Rustik2044/MU-RK3576J-MB/Project/refdoc/Readme.txt

Attention! 
There is an important update this time. Please read RK3576_AIOT_REF_SCH_V11_Modify_Notes_CN carefully.

注意！
本次有重要的更新：请务必详细阅读RK3576_AIOT_REF_SCH_V11_Modify_Notes_CN
