Rustik2044/MU-RK3576J-MB/Project/refdoc/03_Product Line Branch_AIoT/03_Reference Design/02_PCB_Library/RK3576_RK806S-5_Modify_Notes.txt

V11:
The PCB package of RK3576 is modified to BGA698_16R1X17R2X1R08.
The timing of the PLDO2 power supply is changed from 3 to 5.
