Rustik2044/MU-RK3576J-MB/Doc/MU-RK3576J-MB_FULL.pdf

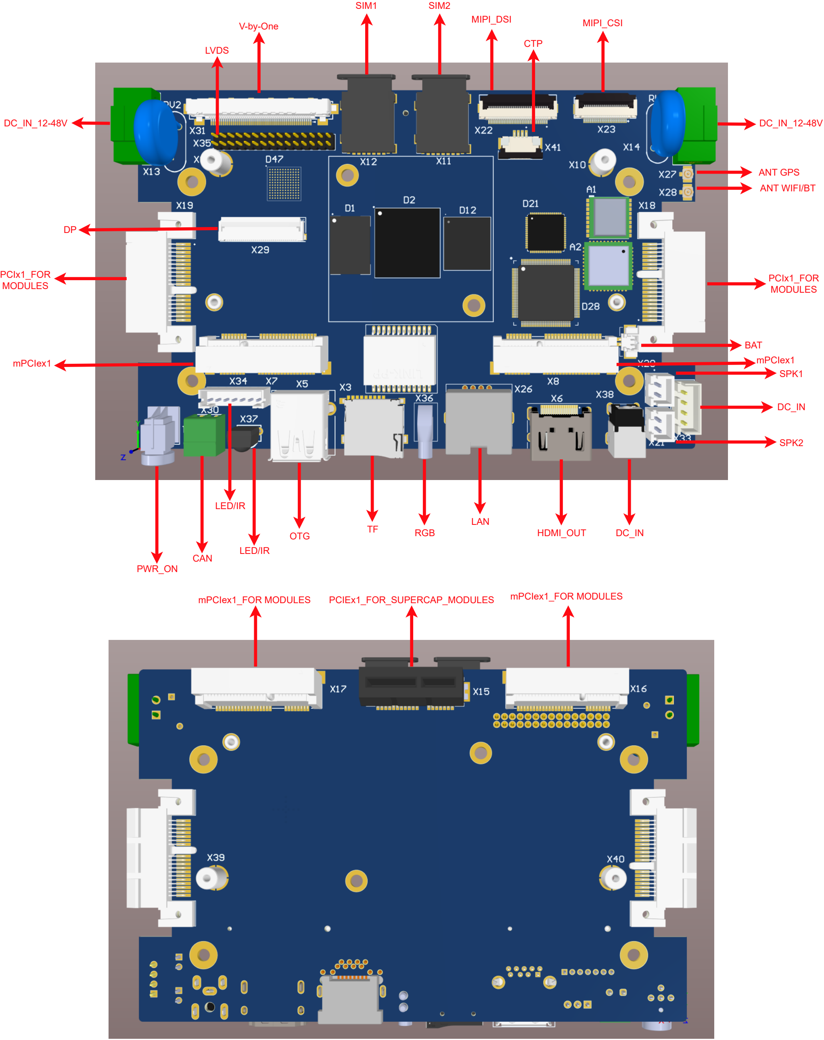
[picture p1: page 1]

V-by-One

LVDS

MIPI_DSI

CTP

ANT WIFI/BT

DC_IN

SPK2

SPK1

HDMI_OUT

LAN
TF
OTG

LED/IR

BAT

SIM1 | SIM2
MIPI_CSI

PCIx1_FOR
MODULES
RGB | DC_IN
LED/IR
CAN
PWR_ON
mPCIex1 | mPCIex1

DP

DC_IN_12-48V | DC_IN_12-48V

ANT GPS

mPCIex1_FOR MODULES | PCIEx1_FOR_SUPERCAP_MODULES | mPCIex1_FOR MODULES

PCIx1_FOR
MODULES
