Rustik2044/MU-RK3576J-MB/Doc/ТЗ на 3576J_08.docx

ТЕХНИЧЕСКОЕ ЗАДАНИЕ 23 сентября 2025

на разработку платы управления ЮРТН.758745.002

# 1. Наименование и область применения

1.1 Наименование изделия

Плата управления ЮРТН.758745.002.

1.2. Область применения

Изделие предназначено для установки в качестве управляющего контроллера для мультимедийных комплексов, применяемых в лифтовой промышленности и цифровых вывесках, в том числе на транспорте.

# 2. Основание для разработки

Основанием для разработки является необходимость создания высокопроизводительной, надежной и промышленно ориентированной системы управления мультимедийным комплексом, соответствующей современным требованиям к лифтовым индикаторам и рекламным медиапроигрывателям. Настоящее ТЗ определяет требования к разработке изделия.

# 3. Назначение разработки

Плата управления должна обеспечивать высокопроизводительное, надежное управление мультимедийным комплексом в условиях лифтового хозяйства, обеспечивая интеграцию с верхнеуровневыми системами передачи данных через промышленные сети, предусмотренные в системах лифтовой индикации.

Изделие должно обеспечивать:

- Управление мультимедийным комплексом.
- Обработку данных с дискретных входов.
- Интеграцию с верхнеуровневыми системами лифтовой индикации через промышленные сети и протоколы.

# 4. Требования к изделию

## 4.1. Требования к функциональным характеристикам

Управление мультимедийным комплексом.

Поддержка промышленных сетевых интерфейсов (CANopen, Modbus).

Поддержка сетевого интерфейса по стандарту Gigabit Ethernet (1000BASE-T).

Управление дискретными входами/выходами (минимум 4 изолированных DI, 4 изолированных DO).

Работа под управлением операционной системы ???.

## 4.2. Требования к надежности

Средняя наработка на отказ должна быть не менее 40 000 часов.

Применяемые электронные компоненты должны быть промышленного температурного диапазона.

Конструкция платы и пайка должны соответствовать требованиям надежности для промышленного оборудования.

## 4.3. Требования к условиям эксплуатации

Климатические условия эксплуатации:

- Исполнение УХЛ4 по ГОСТ 15150-69.
- Температура окружающего воздуха: от -20°С до +60°С (рабочая); от -20°С до +70°С (хранение и транспортирование).
- Относительная влажность воздуха: от 10% до 80% при температуре +25°С (без конденсации влаги).

Условия по механическим воздействиям:

- Вибрационные нагрузки: Группа исполнения L3 по ГОСТ 16962.2-90 (соответствие IEC 60068-2-6).
- Ударные нагрузки: Группа исполнения L3 по ГОСТ 16962.1-89 (соответствие IEC 60068-2-27).

Требования по электромагнитной совместимости (ЭМС):

- По помехоустойчивости: ГОСТ Р 51317.4.Х / ГОСТ Р 51318.14.Х / ГОСТ Р 51318.22 / ГОСТ Р 51318.24.
- По уровню излучаемых помех: ГОСТ Р 51317.3.2 / ГОСТ Р 51317.4.Х / ГОСТ Р 51318.11 / ГОСТ Р 51318.13 / ГОСТ Р 51318.15 / ГОСТ Р 51318.25.
- Устойчивость к электростатическим разрядам (ЭСР): Уровень 4 по ГОСТ Р 51317.4.2.

## 4.4. Требования к безопасности

Конструктивное исполнение должно соответствовать требованиям ГОСТ Р МЭК 60204-1-2007 "Безопасность машин. Электрооборудование машин и механизмов. Часть 1. Общие требования".

Применяемые разъемы и компоненты должны соответствовать требованиям электробезопасности.

## 4.5. Требования к эргономике и технической эстетике

Разъемы на плате должны быть расположены удобно для монтажа и подключения.

Шелкография на плате должна быть четкой и читаемой.

## 4.6. Требования к транспортированию и хранению

Транспортирование должно осуществляться в упаковке, обеспечивающей защиту от механических повреждений, воздействия климатических факторов (температура, влажность) и статического электричества, в соответствии с ГОСТ 23216-78

Условия хранения - температура -20°С до +70°С, влажность до 80% (без конденсации).

## 4.7. Требования к составу изделия

Изделие поставляется в виде некорпусированной печатной платы и комплекта эксплуатационной документации.

## 4.8. Требования к маркировке и упаковке

Каждое изделие должно иметь четкую, стойкую к воздействию среды маркировку, включающую:

- Обозначение изделия
- Заводской номер (серийный номер).
- Знак соответствия (при наличии).
- Знаки электробезопасности (при необходимости).
- Дату изготовления.

Упаковка должна обеспечивать защиту от механических повреждений, влаги, пыли и статического электричества при транспортировании и хранении в соответствии с ГОСТ 23216-78.

## 4.9. Требования к патентной чистоте

Изделие должно быть патентно чистым в Российской Федерации и странах предполагаемого экспорта.

# 5. Требования к аппаратной части

5.1. Требования к плате управления

Управляющий контроллер: SoC RK3576J.

Память:

- Оперативное запоминающее устройство (ОЗУ): Тип LPDDR4 SDRAM. Объем не менее 8 ГБ. Шина 64-бит.
- Постоянное запоминающее устройство для конфигурации и загрузчика: Тип eMMC. Объем не менее 32 ГБ.
- Постоянное запоминающее устройство для ОС и ПО: Тип eMMC. Объем не менее 32 ГБ.
- Слот для карт памяти microSD (для обновления/резервирования).

Интерфейсы, выведенные на внешние разъемы:

- Gigabit Ethernet (интерфейс RGMII) с POE (IEEE 802.3bt) - 1порт.
- USB Type-C версии 3.1 -1 порт.
- USB версии 3.0 -1 порт.
- USB версии 2.0 -1 порт.
- MicroSD интерфейс SDIO.
- Приёмник SIM-карты – 2 разъёма.
- HDMI интерфейс.
- Дискретные входы/выходы (DI/DO): 4 гальванически развязанных дискретных входа (DI) (номинал 24VDC, сухой контакт). 4 гальванически развязанных транзисторных выхода (DO) (номинал 24VDC, ток нагрузки до 0.05А).
- RS-485: 1 порт RS-485.
- RSL: 1 порт OTIS RSL.
- CAN: 1 порт CAN 2.0.
- Звук: Разъём для выхода стерео аудиосигнала, мощность выходного стерео аудиосигнала сигнала 2 х 3 W на нагрузке 4 Ohm при THD 1%.
- ИК – порт, продублированный разъёмом.
- Кнопка включения.

Интерфейсы, выведенные на внутренние разъемы:

- USB версии 2.0 -1 порт.
- 2 разъёма MIPI CSI.
- Последовательный интерфейс UART (TTL уровни) – 1 порт.
- Интерфейс SPI (Master) – 1 порт.
- Интерфейс I2C – 1 порт.
- Интерфейс eDP.
- 2 разъёма Mini PCIe для подключения GSM модема либо SSD.
- Разъём для подключения 4 тактовых кнопок.
- Линии общего назначения GPIO (LVCMOS3V3 уровни) - не менее 8 линий.
- Отладка: Разъем UART для доступа к микроконтроллеру.
- Питание вентилятора системы охлаждения 12 В.

Беспроводные сети:

- Wi-Fi 6 (2.4GHz+5GHz dual-band) с разъёмом U.FL.
- Bluetooth 5.0 с разъёмом U.FL.

Система электропитания:

- Входное напряжение: 24 VDC (номинал), рабочий диапазон 16 VDC - 34 VDC.
- Входное напряжение: 12 VDC (номинал), рабочий диапазон 10 VDC - 16 VDC.
- Выходной разъём POE от сетевого трансформатора.
- Слот либо разъём для подключения батарейки часов реального времени.

Дополнительно:

- Предусмотреть возможность установки ПАК ViPNet SIES Core Nano.

## 5.2. Требования к функциональным узлам платы управления

5.2.1 Требования к часам реального времени

RTC должны быть реализованы на плате управления средствами отдельной микросхемы, которая должна быть снабжена генератором и запитана от батарейного питания.

Батарея RTC должна быть съемная, и ее ресурс должен быть рассчитан для поддержания нормального хода часов без внешнего питания не менее 5 лет. Должна быть обеспечена возможность замены батареи без полной разборки платформы и демонтажа внешних модулей.

5.2.2 Требования к модулю навигации

В состав платы управления должен входить модуль навигации.

Модуль навигации должен поддерживать работу с системой ГЛОНАСС и обмениваться данными по интерфейсу UART с процессором.

Модуль навигации должен выдавать сигнал 1PPS в процессор для синхронизации часов реального времени.

5.2.3 Требования к слотам расширения mPCIe для модулей расширения

На лицевой стороне платы управления должны располагаться два слота mPCIe, обеспечивающие возможность установки модулей расширения (беспроводной связи) GSM/LTE. При применении одного модуля в слоте № 1 должна быть обеспечена возможность мультиплексирования на него SIM1 и SIM2, а при применении двух модулей SIM1 должна подключаться к слоту № 1, а SIM2 – к слоту № 2.

## 5.3. Требования к конструктивному исполнению и монтажу

Применять только промышленные разъемы серии 15EDGRC (Degson Electronics - для питания, DI/DO и промышленных интерфейсов.

От разъёма питания на печатной плате реализовать DC/DC конвертор с 24 В на 12 В с возможностью шунтирования. На выходе конвертора установить вертикальный разъём DS1069-4MVW6X (CWF-4) на 2 контакта которого вывести 12 В на оставшиеся 0(землю).

Для выходного разъёма POE применить DS1069-4MVW6X (CWF-4).

Расположить разъёмы DS1069-4MVW6X (CWF-4) с 12В и POE таким образом, чтобы между ними можно было установить плату с конвертером POE to 12V.

Технология пайки: соответствующая требованиям для промышленной электроники.

Система охлаждения: Активная (радиатор + вентилятор с напряжением питания 12В) либо пассивная (с радиатором).

Маркировка элементов: Четкая шелкография, позиционные обозначения компонентов согласно схеме.

# 6. Требования к программному обеспечению

## 6.1. Операционная система

ROS 2 Humble или Iron (LTS) как основная среда исполнения.

Цикл управления осями должен выполняться с гарантированным периодом менее 1 мс (целевое значение - 250-500 мкс).

## 6.2. Состав программного обеспечения

Драйверы программируемой логики (PL): Реализация EtherCAT Slave Controller (ESC), драйверов интерфейсов энкодеров, ЦАП/АЦП, обработки данных с датчиков в реальном времени.

Драйверы для ROS 2: Драйверы для всех интерфейсов материнской платы (EtherCAT Master - например, `soem`/`ethercat_igh`, CANopen, Modbus, аналоговых/цифровых вводов-выводов).

Подсистема управления движением: Интеграция ROS 2 с промышленными средствами управления движением (например, MoveIt 2 для планирования траекторий, фреймворки ros2_control, hardware_interface, controller_manager для управления приводами). Поддержка протоколов CiA 402 (CANopen) и CoE (EtherCAT).

Подсистема связи: Поддержка DDS (FastDDS/CycloneDDS), механизмов ROS 2 (topics, services, actions). Интеграция с промышленными протоколами (OPC UA сервер/клиент).

Системное ПО: Загрузчик U-Boot, Ядро Linux (с патчем Preempt-RT), Средства построения корневой файловой системы (Buildroot/Yocto). Система инициализации (systemd).

## 6.4. Требования к безопасности ПО

Защита от несанкционированного доступа (аутентификация по ключам SSH, межсетевой экран).

Шифрование обновлений ПО.

Применение средств SROS2 (Security Enhancements for ROS 2) при необходимости.

6.5. Механизм обновления ПО

Предусмотреть механизм безопасного обновления операционной системы, пакетов ROS 2 и конфигурации FPGA по сети Ethernet или с внешних носителей (USB/SD). Обеспечить возможность отката на предыдущую работоспособную версию.

# 7. Требования к информационному обеспечению (документации)

## 7.1. Комплект конструкторской документации (КД) на изделие

Спецификация (ГОСТ 2.106-96).

Сборочный чертеж плат (при необходимости).

Схема электрическая принципиальная (Э3, ГОСТ 2.702-2011), в форматах PDF и исходных файлах САПР, например OrCAD/Altium/KiCad.

Перечень элементов (ПЭ3, ГОСТ 2.701-2008) с указанием производителей, номенклатурных номеров, номиналов.

Спецификация разъемов и назначение контактов.

Описание и инструкция по монтажу и подключению.

Руководство по техническому обслуживанию и поиску неисправностей.

Комплект файлов для производства (Gerber, NC Drill, Pick&Place).

## 7.2. Комплект программной документации

Описание программы и программных модулей.

Руководство системного программиста (установка и настройка ОС, ROS 2, драйверов).

Руководство программиста (API для взаимодействия с платой из ROS 2).

Руководство по настройке промышленных сетей (EtherCAT, CANopen и др.).

Описание кода программируемой логики (HDL код, блок-схемы, timing constraints).

Руководство по обновлению ПО/FPGA.

Техническое описание примеров ROS 2 пакетов для базового управления.

## 7.3. Комплект эксплуатационной документации (ЭД)

Руководство по эксплуатации (РЭ, ГОСТ 2.601-2019).

Паспорт (ПС, ГОСТ 2.601-2019).

## 7.4. Отчеты по испытаниям

Протоколы испытаний цепей питания, интерфейсов, развязки, безопасности (STO).

Протоколы климатических испытаний (температура, влажность).

Протоколы испытаний на вибро- и удароустойчивость.

Протоколы испытаний на ЭМС.

Протоколы тестирования ПО (функциональности, производительности, надежности).

# 8. Технико-экономические требования

Разработка должна обеспечить достижение показателей надежности и функциональности, указанных в настоящем ТЗ.

Стоимость производства изделия должна быть оптимизирована для серийного выпуска при соблюдении всех технических требований.

Применяемые компоненты должны иметь долгосрочную доступность (Long-Term Availability - LTA) или заменяемые аналоги.

# 9. Стадии и этапы разработки

Разработка должна включать следующие стадии и этапы:

- Техническое предложение: Анализ требований, выбор элементной базы, разработка и согласование архитектуры.
- Эскизный проект: Разработка принципиальных электрических схем, тепловые расчеты, выбор корпусов и разъемов, оценка стоимости.
- Технический проект: Разводка печатных плат, разработка конструкторской документации (КД), изготовление опытных образцов (прототипов).
- Рабочая документация: Разработка базового ПО (загрузчик, ОС, драйверы, ROS 2 базис).
- Изготовление, испытание и доводка опытных образцов: Аппаратное тестирование прототипов, отладка, комплексное тестирование аппаратно-программного комплекса.
- Приемочные испытания: Климатические и ЭМС испытания опытных образцов, доработка по результатам испытаний, выпуск предсерийных образцов.
- Подготовка производства: Разработка финальной КД, ПД и ЭД. Подготовка к серийному производству.

# 10. Порядок контроля и приемки

Контроль выполнения работ на всех этапах разработки осуществляет генеральный директор или уполномоченное им лицо.

Приемка разработки осуществляется комиссией, назначаемой Заказчиком, на основании:

- Успешного прохождения всех видов испытаний (аппаратных, программных, климатических, ЭМС) по протоколам, соответствующим требованиям настоящего ТЗ.
- Соответствия разработанной конструкторской, программной и эксплуатационной документации требованиям настоящего ТЗ и стандартам, указанным в нем.
- Демонстрации работоспособности платы управления в составе мультимедийного комплекса (или на стенде с эквивалентной нагрузкой) с выполнением типовых задач через интерфейсы.
- Предоставления полного комплекта оговоренных артефактов (предсерийные образцы плат, исходные коды ПО, документация в электронном и бумажном виде).

Результаты приемки оформляются Актом приемки.

Настоящее Техническое задание является документом, определяющим основные требования к разработке. Детализация требований и возможные уточнения производятся на стадиях технического предложения и эскизного проекта.
