Rustik2044/MU-RK3576J-MB/Doc/ТЗ_Модуля_MU-RK3576J-MB.docx

УТВЕРЖДАЮ

Генеральный директор

ООО «МЮ»

_______________А.А. Ларин

«____»_______________ 20__ г.

ТЕХНИЧЕСКОЕ ЗАДАНИЕ

на разработку модуля процессорного MU-RK3576J-MB

ЮРТН.466256.002

СОГЛАСОВАНО

Директор центра исследований и разработки

ООО «МЮ»

_______________X.X. XX

«____» _______________ 20__ г.

Содержание

## Сокращения

В настоящем техническом задании применены следующие сокращения:

ЕСКД (https://docs.cntd.ru/document/1200000470) | – | единая система конструкторской документации
КД | – | конструкторские документы (документация)
КИМП | – | комплектующие изделия межотраслевого применения
ГЛОНАСС | – | глобальная навигационная спутниковая система
GPS | – | Global Positioning System (система глобального позиционирования).
LTE | – | Long-Term Evolution (стандарт беспроводной высокоскоростной передачи данных для мобильных телефонов и других терминалов, работающих с данными)
ОС | – | операционная система
ПО | – | программное обеспечение
РКД | – | рабочая конструкторская документация
ТД | – | технологическая документация
ТЗ | – | техническое задание
ЭД | – | эксплуатационная документация
ЭРИ | – | электрорадиоизделие
DDR4 | – | double-data-rate four (четвертое поколение оперативной памяти (https://ru.wikipedia.org/wiki/%D0%9E%D0%BF%D0%B5%D1%80%D0%B0%D1%82%D0%B8%D0%B2%D0%BD%D0%B0%D1%8F_%D0%BF%D0%B0%D0%BC%D1%8F%D1%82%D1%8C), отличается повышенными частотными характеристиками и пониженным напряжением питания)
DIO | – | дискретный вход/выход
MIPI-DSI | – | Mobile Industry Processor Interface Display Serial Interface (высокоскоростной интерфейс дисплея)
eMMC | – | Embedded Multimedia Memory Card (встроенная мультимедийная карта памяти)
ECC | – | Error-correcting code memory (память с коррекцией ошибок)
mPCIe | – | формат шины PCI Express для портативных устройств
OD | – | open-drain (открытый сток)
RGB | – | Red-green-blue (аддитивная цветовая модель, описывающая способ кодирования цвета для цветовоспроизведения с помощью трех цветов)
RJ-45 | – | Registered Jack 45 (разъем для Ethernet-кабелей, обеспечивающих передачу данных между компьютерами и другими устройствами в локальных сетях)
RTC | – | Real Time Clock (часы реального времени)
SD | – | Secure Digital (формат карт памяти для портативных устройств)
USB | – | Universal Serial Bus (последовательный интерфейс (https://ru.wikipedia.org/wiki/%D0%98%D0%BD%D1%82%D0%B5%D1%80%D1%84%D0%B5%D0%B9%D1%81) для подключения периферийных устройств к вычислительной технике (https://ru.wikipedia.org/wiki/%D0%AD%D0%92%D0%9C))
WDT | – | сторожевой таймер (watchdog timer) – аппаратный механизм защиты от зависания программы.

# 1 Наименование, основание, исполнитель и сроки выполнения разработки

## 1.1 Наименование: «Модуль процессорный MU-RK3576J-MB ЮРТН.466256.002»

## 1.2 Основание выполнения: приказ № ?? от XX.XX.XXXX г.

## 1.3 Организация-исполнитель: ООО «МЮ».

## 1.4 Сроки выполнения: с XX.XX.XXXX по XX.XX.XXXX г.

# 2 Цель выполнения разработки, наименование и обозначение изделия

2.1 Целью выполнения изделия является разработка конструкторской документации и изготовление макетных и опытных образцов модуля процессорного на базе восьмиядерного ARM процессора RK3576J с расширенным набором сетевых интерфейсов, включая один RS-485, восемь каналов дискретных входов/выходов и CAN в промышленном исполнении.

## 2.2 Наименования изделия: «Модуль процессорный MU-RK3576J-MB ЮРТН.466256.002».

## 2.3 Задачи выполнения

2.3.1 При разработке платформы необходимо выполнить следующие задачи:

- разработка РКД в объеме, достаточном для изготовления макетных образцов;
- изготовление макетных образцов, проведение лабораторных испытаний;
- корректировка РКД по результатам испытаний, разработка комплекта ТД и ЭД в объеме, требуемом для подачи заявки на включение в РЭП ОП по 719 ПП РФ;
- изготовление опытных образцов и проведение предварительных испытаний;
- корректировка КД и ЭД по результатам испытаний (при необходимости) и присвоение литеры О;
- разработка стендов технического контроля по отдельному частному ТЗ;
- изготовление опытной партии по комплекту КД и ЭД Литеры О и проведение приемочных испытаний с присвоением литеры О1;
- передача опытных образцов на сертификационные испытания (ТР ТС 020) и включение в РЭП ОП по 719 ПП РФ;
- участие в постановке на серийное производство.

## 2.4 Назначение и область применения изделия

2.4.1 Модуль процессорный MU-RK3576J-MB (далее – модуль) предназначен для использования в критической информационной инфраструктуре (лифтовой промышленности и т.п) в роли управляющего контроллера мультимедийным комплексом.

# 3 Технические требования к изделию

## 3.1 Состав изделия

3.1.1 В состав модуля должны входить:

- Модуль процессорный MU-RK3576J-MB ЮРТН.466256.002;
- встроенное ПО;
- комплект эксплуатационной документации;

## 3.2 Требования назначения

3.2.1 Модуль должен обеспечивать возможность:

- передачи видеосигнала через интерфейс eDP;

- обмена данными по интерфейсу USB 3.0;

- обмена данными по интерфейсу USB 2.0;

- обмена данными по интерфейсу CAN 2.0;

- обмена данными с помощью сетевого интерфейса 10/100/1000 Base-TX Ethernet (GbE);

- обмена данными с помощью модулей расширения LTE (не входящих в состав платформы);

- учета хронометрических данных при отсутствии внешнего питания с помощью часов реального времени (RTC);

- обмена данными по интерфейсу RS-485;

- ввода и регистрации дискретных сигналов;

- выдачи команд телеуправления.

3.2.2 Модуль должен обеспечивать технические характеристики, приведенные в таблице 1.

Таблица 1 – Технические характеристики модуля

Наименование параметра | Значение параметра
Процессор | RockChip RK3576J 4 х Cortex-A72 2.2 ГГц 4 х Cortex-A53 1.8 ГГц
Микроконтроллер | GD32F330CBT6
BMC (контроллер управления материнской платы) | НИИЭТ К1921ВГ015
Оперативная память | 1 ×LPDDR4 non-ECC – от 4 до 8 ГБ
Встроенный накопитель данных | eMMC Flash – от 32 до 512 ГБ
Слот для внешнего накопителя данных | Для внутренней SD-карты – от 1 до 256 ГБ
Сетевые интерфейсы | 1 × GbE 1000BASE-T PoE+ (RJ-45)
Интерфейсы USB | 1 × USB 3.0 Type-A (OTG)
| 1 × USB 2.0 Type-A (внутренний)
Видеоинтерфейс | HDMI 2.1 (4096 × 2304@60 Гц)
| MIPI-DSI 1x 4 lane или V-by-One HS (1920 × 1080@60Hz) (FFC/FPC -кастомизируемый pinout)
| MIPI-CSI 1x 4 lane
Консольный порт | USB Type-C (virtual COM), опционально GbE (SSH)
Слоты расширения | 1 × mPCIe разъем – USB 2.0, SIM1 или SIM2, PCIе x 1 (Слот 1)
| 1 × mPCIe разъем – USB 2.0, SIM2, PCIе x 1 (Слот 2)
Слоты для SIM-карт | 2
Внутренние интерфейсы | 1 × I2C, 1 × SPI, 1 × UART, 1 × USB 2.0
Модуль навигации | Приемник ГЛОНАСС напаянный на модуль
Подключение антенн | LTE, GNSS, кабельная сборка UFL-F/SMA-F) внешние антенны
Wi-Fi | 2.4G+5G
Интерфейс CAN | 1 × CAN 2.0 (FD)
Кнопка | Аппаратного сброса
RTC Питание: погрешность хода RTC в сутки (при питании часов от внутренней батареи), с, не более | Батарея 3 В CR2032 210 мА·ч ± 1
WDT | с программным управлением
Последовательные интерфейсы («поле») | 1 × RS-485 с индивидуальной гальванической изоляцией (0,6 кВ), скорость передачи данных – до 1 Мбит/с
Дискретные входы/выходы | 8 × DIO (программно-конфигурируемых с групповой гальванической изоляцией (0,6 кВ)) Выходы типа OD, Uвых. до 30 В, Iвых. до 500 мА; Входы типа «сухой контакт», Uвх. (15 – 30) В, Iвх. (5 – 10) мА
Индикация | 2 LED – RS485 (аппаратные); 8 LED – DIO (аппаратные); Status (трехцветный управляемый из ОС)
Электропитание | Тип разъемов питания: клеммный Резервирование: питание от любого из двух разъемов Напряжение питания – от плюс 10 В до плюс 48 В
| Встроенный модуль защиты от перебоев питания (Опционально) Тип: Ионисторный

## 3.3 Требования к часам реального времени

## 3.3.1 RTC должны быть реализованы на модуле средствами отдельной микросхемы, которая должна быть снабжена генератором и запитана от батарейного питания.

#### 3.3.2 Батарея RTC должна быть съемная, и ее ресурс должен быть рассчитан для поддержания нормального хода часов без внешнего питания не менее 5 лет. Должна быть обеспечена возможность замены батареи без полной разборки платформы и демонтажа внешних модулей.

## 3.4 Требования к модулю навигации

#### 3.4.1 В состав модуля должен входить модуль навигации.

#### 3.4.2 Модуль навигации должен поддерживать работу с системой ГЛОНАСС и обмениваться данными по интерфейсу UART с процессором.

#### 3.4.3 Модуль навигации должен выдавать сигнал 1PPS в процессор для синхронизации часов реального времени.

## 3.5 Требования к слотам расширения mPCIe для модулей расширения

3.5.1 На лицевой стороне модуля должны располагаться два слота mPCIe, обеспечивающие возможность установки модулей расширения (беспроводной связи) GSM/LTE. При применении одного модуля в слоте № 1 должна быть обеспечена возможность мультиплексирования на него SIM1 и SIM2, а при применении двух модулей SIM1 должна подключаться к слоту № 1, а SIM2 – к слоту № 2.

## 3.6 Требования к аппаратному обеспечению модуля управления

## 3.6.1 модуль должен содержать:

## - один гальванически изолированный канал интерфейса RS-485 со скоростью приема-передачи данных до 1 Мбит/с;

## 3.6.2 Интерфейс RS-485 должны быть гальванически изолирован от других элементов. Напряжение изоляции должно быть не менее 600 В.

## 3.6.3 Интерфейсы RS-485 должны быть организованы с использованием микросхемы (микросхем) USB-UART.

## - микроконтроллер для обмена данными с процессором и управления блоком дискретных входов/выходов.

## - один сетевой интерфейс Ethernet со скоростью приема-передачи данных до 1 Гбит/с;

## - гальванически изолированный блок дискретных входов/выходов.

## 3.6.4 К микроконтроллеру должна быть подключена одна внешняя энергонезависимая память EEPROM. Связь между микроконтроллером и EEPROM должна осуществляться по интерфейсу I2C.

## 3.7 Требования к программному обеспечению микроконтроллера

3.7.1 Программное обеспечение (ПО) должно обеспечивать запись текущей конфигурации DIO по команде от процессора, а также считывание и применение режима работы каждого DIO согласно сохраненной в памяти конфигурации при перезагрузке устройства. ПО должно позволять сохранять в памяти EEPROM значения уставок для каждого DIO.

3.7.2 Связь с процессором должна осуществляется через последовательный интерфейс I2C, с помощью которого ПО в режиме ведомого должно обеспечивать прием команд, считывание данных от DIO и синхронизацию внутренних часов микроконтроллера. Должна быть предусмотрена линия прерывания от микроконтроллера, через которую ПО сигнализирует процессору о событии превышения значения уставки.

## 3.7.3ПО должно обеспечивать хранение серийного номера и даты изготовления модуля.

## 3.8 Требования к кнопке сброса

## 3.8.1 В случае программного или аппаратного сбоя модуля, если внешний сторожевой таймер (WDT) не сработал, однократное нажатие кнопки сброса должно приводить к перезагрузке системы.

## 3.9 Требования к сторожевому таймеру

## 3.9.1 WDT должен располагаться на модуле в виде отдельной микросхемы.

## 3.9.2 WDT должен иметь возможность программного включения и отключения со стороны процессора.

## 3.9.3 В случае программного сбоя модуля WDT должен инициализировать перезагрузку системы в течение не более трех секунд.

## 3.10 Требования к индикации

## 3.10.1 Вся индикация должна располагаться на лицевой панели.

## 310.2 Модуль должен быть оснащена программно-управляемым светодиодным индикатором типа RGB.

## 3.10.3 Для отображения состояния сетевых интерфейсов светодиодные индикаторы должны быть встроены в разъемы RJ-45.

## 3.10.4 Для отображения состояния интерфейса RS-485 должны быть применены одноцветные светодиодные индикаторы, вынесенные за пределы гальванической изоляции.

## 3.10.5 Для отображения состояния DIO должны быть применены одноцветные светодиодные индикаторы, встроенные в клеммные разъемы.

## 3.11 Требования электромагнитной совместимости

    3.11.1 Модуль не должен создавать недопустимых помех и должна требовать защиты от помех со стороны радиоэлектронных средств, указанных в ТР ТС 020/2011.
    3.11.2 Модуль должен обеспечить устойчивость к разрядам статического электричества по ГОСТ 30804.4.2-2013.
    3.11.3 По помехоустойчивости: ГОСТ Р 51317.4.Х / ГОСТ Р 51318.14.Х / ГОСТ Р 51318.22 / ГОСТ Р 51318.24.
    3.11.4 По уровню излучаемых помех: ГОСТ Р 51317.3.2 / ГОСТ Р 51317.4.Х / ГОСТ Р 51318.11 / ГОСТ Р 51318.13 / ГОСТ Р 51318.15 / ГОСТ Р 51318.25.
    3.11.5 Устойчивость к электростатическим разрядам (ЭСР): Уровень 4 по ГОСТ Р 51317.4.2.

## 3.12 Требования к параметрам электропитания

## 3.12.1 Рабочий диапазон напряжений постоянного тока должен быть от плюс 10 до плюс 30 В.

## 3.12.2 Модуль должен быть обеспечена резервным клеммным входом питания.

## 3.12.3 Модуль должен быть защищен от переполюсовки входного напряжения.

## 3.12.4 Потребляемая модулем мощность должна быть не более 10 Вт без учета внешних потребителей USB.

## 3.13 Требования живучести и стойкости к внешним воздействующим факторам

    3.13.1 Модуль должен сохранять работоспособность при воздействии следующих климатических условий:
- рабочие значения температуры – от минус 20 до плюс 60 °С, при загруженности процессора не более 50 %;
- относительная влажность воздуха от 10 % до 80 % при температуре плюс 25 °С, без конденсации влаги.
- Исполнение УХЛ4 по ГОСТ 15150-69
    3.13.2 Требования к механическим воздействиям:

- Вибрационные нагрузки: Группа исполнения L3 по ГОСТ 16962.2-90 (соответствие IEC 60068-2-6).

- Ударные нагрузки: Группа исполнения L3 по ГОСТ 16962.1-89 (соответствие IEC 60068-2-27).

## 3.14 Требования надежности

    3.14.1 Срок службы модуля должен быть не менее 5 лет.

3.14.2 Среднее время наработки на отказ должно быть не менее 40000 ч.

3.14.3 Конструкция плат и пайка должны соответствовать требованиям надежности для промышленного оборудования.

3.14.4 Применяемые электронные компоненты должны быть промышленного температурного диапазона.

## 3.15 Требования к эксплуатации, хранению, удобству технического обслуживания и ремонта

## 3.15.1 Модуль в упакованном виде должна быть устойчива к хранению в течение двух лет (с момента отгрузки, включая срок транспортирования) в складских неотапливаемых помещениях при воздействии следующих климатических условий:

- предельные значения температуры – от минус 20 до плюс 70 °С;
- относительная влажность воздуха от 10 %до 80 % при температуре плюс 25 °С, без конденсации влаги.

Примечание – Для обеспечения надежной и эффективной работы модуля после хранения или транспортирования при пониженной температуре требуется предварительное выдерживание при положительной температуре до достижения значений, соответствующих условиям эксплуатации.

## 3.16 Транспортирование

## 3.16.1 Модуль должен сохранять работоспособность после транспортирования в упакованном виде автомобильным транспортом (закрытый брезентом), в закрытых железнодорожных вагонах, герметизированных кабинах самолетов и вертолетов, трюмах речного транспорта при воздействии следующих климатических условий:

- температура от минус 20 до плюс 70 °С;
- относительная влажность воздуха от 10% до 80 % при температуре плюс 25 °С.

## 3.17 Требования безопасности

## 3.17.1 Безопасность при эксплуатации модуля должна обеспечиваться ее конструкцией.

## 3.17.2 Модуль должен быть обеспечен клеммой заземления.

## 3.17.3 Величина переходного электрического сопротивления между клеммой защитного заземления и любой металлической нетоковедущей частью устройства, доступной для прикосновения, не должна превышать 0,1 Ом.

## 3.17.4 Комплектующие и материалы, используемые при изготовлении, не должны представлять опасности для жизни, здоровья людей и окружающей среды, как в процессе эксплуатации, так и после окончания срока эксплуатации.

## 3.17.5 Требования к пожаробезопасности не предъявляются.

## 3.17.6 Конструктивное исполнение должно соответствовать требованиям ГОСТ Р МЭК 60204-1-2007 "Безопасность машин. Электрооборудование машин и механизмов. Часть 1. Общие требования".

## 3.17.7 Применяемые разъемы и компоненты должны соответствовать требованиям электробезопасности.

## 3.17 Требования технологичности

## 3.18.1 Требования по технологичности в соответствии с ГОСТ 14.201-83.

## 3.18 Конструктивные требования

    3.19.1 Охлаждение – пассивное (кондуктивное, без вентилятора).

3.19.2 Габаритные размеры модуля (Ш × Г × В) должны быть не более
(?? × ?? × ??) мм.

# 4 Требования к видам обеспечения

## 4.1 Требования к метрологическому обеспечению

## 4.1.1 Модуль не является средством измерения, точность проверяется расчетом и подтверждается внутренними лабораторными испытаниями

## 4.1.2 Все средства измерения должны быть поверены или калиброваны, испытательное оборудование аттестовано в установленном порядке.

## 4.1.3 Методики измерений должны обеспечивать точность и достоверность результатов измерений (испытаний).

## 4.1.4 В методиках измерений используются методики прямых измерений. Все методики измерений, не являющиеся методиками прямых измерений, а также референтные методики измерений должны быть аттестованы.

## 4.2 Требования к программному обеспечению

    4.2.1 Встроенное ПО должно состоять из загрузчика ОС (Uboot, UEFI by Uboot), обеспечивающего возможность последующей установки операционных систем Debian, BaseAlt, Astra Linux, а также встроенное ПО микроконтроллера блока дискретного ввода/вывода.
    4.2.2 Допускается снижение частоты процессора в соответствии с указанными диапазонами температуры ядер процессора:

- до плюс 85 °С, частота 2,0 ГГц;

- от плюс 85 до плюс 90 °С, частота 1,4 ГГц;

- от плюс 90 до плюс 95 °С, частота 0,8 ГГц;

- от плюс 95 до плюс 100 °С, частота 0,4 ГГц.

4.2.3 ROS 2 Humble или Iron (LTS) как основная среда исполнения.

Цикл управления осями должен выполняться с гарантированным периодом менее 1 мс (целевое значение - 250-500 мкс).

## 4.3 Состав программного обеспечения

4.3.1 Драйверы программируемой логики (PL): Реализация EtherCAT Slave Controller (ESC), драйверов интерфейсов энкодеров, ЦАП/АЦП, обработки данных с датчиков в реальном времени.

4.3.2 Драйверы для ROS 2: Драйверы для всех интерфейсов модуля (EtherCAT Master - например, `soem`/`ethercat_igh`, CANopen, Modbus, аналоговых/цифровых вводов-выводов).

4.3.3 Подсистема управления движением: Интеграция ROS 2 с промышленными средствами управления движением (например, MoveIt 2 для планирования траекторий, фреймворки ros2_control, hardware_interface, controller_manager для управления приводами). Поддержка протоколов CiA 402 (CANopen) и CoE (EtherCAT).

4.3.4 Подсистема связи: Поддержка DDS (FastDDS/CycloneDDS), механизмов ROS 2 (topics, services, actions). Интеграция с промышленными протоколами (OPC UA сервер/клиент).

4.3.5 Системное ПО: Загрузчик U-Boot, Ядро Linux (с патчем Preempt-RT), Средства построения корневой файловой системы (Buildroot/Yocto). Система инициализации (systemd).

## 4.4 Требования к безопасности ПО

4.4.1 Защита от несанкционированного доступа (аутентификация по ключам SSH, межсетевой экран).

4.4.2 Шифрование обновлений ПО.

4.4.3 Применение средств SROS2 (Security Enhancements for ROS 2) при необходимости.

## 4.5 Механизм обновления ПО

    4.5.1 Предусмотреть механизм безопасного обновления операционной системы, пакетов ROS 2 и конфигурации FPGA по сети Ethernet или с внешних носителей (USB/SD). Обеспечить возможность отката на предыдущую работоспособную версию.

# 5 Требования к сырью, материалам и КИМП

## 5.1 Покупные ЭРИ и материалы, применяемые при изготовлении платформы, должны соответствовать требованиям стандартов и пройти входной контроль ОТК.

# 6 Требования к консервации, упаковке и маркировке

## 5.2 Требования к консервации

## 6.1.1 Изделие консервации не подлежит.

## 5.3 Требования к упаковке

    5.3.1 Упаковка модуля должна обеспечивать сохранность оборудования при транспортировке всеми видами транспорта и предохранять от внешних воздействующих факторов при их транспортировании и хранении. Упаковка должна соответствовать требованиям ГОСТ 23216-78.

## 5.4 Требования к маркировке

## 6.3.1 Модуль должен иметь маркировку согласно требованиям ГОСТ 26828-86.

6.3.2 Маркировка должна быть устойчивой в течение срока службы и хранения платформы, механически прочной, не должна стираться, осыпаться, расплавляться и выцветать.

6.3.3 Маркировка упаковки должна содержать наименование и (или) товарный знак организации-изготовителя, наименование и обозначение платформы.

    6.3.4 Маркировка на упаковке должна соответствовать ГОСТ 14192-96.

6.3.5 Каждое изделие должно иметь четкую, стойкую к воздействию среды маркировку, включающую:

- Обозначение изделия;

- Заводской номер (серийный номер);

- Знак соответствия (при наличии);

- Знаки электробезопасности (при необходимости);

- Дату изготовления.

# 7 Требования к документации

## 7.1 Конструкторская, эксплуатационная, программная и технологическая документация, разрабатываемая на платформу, должна соответствовать стандартам системы ЕСКД, ЕСПД, ЕСТД.

## 7.2 Комплект программной документации должен включать в себя:

## - Описание программы и программных модулей;

## - Руководство системного программиста (установка и настройка ОС, ROS 2, драйверов);

## - Руководство программиста (API для взаимодействия с платой из ROS 2);

## - Руководство по настройке промышленных сетей (EtherCAT, CANopen и др.);

## - Описание кода программируемой логики (HDL код, блок-схемы, timing constraints);

## - Руководство по обновлению ПО/FPGA;

## - Техническое описание примеров ROS 2 пакетов для базового управления.

## 7.3 Отчеты по испытаниям:

## - Протоколы испытаний цепей питания, интерфейсов, развязки, безопасности (STO);

## - Протоколы климатических испытаний (температура, влажность);

## - Протоколы испытаний на вибро- и удароустойчивость;

## - Протоколы испытаний на ЭМС;

## - Протоколы тестирования ПО (функциональности, производительности, надежности).

# 8 Технико-экономические требования

## 8.1 Разработка должна обеспечить достижение показателей надежности и функциональности, указанных в настоящем ТЗ.

8.2 Стоимость производства изделия должна быть оптимизирована для серийного выпуска при соблюдении всех технических требований.

8.3 Применяемые компоненты должны иметь долгосрочную доступность (Long-Term Availability - LTA) или заменяемые аналоги.

# 9 Этапы выполнения изделия

## 9.1 Этап 1:

## Техническое предложение:

## - Анализ требований;

## - выбор элементной базы;

## - разработка и согласование архитектуры.

## 9.2 Этап 2:

## разработка РКД в объеме, необходимом для изготовления макетных образцов;

## изготовление макетных образцов и проведение лабораторных испытаний.

## 9.3 Этап 3:

## корректировка РКД и разработка ЭД, ТД;

## - изготовление опытных образцов;

## проведение предварительных испытаний,

## корректировка КД и ЭД по результатам испытаний (при необходимости) с присвоением литеры О.

## 9.4 Этап 4:

- разработка стендов технического контроля по отдельному частному ТЗ;
- изготовление опытной партии по комплекту КД и ЭД Литеры О;

## проведение приемочных испытаний с присвоением литеры О1.

## 9.5 Этап 5:

## сертификационные испытания;

## постановка на серийное производство продукции.

# 10 Порядок выполнения и приемки этапов разработки

## 10.1 Требования настоящего ТЗ могут изменяться (дополняться).

## 10.2 Контроль выполнения работ на всех этапах разработки осуществляет Заказчик или уполномоченное им лицо.

## 10.3 Этапы принимаются комиссией, назначенной руководителем организацией-изготовителем на основании:

## - Успешного прохождения всех видов испытаний (аппаратных, программных, климатических, ЭМС) по протоколам, соответствующим требованиям настоящего ТЗ;

## - Соответствия разработанной конструкторской, программной и эксплуатационной документации требованиям настоящего ТЗ и стандартам, указанным в нем;

## - Демонстрации работоспособности платы управления в составе мультимедийного комплекса (или на стенде с эквивалентной нагрузкой) с выполнением типовых задач через интерфейсы;

- Предоставления полного комплекта оговоренных артефактов (предсерийные образцы плат, исходные коды ПО, документация в электронном и бумажном виде).

10.4 Результаты приемки оформляются Актом приемки.

## 10.5 Настоящее Техническое задание является документом, определяющим основные требования к разработке. Детализация требований и возможные уточнения производятся на стадиях технического предложения и эскизного проекта.

Руководитель конструкторского отдела

_______________ X.X. XXX

Ответственный разработчик

_______________X.X. XXX

Руководитель отдела разработки программного обеспечения

_____________ X.X. XXX
