Rustik2044/MU-RK3576J-MB/For_production_MU-3576-MB/MU-RK3576J-MB_FULL/BOM_MU-RK3576J-MB_FULL.xlsx

Designator | Part Number | Quantity | NameFromManufacturer | Manufacturer
A1 | TAU1113 | 1 | TAU1113 | Allystar
A2 | 8223A-SR | 1 | 8223A-SR | FN-LINK
BQ1 | TC32S4-24.000-0618NQDTN | 1 | TC32S4-24.000-0618NQDTN | HCI
BQ4 | TAXM12M4RDBCCT2T | 1 | TAXM12M4RDBCCT2T | TAE
BQ5 | X322516MLB4SI | 1 | X322516MLB4SI | YXC
BQ6 | NX2012SA-32.768K-STD-MUB-1 | 1 | NX2012SA-32.768K-STD-MUB-1 | NDK
BQ7 | TAXM25M4RDBCCT2T | 1 | TAXM25M4RDBCCT2T | Yajingxin
BQ8 | X32258MOB4SI | 1 | X32258MOB4SI | YXC Crystal Oscillators
BQ9 | 3225-24-18-10-10/4B | 1 | 3225-24-18-10-10/4B | Liming
C1, C2, C4, C16, C18, C19, C20, C21, C22, C25, C26, C27, C28, C29, C35, C36, C37, C38, C39, C40, C41, C42, C43, C45, C54, C113, C123, C124, C125, C132, C136, C137, C141, C144, C148, C149, C153, C154, C155, C158, C260, C261, C262, C263, C264, C318, C320, C322, C323, C405, C410, C543, C545, C546, C547, C548, C550, C553, C555, C556, C557, C558, C559, C564, C567, C568, C569, C578, C579, C586 | 0201-X5R-6.3V-0.1uF±10% | 70 | CC0201KRX5R5BB104 | Yageo
C3, C6, C7, C9, C10, C13, C17, C205, C206, C284, C285, C286, C287, C289, C290, C291, C293, C294, C295 | 1206-X5R-50V-010uF±10% | 19 | CC1206KKX5R9BB106 | Yageo
C5, C14, C15, C33, C34, C46, C47, C49, C50, C51, C52, C55, C59, C65, C72, C82, C83, C89, C99, C100, C104, C117, C121, C127, C128, C129, C133, C134, C138, C139, C142, C145, C146, C150, C151, C254, C255, C256, C257, C258, C259, C324, C325, C326, C327, C336, C338, C400, C401, C402, C403, C404, C406, C407, C411, C542, C544, C549, C551, C552, C554, C563, C566, C570, C580, C641 | 0201-X5R-6.3V-1uF±20% | 66 | GRM033R60J105MEA2D | Murata Electronics
C8, C428, C429, C430, C431, C432, C433, C434, C438 | 0402-X7R-16V-0.1uF±10% | 9 | CC0402JRX7R7BB104 | Yageo
C11, C12, C30, C31, C48, C130, C131, C135, C140, C143, C147, C225, C228, C230, C269, C271, C329, C339, C447 | 0402-X5R-6.3V-10uF±20% | 19 | CC0402MRX5R5BB106 | Yageo
C23, C159, C160, C168, C175, C183, C191, C201, C211, C363, C364, C365, C367, C375, C393, C478, C482, C484, C488, C490, C494, C496, C500, C504, C506, C509, C514, C516, C518, C520 | 0402-X5R-50V-0.1uF±10% | 30 | CC0402KRX5R9BB104 | Yageo
C24, C32, C308, C309, C310, C311, C312, C313, C314, C315, C319, C321, C527, C528, C529, C530, C531, C532, C533, C534, C573, C574 | 0201-X5R-25V-0.1uF±10% | 22 | CC0201KRX5R8BB104 | Yageo
C57, C58, C62, C63, C66, C67, C68, C71, C76, C77, C79, C80, C81, C88, C92, C93, C96, C97, C102, C106, C107, C108, C109, C112, C114, C115, C116, C119, C120, C161, C162, C163, C170, C185, C186, C233, C417, C419, C424, C425, C426, C427 | 0603-X5R-10V-22uF±20% | 42 | CL10A226MQ8NRNE, GRM188R61A226ME15D | Samsung Electro-Mechanics, Murata
C60, C61, C69, C73, C74, C84, C85, C86, C90, C95, C224 | 0402-X5R-10V-2.2uF±10% | 11 | CC0402KRX5R6BB225 | Yageo
C70, C87, C101, C111, C477, C480, C481, C483, C486, C487, C489, C492, C493, C495, C498, C499, C501, C502, C503, C505, C508, C511, C512, C513, C515, C517, C519 | 0603-X5R-10V-10uF±10% | 27 | CC0603KRX5R6BB106 | Yageo
C78, C94 | 0402-NP0-50V-100pF±1% | 2 | CC0402FRNPO9BN101 | Yageo
C103, C316, C317, C328, C337 | 0201-X5R-6.3V-4.7uF±20% | 5 | GRM035R60J475ME15D | Murata Electronics
C122 | 0201-C0G-25V-1nF±5% | 1 | GRM0335C1E102JA01D | muRata
C164, C165, C166, C167, C171, C172, C173, C174, C187, C188, C189, C207, C208, C210 | 0805-X7R-50V-2.2uF±10% | 14 | CC0805KKX7R9BB225 | Yageo
C169, C176, C192, C212 | 0402-NP0-50V-220pF±5% | 4 | CC0402JRNPO9BN221 | Yageo
C177, C178, C197, C213 | 0402-X7R-50V-0.022uF±10% | 4 | GRM155R71H223KA12D | Murata Electronics
C179, C181, C198, C214 | 0402-X7R-50V-4700pF±10% | 4 | CC0402KRX7R9BB472 | Yageo
C180, C182, C199, C215 | 0402-NP0-50V-22pF ±10% | 4 | CL05C220JB51PNC | Samsung
C184, C196, C200, C202, C232, C234, C235, C240, C413, C415, C418, C435, C439, C522, C523, C525, C582, C583, C584, C585, C593 | 0402-X5R-10V-0.1uF±10% | 21 | CC0402KRX5R6BB104 | Yageo
C195, C521 | 0402-X5R-10V-10uF±20 | 2 | CL05A106MP5NUNC | Samsung
C216, C217, C218, C219, C221, C222, C226, C227, C229, C267, C268, C270, C278, C280, C330, C331, C332, C333, C334, C335, C340, C341, C342, C343, C344, C345, C442, C444, C446, C448, C450, C451, C452, C453, C454, C535, C540, C541, C560, C561, C562, C581, C589, C638 | 0402-X7R-50V-0.1uF±10% | 44 | CC0402KRX7R9BB104 | Yageo
C220, C223, C443, C449 | 0402-X5R-6.3V-4.7uF±20% | 4 | CC0402MRX5R5BB475 | Yageo
C231, C383, C445 | 0402-X5R-10V-1uF±10% | 3 | CL05A105KP5NNNC | Samsung
C236, C252, C282, C283, C416, C459, C467, C468, C475, C476 | 1812-C0G-2kV-1nF±10% | 10 | 1812B102K202NT | FH
C237, C238, C420, C421 | 0402-NP0-50V-10pF±5% | 4 | CC0402JRNPO9BN100 | Yageo
C239 | 0603-X5R-50V-1uF±10% | 1 | CC0603KRX5R9BB105 | Yageo
C241, C412, C414, C524, C526 | 0402-X5R-10V-10uF±20% | 5 | GRM155R61A106ME44 | Murata Electronics
C242, C243, C244, C245, C246, C247, C248, C249 | 0201-X5R-10V-220nF±10% | 8 | CC0201KRX5R6BB224 | Yageo
C250, C251, C253 | 0402-X5R-50V-1uF±10% | 3 | CC0402KRX5R9BB105 | Yageo
C265, C266, C575, C576, C577 | 0201-C0G-25V-1000pF±10% | 5 | CC0201KRX7R9BB102 | Yageo
C272, C273, C274, C275, C276, C277, C279, C281 | 0402-NP0-50V-33pF±5% | 8 | CC0402FRNPO9BN330 | Yageo
C288, C292 | 1206-X7R-100V-1uF±10% | 2 | TCC1206X7R105K101HT | CCTC
C296, C297 | 1210-X7R-250V-0.1uF±10% | 2 | CC1210KKX7RYBB104 | Yageo
C348, C349 | 0402-X7R-50V-1000pF±5% | 2 | CC0402JRX7R9BB102 | Yageo
C350, C353, C381, C382, C386, C387 | 0402-X5R-16V-2.2uF±10% | 6 | CC0402KRX5R7BB225 | Yageo
C361, C362, C366 | 0603-X5R-10V-10uF±20% | 3 | CL10A106MP8NNNC | Samsung Electro-Mechanics
C370, C379, C389, C399 | 0603-X7R-25V-0.68uF±10% | 4 | CC0603KRX7R8BB684 | Yageo
C371, C372, C373, C377, C378, C390, C391, C395, C397, C398 | 0603-NP0-50V-330pF±5% | 10 | CC0603JRNPO9BN331 | Yageo
C374, C392 | 0402-X7R-50V-0.01uF±10% | 2 | CC0402KRX7R9BB103 | Yageo
C380, C384, C385, C388 | 0603-X5R-50V-0.22uF±10% | 4 | CL10A224KB8NNNC | Samsung
C396 | 0402-NP0-50V-047pF±5% | 1 | CC0402JRNPO9BN470 | Yageo
C422, C423, C440, C441, C537, C538, C571, C572 | 0402-NP0-50V-12pF±5% | 8 | GRM1555C1H120JA01D | Murata Electronics
C436, C437 | 0402-X7R-6.3V-1uF±10% | 2 | CC0402KRX7R5BB105 | Yageo
C455, C591 | 0603-X7R-50V-0.1uF±10% | 2 | CC0603KRX7R9BB104 | Yageo
C456, C458 | 1206-NP0-630V-1000pF±5% | 2 | AC1206JKNPOZBN102 | Yageo
C457, C463 | 1206-X7R-100V-0.1uF±10% | 2 | C1206C104K1RAC7800 | KEMET
C460, C469 | 1206-X7R-2K-4700pF±10% | 2 | 1206B472K202NT | FH
C461, C462, C592 | 1206-X7R-2K-1000pF±10% | 3 | CC1206KKX7RDBB102 | Yageo
C464, C465, C466 | 1210-X7S-100V-10uF±10% | 3 | CL32Y106KCVZNWE | Samsung Electro-Mechanics
C470 | 0805-X7R-100V-470pF±10% | 1 | CC0805JRNPO0BN471 | Yageo
C471, C472, C473, C474 | 0603-X7R-50V-0.01uF±10% | 4 | CC0603KRX7R9BB103 | Yageo
C479, C485, C491, C497, C510 | 0402-NP0-50V-100pF±5% | 5 | CC0402JRNPO9BN101 | Yageo
C507, C587 | 0402-NP0-50V-1000pF±5% | 2 | CC0402JRNPO9BN102 | Yageo
C536, C539, C588 | 0805-X5R-25V-10uF±10% | 3 | CL21A106KAYNNNE | Samsung
C590 | 0805-X5R-35V-10uF±10% | 1 | C2012X5R1V106K085AC | TDK Corporation
D1 | RS1G32LO4D2BDS-46IT | 1 | RS1G32LO4D2BDS-46IT | Rayson
D2 | RK3576J | 1 | RK3576J | Rockship
D3 | RK806S-5 | 1 | RK806S-5 | Rockchip
D4, D5, D7, D11 | SCT2651DRBR | 4 | SCT2651DRBR | SCT
D6 | TPS3851G33SDRBR | 1 | TPS3851G33SDRBR | Texas Instruments
D9 | 1XZA032768AD19 | 1 | 1XZA032768AD19 | KDS
D10 | BM8563ESA | 1 | BM8563ESA | GATEMODE
D12 | SC-MHF064GMLES-821-N0 | 1 | SC-MHF064GMLES-821-N0 | Samsung
D13 | W25Q256JVEIQ | 1 | W25Q256JVEIQ | Winbond
D14 | ZD24C08A-STGMT | 1 | ZD24C08A-STGMT | Zetta
D15, D17 | SY6280AAC | 2 | SY6280AAC | Silergy Corp
D16 | CH334R | 1 | CH334R | WCH
D18 | RS2299XTQC16 | 1 | RS2299XTQC16 | RUNIC Tech
D19, D20 | LM5050MKX-1/NOPB | 2 | LM5050MKX-1/NOPB | TI
D21 | ASM1184e | 1 | ASM1184e | ASMedia
D23 | PCM5122 | 1 | PCM5122 | Texas Instruments
D25 | TPA3130D2 | 1 | TPA3130D2 | Texas Instruments
D26 | CH340E | 1 | CH340E | WCH
D27 | LD1117-ADJ | 1 | LD1117-ADJ | UMW
D28 | К1921ВГ015 | 1 | К1921ВГ015 | НИИЭТ
D29, D31 | PI3A27518ZDEX | 2 | PI3A27518ZDEX | Diodes Incorporated
D30 | RT9013-33GB | 1 | RT9013-33GB | Richtek
D32 | RTL8211FI-CG | 1 | RTL8211FI-CG | Realtek Semicon
D33 | LP72431ANL | 1 | LP72431ANL | LINK-PP
D34 | PM8805TR | 1 | PM8805TR | ST
D35, D36, D37, D38, D40 | TMI3112H | 5 | TMI3112H | TMI
D39, D41 | SGM2590D | 2 | SGM2590D | SGM
D42 | PI3USB102EZLEX | 1 | PI3USB102EZLEX | Diodes
D43 | UM3204H | 1 | UM3204H | Union
D44 | MCP2515-I/ST | 1 | MCP2515-I/ST | MICROCHIP
D45 | SN65HVD235DR | 1 | SN65HVD235DR | TI
D46 | TS3DV642A0RUAR | 1 | TS3DV642A0RUAR | TI
D47 | RK628F | 1 | RK628F | Rockchip
HL10 | XL-B3528RGBC-BM | 1 | XL-B3528RGBC-BM | XINGLIGHT
L1, L3, L5, L7, L10 | 0806-5A-0.47uH±20% | 5 | WIP201610P-R47ML | INPAQ
L2, L4, L6, L8, L9 | 0806-4.4A-0.24uH±20% | 5 | FPA201612D-R24MT0 | cjiang
L11, L12, L13, L14 | MWSA0603S-6R8MT | 4 | MWSA0603S-6R8MT | Sunlord
L15, L16 | PCAQ7060MW-301 | 2 | PCAQ7060MW-301 | PROD Tech
L17 | 0805-3A-120R-100MHz | 1 | BLM21PG121SH1D | Murata Electronics
L18, L19, L20, L21 | MWSA0605S-100MT | 4 | MWSA0605S-100MT | Sunlord
L24 | 0806-2.1A-15uH±20% | 1 | DFE201612E-2R2M=P2 | Murata Electronics
L25, L33, L34 | CBW100505U121T | 3 | CBW100505U121T | Murata Electronics
L26, L27 | 0805-3A-220R-100MHz | 2 | MPZ2012S221AT000 | TDK
L28, L29, L30, L31, L32 | MWSA0402S-1R0MT | 5 | MWSA0402S-1R0MT | Sunlord
L35 | 0402-150mA-82nH±5% | 1 | LQG15HN82NJ02D | Murata Electronics
R1, R3 | 0402-0.0625W-240R-100ppm±1% | 2 | RC0402FR-07240RL | Yageo
R2, R63, R65, R67, R71, R74, R80, R84, R87, R93, R96, R98, R102, R132, R139, R140, R167, R177, R178, R179, R180, R182, R184, R193, R194, R208, R211, R212, R228, R264, R282, R370, R371, R386, R388, R395, R399, R400, R409, R412, R414, R415, R418, R420, R421, R426, R427, R428, R429, R430, R438, R439, R440, R442, R444, R454, R477, R478 | 0402-0.0625W-10K-100ppm±1% | 58 | RC0402FR-0710KL | Yageo
R4, R6, R9, R21, R29, R30, R52, R131, R133, R134, R198, R202, R204, R206, R214, R220, R238, R240, R243, R244, R259, R266, R284, R346, R348, R396, R397, R407, R416, R451, R456, R457, R488, R493, R494, R495, R498, R499, R502 | 0402-0.0625W-0R-100ppm±1% | 39 | RC0402FR-070RL | Yageo
R7, R8 | 0201-0.05W-240R-100ppm-5% | 2 | RC0201FR-07240RL | Yageo
R11, R15, R18, R23, R24, R25 | 0201-0.05W-100R-200ppm-5% | 6 | RC0201JR-07100RL | Yageo
R12, R373 | 0402-0.0625W-49.9K-100ppm±1% | 2 | RC0402FR-0749K9L | Yageo
R13, R16, R19, R92, R163, R164, R165, R166, R203, R205, R213, R217, R222, R225, R229, R268, R269, R270, R271, R353, R354, R359, R360, R364, R385, R404 | 0402-0.0625W-100K-100ppm±1% | 26 | RC0402FR-07100KL | Yageo
R14 | 0402-0.0625W-22K-100ppm±1% | 1 | RC0402FR-0722KL | Yageo
R17, R362 | 0402-0.0625W-120K-100ppm±1% | 2 | RC0402FR-07120KL | Yageo
R20 | 0201-0.05W-100K-5% | 1 | RC0201FR-07100KL | Yageo
R22 | 0201-0.05W-200K-100ppm-1% | 1 | RC0201FR-07200KL | Yageo
R26 | 0201-0.05W-10K-100ppm-1% | 1 | RC0201FR-0710KL | Yageo
R27, R73, R75, R76, R77, R78, R79, R135, R136, R137, R138, R141, R142, R260, R261, R262, R263, R294, R297, R300, R302, R303, R304, R309, R310, R311, R314, R315, R316, R431, R432, R433, R434, R435, R436, R437, R459, R460, R504, R505, R506, R507, R508, R509 | 0402-0.0625W-22R-100ppm±1% | 44 | RC0402FR-0722RL | Yageo
R28, R253, R285, R510 | 0402-0.0625W-1M-100ppm±1% | 4 | RC0402FR-071ML | Yageo
R33, R195, R196, R227 | 0402-0.0625W-4.7K-100ppm±5% | 4 | RC0402JR-074K7L | Yageo
R34, R47 | 0402-0.0625W-52.3K-100ppm±1% | 2 | RC0402FR-0752K3L | Yageo
R35 | 0402-0.0625W-31.6K-100ppm±1% | 1 | RC0402FR-0731K6L | Yageo
R36, R37, R48, R59 | 0402-0.0625W-10.2K-100ppm±5% | 4 | RC0402FR-0710K2L | Yageo
R39, R41, R50, R61 | 0402-0.0625W-200K-100ppm±5% | 4 | RC0402JR-07200KL | Yageo
R40, R42, R51, R62, R94, R149, R150, R155, R156, R157, R158, R245, R381, R403 | 0402-0.0625W-20K-100ppm±1% | 14 | RC0402FR-0720KL | Yageo
R43, R44, R53, R121, R125, R247, R248, R249, R250, R252, R254, R255, R256, R257, R258, R281, R326, R327, R329, R366 | 0402-0.0625W-10K-100ppm±5% | 20 | RC0402JR-0710KL | Yageo
R55, R56, R81, R82, R108, R109, R124, R126, R129, R130, R151, R152, R189, R191, R287, R489, R490 | 0402-0.0625W-2.2K-100ppm±5% | 17 | RC0402JR-072K2L | Yageo
R58 | 0402-0.0625W-143K-100ppm±1% | 1 | RC0402FR-07143KL | Yageo
R64 | 0603-0.1W-0R-200ppm±1% | 1 | RC0603FR-070RL | Yageo
R66, R106, R122, R123, R417, R422, R480, R500, R501 | 0402-0.0625W-22R-100ppm±5% | 9 | RC0402JR-0722RL | Yageo
R68, R69, R83, R101, R251, R479, R481, R665, R666, R667 | 0402-0.0625W-1K-100ppm±5% | 10 | RC0402JR-071KL | Yageo
R70, R104, R323, R324, R325 | 0402-0.0625W-47K-100ppm±1% | 5 | RC0402FR-0747KL | Yageo
R85, R86, R423, R484, R485, R491 | 0402-0.0625W-0R-100ppm±5% | 6 | RC0402JR-070RL | Yageo
R89, R90, R445, R446, R448, R449, R450, R452, R453, R455, R462, R463, R464, R465, R466, R467, R468, R469 | 0402-0.0625W-2.2R-100ppm±1% | 18 | RC0402FR-072R2L, AC0402FR-072R2L | Yageo
R91, R103 | 0402-0.0625W-6.04K-100ppm±1% | 2 | RC0402FR-076K04L | Yageo
R95, R105, R112, R143, R144, R350, R492 | 1206-0.25W-1M-100ppm±1% | 7 | RC1206FR-071ML | Yageo
R97, R99, R272 | 0402-0.0625W-2K-100ppm±1% | 3 | RC0402FR-072KL | Yageo
R100 | 0402-0.0625W-27K-100ppm±1% | 1 | RC0402FR-0727KL | Yageo
R110, R111 | 0402-0.0625W-5.1K-100ppm±1% | 2 | RC0402FR-075K1L | Yageo
R113, R290, R367, R410, R662 | 0402-0.0625W-100R-100ppm±1% | 5 | RC0402FR-07100RL | Yageo
R114 | 0402-0.0625W-165R-100ppm±1% | 1 | AC0402FR-07165RL | Yageo
R115, R116, R119 | 0201-0.05W-0R-100ppm-5% | 3 | RC0201JR-070RL | Yageo
R117, R174, R175 | 0402-0.0625W-8.2K-100ppm±1% | 3 | RC0402FR-078K2L | Yageo
R118 | 0201-0.05W-10K-200ppm-1% | 1 | RC0201FR-0710KL | Yageo
R120, R153, R154, R351, R355, R356, R358, R361 | 0402-0.0625W-100K-100ppm±5% | 8 | RC0402JR-07100KL | Yageo
R145, R146, R472 | 2010-0.75W-0R-200ppm±5% | 3 | RC2010JK-070RL | Yageo
R147, R148 | 0805-0.125W-100R-100ppm±1% | 2 | RC0805FR-07100RL | Yageo
R159, R160, R161, R162, R234, R246, R365, R384, R486, R487, R503 | 0402-0.0625W-2.2K-100ppm±1% | 11 | RC0402FR-072K2L | Yageo
R168, R169 | 0402-0.0625W-200R-100ppm±1% | 2 | CRCW0402200RFKED | Vishay Intertechnology Inc.
R190, R192 | 0402-0.0625W-12.1K-100ppm±1% | 2 | RC0402FR-0712K1L | Yageo
R197, R199, R218, R237 | 0402-0.0625W-1K-100ppm±1% | 4 | RC0402FR-071KL | Yageo
R200, R201 | 0402-0.0625W-1.02K-100ppm±1% | 2 | RC0402FR-071K02L | Yageo
R207, R209, R210, R236, R273, R274, R275, R276, R277, R278, R279, R280 | 0402-0.0625W-13K-100ppm±1% | 12 | RC0402FR-0713KL | Yageo
R215, R219, R224, R230 | 0603-0.1W-3.3R-200ppm±1% | 4 | RC0603FR-073R3L | Yageo
R216, R221, R226, R231 | 0603-0.1W-22R-100ppm±5% | 4 | RC0603JR-0722RL | Yageo
R223 | 0402-0.0625W-5.6K-100ppm±1% | 1 | RC0402FR-075K6L | Yageo
R267 | 0402-0.0625W-270R-100ppm±1% | 1 | 0402WGF2700TCE | UNI-ROYAL
R289 | 0402-0.0625W-2.49K-100ppm±1% | 1 | RC0402FR-072K49L | Yageo
R291 | 0402-0.0625W-120R-100ppm±1% | 1 | RC0402FR-07120RL | Yageo
R292, R296, R298, R301, R305, R307, R313, R317, R320, R321 | 0402-0.0625W-4.7K-100ppm±1% | 10 | RC0402FR-074K7L | Yageo
R293 | 0805-0.125W-0R-250ppm±5% | 1 | RC0805JR-070RL | Yageo
R322, R328, R330, R333, R337, R338, R339, R340 | 0603-0.1W-75R-100ppm±1% | 8 | RC0603FR-0775RL | Yageo
R331 | 1206-0.25W-10K-100ppm±5% | 1 | RC1206JR-1310KL | Yageo
R332, R335 | 1206-0.25W-0R-200ppm±5% | 2 | RC1206JR-070RL | Yageo
R334 | 0603-0.1W-26.1K-100ppm±1% | 1 | NRC06F2612TRF | NIC Components Corp.
R336 | 2010-0.75W-91R-200ppm±5% | 1 | CL2010JN91RB | CHANGLONG
R341 | 1206-0.25W-3M-100ppm±1% | 1 | NQ06W4F3004T5E | UNI-ROYAL
R342 | 0805-0.125W-51.1R-100ppm±1% | 1 | RT0805BRD0751R1L | YAGEO
R343 | 0805-0.125W-36.5R-100ppm±1% | 1 | 0805W8F365JT5E | UNI-ROYAL
R345, R347 | 0402-0.0625W-510R-100ppm±5% | 2 | RC0402JR-07510RL | Yageo
R352 | 0402-0.0625W-150K-100ppm±1% | 1 | RC0402FR-07150KL | Yageo
R357 | 0402-0.0625W-249K-100ppm±1% | 1 | RC0402FR-07249KL | Yageo
R363 | 0402-0.0625W-470K-100ppm±1% | 1 | RC0402FR-07470KL | Yageo
R368 | 0402-0.0625W-43K-100ppm±1% | 1 | RC0402FR-0743KL | Yageo
R369 | 0603-0.1W-0R-100ppm±5% | 1 | RC0603JR-070RL | Yageo
R372 | 0603-0.1W-3.32K-100ppm±1% | 1 | CR-03FL7---3K3 | Viking Tech Corp.(VIKING)
R389, R390, R391, R392, R394 | 0402-0.0625W-30K-100ppm±1% | 5 | RC0402FR-0730K1L | Yageo
R398 | 0402-0.0625W-15K-100ppm±1% | 1 | CR-02FL6---15K | Viking Tech Corp.(VIKING)
R408 | 0402-0.0625W-9.1K-100ppm±1% | 1 | RC0402FR-079K1L | Yageo
R411 | 0402-0.0625W-330R-100ppm±1% | 1 | AC0402FR-07330RL | Yageo
R413 | 0402-0.0625W-1.13K-100ppm±1% | 1 | RC0402FR-071K13L | Yageo
R419 | 0402-0.0625W-6.8K-100ppm±1% | 1 | RC0402FR-076K8L | Yageo
R424 | 1206-0.25W-120R-100ppm±1% | 1 | RC1206FR-07120RL | Yageo
R425 | 0402-0.0625W-120R-200ppm±5% | 1 | RC0402JR-07120RL | Yageo
R458 | 0402-0.0625W-12K-100ppm±5% | 1 | WR04X123JTL | Walsin Technology Corporation
R461, R470 | 0402-0.0625W-1.62K-100ppm±1% | 2 | RC0402FR-071K62L | Yageo
R471 | 0402-0.0625W-4.02K-100ppm±1% | 1 | RC0402FR-074K02L | Yageo
R663, R664 | 0402-0.0625W-10R-200ppm±1% | 2 | RC0402FR-0710RL | Yageo
RV1, RV2 | B72214S0600K101 | 2 | B72214S0600K101 | Epcos
S1 | SW-LEDX4-7-2_54 | 1 | SW-LEDX4-7-2_54 | FVWIN Electronics
S2 | L-KLS7-TS5401-1.35-250-T | 1 | L-KLS7-TS5401-1.35-250-T | KLS Electronic
S3 | SKRKAEE020 | 1 | SKRKAEE020 | ALPSALPINE
V86, VT84, VT85 | BSS138 | 3 | BSS138 | Yangjie
VD1 | ESD73111CZ-2/TR | 1 | ESD73111CZ-2/TR | WILLSEMI
VD2, VD22 | B5819WS | 2 | B5819WS | [NoParam], MDD
VD3, VD4, VD5, VD6, VD10, VD33, VD34, VD35, VD40, VD41, VD49 | SS56B | 11 | SS56B | Yangjie (YJ)
VD7, VD8, VD9, VD42, VD43, VD53 | B5819W | 6 | B5819W | MDD
VD11, VD12, VD13, VD14, VD15, VD16, VD17, VD25, VD26, VD27, VD28, VD29, VD30, VD52 | ESD5451N | 14 | ESD5451N | Tech Public Co.
VD18, VD19, VD20, VD21 | ESD5311N | 4 | ESD5311N | UMW
VD23, VD24 | ESD5344D | 2 | ESD5344D | KUU
VD31, VD32 | PESD5V0L4UG | 2 | PESD5V0L4UG | Tech Public Co.
VD36, VD37 | BAS40-7-F | 2 | BAS40-7-F | Diodes Incorporated
VD38, VD39 | SS16T3G | 2 | SS16T3G | ON Semiconductor
VD44 | TL431AIDBZR | 1 | TL431AIDBZR | TI
VD45 | TL432AIDBZR | 1 | TL432AIDBZR | TI
VD46, VD48 | SMAJ58CA | 2 | SMAJ58CA | Littelfuse
VD47, VD51 | SMAJ58A | 2 | SMAJ58A | Littelfuse
VD50 | BAV70W | 1 | LBAV70WT1G | LRC
VT1, VT2, VT3, VT8, VT10, VT11, VT16, VT17, VT22, VT23, VT24, VT25, VT26, VT32 | MMBT3904 | 14 | MMBT3904 | Diotec Semiconductor
VT4, VT5, VT6, VT28, VT29, VT33 | 2SK3018 | 6 | 2SK3018 | KUU, [NoParam]
VT7, VT14, VT31 | WM02P41M | 3 | WM02P41M | Wayon
VT9, VT12, VT13 | AON7262E | 3 | AON7262E | Alpha & Omega
VT15, VT18, VT19, VT20, VT21 | AP50P20Q | 5 | AP50P20Q | ALLPOWER
VT27, VT30 | WNM2016 | 2 | WNM2016 | KUU Semiconductor
X1 | A1251-SMT-02A | 1 | A1251-SMT-02A | MOLEX
X2, X4, X32 | PLS-2 | 3 | PLS-2 | NXU, [NoParam]
X3 | L-KLS1-TF-003 | 1 | L-KLS1-TF-003 | KLS
X5 | HC-USB3.0-L168-WP | 1 | HC-USB3.0-L168-WP | Hong Cheng
X6 | DS1114-BN0 | 1 | DS1114-BN0 | CONNFLY
X7, X8, X16, X17 | AAA-PCI-047-K01 | 4 | AAA-PCI-047-K01 | LOTES
X9, X10, X39, X40 | SMTSO2066MTJ | 4 | SMTSO2066MTJ | Sinhoo
X11, X12 | mup-c7808-01 | 2 | mup-c7808-01 | MUP
X13, X14 | 15EDGRM-3.81-02P | 2 | 15EDGRM-3.81-02P | DEGSON
X15 | 3113-110T | 1 | 3113-110T | UMAX
X18, X19 | X1613WS-36-9TV01 | 2 | X1613WS-36-9TV01 | XKB Connection
X20, X21 | B2B-XH-A(LF)(SN) | 2 | B2B-XH-A(LF)(SN) | JST
X22, X23, X43 | FPC-05F-22PH20 | 3 | FPC-05F-22PH20 | XUNPU
X24 | B2B-PH-K-S | 1 | B2B-PH-K-S | JST Sales America Inc.
X26 | LPJE4714BGNL | 1 | LPJE4714BGNL | LINK-PP
X27, X28 | U.FL-R-SMT-1[80] | 2 | U.FL-R-SMT-1[80] | TE Connectivity
X29 | XF2M30151A | 1 | XF2M30151A | Omron
X30 | 15EDGRC-3.5-02P-14-00AH | 1 | 15EDGRC-3.5-02P-14-00AH | Degson
X31 | ALC03-S51FIA-00 | 1 | ALC03-S51FIA-00 | JUSHUO
X33 | DS1069-4MVW6X | 1 | DS1069-4MVW6X | CONNFLY
X34 | B7B-PH-K-S(LF)(SN) | 1 | B7B-PH-K-S(LF)(SN) | JST
X35 | PH2.0-01-15PZS | 1 | PH2.0-01-15PZS | XUNPU
X36 | LEM-195 | 1 | LEM-195 | Kang Yang
X37 | IRM-3638T | 1 | IRM-3638T | EVERLIGHT
X38 | DC-036A-2.5A-2.5 | 1 | DC-036A-2.5A-2.5 | XKB Connection
X41 | USB3.1 TYPE-C 24PF-003 | 1 | USB3.1 TYPE-C 24PF-003 | RUICHI
