Rustik2044/MU-RK3576J-MB/Project/refdoc/05_Product Line Branch_Tablet_仅供参考！/03_Reference Design/RK_TABLET_DEMO1_RK3576_LP4XD200P132SD6_V12_20240530叠构文件.xls

Sheet: 1.6通孔
6层通孔 |  |  |  |  | Impedance | 40 ohm | 45ohm | 50 ohm | 55 ohm | 80 ohm | 85 ohm | 90 ohm | 100 ohm
Layer | Mother Board | Typical layer thickness (mil) | Dielectric Constant | DF | Reference Layer
 | Solder Mask | 1.10
L1 | 1/3oz+plating | 1.20 |  |  | L1->L2 | 6.5 | 5.4 | 4.5 | 3.5 | 5->3.8 | 4.6->4.2 | 4.2->4.6 | 3.5->5.3
 | Prepreg (1080 ) | 2.70 | 4.00 | 0.019 | L1->L3 |  |  | 12.5
L2 | copper | 1.20
 | Core | 3.00 | 4.2 | 0.015
L3 | copper | 1.20 |  |  | L3->L2/L4 | 5.7 | 4.6 | 3.6 |  | 4.4->5.6 | 3.9->6.1 | 3.5->6.5 | 3.0->9.0
 | Prepreg (1080 ) | 2.70 | 4.00 | 0.019
 | Prepreg (7628) | 8.00 | 4.00 | 0.019
L4 | copper | 1.20
 | Core | 3.00 | 4.2 | 0.015
L5 | copper | 1.20
 | Prepreg (1080 ) | 2.70 | 4.00 | 0.019
L6 | 1/3oz+plating | 1.20 |  |  | L6->L5 | 6.5 | 5.4 | 4.5 | 3.5 | 5->3.8 | 4.6->4.2 | 4.2->4.6 | 3.5->5.3
 | Solder Mask | 1.10
 |  | 31.50
 |  | 0.80

Sheet: 阻抗计算
单端L1 /L6 40 Ohm | 单端L1 /L6 45 Ohm | 单端L1 /L6 50 Ohm | L1 /L6 80 Ohm | L1 /L6 85 Ohm | L1 /L6 90 Ohm | L1 /L6 100 Ohm
单端L3 40 Ohm | 单端L3 45 Ohm | 单端L3 50 Ohm | L4 80 Ohm | L4 85 Ohm | L4 90 Ohm | 单端L4 100 Ohm
 |  | 参考第三层

Sheet: Sheet1
85hm | L4
