Rustik2044/MU-RK3576J-MB/For_production_MU-3576-MB/Impedance_profile_MU-RK3576J-MB.xlsx

Impedances
# | Target impedance (Ω) | Type | Trace layer | Calculated impedance (Ω) | Trace width (mm) | Gap (mm) | Reference layers | Stack
1 | 50 | Single | Layer 8_HI | 49.1999 | 0.09 |  | Layer 7_GND | Layer 9_GND
2 | 50 | Single | Layer 3_HI | 49.1999 | 0.09 |  | Layer 2_GND | Layer 4_PWR
3 | 50 | Single | GTL_TOP_Hi | 53.0322 | 0.11 |  | Layer 2_GND | Board Layer Stack
4 | 50 | Single | Layer 6_HI | 49.5327 | 0.09 |  | Layer 5_PWR | Layer 7_GND
5 | 50 | Single | GBL_BOTTOM_Hi | 53.0323 | 0.11 |  | Layer 9_GND | Board Layer Stack
6 | 85 | Diff pair | Layer 6_HI | 84.5705 | 0.087 | 0.1 | Layer 5_PWR | Layer 7_GND
7 | 85 | Diff pair | Layer 8_HI | 84.9904 | 0.087 | 0.1 | Layer 7_GND | Layer 9_GND
8 | 85 | Diff pair | Layer 3_HI | 84.9904 | 0.087 | 0.1 | Layer 2_GND | Layer 4_PWR
9 | 85 | Diff pair | GBL_BOTTOM_Hi | 85.6312 | 0.13 | 0.12 | Layer 9_GND | Board Layer Stack
10 | 85 | Diff pair | GTL_TOP_Hi | 85.6312 | 0.13 | 0.12 | Layer 2_GND | Board Layer Stack
11 | 90 | Diff pair | Layer 6_HI | 89.6694 | 0.088 | 0.14 | Layer 5_PWR | Layer 7_GND
12 | 90 | Diff pair | Layer 8_HI | 90.9457 | 0.088 | 0.15 | Layer 7_GND | Layer 9_GND
13 | 90 | Diff pair | Layer 3_HI | 90.9457 | 0.088 | 0.15 | Layer 2_GND | Layer 4_PWR
14 | 90 | Diff pair | GBL_BOTTOM_Hi | 91.0179 | 0.12 | 0.14 | Layer 9_GND | Board Layer Stack
15 | 90 | Diff pair | GTL_TOP_Hi | 91.0179 | 0.12 | 0.14 | Layer 2_GND | Board Layer Stack
16 | 100 | Diff pair | Layer 6_HI | 90.9163 | 0.085 | 0.14 | Layer 5_PWR | Layer 7_GND
17 | 100 | Diff pair | Layer 8_HI | 91.2508 | 0.085 | 0.14 | Layer 7_GND | Layer 9_GND
18 | 100 | Diff pair | Layer 3_HI | 91.2508 | 0.085 | 0.14 | Layer 2_GND | Layer 4_PWR
19 | 100 | Diff pair | GBL_BOTTOM_Hi | 101.8862 | 0.095 | 0.15 | Layer 9_GND | Board Layer Stack
20 | 100 | Diff pair | GTL_TOP_Hi | 101.8862 | 0.095 | 0.15 | Layer 2_GND | Board Layer Stack
