Rustik2044/MU-RK3576J-MB/Терминал_ВКС_просчет/Спецификация MU-3XHDMI-1XRS232-3XUSB-M.xlsx

Designator | Part Number | Quantity | NameFromManufacturer | Manufacturer
D1 | SCT2651DRBR | 1 | SCT2651DRBR | SCT
D2 | LT6911 | 2 | LT6911 | LONTIUM SEMICONDUCTOR
D3 | CH344Q | 1 | CH344Q | WCH
D4 | ASM1042A | 1 | ASM1042A | ASMEDIA | или вот этот VIA Labs - VL805 (предпочтительней)
X5 | HC-USB3.0-L168-WP | 2 | HC-USB3.0-L168-WP | Hong Cheng
X6 | DS1114-BN0 | 3 | DS1114-BN0 | CONNFLY
X22, X23, X43 | FPC-05F-22PH20 | 3 | FPC-05F-22PH20 | XUNPU
Плата 4-x слойная;18мкм; FR4-TG-150; контроль импеданса; маска зеленая с двух сторон;толщина 1 мм; размер платы: 140mm x 90mm; без лакировки
