Rustik2044/MU-RK3576J-MB/Project/refdoc/02_DDR Template/RK3576_TEMPLATE_LP4XD200P132SD6_24X34_2133MHz_V11/H1R0/RK3576_TEMPLATE_LP4XD200P132SD6_24X34_2133MHz_H1R0_V11_20240529YWQ阻抗叠层.xls

6层通孔（假八层）1.6+/-0.16mm |  |  |  |  | Impedance | 40 ohm | 45ohm | 50 ohm | 55 ohm | 80 ohm | 85 ohm | 90 ohm | 100 ohm
Layer | Mother Board | Typical layer thickness (mil) | Dielectric Constant | DF | Reference Layer
 | Solder Mask | 1.10
L1 | 1/3oz+plating | 1.20 |  |  | L1->L2 | 6.5 | 5.4 | 4.5 | 3.5 | 5->3.8 | 4.6->4.2 | 4.2->4.6 | 3.5->5.3
 | Prepreg (1080 ) | 2.70 | 4.00 | 0.019 | L1->L3
L2 | copper | 1.20
 | Core | 3.00 | 4.2 | 0.015
L3 | copper | 1.20 |  |  | L3->L2/L4 | 5.7 | 4.45 | 3.5 |  | 4.4->5.6 | 3.9->6.1 | 3.5->6.5 | 3.0->9.0
 | Prepreg (2116 ) | 4.00 | 4.00 | 0.019
 | Core | 10.00 | 4.2 | 0.015
 | Prepreg (2116 ) | 4.00 | 4.00 | 0.019
L4 | copper | 1.20 |  |  | L4->L5/L3 | 5.7 | 4.45 | 3.5 |  | 4.4->5.6 | 3.9->6.1 | 3.5->6.5 | 3.0->9.0
 | Core | 3.00 | 4.2 | 0.015
L5 | copper | 1.20
 | Prepreg (1080 ) | 2.70 | 4.00 | 0.019
L6 | 1/3oz+plating | 1.20 |  |  | L6->L5 | 6.5 | 5.4 | 4.5 | 3.5 | 5->3.8 | 4.6->4.2 | 4.2->4.6 | 3.5->5.3
 | Solder Mask | 1.10
 |  | 38.80
