Rustik2044/MU-RK3576J-MB/Project/refdoc/02_DDR Template/RK3576_Template_LP5D315P132SD8_25x36_2400MHz_V11/H1R0/RK3576_Template_LP5D315P132SD8_25x36_2400MHz_H1R0_V11_20240530YWQ阻抗叠层.xlsx

Sheet: 1.0通孔
8层通孔1.6+/-0.16mm |  |  |  |  | Impedance Reference Layer |  | 40 ohm | 45 ohm | 50 ohm | 55 ohm | 80 ohm | 85 ohm | 90 ohm | 95 ohm | 100 ohm
Layer | Mother Board | Typical layer thickness (mil) | Dielectric Constant | DF |  |  | width | width | width | width | width/space | width/space | width/space | width/space | width/space
 | Solder Mask | 1.10 |  |  | Layer | Reference Layer
L1 | 1/3oz+plating | 1.20 |  |  | L1 | L2 | 6.5 | 5.4 | 4.5 | 3.5 | 5/3.8 | 4.6/4.2 | 4.2/4.6 | 3.85/4.95 | 3.5/5.3
 |  |  |  |  | L1 | L3 |  |  | 22.5
 | Prepreg(1080 ) | 2.70 | 4.00 | 0.019
L2 | copper | 1.20
 | Core | 7.10 | 4.2 | 0.015
L3 | copper | 1.20 |  |  | L3 | L2/L4 | 5.5 | 4.35 | 3.5 |  | 4.7/5.3 | 4.15/5.85 | 3.7/6.3 | 3.5/8
 | Prepreg (1080 ) | 3.30 | 4.00 | 0.019
L4 | copper | 1.20
 | Core | 3.00 | 4.2 | 0.015
L5 | copper | 1.20
 | Prepreg (1080 ) | 3.30 | 4.00 | 0.019
L6 | copper | 1.20 |  |  | L6 | L5/L7 | 5.5 | 4.35 | 3.5 |  | 4.7/5.3 | 4.15/5.85 | 3.7/6.3 | 3.5/8
 | Core | 7.10 | 4.2 | 0.015
L7 | copper | 1.20
 | Prepreg(1080 ) | 2.70 | 4.00 | 0.019
L8 | 1/3oz+plating | 1.20 |  |  | L8 | L7 | 6.5 | 5.4 | 4.5 | 3.5 | 5/3.8 | 4.6/4.2 | 4.2/4.6 | 3.85/4.95 | 3.5/5.3
 | Solder Mask | 1.10
 |  | 41.00 |  |  | Note: The unit of line width and line spacing is mil，Line space refers to the air gap.
 |  | 1.04

Sheet: 阻抗计算
单端L1 /L8 40 Ohm | 单端L1 /L8 45 Ohm | 单端L1 /L8 50 Ohm | L1 /L8 80 Ohm | L1 /L8 85 Ohm | L1 /L8 90 Ohm | L1 /L8 100 Ohm
单端L3/L6 40 Ohm | 单端L3/L6 45 Ohm | 单端L3/L6 50 Ohm | L3/L6 80 Ohm | L3/L6 85 Ohm | L3/L6 90 Ohm | L3/L6 100 Ohm
 |  | 参考第三层
