Rustik2044/MU-RK3576J-MB/Project/BomTemplate.xlsx

 | Название модуля: | Field=ProjectGOSTName |  | Организация: | Field=ProjectGOSTOrganization
 | Номер модуля: | Field=ProjectGOSTNumber |  | Номер платы: | Field=ProjectGOSTPCBNumber
 | Версия платы: | Field=ProjectRevisionCode |  | Дата: | Field=CurrentDate
 | Название исполнения: | Field=VariantName |  | Автор: | Field=Author
Column=Line # | Column=NameFromManufacturer | Column=Manufacturer | Column=Analog | Column=Description | Column=Designator | Column=Quantity
