Rustik2044/MU-RK3576J-MB/Модули расширения/PCB.step

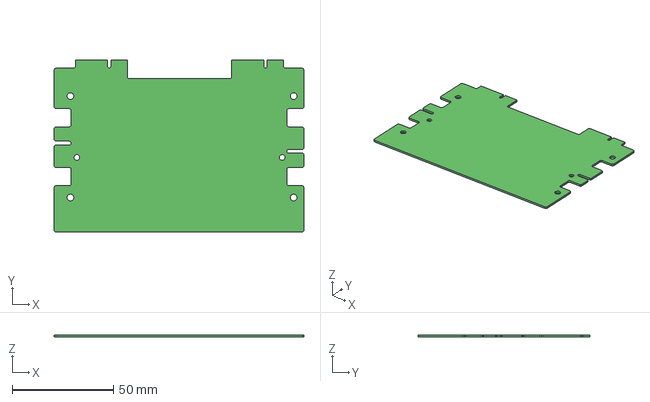
[picture p2: CAD file, 2026-04-18]
Модули расширения/PCB.step
123.2 x 84.8 x 1.09 mm
