Rustik2044/MU-RK3576J-MB/Project/refdoc/RK3576_Reference_Schematics_Selection_Guide_V11_20240530.xlsx

RK3576 Reference SCH Select Instruction
REFERENCE SCH NAME | RK3576_AIOT_REF_SCH_V11_20240530.DSN | RK_TABLET_DEMO1_RK3576_LP4XD200P132SD6_V12_20230530.DSN | RK_EVB1_RK3576_LP4XD200P132SD6_V12_20240529.DSN
NOTE | RK3576 AIoT reference schematic, updated in time, compatible with low standby power consumption design. (RK3576 AIoT的总参考图，会及时更新，有考虑待机功耗设计) | With a battery solution, for reference only, will not be updated. (仅供参考，不会更新，带电池方案) | For reference only, will not be updated. (仅供参考，不会更新)
PCB NAME | NO reference PCB | RK_TABLET_DEMO1_RK3576_LP4XD200P132SD6_V12_20230530YWQ.brd | RK_EVB1_RK3576_LP4XD200P132SD6_V11_20240415YWQ.brd
PCB LAYERS |  | 6层 | 6层
POWER SOLUTIOIN | Single PMIC, RK806S-5+Discrete power supply | Single PMIC, RK806S-5+Discrete power supply | Single PMIC, RK806S-5+Discrete power supply
DDR | LPDDR4/LPDDR4X/LPDDR5 | LPDDR4/LPDDR4X | LPDDR4/LPDDR4X
FLASH | EMMC or UFS or SPI FLASH | UFS or EMMC FLASH | UFS or EMMC or SPI FLASH
TF CARD | 1 x Micro SD Card3.0 | 1 x Micro SD Card3.0 | 1 x Micro SD Card3.0
TYPEC INTERFACE | 1 x USB TYPEC with DP Alt Mode | 1 x USB TYPEC with DP Alt Mode | 1 x USB TYPEC with DP Alt Mode
USB INTERFACE | 1 x USB3.2 Gen1x1 HOST(USB2.0 from HUB) | 1 x USB2.0 HOST1 | 1 x USB3.2 Gen1x1 HOST1
 | 3 x USB2.0 HOST(USB2.0 HUB)
SATA30 | N/A | N/A | N/A
VIDEO OUT INTERFACE | 1 x LCM MIPI DSI TX (4Lane) | 1 x LCM MIPI DSI TX (4Lane) | 1 x LCM MIPI DSI TX (4Lane)
 | 1 x HDMI2.1 TX (Up to 4Kx2K@120Hz) | 1 x DP (From USB TYPEC) | 1 x HDMI2.1 TX (Up to 4Kx2K@120Hz)
 | 1 x DP (From USB TYPEC) |  | 1 x DP (From USB TYPEC)
VIDEO IN INTERFACE | 3 x CAM MIPI CSI RX (4Lane) | 1 x CAM MIPI DCPHY CSI RX (2Lanes) | 1 x CAM MIPI DCPHY CSI RX (4Lanes Need Ext Board)
 |  | 1 x CAM MIPI DPHY CSI RX (4Lanes) | 2 x CAM MIPI DPHY CSI RX (4Lanes Need Ext Board)
WIFI＋BT | 1 x a/b/g/n/ac/ax 2T2R SDIO WIFI6 + UART/PCM BT | 1 x a/b/g/n/ac/ax 2T2R PCIe WIFI6 + UART/PCM BT | 1 x a/b/g/n/ac/ax 2T2R PCIe WIFI6 + UART/PCM BT
RGMII | 2 x 10/100/1000M Ethernet | N/A | 2 x 10/100/1000M Ethernet
PCIE INTERFACE | 1 x PCIe Slot_36P (RC) | N/A | 1 x PCIe Slot_64P (Option with USB3.2 Gen1x1 HOST1)
AUDIO | 1 x CODEC，Support 1xHeadphone+2XSPK+1xAnalog MIC | 1 x CODEC，Support 1xHeadphone+2XSPK+1xAnalog MIC | 1 x CODEC，Support 1xHeadphone+2XSPK+1xAnalog MIC
 | 1 x SPDIF TX + 1 x SPDIF RX | 1 x MIC Connector | N/A
SENSOR | Gyroscope+G-sensor | Gyroscope+G-sensor | Gyroscope+G-sensor
OTHER INTERFACE | 1 x IR Receiver | N/A | 1 x IR Receiver + 1 x CAN(Option)
 | 1 x UART DEBUG | N/A | 1 x Debug UART to USB connector and 1 x JTAG Connector
SUITABLE FOR USE (适用产品方向) | Suitable for AIoT solution related application scenarios. (适用于AIoT方案相关应用场景产品) | Suitable for tablet-related application scenarios. (适用于平板相关应用场景产品) | N/A
Attention! | 1.EVB1 is provided solely as an auxiliary design reference, and EVB1 will not be updated. It is not recommended to directly use EVB1 for schematic and PCB reference design. 2.For products with battery, please refer to the RK3576 tablet Demo diagram. The Demo diagram will not be updated, and it is not recommended to directly use the Demo diagram for schematic and PCB reference design. 3.It is recommended to use the overall reference diagram "RK3576_AIOT_REF_SCH" for schematic design, and PCB design can refer to various DDR templates. 4.Do not use the schematic from the DDR Template as a reference for design (Note: In the schematic of the RK3576 DDR Template, the part numbers of various components in the DDR area are the same as those in the reference diagram for the (AIOT) product).
(注意事项!) | 1.EVB1仅做为辅助设计参考，EVB1不会更新，不建议直接使用EVB1进行原理图、PCB来参考设计。 2.带电池类的产品，请参考RK3576 tablet Demo图，Demo图不会更新，不建议直接使用Demo图进行原理图、PCB来参考设计。 3.图纸设计建义采用总参考图 “RK3576_AIOT_REF_SCH”，PCB设计可参考各种DDR模板。 4.不要以 DDR Template的原理图来参考展开设计（注：RK3576 DDR Template的原理图里，DDR区域的部分线路里各个器件的位号与（AIOT）产品的参考图是一样的）。
