Rustik2044/MU-RK3576J-MB/Project/refdoc/01_Common Document/RK3576_Power_Consumption_Test_Report_V1.0_20240520_EN.xlsx

Sheet: Cover
RK3576
Power Consumption Test Report
Revision: V1.0
Date: 2024/05/20
Status: Official Release
Rockchip Confidential

Sheet: Statement
保密提示： 本文档及其附件可能含有机密信息，来自瑞芯微电子股份有限公司，仅发送给指定接收者。若非该特定接收人，请勿复制、 使用或披露本文档的任何内容。若误收本文档，请从系统中永久性删除本文档，并以回复邮件或其他方式即刻告知发件人。瑞芯微电子股份有限公司拥有本文档信息的著作权及解释权，禁止任何未经授权许可的侵权行为。 IMPORTANT NOTICE: This document is from Rockchip Electronics Co., Ltd. .The contents of this document and any attachments may contain information that is privileged, confidential and/or exempt from disclosure under applicable law and relevant NDA. If you are not the intended recipient, you are hereby notified that any disclosure, copying, distribution, or use of the information is STRICTLY PROHIBITED. Please immediately contact the sender as soon as possible and destroy the material in its entirety in any format. Thank you.

Sheet: Revision History
Revision History
Revision Record
Revision | Description | Editor | Release Date
V0.1 | Draft | Wesley.Huang | 2024-03-19
V1.0 | (1) Update the power consumption data of Core Module; Extreme Current of VDD_LOG_S0 change to 2A; (2) Update the power consumption data of the tablet; (3) Add power consumption data for the NVR scenario; | Wesley.Huang | 2024-05-20

Sheet: RK3576 Tablet-AN
The Android Tablet scene power consumption of RK3576 |  | Mainboard： | RK3576_RK806S-5_TABLET |  | There is a reference for power comsumption data of OVERRALL based on various application scenes of the RK3576 tablet prototype. Reminder:The following is the test data on the RK3576 tablet prototype, which is for design reference only and does not represent the final capability of the chip. Due to a strong relationship between power comsumption and the actual application scenarios of the product, if you have a request for in-depth optimization, you can further discuss with RK technical support team.
 |  | Environment： | There is OVERRALL without back cover, heat sink, at 25℃ room temperature.
 |  | Configuration： | 8GB LPDDR4X+64GB EMMC
Scenes | Test Conditions |  | The power comsumption of OVERRALL (mW) | SOC Junction Temperature （℃） | VCC_BAT (without screen) |  | VDD_LOGIC_S0 |  | VDD_CPU_BIG_S0 |  | VDD_CPU_LIT_S0 |  | VDD_GPU_S0 |  | VDD_NPU_S0 |  | VDDQ_DDR_S0 |  | VDD_DDR_S0 |  | VDD2_DDR_S3 |  | VCC_3V3_S3 |  | VCC_1V8_S3 |  | VDDA_0V75_S0 |  | VCCA_1V8_S0 |  | VDDA_0V85_S0 |  | VDD_0V75_S3 |  | VDDA_DDR_PLL_S0 |  | VCCA_3V3_S0 |  | WIFI_VBAT
 |  |  |  |  | Voltage (V) | Average current (mA) | Voltage (V) | Average current (mA) | Voltage (V) | Average current (mA) | Voltage (V) | Average current (mA) | Voltage (V) | Average current (mA) | Voltage (V) | Average current (mA) | Voltage (V) | Average current (mA) | Voltage (V) | Average current (mA) | Voltage (V) | Average current (mA) | Voltage (V) | Average current (mA) | Voltage (V) | Average current (mA) | Voltage (V) | Average current (mA) | Voltage (V) | Average current (mA) | Voltage (V) | Average current (mA) | Voltage (V) | Average current (mA) | Voltage (V) | Average current (mA) | Voltage (V) | Average current (mA) | Voltage (V) | Average current (mA)
1 | Static Desktop |  | 372.37 | 36.00 | 3.887 | 95.8 | 0.725 | 89 | 0.7 | 15.1 | 0.697 | 18.4 | 0 | 0 | 0.725 | 1 | 0.609 | 9.3 | 0.721 | 52.6 | 1.093 | 23.3 | 3.293 | 1.3 | 1.801 | 6.4 | 0.743 | 28.8 | 1.798 | 26.6 | 0.843 | 4.9 | 0.745 | 2.8 | 0.846 | 2.3 | 3.309 | 0.2 | 3.294 | 0.3
2 | 1080P Video |  | 807.91 | 38.00 | 3.873 | 208.6 | 0.726 | 100.7 | 0.701 | 39.3 | 0.699 | 47.9 | 0 | 0 | 0.725 | 1.1 | 0.608 | 31.4 | 0.723 | 118.1 | 1.092 | 61 | 3.293 | 1.4 | 1.801 | 15.9 | 0.743 | 29.1 | 1.798 | 26.7 | 0.843 | 5 | 0.745 | 2.8 | 0.846 | 2.4 | 3.309 | 1.8 | 3.294 | 0.3
3 | 4K Video |  | 1089.65 | 41.00 | 3.864 | 282 | 0.75 | 160.1 | 0.7 | 34.8 | 0.698 | 49 | 0 | 0 | 0.725 | 1.3 | 0.608 | 47.7 | 0.725 | 314.9 | 1.092 | 83.2 | 3.293 | 1.4 | 1.801 | 17.4 | 0.743 | 28.5 | 1.798 | 28.5 | 0.843 | 5 | 0.745 | 2.9 | 0.846 | 3.9 | 3.309 | 1.8 | 3.294 | 0.3
4 | Wow Fish 3 |  | 1076.40 | 42.00 | 3.865 | 278.5 | 0.726 | 106.4 | 0.702 | 69 | 0.699 | 80.3 | 0.701 | 141.2 | 0.725 | 1.3 | 0.608 | 38.4 | 0.723 | 145 | 1.092 | 74.1 | 3.293 | 9.5 | 1.8 | 17.7 | 0.743 | 29 | 1.798 | 26.9 | 0.843 | 5.2 | 0.745 | 2.9 | 0.846 | 2.4 | 3.309 | 1.8 | 3.293 | 0.3
5 | Standby |  | 217.51 | 34.00 | 3.891 | 55.9 | 0.725 | 48.2 | 0.702 | 19.3 | 0.699 | 18.7 | 0 | 0 | 0.725 | 0.9 | 0.609 | 2 | 0.721 | 30.2 | 1.093 | 4.9 | 3.293 | 1.2 | 1.801 | 4.4 | 0.746 | 6.9 | 1.798 | 19.3 | 0.843 | 4.9 | 0.745 | 2.8 | 0.846 | 2.3 | 3.309 | 0.2 | 3.294 | 0.3
6 | Deep Standby |  | 15.21 | 25.00 | 3.899 | 3.9 | 0 | 0 | 0 | 0 | 0 | 0 | 0 | 0 | 0 | 0 | 0 | 0 | 0 | 0 | 1.094 | 3.2 | 3.298 | 0.3 | 1.802 | 3.2 | 0 | 0 | 0 | 0 | 0 | 0 | 0.746 | 0.3 | 0 | 0 | 0 | 0 | 3.298 | 0.3

Sheet: RK3576 NVR-Linux
The power comsumption of NVR－ordinary temperature
Environment: 55℃ incubator temperature,SOC Junction Temperature 87℃ Heat Dissipation: With heatsink, the heatsink dimensions are 38mm*38mm*15mm. Test Method: Record the power comsumption when EVB worked steadily and run for 15 mins. Operating Scenes: Dual Screen Display: 4K@30fps + 1080p@60fps 64-channel H264 D1 Decoding 16-channel NN Hard disk write: 320Mbits/s Both sets of Ethernet are operating with iperf3 NOTE: The following is the test data on the internal R&D board, which is for design reference only and does not represent the final capability of the chip. Due to a strong relationship between power comsumption and the actual application scenarios of the product, if you have a request for in-depth optimization, you can further discuss with technical support team. Some power supplies in the test data are not easy to be split due to combined power supply with peripherals, so only for estimates.
Power Level
1 | 2 | 3 | 4 | 5 | 6 | Voltage（V） | Avg current(mA) | Avg power consumption(mW) | Estimated avg power consumption of SOC(mW) | Max current(mA) | Max power consumption(mW) | Estimated max power consumption of SOC(mW) | 备注
 | VCC5V0_SYS_S3 |  |  |  |  | 5.003V | 1568.20mA | 7845.705mW | N/A | 2081.80mA | 10415.245mW
 |  | VDD_CPU_BIG_S0 |  |  |  | 0.900V | 1053.30mA | 947.970mW | 947.970mW | 2263.90mA | 2037.510mW | 2037.510mW
 |  | VDD_NPU_S0 |  |  |  | 0.772V | 969.30mA | 748.300mW | 748.300mW | 1981.50mA | 1529.718mW | 1529.718mW
 |  | VDD_CPU_LIT_S0 |  |  |  | 0.855V | 460.70mA | 393.898mW | 393.898mW | 906.70mA | 775.229mW | 775.229mW
 |  | VCC_3V3_S3 |  |  |  | 3.299V | 504.50mA | 1664.345mW | 166.435mW | 547.10mA | 1804.883mW | 180.488mW | Estimate by 10%
 |  | VDD_GPU_S0 |  |  |  | 0.854V | 490.90mA | 419.229mW | 419.229mW | 1826.70mA | 1560.002mW | 1560.002mW
 |  | VDDQ_DDR_S0 |  |  |  | 0.609V | 178.80mA | 108.889mW | 54.445mW | 217.10mA | 132.214mW | 66.107mW | Estimate by 50%
 |  | VDD_LOGIC_S0 |  |  |  | 0.758V | 557.50mA | 422.585mW | 422.585mW | 750.80mA | 569.106mW | 569.106mW
 |  | VCC_1V8_S3 |  |  |  | 1.796V | 67.70mA | 121.589mW | 60.795mW | 147.80mA | 265.449mW | 132.724mW | Estimate by 50%
 |  | VDD2_DDR_S3 |  |  |  | 1.095V | 405.00mA | 443.475mW | N/A | 472.90mA | 517.825mW | N/A | Only for LPDDR4x device
 |  | VDD_DDR_S0 |  |  |  | 0.815V | 876.50mA | 714.347mW | 714.347mW | 914.90mA | 745.643mW | 745.643mW
 |  | VCCA_3V3_S0 |  |  |  |  |  | 0.000mW | N/A |  | 0.000mW | N/A
 |  | VCCIO_SD_S0 |  |  |  |  |  | 0.000mW | N/A |  | 0.000mW | N/A
 |  | VCCA1V8_PLDO6_S3 |  |  |  |  |  | 0.000mW | N/A |  | 0.000mW | N/A
 |  | VCC_2V0_PLDO_S3
 |  |  | VCCA_1V8_S0 |  |  | 1.794V | 105.10mA | 188.549mW | 188.549mW | 112.30mA | 201.466mW | 201.466mW
 |  |  | VCCA1V8_PLDO2_S0 |  |  |  |  | 0.000mW | N/A |  | 0.000mW | 0.000mW
 |  |  | VDDA_1V2_S0 |  |  | 1.205V | 0.10mA | 0.121mW | 0.121mW | 0.50mA | 0.603mW | 0.603mW
 |  | VCC_1V1_NLDO_S3
 |  |  | VDD_0V75_S3 |  |  | 0.752V | 4.60mA | 3.459mW | 3.459mW | 4.90mA | 3.685mW | 3.685mW
 |  |  | VDDA_DDR_PLL_S0 |  |  | 0.852V | 7.60mA | 6.475mW | 6.475mW | 7.90mA | 6.731mW | 6.731mW
 |  |  | VDDA_0V75_HDMI_S0 |  |  | 0.840V | 60.90mA | 51.156mW | 51.156mW | 63.30mA | 53.172mW | 53.172mW
 |  |  | VDDA_0V85_S0 |  |  | 0.855V | 68.10mA | 58.225mW | 58.225mW | 76.50mA | 65.407mW | 65.407mW
 |  |  | VDDA_0V75_S0 |  |  | 0.755V | 25.40mA | 19.177mW | 19.177mW | 27.60mA | 20.838mW | 20.838mW
 |  |  |  |  |  |  |  | Average power consumption of SOC | 4255.166mW |  | Maximum power consumption of SOC | 7948.430mW

Sheet: Core-module & extreme current
RK3576 core module power consumption reference at different frequencies
RK3576 CPU_BIG |  |  |  |  |  | RK3576 GPU
Temperature: 20℃ Hardware configuration: RK3576_EVB1_LP4X_V10, 1080P-MIPI screen, 4G DDR memory, 256G EMMC Software configuration: Run: stressapptest -M 128 -s 10000 -W |  |  |  |  |  | 环Temperature: 28℃ Hardware configuration: RK3576_EVB1_LP4X_V10, 1080P-MIPI screen, 4G DDR memory, 256G EMMC Software configuration: Run RK internal GPU high-load tool：gl_retrace
Frequency （MHz） | DDR Frequency（Mhz） | VDD_CPU_BIG_S0 |  |  |  | Frequency （MHz） | DDR Frequency（Mhz） | VDD_GPU_S0
 |  | Avg voltage （mV) | Avg current (mA) |  |  |  |  | Avg voltage （mV) | Avg current (mA)
816 | 2112 | 0.675 | 570.30 |  |  | 600 | 2112 | 0.683 | 748.10
1800 | 2112 | 0.777 | 1268.20 |  |  | 800 | 2112 | 0.76 | 1001.40
2304 | 2112 | 0.929 | 1776.20 |  |  | 950 | 2112 | 0.838 | 1246.30
RK3576 CPU_LIT |  |  |  |  |  | RK3576 NPU
Temperature: 20℃ Hardware configuration: RK3576_EVB1_LP4X_V10, 1080P-MIPI screen, 4G DDR memory, 256G EMMC Software configuration: Run: stressapptest -M 128 -s 10000 -W |  |  |  |  |  | Temperature: 24℃ Hardware configuration: RK3576_EVB1_LP4X_V10, 1080P-MIPI screen, 4G DDR memory, 256G EMMC Software configuration: Run RK internal NPU high-load tool: rknn_stress_test cfg/vgg16_max_pool_fp16.cfg 10000 2
Frequency （MHz） | DDR Frequency（Mhz） | CPU_LIT_S0 |  |  |  | Frequency （MHz） | DDR Frequency （Mhz） | NPU frame rate | VDD_NPU_S0
 |  | Avg voltage （mV) | Avg current (mA) |  |  |  |  |  | Avg voltage （mV) | Avg current (mA)
816 | 2112 | 0.67 | 364.30 |  |  | 600 | 2112 | 14.6/14.5 | 0.679 | 1002.10
1800 | 2112 | 0.785 | 711.90 |  |  | 800 | 2112 | 19/18.6 | 0.731 | 1404.40
2208 | 2112 | 0.899 | 917.60 |  |  | 1000 | 2112 | 21.7/21.3 | 0.821 | 1818.50
The Extreme Current of RK3576 Core Module Reference
Environment: 25℃ Heat Dissipation:Bare board without heat sink Test Method:Record the power comsumption when EVB worked steadily and run for 15 mins. Operating Scenes:The test result of extreme current of different modules are based on rescpective extreme scenarios.The following is just for reference. Reminder:The following is the test data on the internal R&D board, which is for reference only and does not represent the actual capability of the chip. Due to a strong relationship between power comsumption and the actual application scenarios of the product, if you have a request for in-depth optimization, you can further discuss with technical support team.
The Extreme Current of Core Module | Power Network | Voltage (V) | Peak Current （A） | Peak Power (W) | NOTE
 | VDD_CPU_BIG_S0 | 0.950 | 4.00 | 3.80 | Frequency 2300MHz
 | VDD_CPU_LIT_S0 | 0.900 | 2.00 | 1.80 | Frequency 2200MHz
 | VDD_LOG_S0 | 0.750 | 2.00 | 1.50
 | VDD_GPU_S0 | 0.850 | 3.00 | 2.55 | Frequency 950MHz
 | VDD_NPU_S0 | 0.800 | 4.00 | 3.20 | Frequency 1000MHz
 | VDD_DDR_S0 | 0.850 | 2.00 | 1.70 | Frequency 2133MHz

Sheet: Chip thermal characteristics
Heat Dissipation Design Suggestions
1. RK3576 is FCCSP698L 16.1*17.2 package.
2. The heat dissipation design is generally considered based on the average power consumption, and does not consider the peak power in a very short time (ms level)
3. The thermal design power (TPD) of the RK3576 chip limitation is considered as 10W (special scenes need to be constructed, without considering the bandwidth conflicts during actual calls).It is recommended that if the structural space and cost are appropriate, sufficient heat dissipation design can be carried out in 10W TPD.
4. For limited products, heat dissipation design can be considered according to the actual application environment and scenarios. For example, NVR products with back-end AI processing are considered as >=6W, and ordinary tablets are considered as >=4W. The specific situation depends on the customer's choice.
5. The standard SDK software has a thermal management strategy. When the temperature is too high, the frequency and voltage will be reduced to ensure that the junction temperature of the chip does not exceed the tolerance limit. So if the heat dissipation is too poor, it will affect the product performance.
