Rustik2044/MU-RK3576J-MB/Project/refdoc/03_Product Line Branch_AIoT/03_Reference Design/01_RK3576_AIoT_REF_SCH/RK3576_AIOT_REF_SCH_V11_20240530.pdf

# Main Functions Introduction

# REF Schematic for RK3576

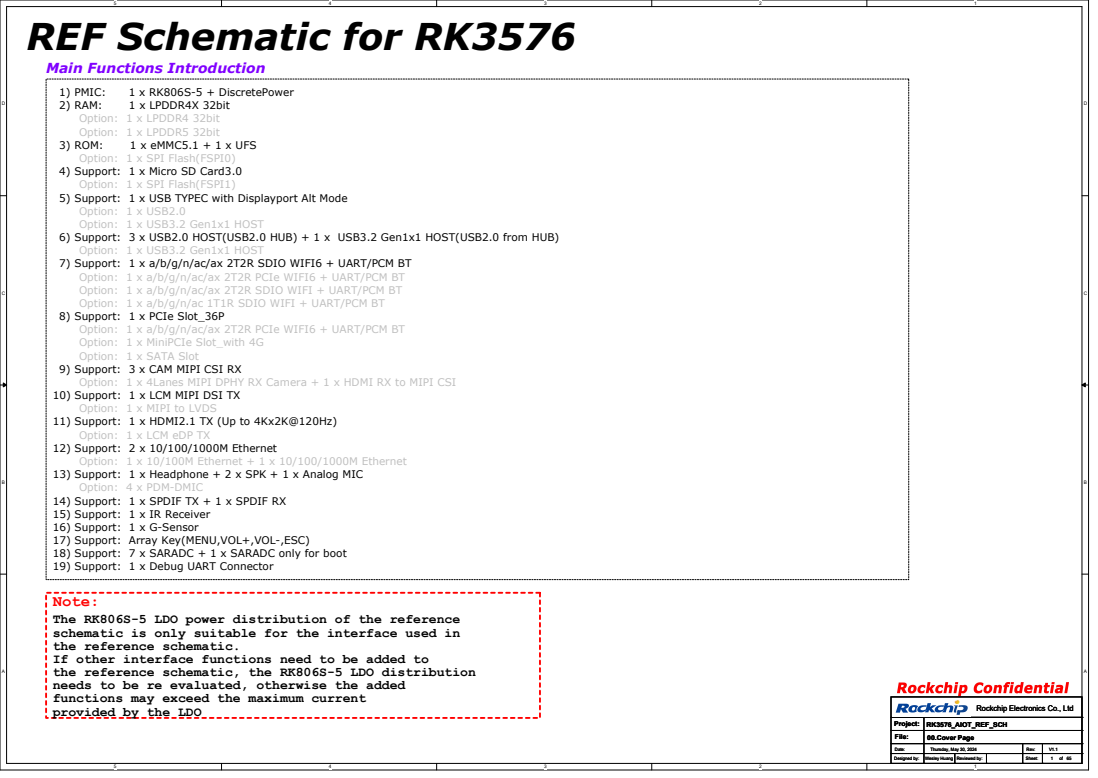
[picture p3: page 1]
2) RAM:; 1 x LPDDR4X 32bit; 1) PMIC:; 1 x RK806S-5 + DiscretePower; 3) ROM:; 1 x eMMC5.1 + 1 x UFS; Project:; File: Date:; Rockchip Electronics Co., Ltd Designed by:; Rev: Reviewed by:; Sheet:; of Thursday, May 30, 2024; 00.Cover Page; RK3576_AIOT_REF_SCH Wesley Huang; 65 V1.1 Project:

Option: 1 x LPDDR4 32bit
Option: 1 x LPDDR5 32bit
Option: 1 x SPI Flash(FSPI0)
4) Support: 1 x Micro SD Card3.0
Option: 1 x SPI Flash(FSPI1)
5) Support: 1 x USB TYPEC with Displayport Alt Mode
Option: 1 x USB2.0
Option: 1 x USB3.2 Gen1x1 HOST
6) Support: 3 x USB2.0 HOST(USB2.0 HUB) + 1 x USB3.2 Gen1x1 HOST(USB2.0 from HUB)
7) Support: 1 x a/b/g/n/ac/ax 2T2R SDIO WIFI6 + UART/PCM BT
Option: 1 x a/b/g/n/ac/ax 2T2R PCIe WIFI6 + UART/PCM BT
Option: 1 x a/b/g/n/ac/ax 2T2R SDIO WIFI + UART/PCM BT
Option: 1 x a/b/g/n/ac 1T1R SDIO WIFI + UART/PCM BT
8) Support: 1 x PCIe Slot_36P
Option: 1 x MiniPCIe Slot_with 4G
Option: 1 x SATA Slot
9) Support: 3 x CAM MIPI CSI RX
Option: 1 x 4Lanes MIPI DPHY RX Camera + 1 x HDMI RX to MIPI CSI
10) Support: 1 x LCM MIPI DSI TX
Option: 1 x MIPI to LVDS
11) Support: 1 x HDMI2.1 TX (Up to 4Kx2K@120Hz)
Option: 1 x LCM eDP TX
12) Support: 2 x 10/100/1000M Ethernet
Option: 1 x 10/100M Ethernet + 1 x 10/100/1000M Ethernet
13) Support: 1 x Headphone + 2 x SPK + 1 x Analog MIC
Option: 4 x PDM-DMIC
14) Support: 1 x SPDIF TX + 1 x SPDIF RX
15) Support: 1 x IR Receiver
16) Support: 1 x G-Sensor
17) Support: Array Key(MENU,VOL+,VOL-,ESC)
18) Support: 7 x SARADC + 1 x SARADC only for boot
19) Support: 1 x Debug UART Connector
Note:
The RK806S-5 LDO power distribution of the reference
schematic is only suitable for the interface used in
the reference schematic.
If other interface functions need to be added to
the reference schematic, the RK806S-5 LDO distribution
needs to be re evaluated, otherwise the added
functions may exceed the maximum current
provided by the LDO

# Table of Content

# Description

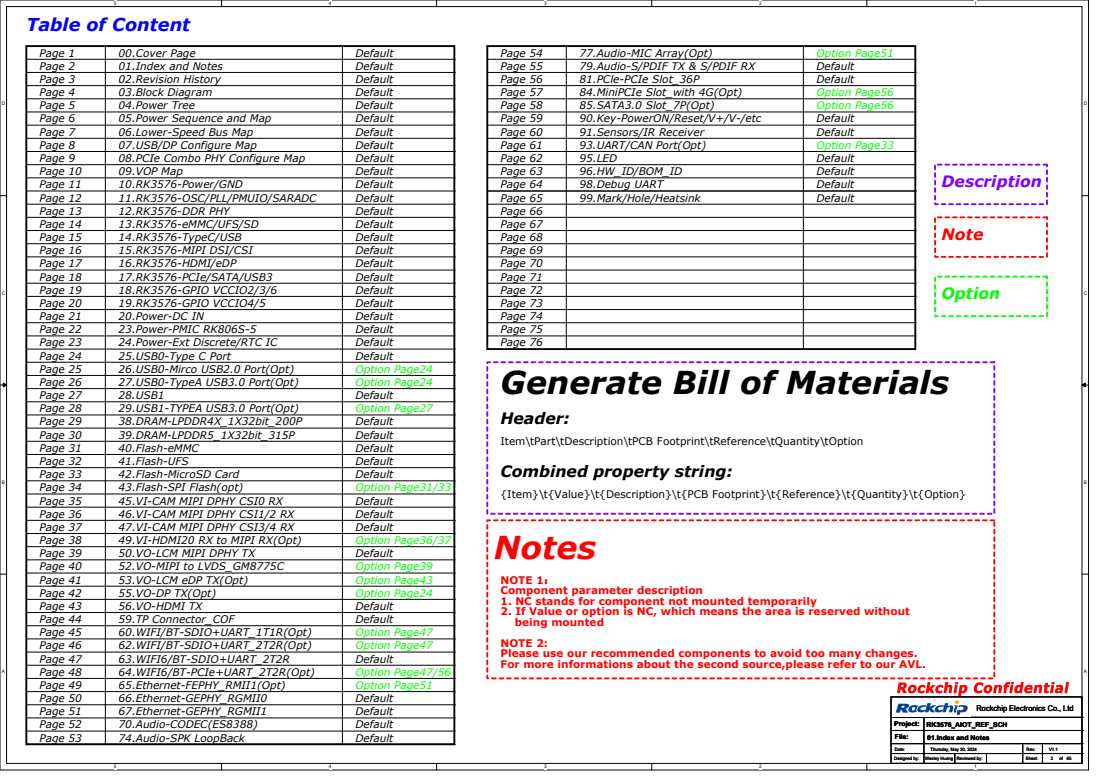
[picture p4: page 2]
Header:; Note; Option; Page 69; Page 3; Default; Option Page24; Page 36; 07.USB/DP Configure Map; Option Page33; Page 2; Page 1; 00.Cover Page; Page 54; 56.VO-HDMI TX; 01.Index and Notes; Page 55; Page 4; 02.Revision History; Page 56; 03.Block Diagram; Page 57; Page 5; 04.Power Tree; Page 58; Page 6; 05.Power Sequence and Map; Page 59; Page 7; 06.Lower-Speed Bus Map; Page 60; Page 8; Page 61; Page 9; Page 62; Page 10; Page 63; Page 11; Page 64; Page 12; Page 65; Page 13; Page 66; Page 14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

81.PCle-PCIe Slot_36P
84.MiniPCIe Slot_with 4G(Opt)
85.SATA3.0 Slot_7P(Opt)
90.Key-PowerON/Reset/V+/V-/etc
91.Sensors/IR Receiver
93.UART/CAN Port(Opt)
95.LED
96.HW_ID/BOM_ID
98.Debug UART
99.Mark/Hole/Heatsink

08.PCIe Combo PHY Configure Map
09.VOP Map
10.RK3576-Power/GND
11.RK3576-OSC/PLL/PMUIO/SARADC
12.RK3576-DDR PHY
13.RK3576-eMMC/UFS/SD
14.RK3576-TypeC/USB
15.RK3576-MIPI DSI/CSI
16.RK3576-HDMI/eDP
17.RK3576-PCIe/SATA/USB3
18.RK3576-GPIO VCCIO2/3/6
19.RK3576-GPIO VCCIO4/5
20.Power-DC IN
23.Power-PMIC RK806S-5
24.Power-Ext Discrete/RTC IC
25.USB0-Type C Port
26.USB0-Mirco USB2.0 Port(Opt)
27.USB0-TypeA USB3.0 Port(Opt)

Generate Bill of Materials

Item\tPart\tDescription\tPCB Footprint\tReference\tQuantity\tOption
Combined property string:
Notes

43.Flash-SPI Flash(opt)
46.VI-CAM MIPI DPHY CSI1/2 RX
47.VI-CAM MIPI DPHY CSI3/4 RX
49.VI-HDMI20 RX to MIPI RX(Opt)

{Item}\t{Value}\t{Description}\t{PCB Footprint}\t{Reference}\t{Quantity}\t{Option}

55.VO-DP TX(Opt)
63.WIFI6/BT-SDIO+UART_2T2R
64.WIFI6/BT-PCIe+UART_2T2R(Opt)
65.Ethernet-FEPHY_RMII1(Opt)
66.Ethernet-GEPHY_RGMII0
67.Ethernet-GEPHY_RGMII1
70.Audio-CODEC(ES8388)
74.Audio-SPK LoopBack

NOTE 1：
Component parameter description
1. NC stands for component not mounted temporarily
2. If Value or option is NC, which means the area is reserved without
being mounted
NOTE 2:
Please use our recommended components to avoid too many changes.
For more informations about the second source,please refer to our AVL.

# Revision History

Version | Date | By | Change Dsecription | Approved

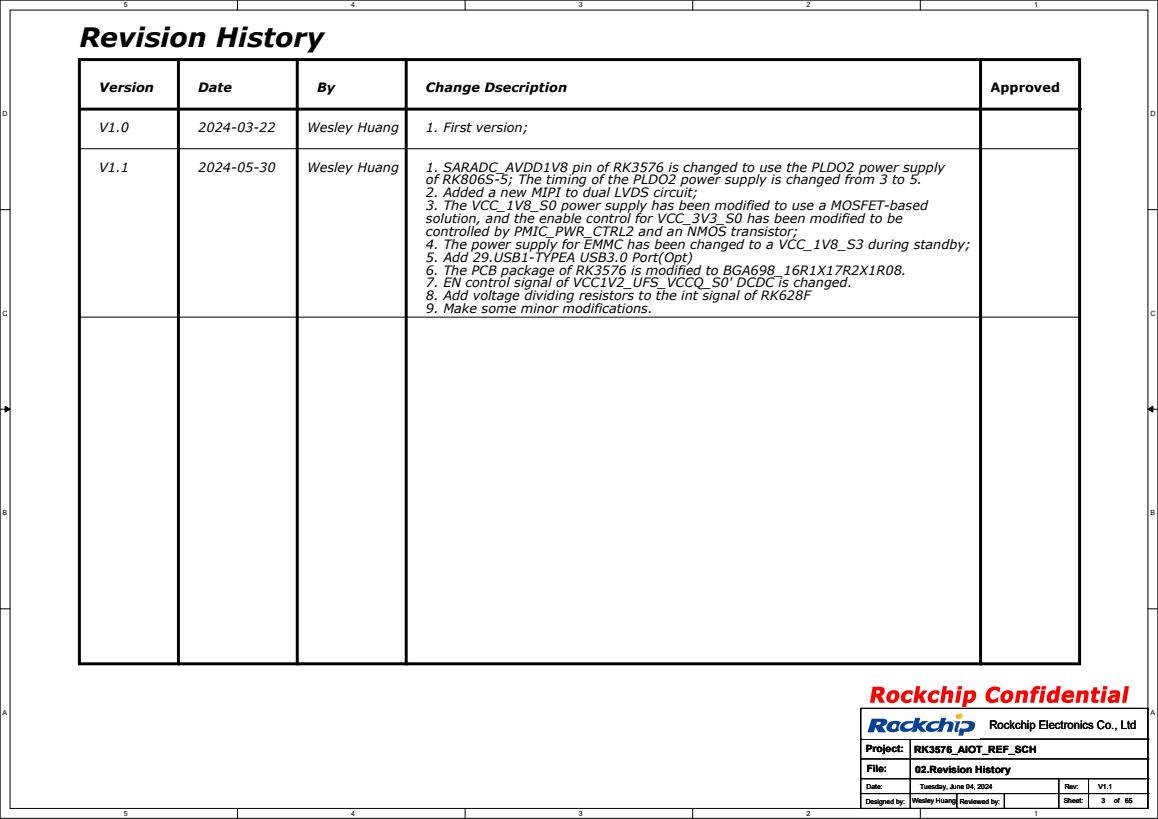
[picture p5: page 3]
Wesley Huang; 1. First version;; 1. SARADC_AVDD1V8 pin of RK3576 is changed to use the PLDO2 power supply; Project:; File: Date:; Rockchip Electronics Co., Ltd; Designed by:; Rev: Reviewed by:; Sheet:; of Tuesday, June 04, 2024; 02.Revision History; RK3576_AIOT_REF_SCH; 65 V1.1 Project:

of RK806S-5; The timing of the PLDO2 power supply is changed from 3 to 5.
2. Added a new MIPI to dual LVDS circuit;
3. The VCC_1V8_S0 power supply has been modified to use a MOSFET-based
solution, and the enable control for VCC_3V3_S0 has been modified to be
controlled by PMIC_PWR_CTRL2 and an NMOS transistor;
4. The power supply for EMMC has been changed to a VCC_1V8_S3 during standby;
5. Add 29.USB1-TYPEA USB3.0 Port(Opt)
6. The PCB package of RK3576 is modified to BGA698_16R1X17R2X1R08.
7. EN control signal of VCC1V2_UFS_VCCQ_S0' DCDC is changed.
8. Add voltage dividing resistors to the int signal of RK628F
9. Make some minor modifications.

RK3576

# HDMI2.1 TX

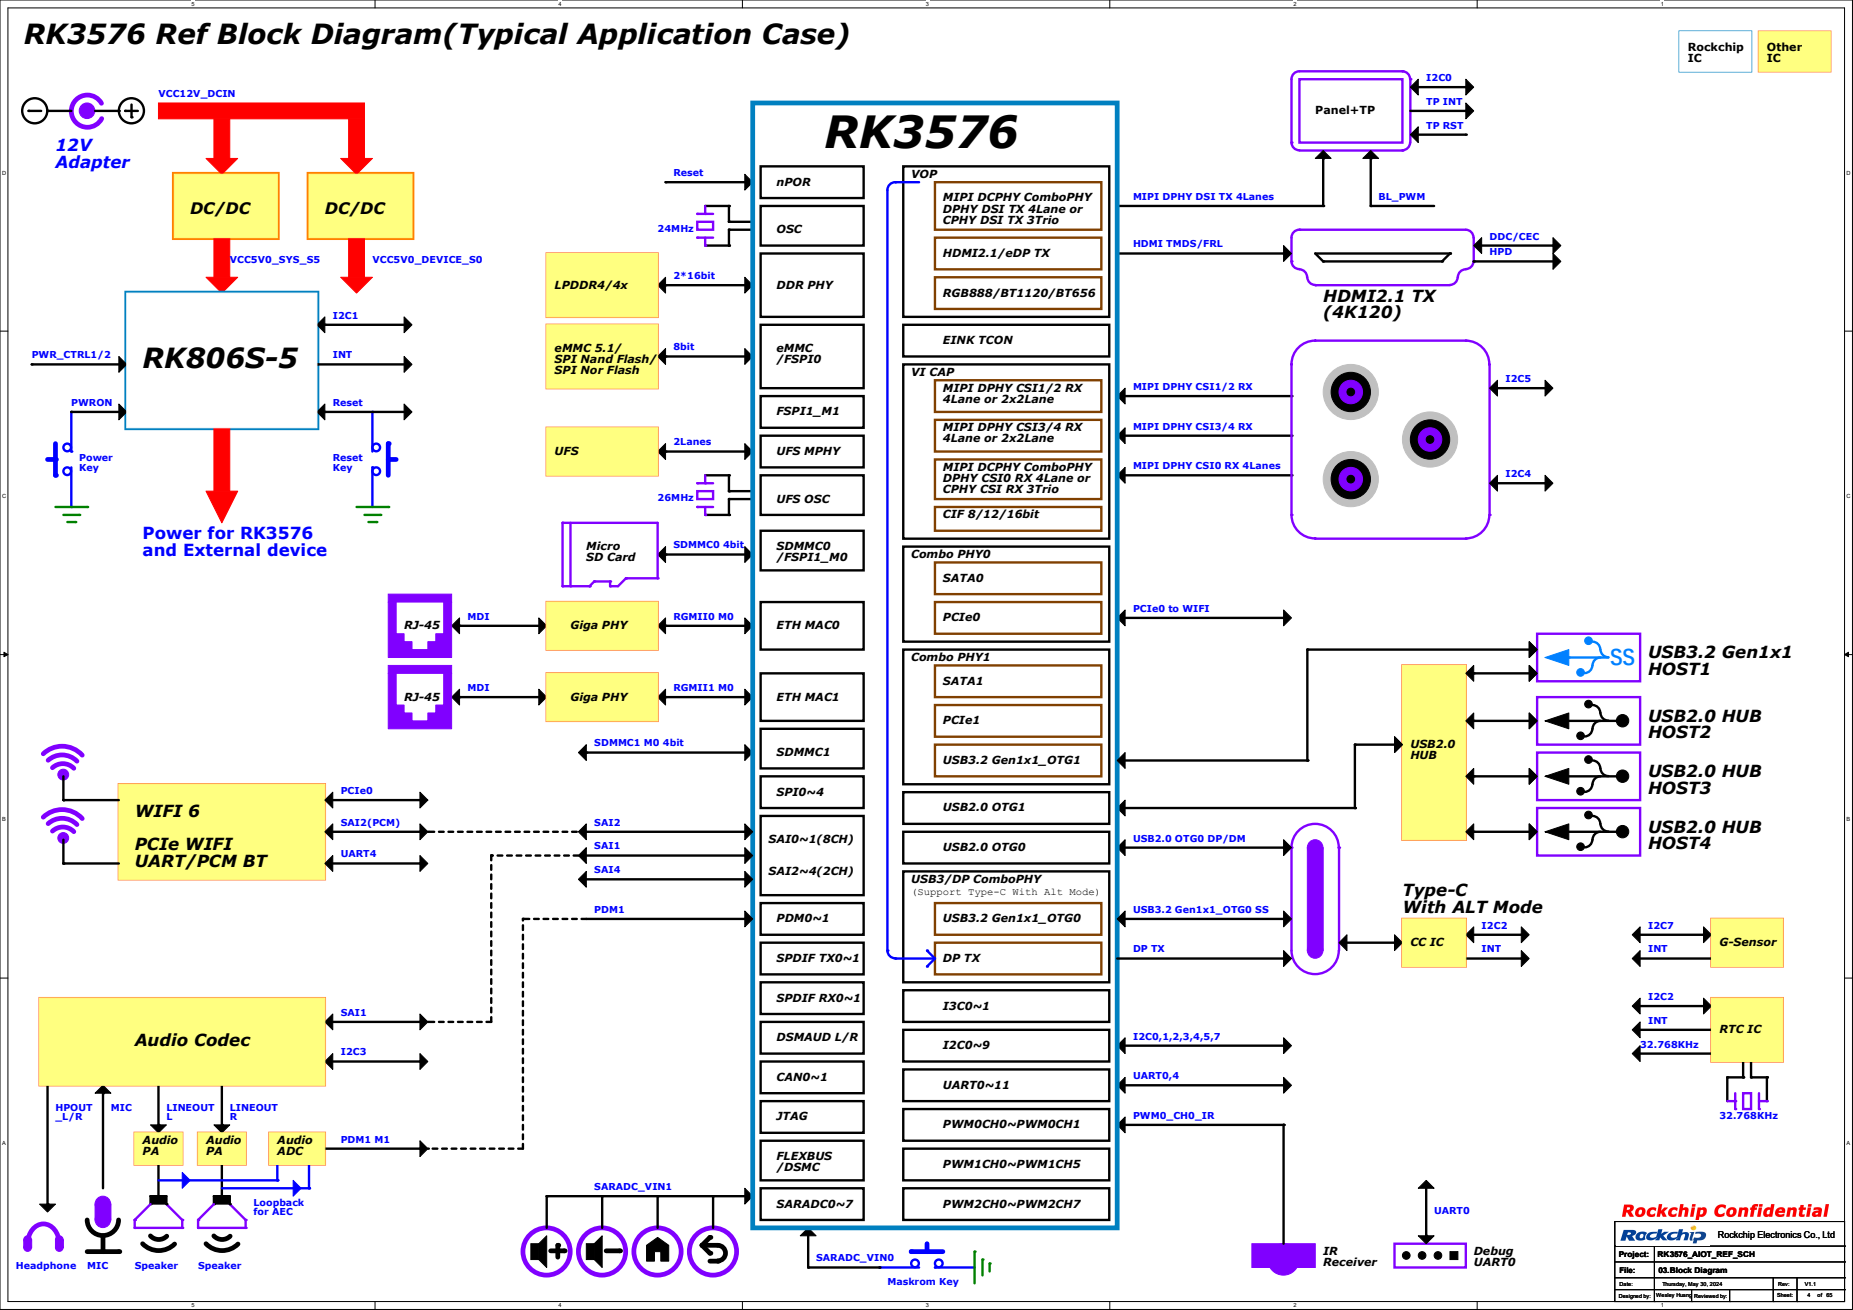
[picture p6: page 4]
nPOR; 24MHz; OSC; LPDDR4/4x; DDR PHY; eMMC /FSPI0; FSPI1_M1; UFS; UFS MPHY; 26MHz; UFS OSC; SDMMC0 /FSPI1_M0; Micro SD Card; 2*16bit; 8bit; 2Lanes; SDMMC0 4bit; ETH MAC0; RGMII0 M0; ETH MAC1; Giga PHY; MDI; RGMII1 M0; SPI0~4; SAI0~1(8CH); SAI2~4(2CH); PDM0~1; SPDIF TX0~1; SPDIF RX0~1; CAN0~1; UART0~11; JTAG; DSMAUD L/R; SARADC0~7; FLEXBUS /DSMC; PWM0CH0~PWM0CH1; PWM1CH0~PWM1CH5; PWM2CH0~PWM2CH7; PCIe0; USB3.2 Gen1x1_OTG1; USB2.0 OTG0; SATA1; USB3/DP ComboPHY; CIF 8/12/16bit; Combo PHY0; PCIe1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

RK3576 Ref Block Diagram(Typical Application Case)

VOP
MIPI DCPHY ComboPHY
DPHY DSI TX 4Lane or
CPHY DSI TX 3Trio

MIPI DPHY DSI TX 4Lanes

HDMI TMDS/FRL

eMMC 5.1/
SPI Nand Flash/
SPI Nor Flash

VI CAP
MIPI DPHY CSI1/2 RX
4Lane or 2x2Lane

MIPI DPHY CSI3/4 RX

DPHY CSI0 RX 4Lane or
CPHY CSI RX 3Trio

MIPI DPHY CSI0 RX 4Lanes

Power for RK3576
and External device

WIFI 6
PCIe WIFI
UART/PCM BT

Type-C
With ALT Mode

# Default Power Tree

3000mA

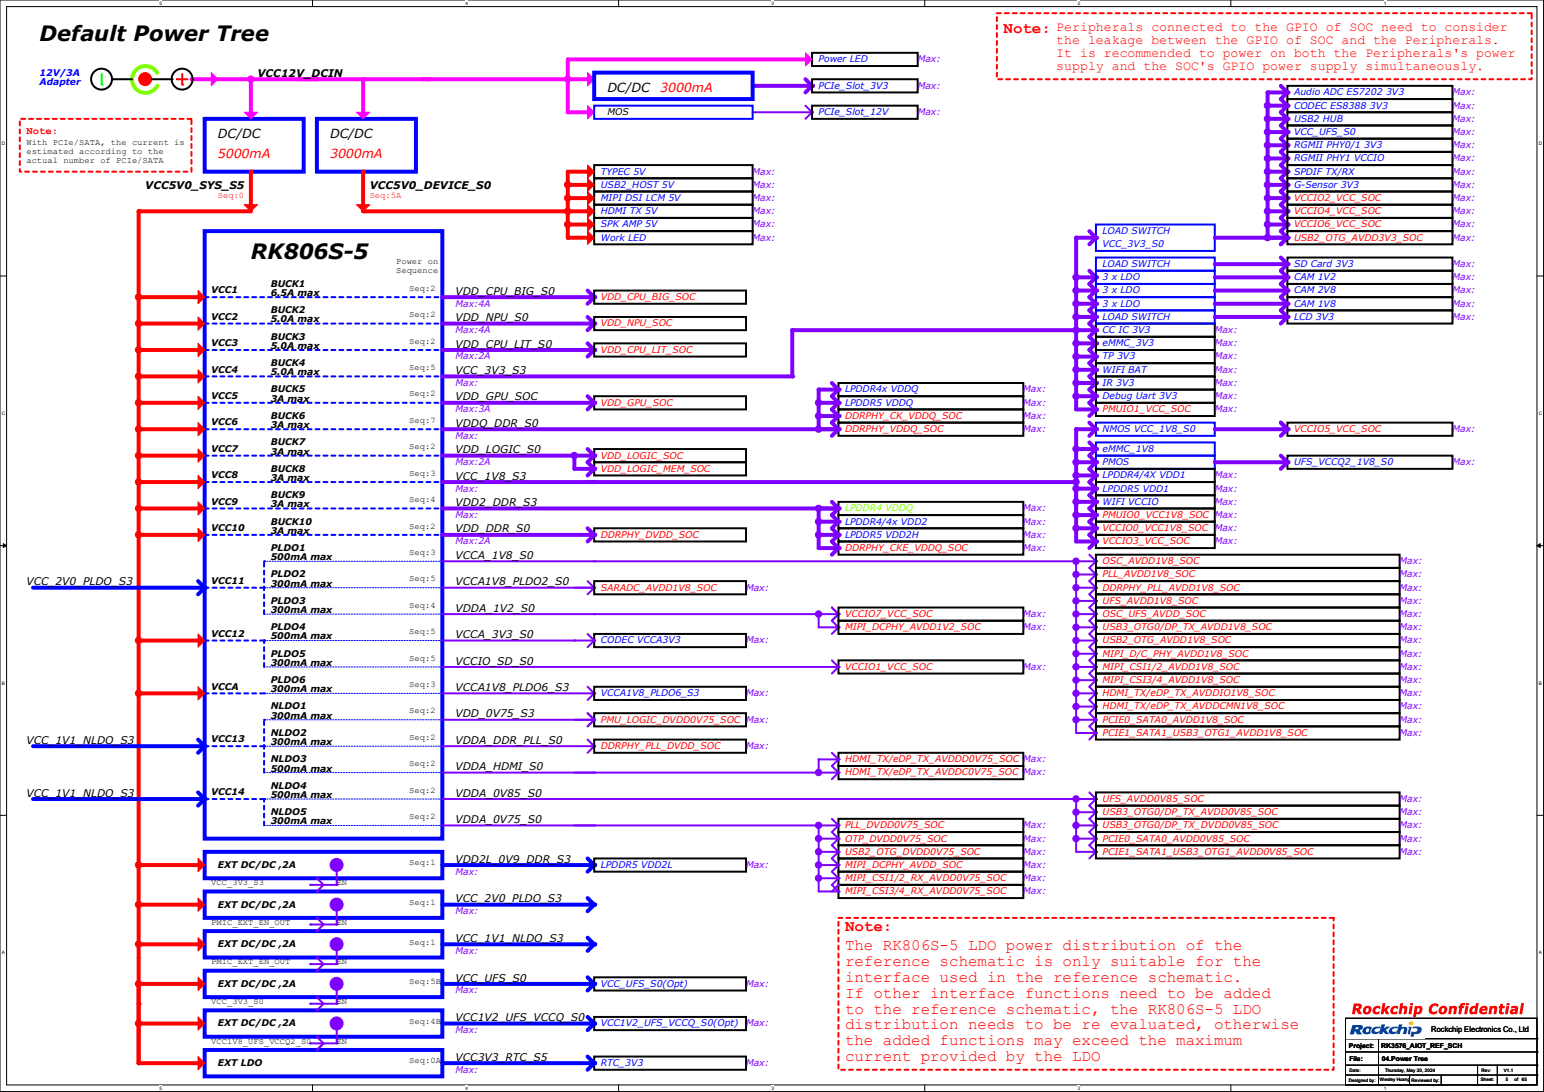
[picture p7: page 5]
12V/3A Adapter; VCC12V_DCIN; Seq:5A; VCC5V0_DEVICE_S0; MOS; PCIe_Slot_12V; actual number of PCIe/SATA; VCC5V0_SYS_S5; Power on; Sequence; Seq:2; Seq:5; VCC1; BUCK3 5.0A max; BUCK4 5.0A max; BUCK1 6.5A max; VCC2; BUCK2; 5.0A max; VCC3; VCC4; Seq:7; VCC5; BUCK7 3A max; BUCK8 3A max; BUCK5 3A max; VCC6; BUCK6; 3A max; VCC7; VCC8; Seq:4 BUCK9 VCC9; Seq:2 BUCK10 VCC10; Seq:3; Seq:4; PLDO1 500mA max; VCC11; PLDO2; 300mA max; PLDO3; VCC12; PLDO4; 500mA max; PLDO5 300mA max; VCCA; Seq:3 PLDO6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

Note: Peripherals connected to the GPIO of SOC need to consider

the leakage between the GPIO of SOC and the Peripherals.
It is recommended to power on both the Peripherals's power
supply and the SOC's GPIO power supply simultaneously.

Note: With PCIe/SATA, the current is

DC/DC Seq:0

estimated according to the

TYPEC 5V
USB2_HOST 5V
MIPI DSI LCM 5V
HDMI TX 5V
SPK AMP 5V
Work LED

PLL_DVDD0V75_SOC
OTP_DVDD0V75_SOC
USB2_OTG_DVDD0V75_SOC
MIPI_DCPHY_AVDD_SOC
MIPI_CSI1/2_RX_AVDD0V75_SOC
MIPI_CSI3/4_RX_AVDD0V75_SOC
Note:
The RK806S-5 LDO power distribution of the
reference schematic is only suitable for the
interface used in the reference schematic.
If other interface functions need to be added
to the reference schematic, the RK806S-5 LDO
distribution needs to be re evaluated, otherwise
the added functions may exceed the maximum
current provided by the LDO

| Power description
Power Supply | PMIC Channel | Supply Limit | Power Name | Time Slot | Default Voltage | Default ON/OFF | Work Voltage | Peak Current | Sleep Current

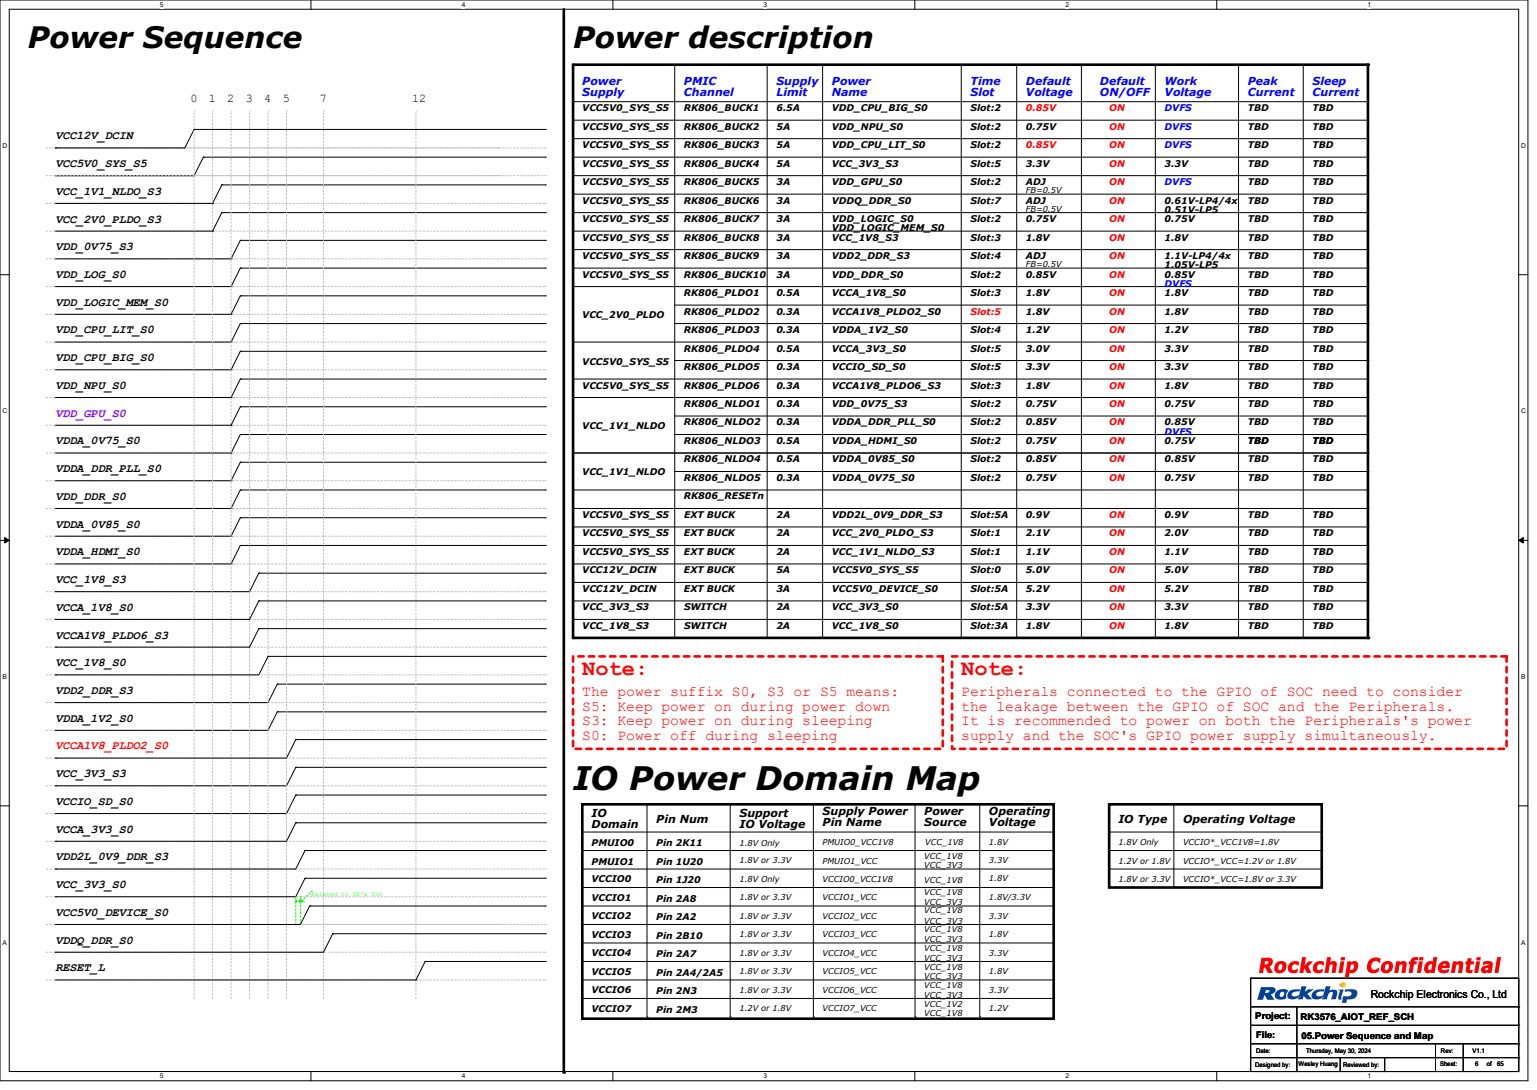
[picture p8: page 6]
DVFS; Slot:2; RK806_BUCK3; TBD; VCC5V0_SYS_S5; RK806_NLDO1; Supply Power Pin Num; Pin Name; PMUIO0; Operating Voltage; Power Source; Support IO Voltage; Pin 2K11; PMUIO1; VCCIO0; VCCIO2; VCCIO3; VCCIO4; VCCIO5; VCCIO6; 1.8V Only; VDD_0V75_S3; VCC_3V3_S3; VCCIO_SD_S0; VDD_CPU_BIG_S0; VCC12V_DCIN; Power Sequence; VCC_1V1_NLDO_S3; VCC_2V0_PLDO_S3; VDD_LOG_S0; VDDA_DDR_PLL_S0; VDDA_HDMI_S0; VDDA_0V75_S0; VDDA_0V85_S0; VDD_DDR_S0; VCC_1V8_S3; VDD2_DDR_S3; VDDA_1V2_S0; VDD_CPU_LIT_S0; VDD_NPU_S0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

VCC5V0_SYS_S5 | RK806_BUCK1 | 6.5A | VDD_CPU_BIG_S0 | Slot:2 | 0.85V | ON | DVFS | TBD | TBD
VCC5V0_SYS_S5 | RK806_BUCK2 | 5A | VDD_NPU_S0 | Slot:2 | 0.75V | ON | DVFS | TBD | TBD

VCC5V0_SYS_S5 | RK806_BUCK4 | 5A | VCC_3V3_S3 | Slot:5 | 3.3V | ON | 3.3V | | TBD
VCC5V0_SYS_S5 | RK806_BUCK5 | 3A | VDD_GPU_S0 | Slot:2 | ADJ FB=0.5V | ON | DVFS | | TBD
VCC5V0_SYS_S5 | RK806_BUCK6 | 3A | VDDQ_DDR_S0 | Slot:7 | ADJ FB=0.5V | ON | 0.61V-LP4/4x 0.51V-LP5 | | TBD
VCC5V0_SYS_S5 | RK806_BUCK7 | 3A | VDD_LOGIC_S0 VDD_LOGIC_MEM_S0 | Slot:2 | 0.75V | ON | 0.75V | TBD | TBD
VCC5V0_SYS_S5 | RK806_BUCK8 | 3A | VCC_1V8_S3 | Slot:3 | 1.8V | ON | 1.8V | TBD | TBD
VCC5V0_SYS_S5 | RK806_BUCK9 | 3A | VDD2_DDR_S3 | Slot:4 | ADJ FB=0.5V | ON | 1.1V-LP4/4x 1.05V-LP5 | | TBD
VCC5V0_SYS_S5 | RK806_BUCK10 | 3A | VDD_DDR_S0 | Slot:2 | 0.85V | ON | 0.85V DVFS | TBD | TBD
VCC_2V0_PLDO | RK806_PLDO1 | 0.5A | VCCA_1V8_S0 | Slot:3 | 1.8V | ON | 1.8V | TBD | TBD

RK806_PLDO2 | 0.3A | VCCA1V8_PLDO2_S0 | Slot:5 | 1.8V | ON | 1.8V | | TBD
RK806_PLDO3 | 0.3A | VDDA_1V2_S0 | Slot:4 | 1.2V | ON | 1.2V | TBD | TBD

VCC5V0_SYS_S5 | RK806_PLDO4 | 0.5A | VCCA_3V3_S0 | Slot:5 | 3.0V | ON | 3.3V | | TBD

RK806_PLDO5 | 0.3A | VCCIO_SD_S0 | Slot:5 | 3.3V | ON | 3.3V | TBD | TBD

VCC5V0_SYS_S5 | RK806_PLDO6 | 0.3A | VCCA1V8_PLDO6_S3 | Slot:3 | 1.8V | ON | 1.8V | TBD | TBD

RK806_NLDO2 | 0.3A | VDDA_DDR_PLL_S0 | Slot:2 | 0.85V | | 0.85V ON DVFS | TBD | TBD
RK806_NLDO3 | 0.5A | | Slot:2 | 0.75V VDDA_HDMI_S0 | | 0.75V | TBD | TBD TBD ON

VCC_1V1_NLDO | RK806_NLDO4 | 0.5A | VDDA_0V85_S0 | Slot:2 | 0.85V | ON | 0.85V | TBD | TBD

RK806_NLDO5 | 0.3A | VDDA_0V75_S0 | Slot:2 | 0.75V | ON | 0.75V | TBD | TBD
RK806_RESETn

VCC5V0_SYS_S5 | EXT BUCK | 2A | | Slot:5A | 0.9V VDD2L_0V9_DDR_S3 | ON | 0.9V | TBD | TBD
VCC5V0_SYS_S5 | EXT BUCK | 2A | VCC_2V0_PLDO_S3 | Slot:1 | 2.1V | ON | 2.0V | TBD | TBD
VCC5V0_SYS_S5 | EXT BUCK | 2A | VCC_1V1_NLDO_S3 | | 1.1V | ON | 1.1V Slot:1 | TBD | TBD
VCC12V_DCIN | EXT BUCK | 5A | VCC5V0_SYS_S5 | Slot:0 | 5.0V | ON | 5.0V | TBD | TBD
VCC12V_DCIN | EXT BUCK | 3A | VCC5V0_DEVICE_S0 | Slot:5A | 5.2V | ON | 5.2V | TBD | TBD
VCC_3V3_S3 | SWITCH | 2A | VCC_3V3_S0 | Slot:5A | 3.3V | | 3.3V | TBD | TBD ON
VCC_1V8_S3 | SWITCH | 2A | VCC_1V8_S0 | Slot:3A | 1.8V | | 1.8V | TBD | TBD ON

Note:
The power suffix S0, S3 or S5 means:
S5: Keep power on during power down
S3: Keep power on during sleeping
S0: Power off during sleeping
IO Power Domain Map

Peripherals connected to the GPIO of SOC need to consider
the leakage between the GPIO of SOC and the Peripherals.
It is recommended to power on both the Peripherals's power
supply and the SOC's GPIO power supply simultaneously.

Related to SW's Ton

05.Power Sequence and Map

# I2C MAP

RK3576

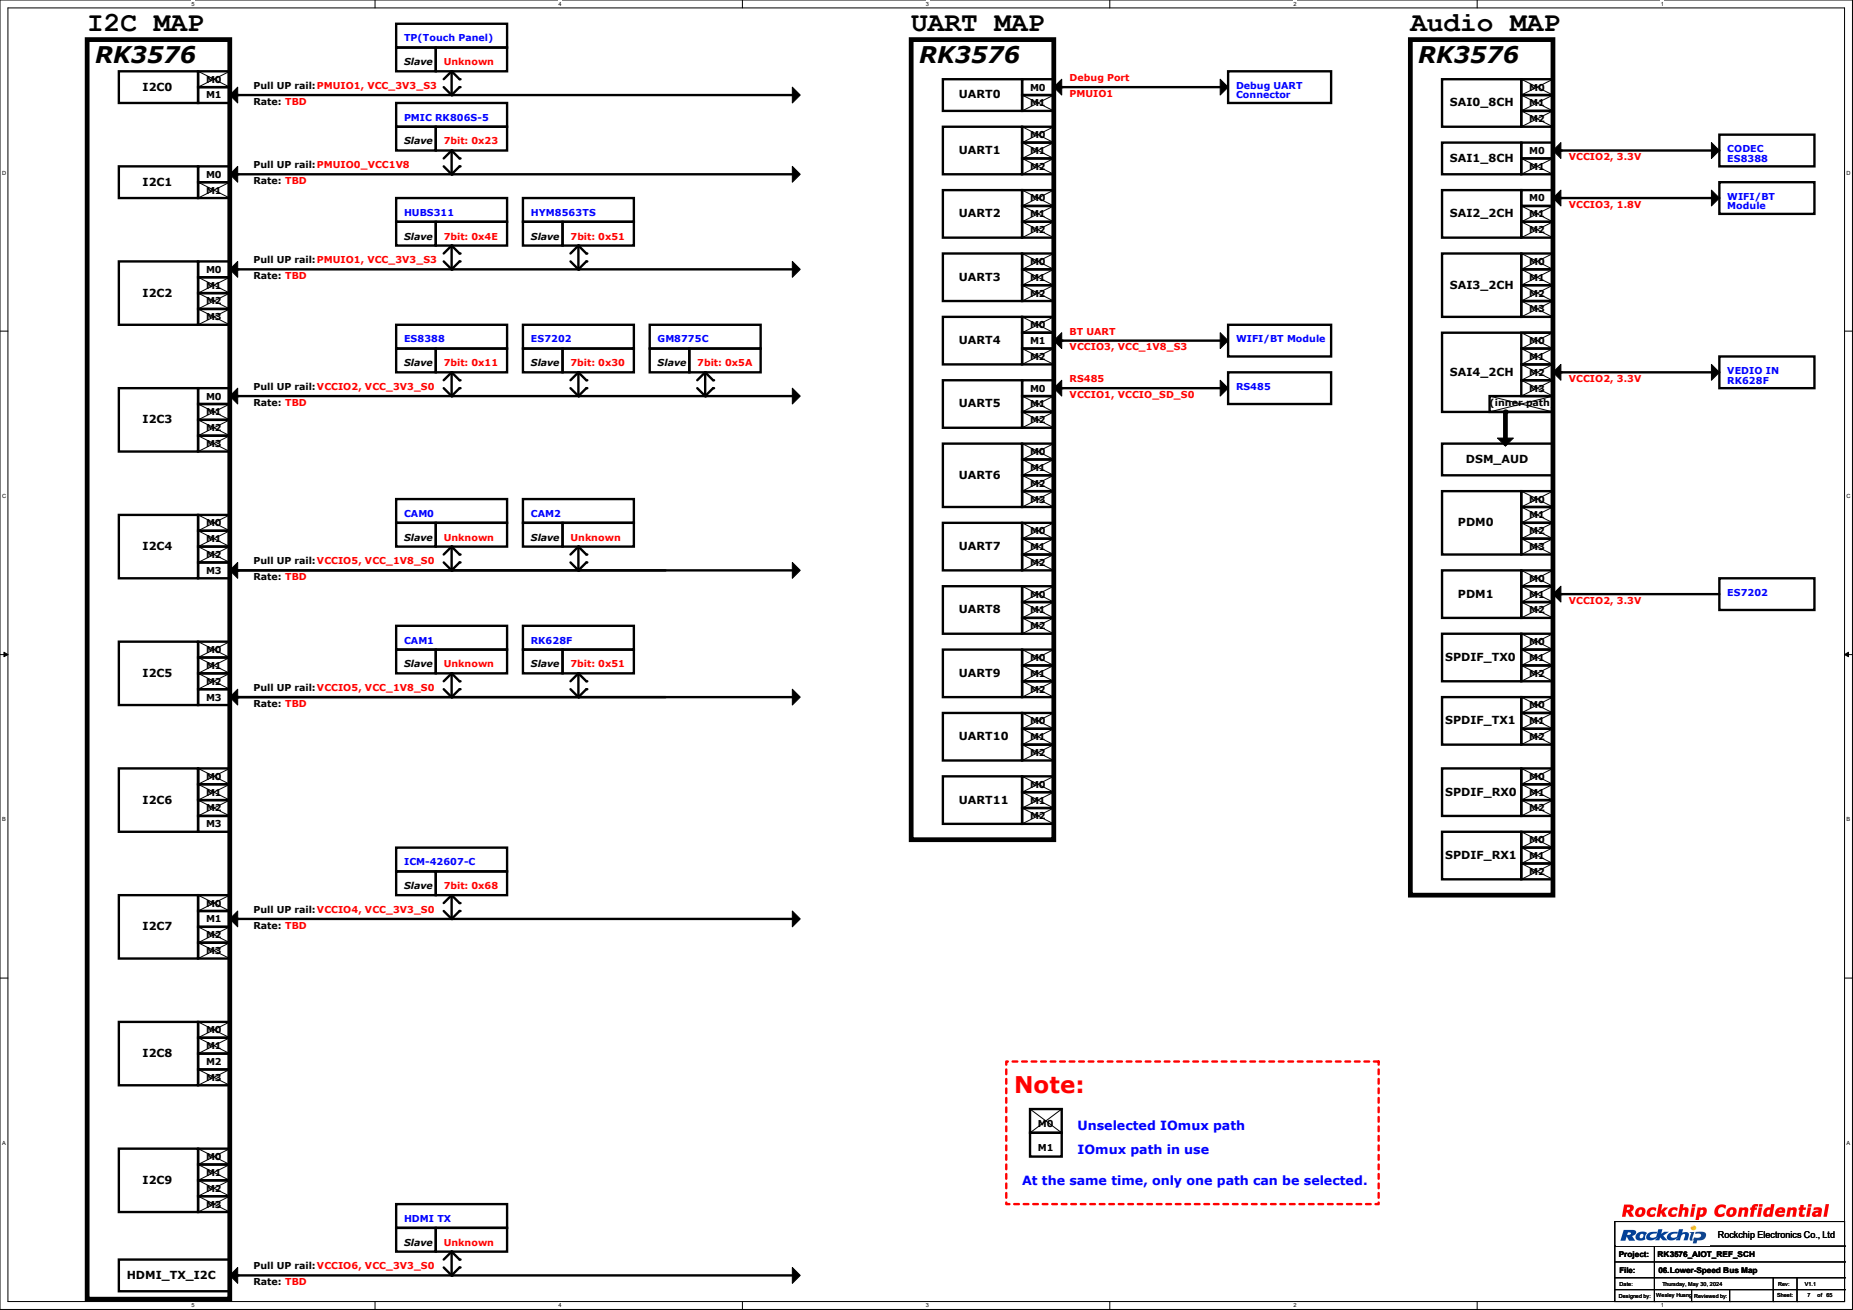
[picture p9: page 7]
Note:; Unselected IOmux path; Slave; Rate:; VCCIO2, VCC_3V3_S0; 7bit: 0x11; 7bit: 0x4E; 7bit: 0x51; HUBS311; HYM8563TS; Slave 7bit: 0x23; PMIC RK806S-5; TBD; Slave 7bit: 0x30; Slave Unknown; CAM0; VCCIO5, VCC_1V8_S0; PMUIO1, VCC_3V3_S3; Unknown; ICM-42607-C; CAM1; 7bit: 0x68; UART MAP RK3576; HDMI TX; HDMI_TX_I2C; UART6; UART0; UART1; UART2; UART3; UART4; UART5; UART7; UART8; UART9; UART10; UART11; PMUIO1; Debug UART Connector; VCCIO1, VCCIO_SD_S0; Debug Port; VCCIO3, VCC_1V8_S3; BT UART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

TP(Touch Panel)

Pull UP rail:
Rate:

Pull UP rail:PMUIO0_VCC1V8

Pull UP rail:PMUIO1, VCC_3V3_S3
TBD

Pull UP rail:VCCIO5, VCC_1V8_S0

Pull UP rail:VCCIO4, VCC_3V3_S0
Rate: TBD

IOmux path in use

At the same time, only one path can be selected.

Pull UP rail:VCCIO6, VCC_3V3_S0

# PCIe1 Controller

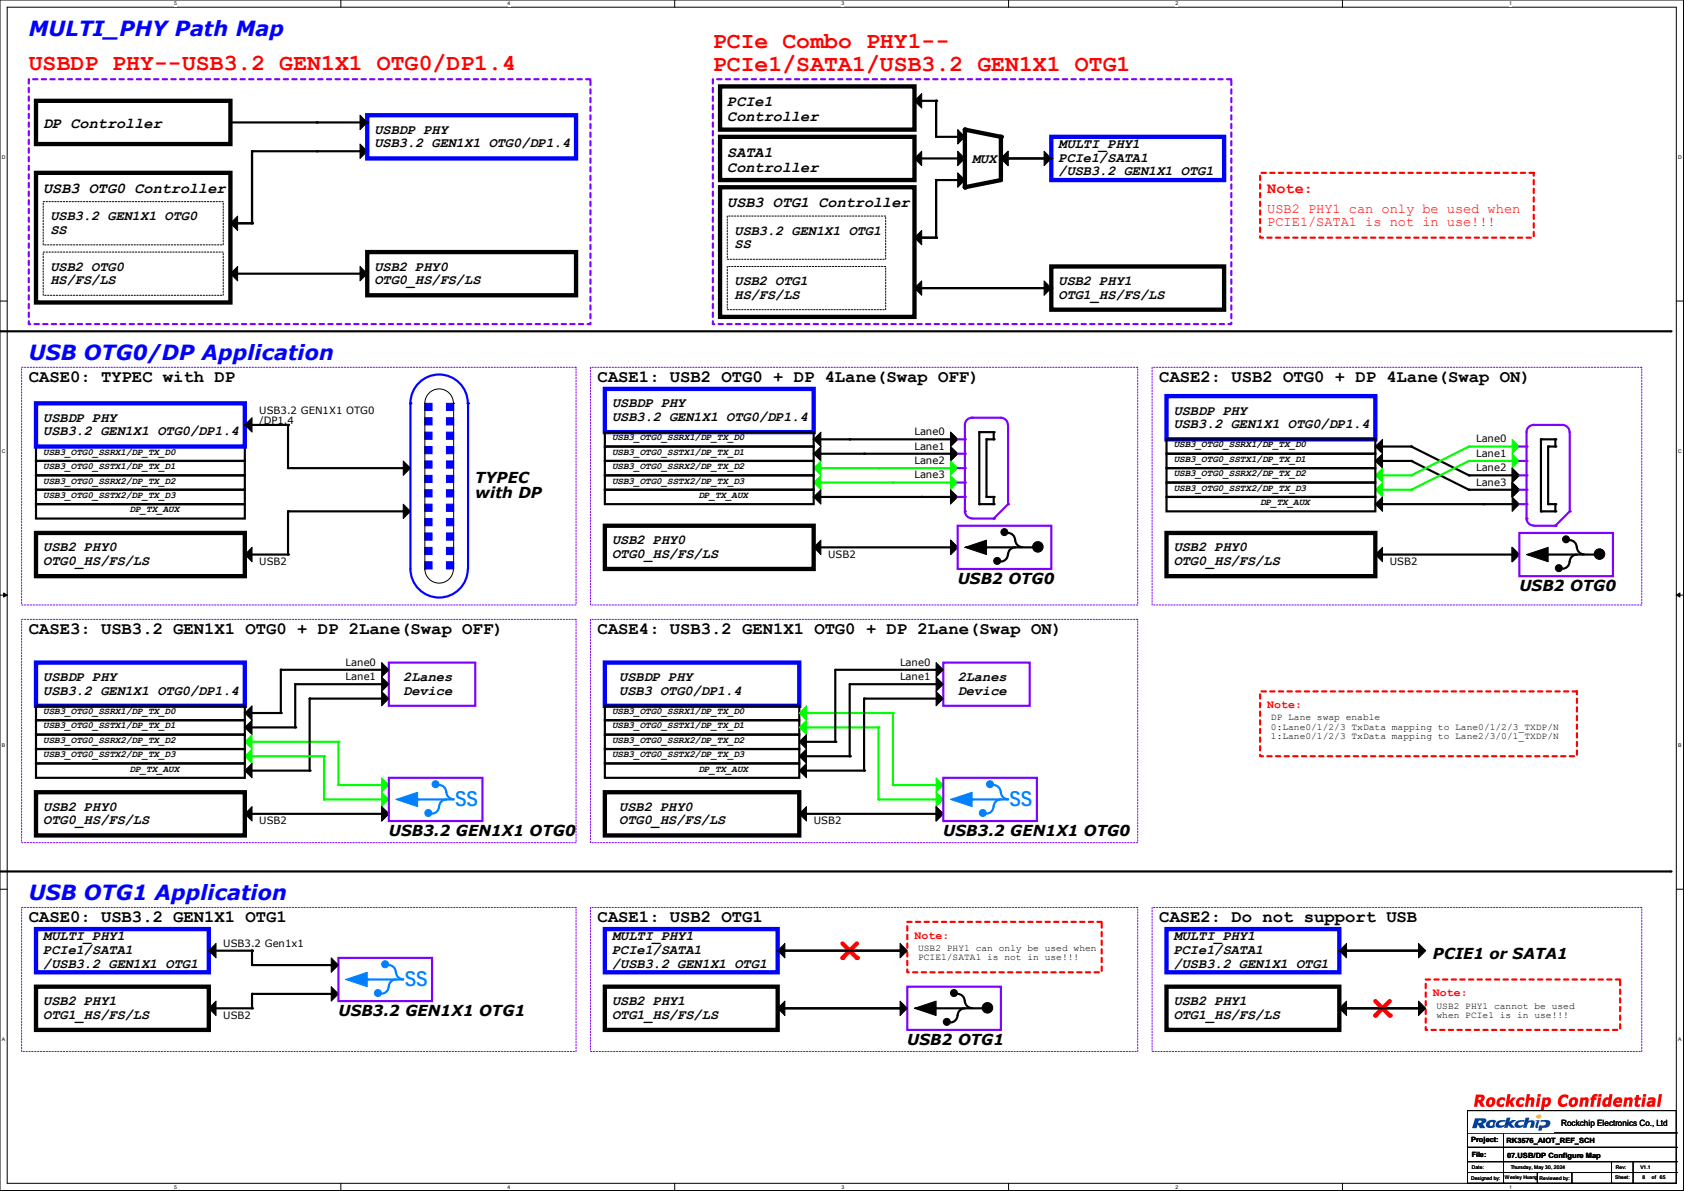
[picture p10: page 8]
USB3.2 Gen1x1; USB2 PHY1; OTG1_HS/FS/LS; USB2; USB3.2 GEN1X1 OTG1; MULTI_PHY1 PCIe1/SATA1 /USB3.2 GEN1X1 OTG1; CASE0: USB3.2 GEN1X1 OTG1; SATA1 Controller; PCIe Combo PHY1-- PCIe1/SATA1/USB3.2 GEN1X1 OTG1; USB2 PHY1 OTG1_HS/FS/LS; USB3.2 GEN1X1 OTG1 SS; USB2 PHY0 OTG0_HS/FS/LS; USB3.2 GEN1X1 OTG0 SS; USBDP PHY--USB3.2 GEN1X1 OTG0/DP1.4; USB2 OTG0 USB2 OTG0; Lane1; USB3_OTG0_SSTX1/DP_TX_D1; USB3_OTG0_SSTX2/DP_TX_D3; Lane3; DP_TX_AUX; Lane2; TYPEC with DP; USB3_OTG0_SSRX2/DP_TX_D2; 2Lanes Device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

Note:
USB2 PHY1 can only be used when
PCIE1/SATA1 is not in use!!!

USB2 OTG0

USB2 OTG1

USB OTG0/DP Application
CASE0: TYPEC with DP

CASE1: USB2 OTG0 + DP 4Lane(Swap OFF)

CASE2: USB2 OTG0 + DP 4Lane(Swap ON)

CASE3: USB3.2 GEN1X1 OTG0 + DP 2Lane(Swap OFF)

CASE4: USB3.2 GEN1X1 OTG0 + DP 2Lane(Swap ON)

Note: DP Lane swap enable

0:Lane0/1/2/3 TxData mapping to Lane0/1/2/3_TXDP/N
1:Lane0/1/2/3 TxData mapping to Lane2/3/0/1_TXDP/N

Note: USB2 PHY1 can only be used when

Note: USB2 PHY1 cannot be used

when PCIe1 is in use!!!

# 100MHz

# CASE1: SATA

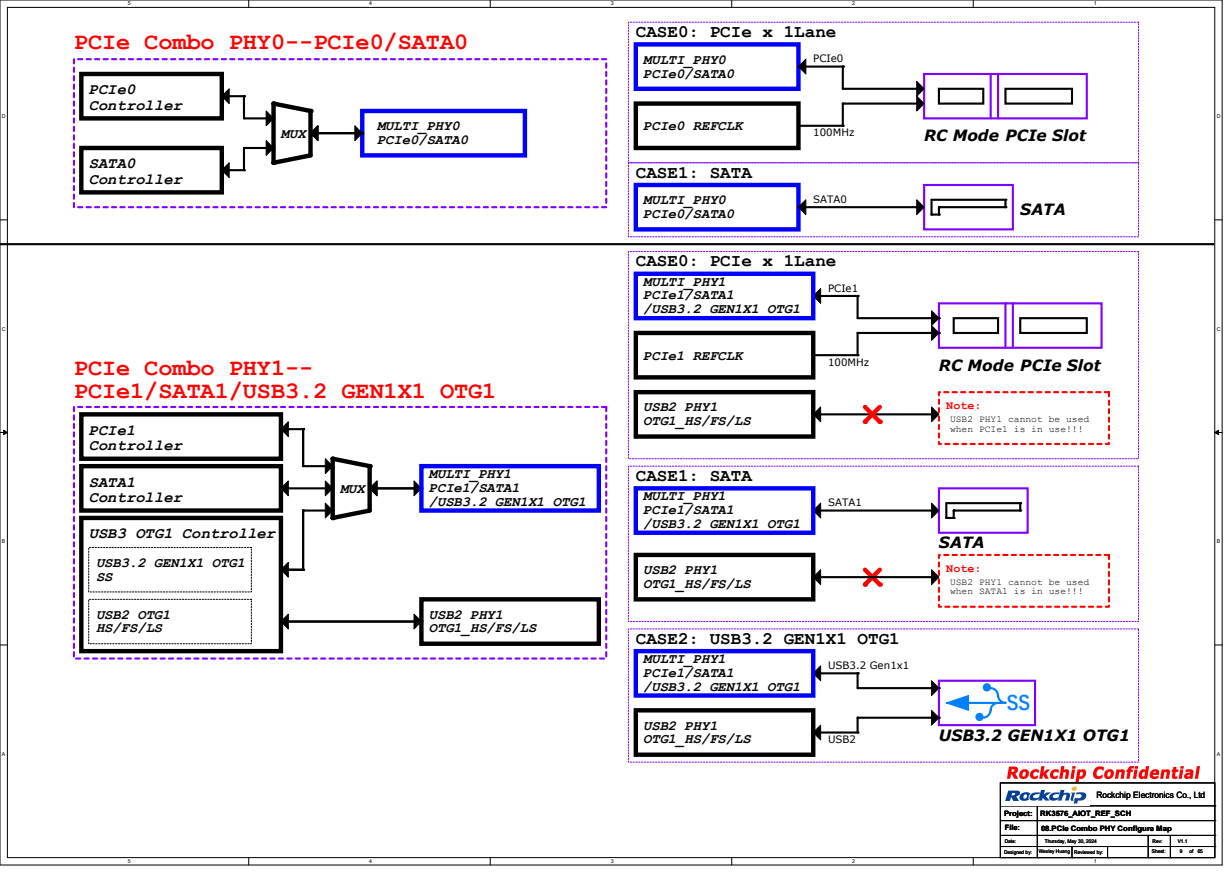
[picture p11: page 9]
PCIe1; PCIe1 REFCLK; CASE0: PCIe x 1Lane; PCIe Slot; USB2 PHY1 OTG1_HS/FS/LS; 100MHz; RC Mode; USB3.2 Gen1x1; USB2 PHY1; OTG1_HS/FS/LS; USB2; SATA; SATA1; USB3.2 GEN1X1 OTG1; CASE2: USB3.2 GEN1X1 OTG1; CASE1: SATA; PCIe0 REFCLK; MULTI_PHY0 PCIe0/SATA0; PCIe0; SATA0; PCIe Combo PHY0--PCIe0/SATA0; SATA0 Controller; PCIe0 Controller; MULTI_PHY1 PCIe1/SATA1 /USB3.2 GEN1X1 OTG1; PCIe Combo PHY1-- PCIe1/SATA1/USB3.2 GEN1X1 OTG1; USB3 OTG1 Controller; SATA1 Controller; USB3.2 GEN1X1 OTG1 SS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

RC Mode PCIe Slot MULTI_PHY0
PCIe0/SATA0

Note: USB2 PHY1 cannot be used

when PCIe1 is in use!!!

Note:
USB2 PHY1 cannot be used
when SATA1 is in use!!!

USB2 OTG1

08.PCIe Combo PHY Configure Map

# VO MAP

# PORT0

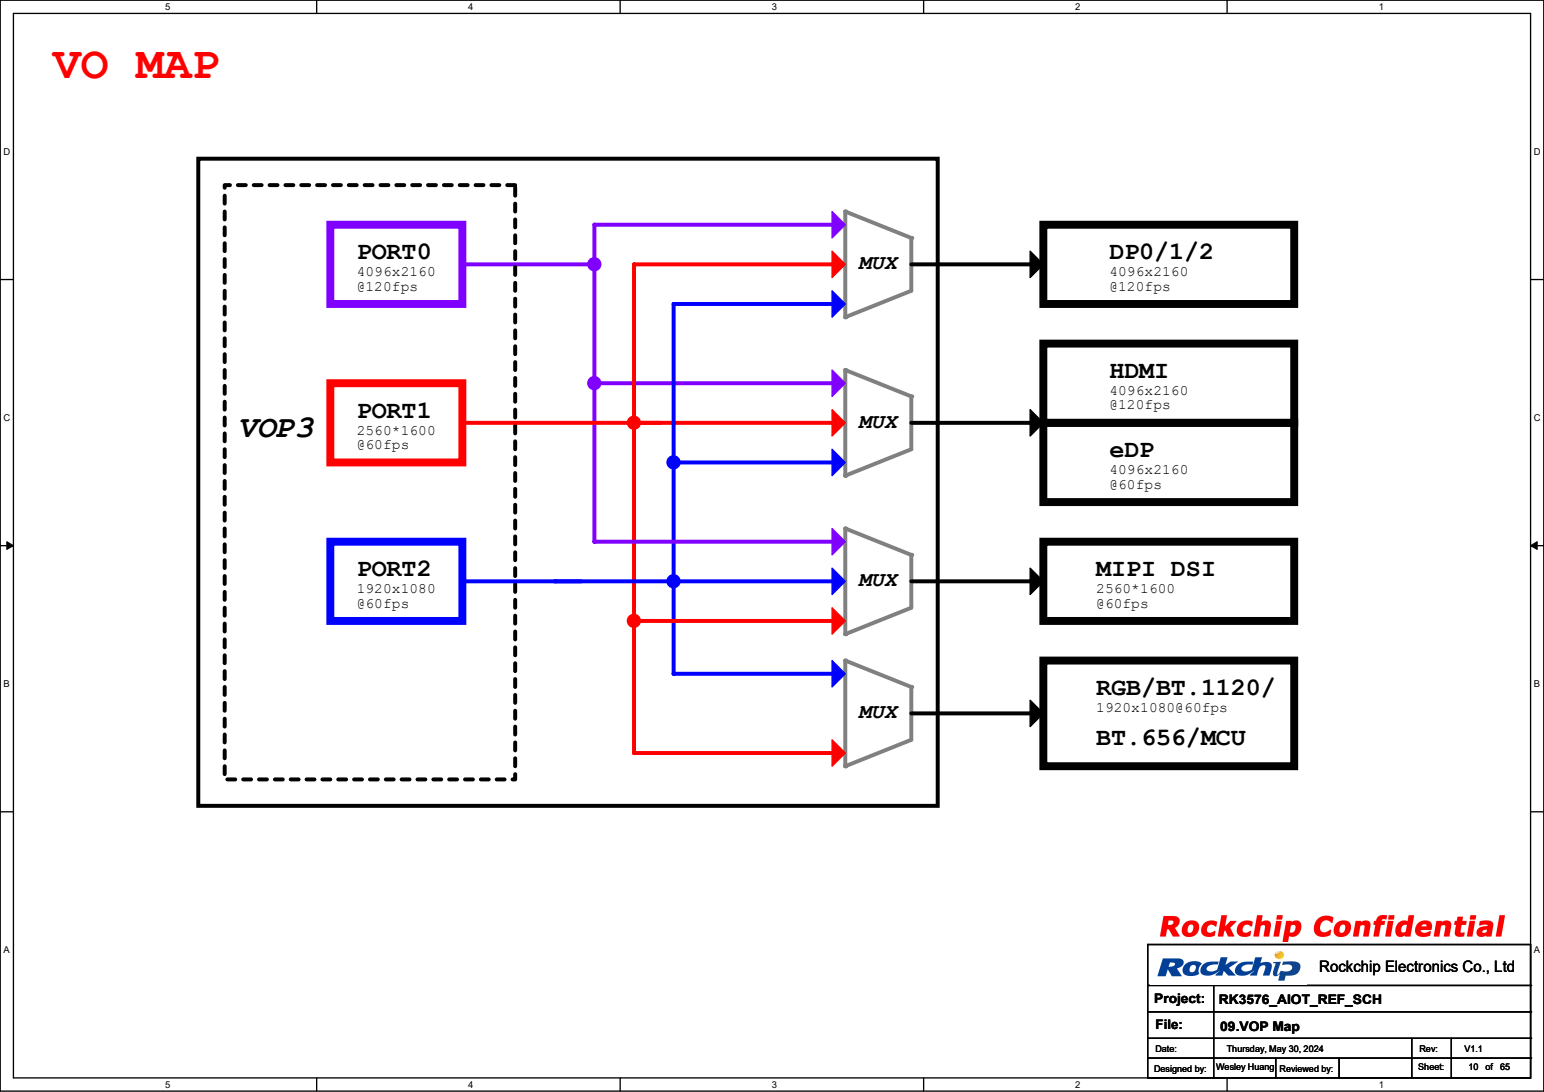
[picture p12: page 10]
2560*1600 @60fps; MIPI DSI; RGB/BT.1120/; BT.656/MCU; HDMI; eDP; 4096x2160 @120fps; 4096x2160 @60fps; VOP3; PORT2; PORT1; MUX; @120fps; 1920x1080 @60fps; 1920x1080@60fps; Project:; File: Date:; Rockchip Electronics Co., Ltd; Designed by:; Rev: Reviewed by:; Sheet:; of Thursday, May 30, 2024; 09.VOP Map; RK3576_AIOT_REF_SCH; Wesley Huang; 65 V1.1 Project:

RK3576_S (Power) | RK3576_T/U/V (GND)

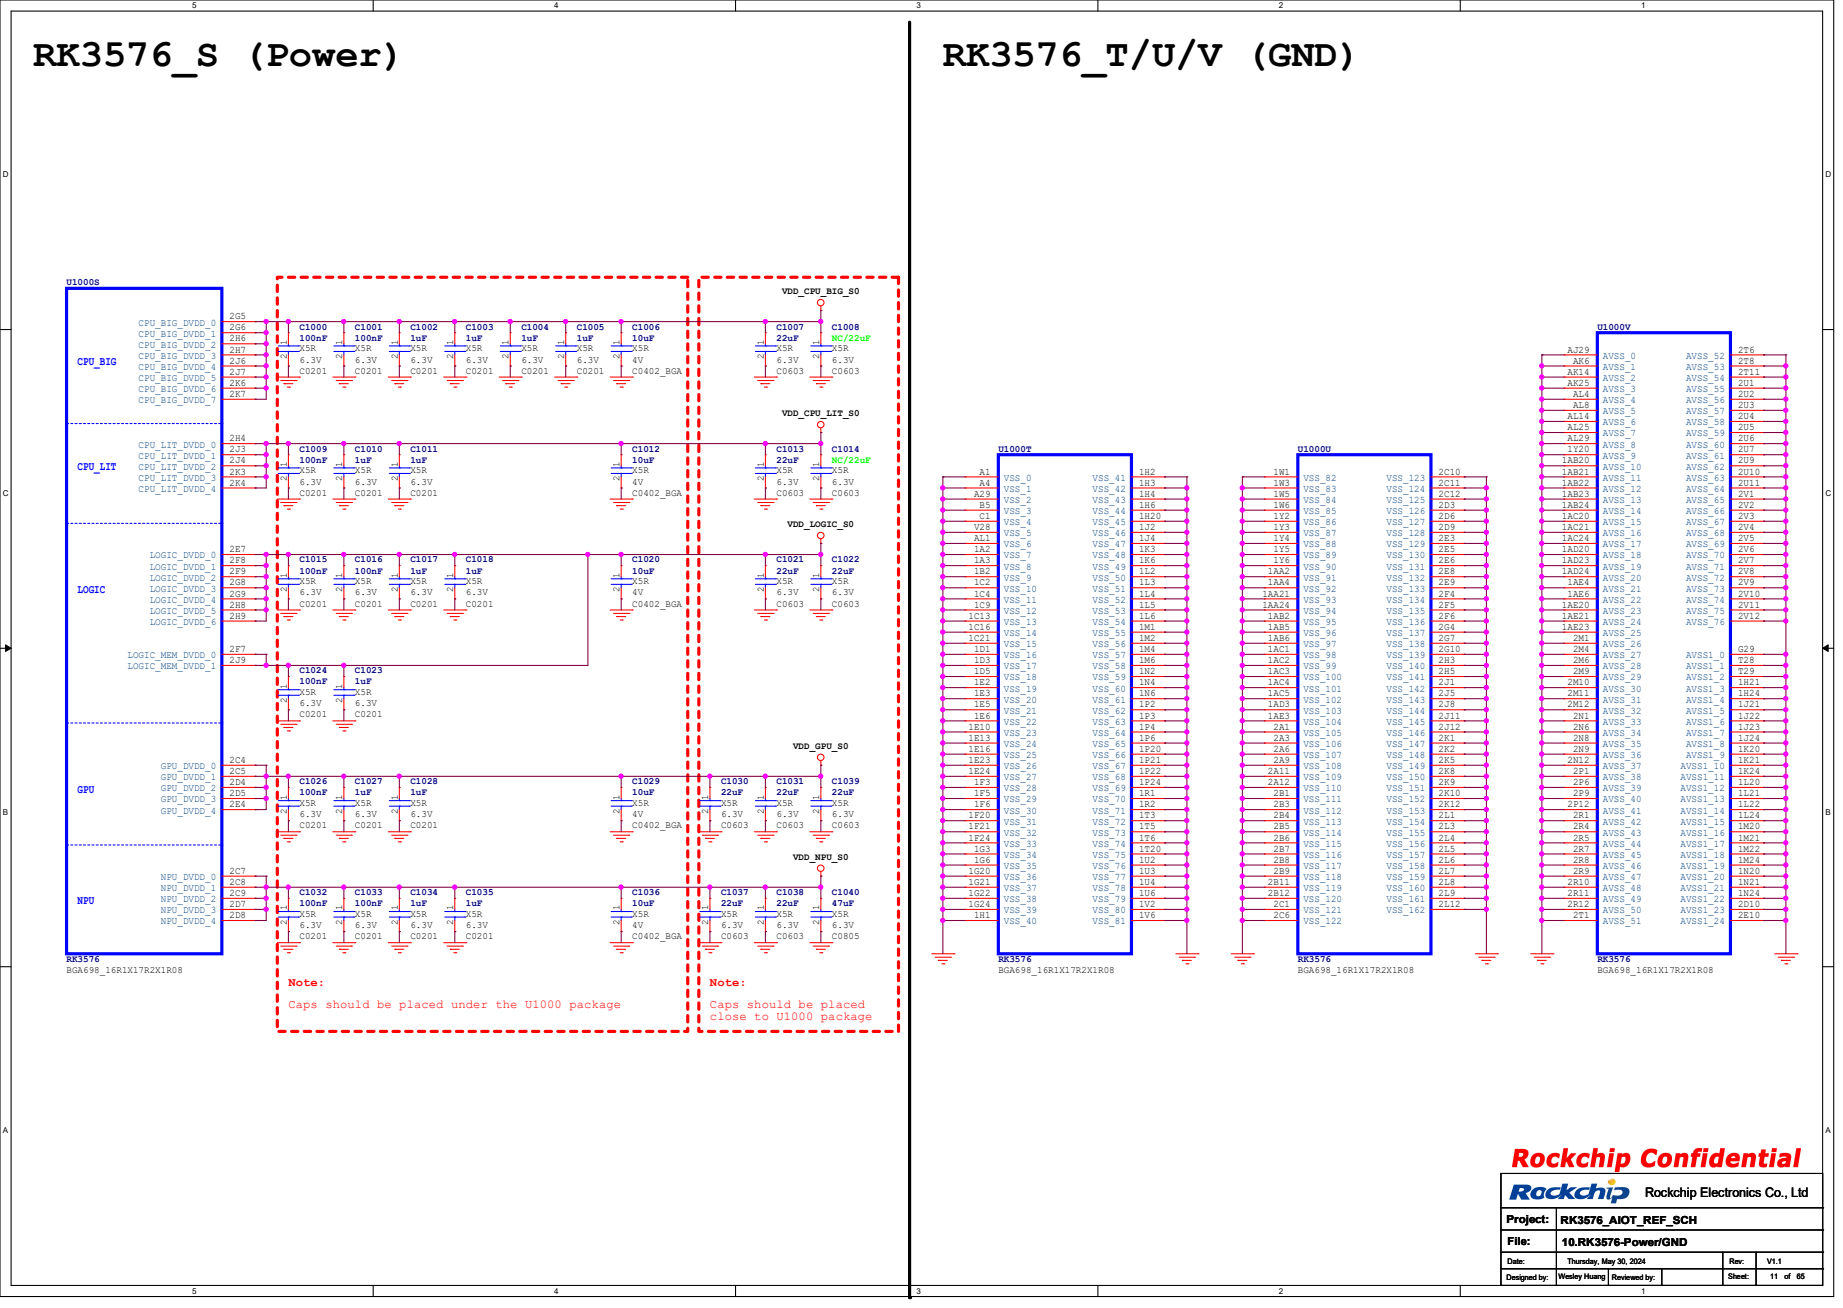
[picture p13: page 11]

Caps should be placed under the U1000 package

Caps should be placed
close to U1000 package

# RK3576_E (PMUIO0/1)

# Note:

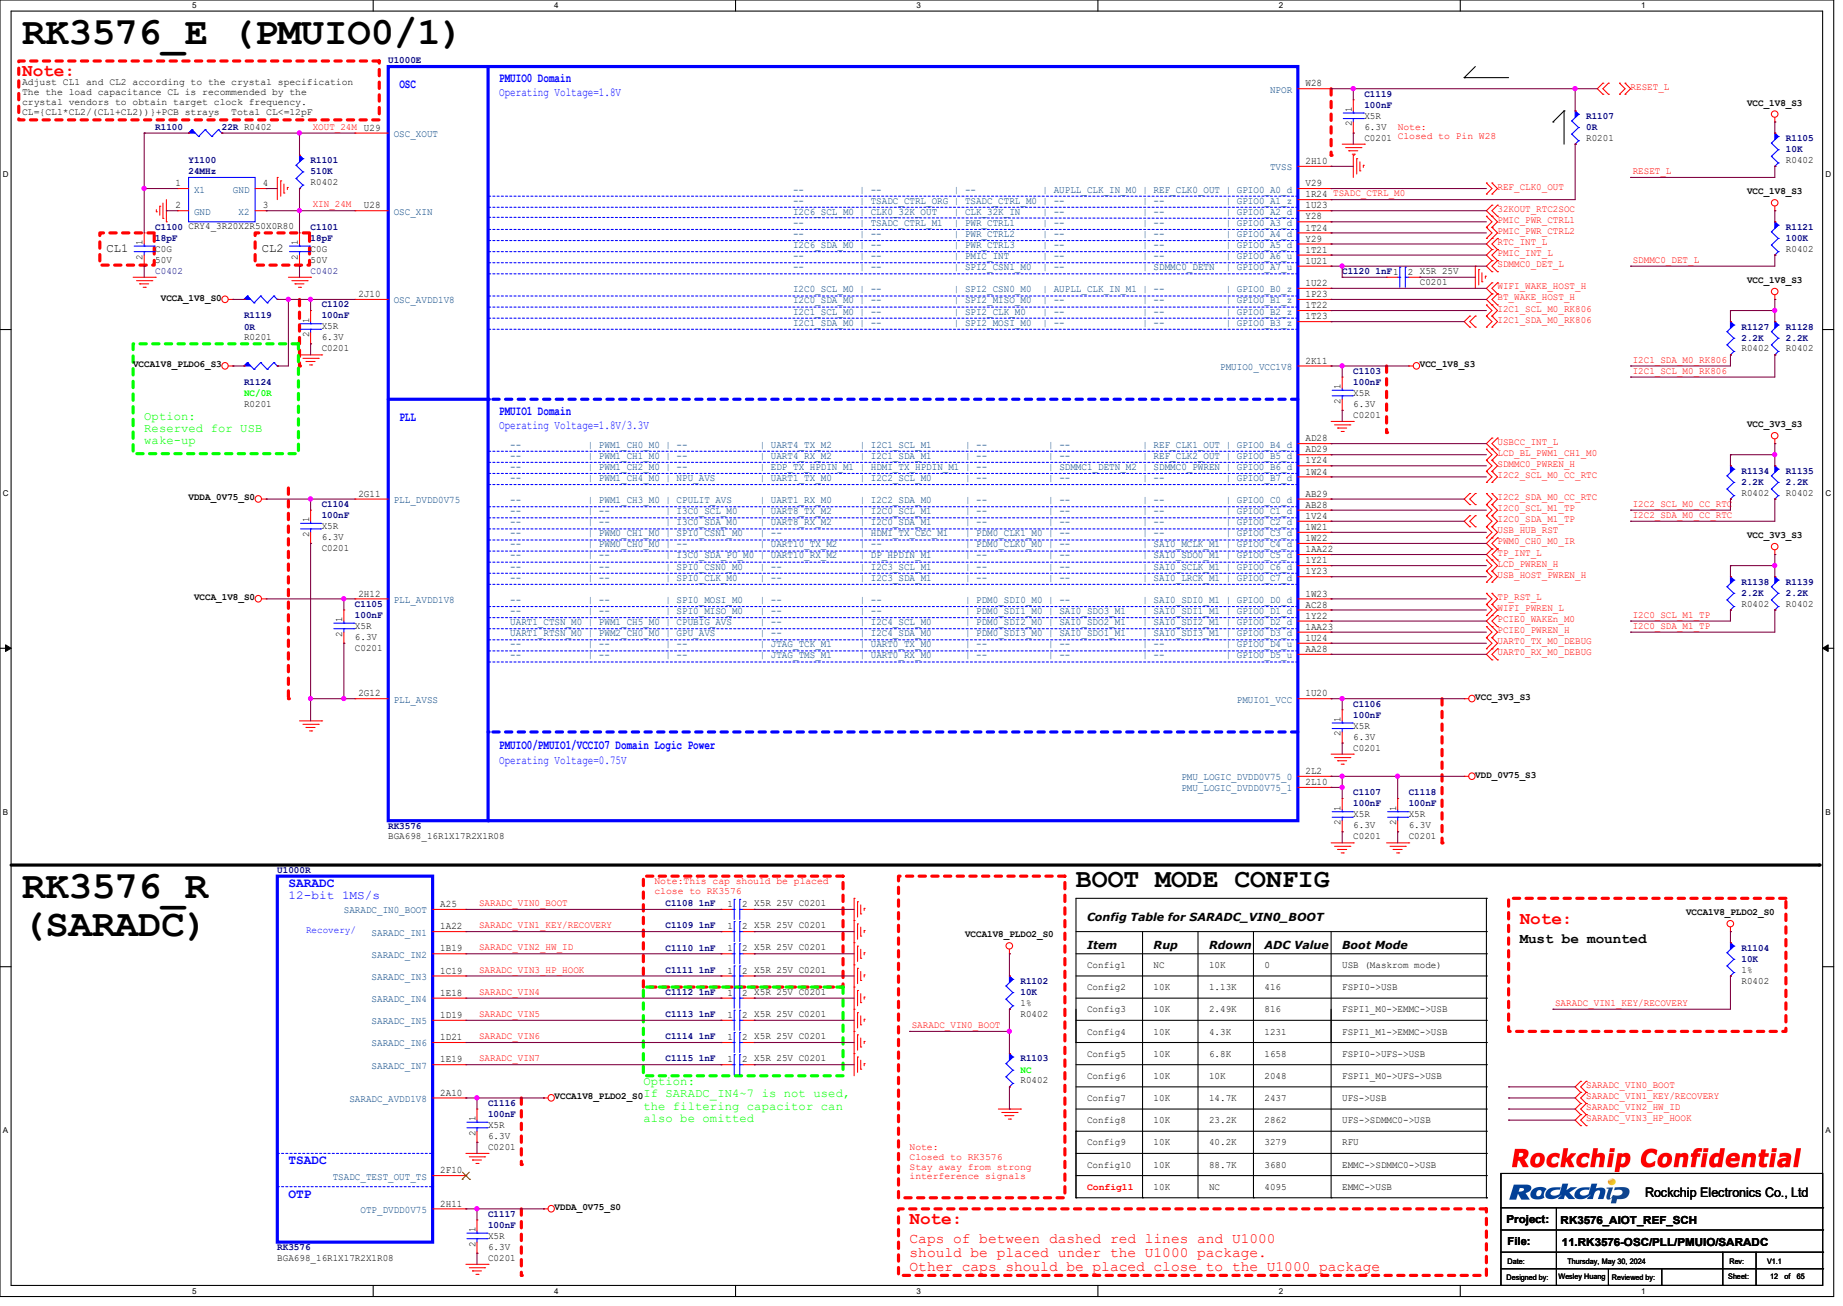
[picture p14: page 12]

Adjust CL1 and CL2 according to the crystal specification
The the load capacitance CL is recommended by the
crystal vendors to obtain target clock frequency.
CL={CL1*CL2/(CL1+CL2))}+PCB strays Total CL<=12pF

BOOT MODE CONFIG | Rup | Rdown | ADC Value | UFS->USB USB (Maskrom mode)

Note:This cap should be placed

Item Config1 | NC | 10K | 0 | FSPI1_M0->EMMC->USB

Config2 | 10K | 1.13K | 416 | Boot Mode FSPI1_M0->UFS->USB FSPI0->USB

Config3 | 10K | 2.49K | 816

Config4 | 10K | 4.3K | 1231 | FSPI1_M1->EMMC->USB

Option:
If SARADC_IN4~7 is not used,
the filtering capacitor can
also be omitted

Config5 | 10K | 6.8K | 1658 | FSPI0->UFS->USB

Config6 | 10K | 10K | 2048

Config7 | 10K | 14.7K | 2437

Config8 | 10K | 23.2K | 2862 | UFS->SDMMC0->USB

Closed to RK3576
Stay away from strong
interference signals

Config9 | 10K | 40.2K | 3279

Config11 Config10 | 10K | 88.7K | 3680 | EMMC->SDMMC0->USB

10K | NC | 4095 | EMMC->USB

Note:
Caps of between dashed red lines and U1000
should be placed under the U1000 package.
Other caps should be placed close to the U1000 package

11.RK3576-OSC/PLL/PMUIO/SARADC

RK3576_A(DDRPHY) | LPDDR4/4X
DDR_DQ0_A LPDDR4_DQ0_A DDR_DQ1_A LPDDR4_DQ1_A DDR_DQ2_A LPDDR4_DQ2_A DDR_DQ3_A LPDDR4_DQ3_A DDR_DQ4_A LPDDR4_DQ4_A DDR_DQ5_A LPDDR4_DQ5_A DDR_DQ6_A LPDDR4_DQ6_A DDR_DQ7_A LPDDR4_DQ7_A DDR_DQS0P_A LPDDR4_DQS0P_A DDR_DQS0N_A LPDDR4_DQS0N_A DDR_DM0_A LPDDR4_DMI0_A | LPDDR5 DDR_DQ0_A LPDDR5_DQ0_A DDR_DQ1_A LPDDR5_DQ1_A DDR_DQ2_A LPDDR5_DQ2_A DDR_DQ3_A LPDDR5_DQ3_A DDR_DQ4_A LPDDR5_DQ4_A DDR_DQ5_A LPDDR5_DQ5_A DDR_DQ6_A LPDDR5_DQ6_A DDR_DQ7_A LPDDR5_DQ7_A DDR_DQS0P_A LPDDR5_RDQS0P_A DDR_DQS0N_A LPDDR5_RDQS0N_A DDR_DM0_A LPDDR5_DMI0_A LPDDR5_WCK0P_A LPDDR5_WCK0P_A LPDDR5_WCK0N_A LPDDR5_WCK0N_A

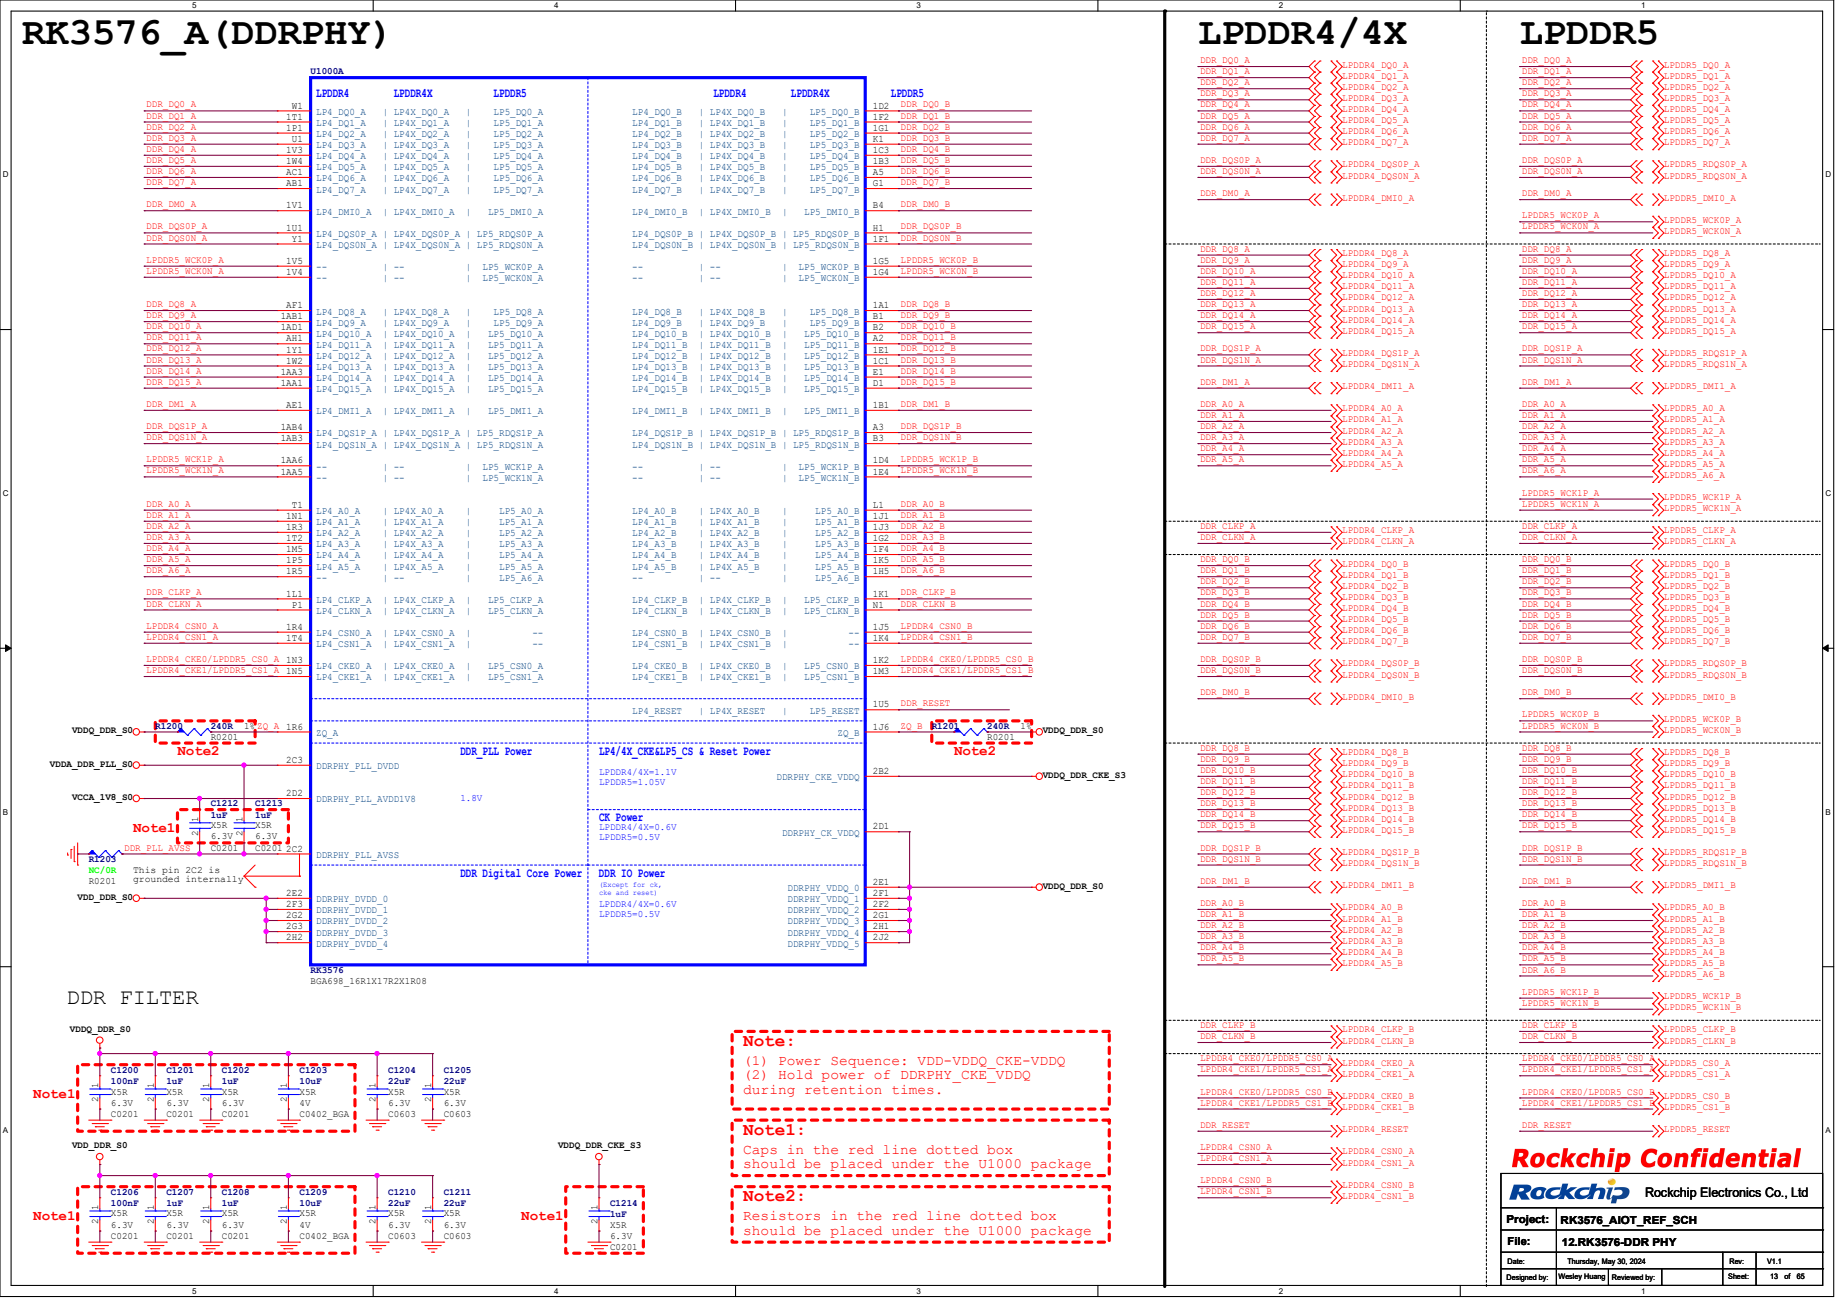
[picture p15: page 13]

DDR_DQ8_A LPDDR4_DQ8_A DDR_DQ9_A LPDDR4_DQ9_A DDR_DQ10_A LPDDR4_DQ10_A DDR_DQ11_A LPDDR4_DQ11_A DDR_DQ12_A LPDDR4_DQ12_A DDR_DQ13_A LPDDR4_DQ13_A DDR_DQ14_A LPDDR4_DQ14_A DDR_DQ15_A LPDDR4_DQ15_A DDR_DQS1P_A LPDDR4_DQS1P_A DDR_DQS1N_A LPDDR4_DQS1N_A DDR_DM1_A LPDDR4_DMI1_A DDR_A0_A LPDDR4_A0_A DDR_A1_A LPDDR4_A1_A DDR_A2_A LPDDR4_A2_A DDR_A3_A LPDDR4_A3_A DDR_A4_A LPDDR4_A4_A DDR_A5_A LPDDR4_A5_A | DDR_DQ8_A LPDDR5_DQ8_A DDR_DQ9_A LPDDR5_DQ9_A DDR_DQ10_A LPDDR5_DQ10_A DDR_DQ11_A LPDDR5_DQ11_A DDR_DQ12_A LPDDR5_DQ12_A DDR_DQ13_A LPDDR5_DQ13_A DDR_DQ14_A LPDDR5_DQ14_A DDR_DQ15_A LPDDR5_DQ15_A DDR_DQS1P_A LPDDR5_RDQS1P_A DDR_DQS1N_A LPDDR5_RDQS1N_A DDR_DM1_A LPDDR5_DMI1_A DDR_A0_A LPDDR5_A0_A DDR_A1_A LPDDR5_A1_A DDR_A2_A LPDDR5_A2_A DDR_A3_A LPDDR5_A3_A DDR_A4_A LPDDR5_A4_A DDR_A5_A LPDDR5_A5_A DDR_A6_A LPDDR5_A6_A LPDDR5_WCK1P_A LPDDR5_WCK1P_A LPDDR5_WCK1N_A LPDDR5_WCK1N_A

DDR_CLKP_A LPDDR4_CLKP_A DDR_CLKN_A LPDDR4_CLKN_A | DDR_CLKP_A LPDDR5_CLKP_A DDR_CLKN_A LPDDR5_CLKN_A

DDR_DQ0_B LPDDR4_DQ0_B DDR_DQ1_B LPDDR4_DQ1_B DDR_DQ2_B LPDDR4_DQ2_B DDR_DQ3_B LPDDR4_DQ3_B DDR_DQ4_B LPDDR4_DQ4_B DDR_DQ5_B LPDDR4_DQ5_B DDR_DQ6_B LPDDR4_DQ6_B DDR_DQ7_B LPDDR4_DQ7_B DDR_DQS0P_B LPDDR4_DQS0P_B DDR_DQS0N_B LPDDR4_DQS0N_B DDR_DM0_B LPDDR4_DMI0_B | DDR_DQ0_B LPDDR5_DQ0_B DDR_DQ1_B LPDDR5_DQ1_B DDR_DQ2_B LPDDR5_DQ2_B DDR_DQ3_B LPDDR5_DQ3_B DDR_DQ4_B LPDDR5_DQ4_B DDR_DQ5_B LPDDR5_DQ5_B DDR_DQ6_B LPDDR5_DQ6_B DDR_DQ7_B LPDDR5_DQ7_B DDR_DQS0P_B LPDDR5_RDQS0P_B DDR_DQS0N_B LPDDR5_RDQS0N_B DDR_DM0_B LPDDR5_DMI0_B LPDDR5_WCK0P_B LPDDR5_WCK0P_B LPDDR5_WCK0N_B LPDDR5_WCK0N_B

DDR_DQ8_B LPDDR4_DQ8_B DDR_DQ9_B LPDDR4_DQ9_B DDR_DQ10_B LPDDR4_DQ10_B DDR_DQ11_B LPDDR4_DQ11_B DDR_DQ12_B LPDDR4_DQ12_B DDR_DQ13_B LPDDR4_DQ13_B DDR_DQ14_B LPDDR4_DQ14_B DDR_DQ15_B LPDDR4_DQ15_B DDR_DQS1P_B LPDDR4_DQS1P_B DDR_DQS1N_B LPDDR4_DQS1N_B DDR_DM1_B LPDDR4_DMI1_B DDR_A0_B LPDDR4_A0_B DDR_A1_B LPDDR4_A1_B DDR_A2_B LPDDR4_A2_B DDR_A3_B LPDDR4_A3_B DDR_A4_B LPDDR4_A4_B DDR_A5_B LPDDR4_A5_B | DDR_DQ8_B LPDDR5_DQ8_B DDR_DQ9_B LPDDR5_DQ9_B DDR_DQ10_B LPDDR5_DQ10_B DDR_DQ11_B LPDDR5_DQ11_B DDR_DQ12_B LPDDR5_DQ12_B DDR_DQ13_B LPDDR5_DQ13_B DDR_DQ14_B LPDDR5_DQ14_B DDR_DQ15_B LPDDR5_DQ15_B DDR_DQS1P_B LPDDR5_RDQS1P_B DDR_DQS1N_B LPDDR5_RDQS1N_B DDR_DM1_B LPDDR5_DMI1_B DDR_A0_B LPDDR5_A0_B DDR_A1_B LPDDR5_A1_B DDR_A2_B LPDDR5_A2_B DDR_A3_B LPDDR5_A3_B DDR_A4_B LPDDR5_A4_B DDR_A5_B LPDDR5_A5_B DDR_A6_B LPDDR5_A6_B LPDDR5_WCK1P_B LPDDR5_WCK1P_B LPDDR5_WCK1N_B LPDDR5_WCK1N_B

DDR_CLKP_B LPDDR4_CLKP_B DDR_CLKN_B LPDDR4_CLKN_B | DDR_CLKP_B LPDDR5_CLKP_B DDR_CLKN_B LPDDR5_CLKN_B

Note:
(1) Power Sequence: VDD-VDDQ_CKE-VDDQ
(2) Hold power of DDRPHY_CKE_VDDQ
during retention times.

Note1:
Caps in the red line dotted box
should be placed under the U1000 package
Note2: Resistors in the red line dotted box

# RK3576_B (UFS2.0)

## Option:

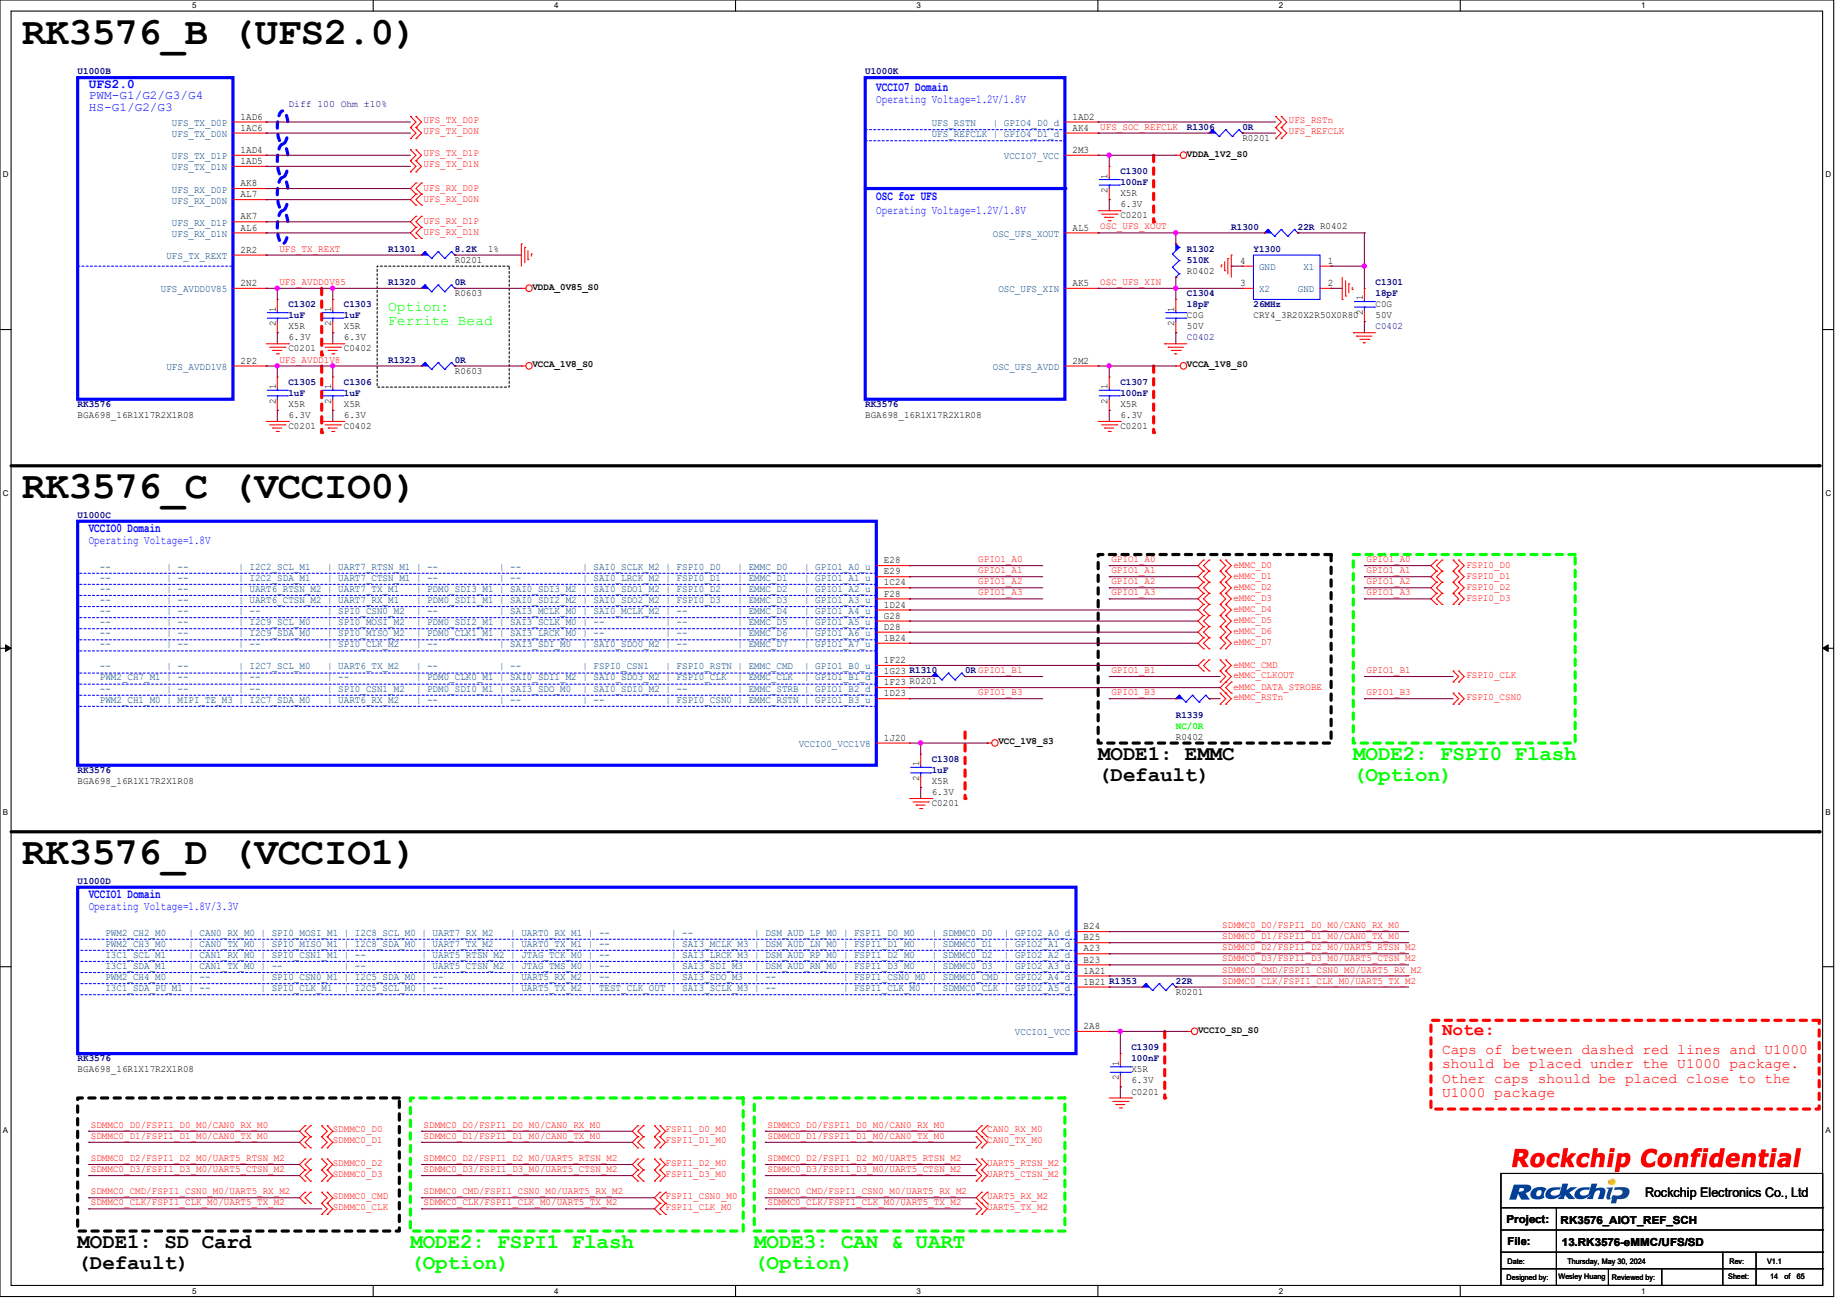
[picture p16: page 14]
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

# RK3576_L (USB3/DP)

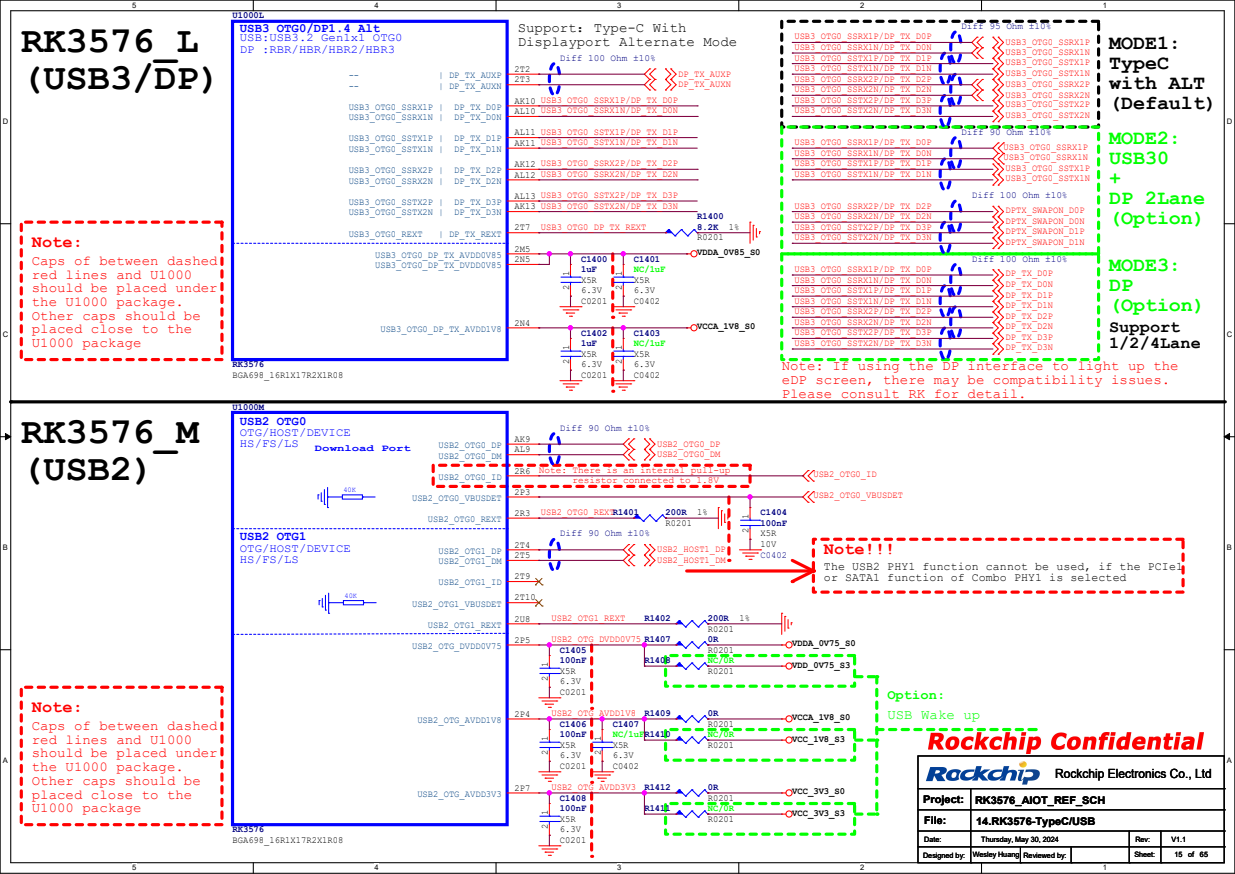
[picture p17: page 15]

Note:
Caps of between dashed
red lines and U1000
should be placed under
the U1000 package.
Other caps should be
placed close to the
U1000 package
(USB2)

USB3_OTG0_SSRX1P/DP_TX_D0P
USB3_OTG0_SSRX1N/DP_TX_D0N
USB3_OTG0_SSTX1P/DP_TX_D1P
USB3_OTG0_SSTX1N/DP_TX_D1N
USB3_OTG0_SSRX2P/DP_TX_D2P
USB3_OTG0_SSRX2N/DP_TX_D2N
USB3_OTG0_SSTX2P/DP_TX_D3P
USB3_OTG0_SSTX2N/DP_TX_D3N
Note: If using the DP interface to light up the
eDP screen, there may be compatibility issues.
Please consult RK for detail.

Note!!!
The USB2 PHY1 function cannot be used, if the PCIe1
or SATA1 function of Combo PHY1 is selected

RK3576_O(MIPI DCPHY) | RK3576_P(MIPI DPHY CSI RX)

# Support MIPI DPHY CSI1: 1/2/4Lane

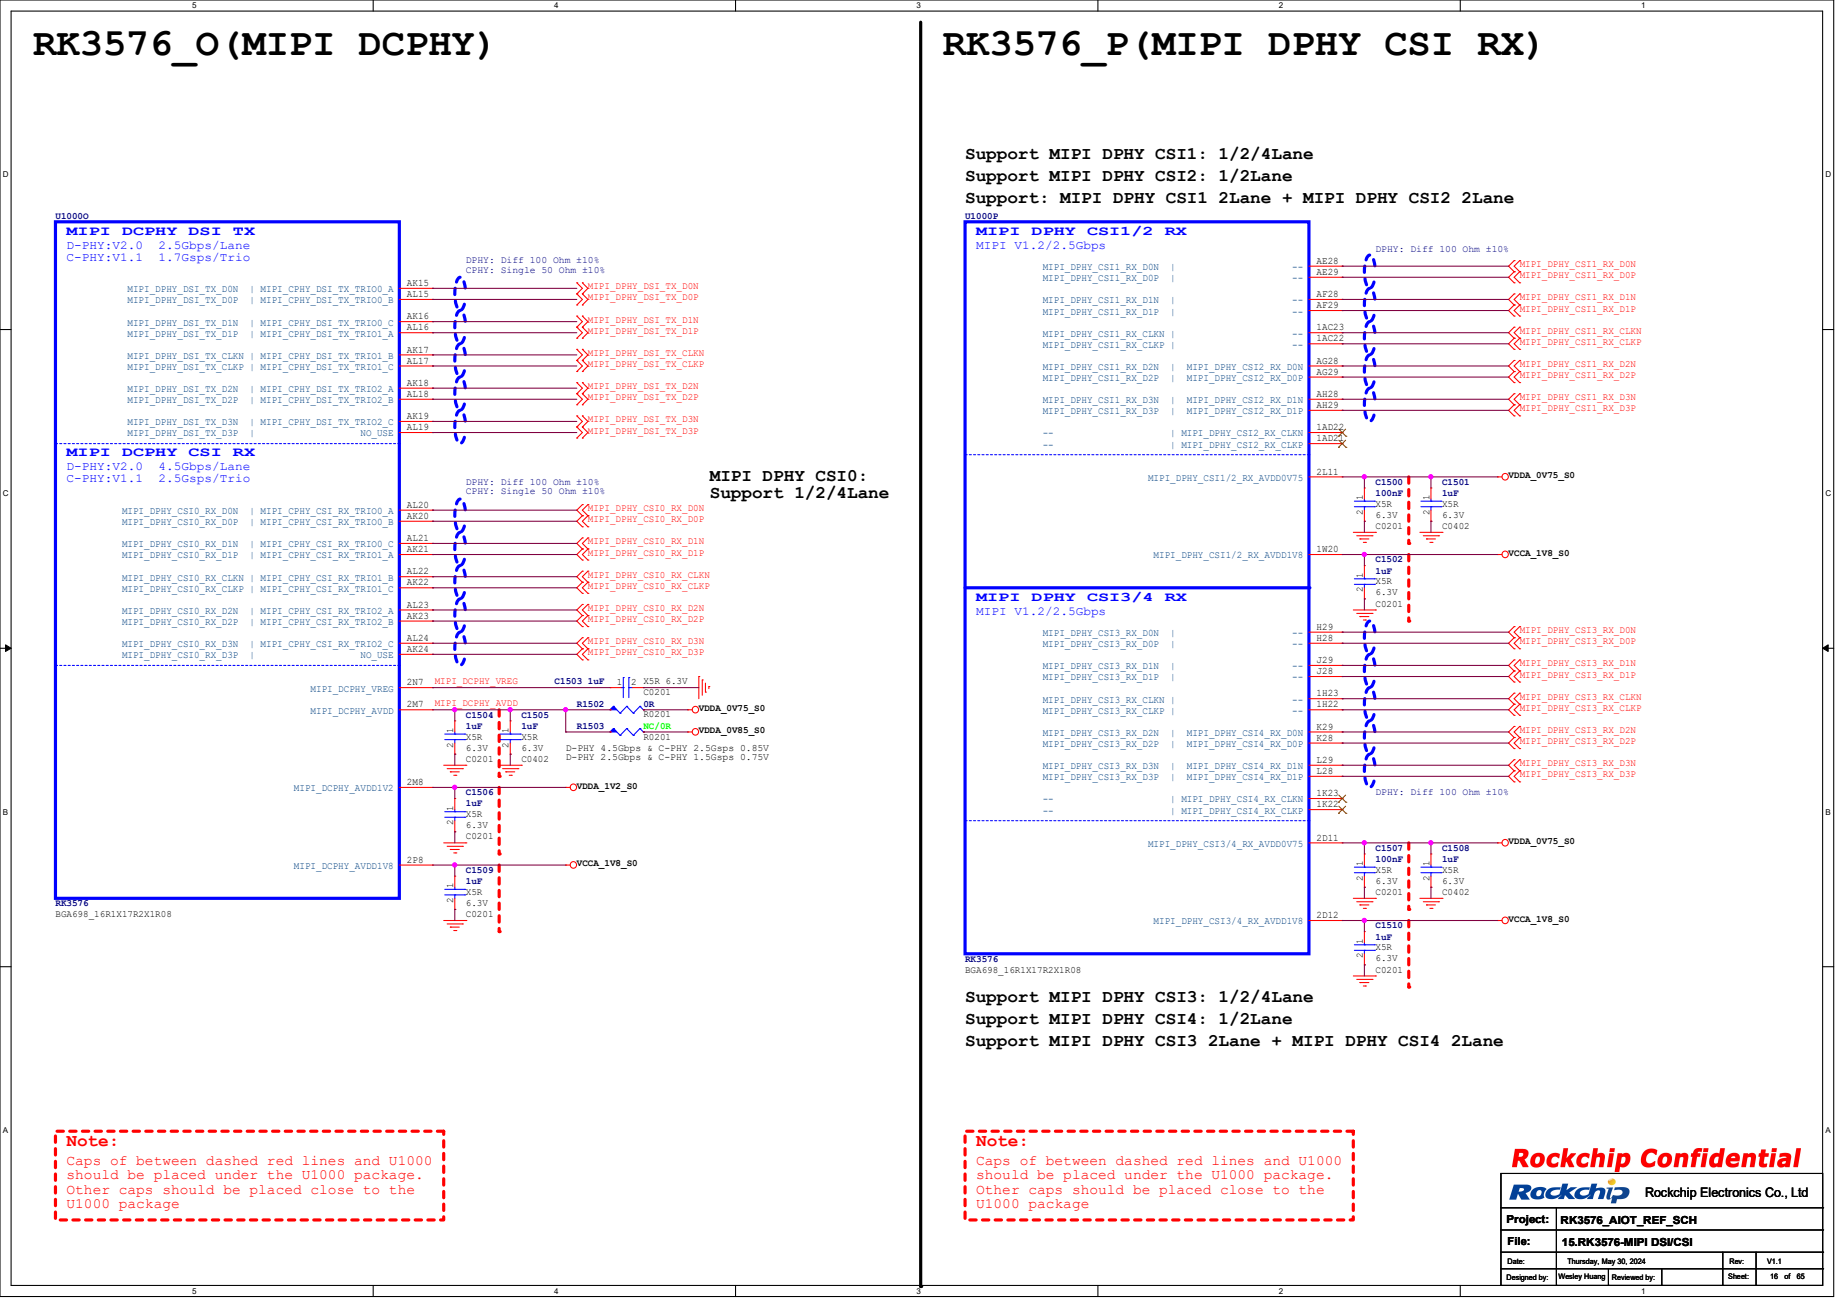
[picture p18: page 16]

Support MIPI DPHY CSI2: 1/2Lane
Support: MIPI DPHY CSI1 2Lane + MIPI DPHY CSI2 2Lane

MIPI DCPHY DSI TX
D-PHY:V2.0 2.5Gbps/Lane
C-PHY:V1.1 1.7Gsps/Trio

MIPI DCPHY CSI RX
D-PHY:V2.0 4.5Gbps/Lane
C-PHY:V1.1 2.5Gsps/Trio

BGA698_16R1X17R2X1R08
Support MIPI DPHY CSI3: 1/2/4Lane
Support MIPI DPHY CSI4: 1/2Lane
Support MIPI DPHY CSI3 2Lane + MIPI DPHY CSI4 2Lane

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

# RK3576_Q(HDMI/eDP)

# Note:

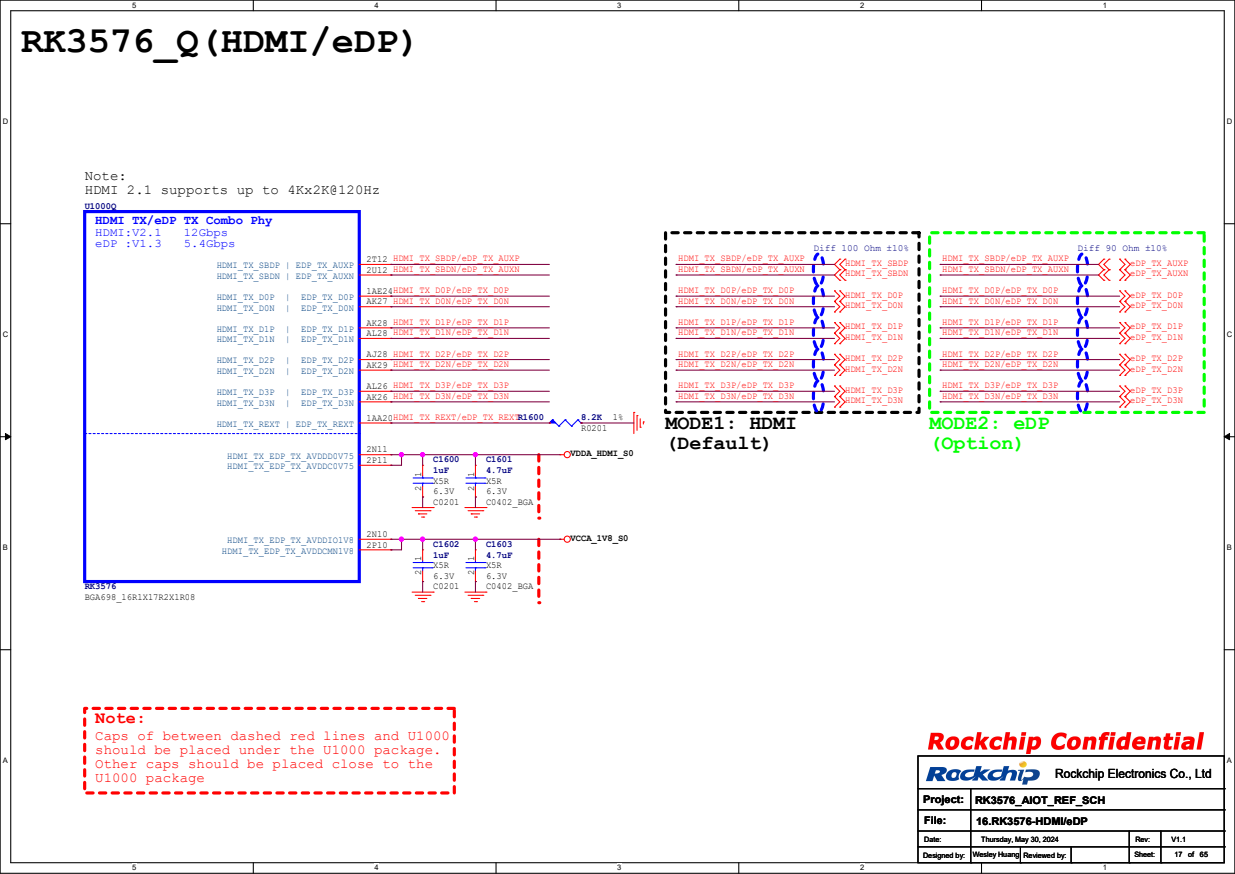
[picture p19: page 17]

HDMI 2.1 supports up to 4Kx2K@120Hz
HDMI TX/eDP TX Combo Phy

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

# RK3576_N(PCIe/SATA/USB3)

## Diff 100 Ohm ±10%

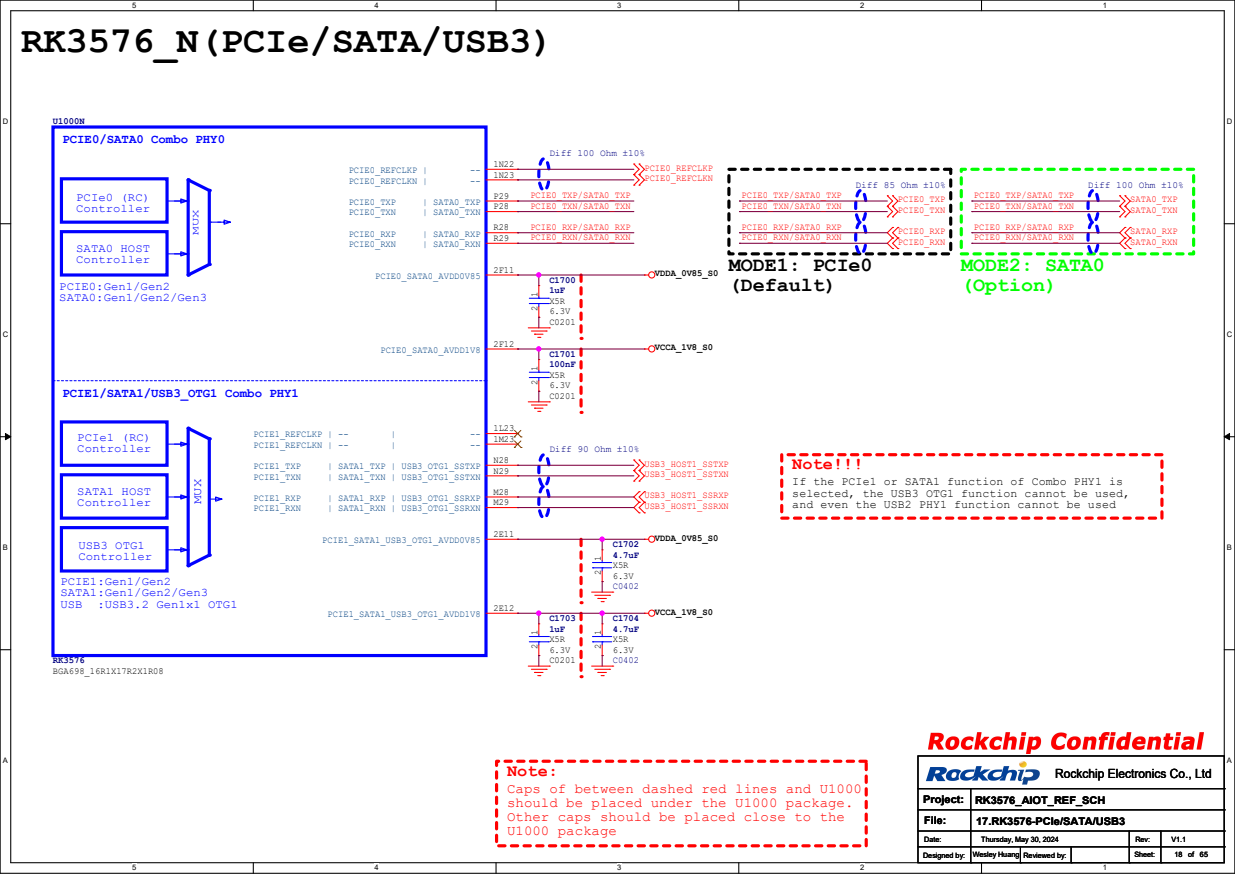
[picture p20: page 18]

Note!!!
If the PCIe1 or SATA1 function of Combo PHY1 is
selected, the USB3 OTG1 function cannot be used,
and even the USB2 PHY1 function cannot be used

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

# RK3576_F(VCCIO2)

## MODE1: HDMI RX Audio

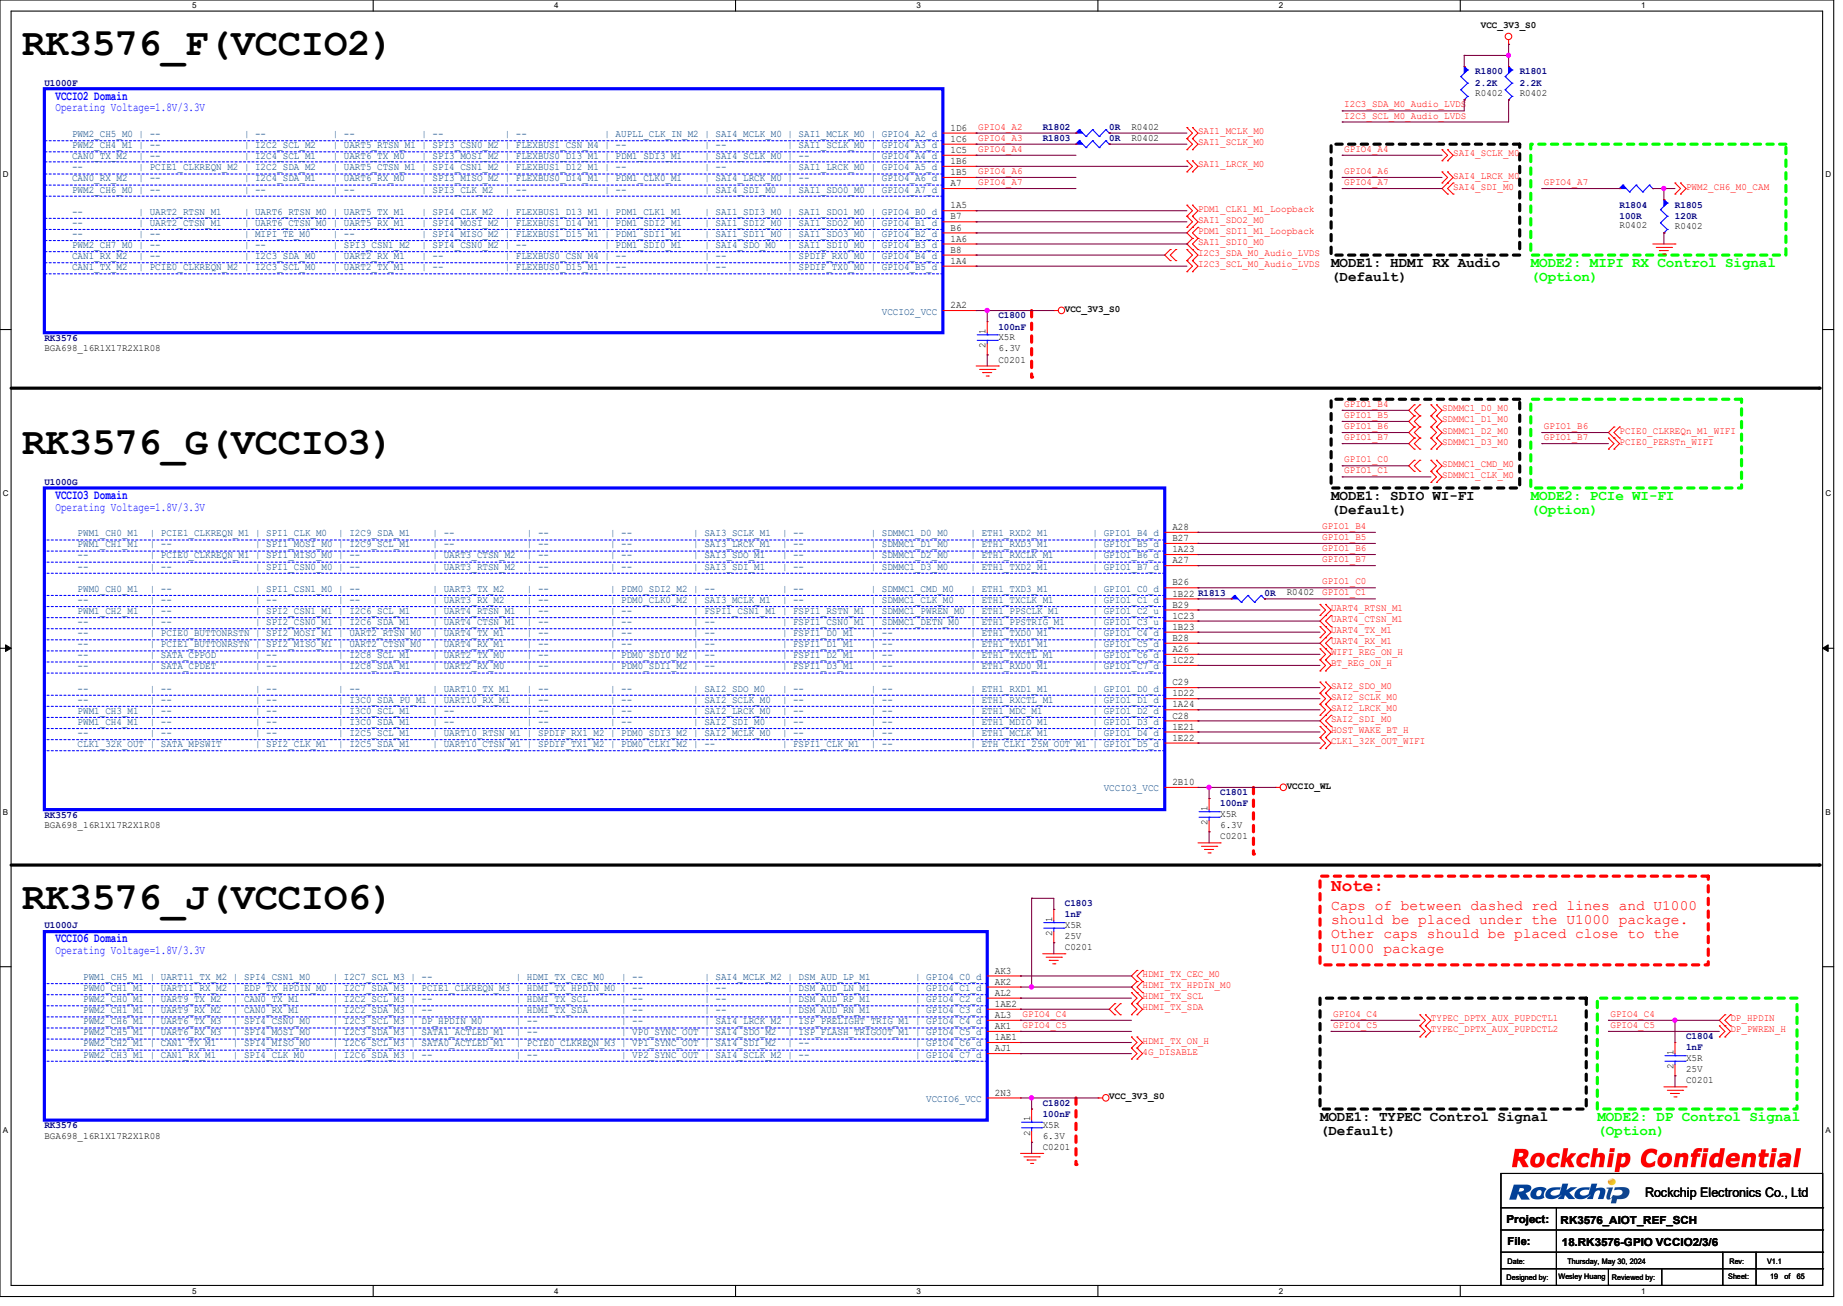
[picture p21: page 19]

MODE2: MIPI RX Control Signal
(Option)

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

# RK3576_H(VCCIO4)

## MODE1: CAM RX Signal(Default)

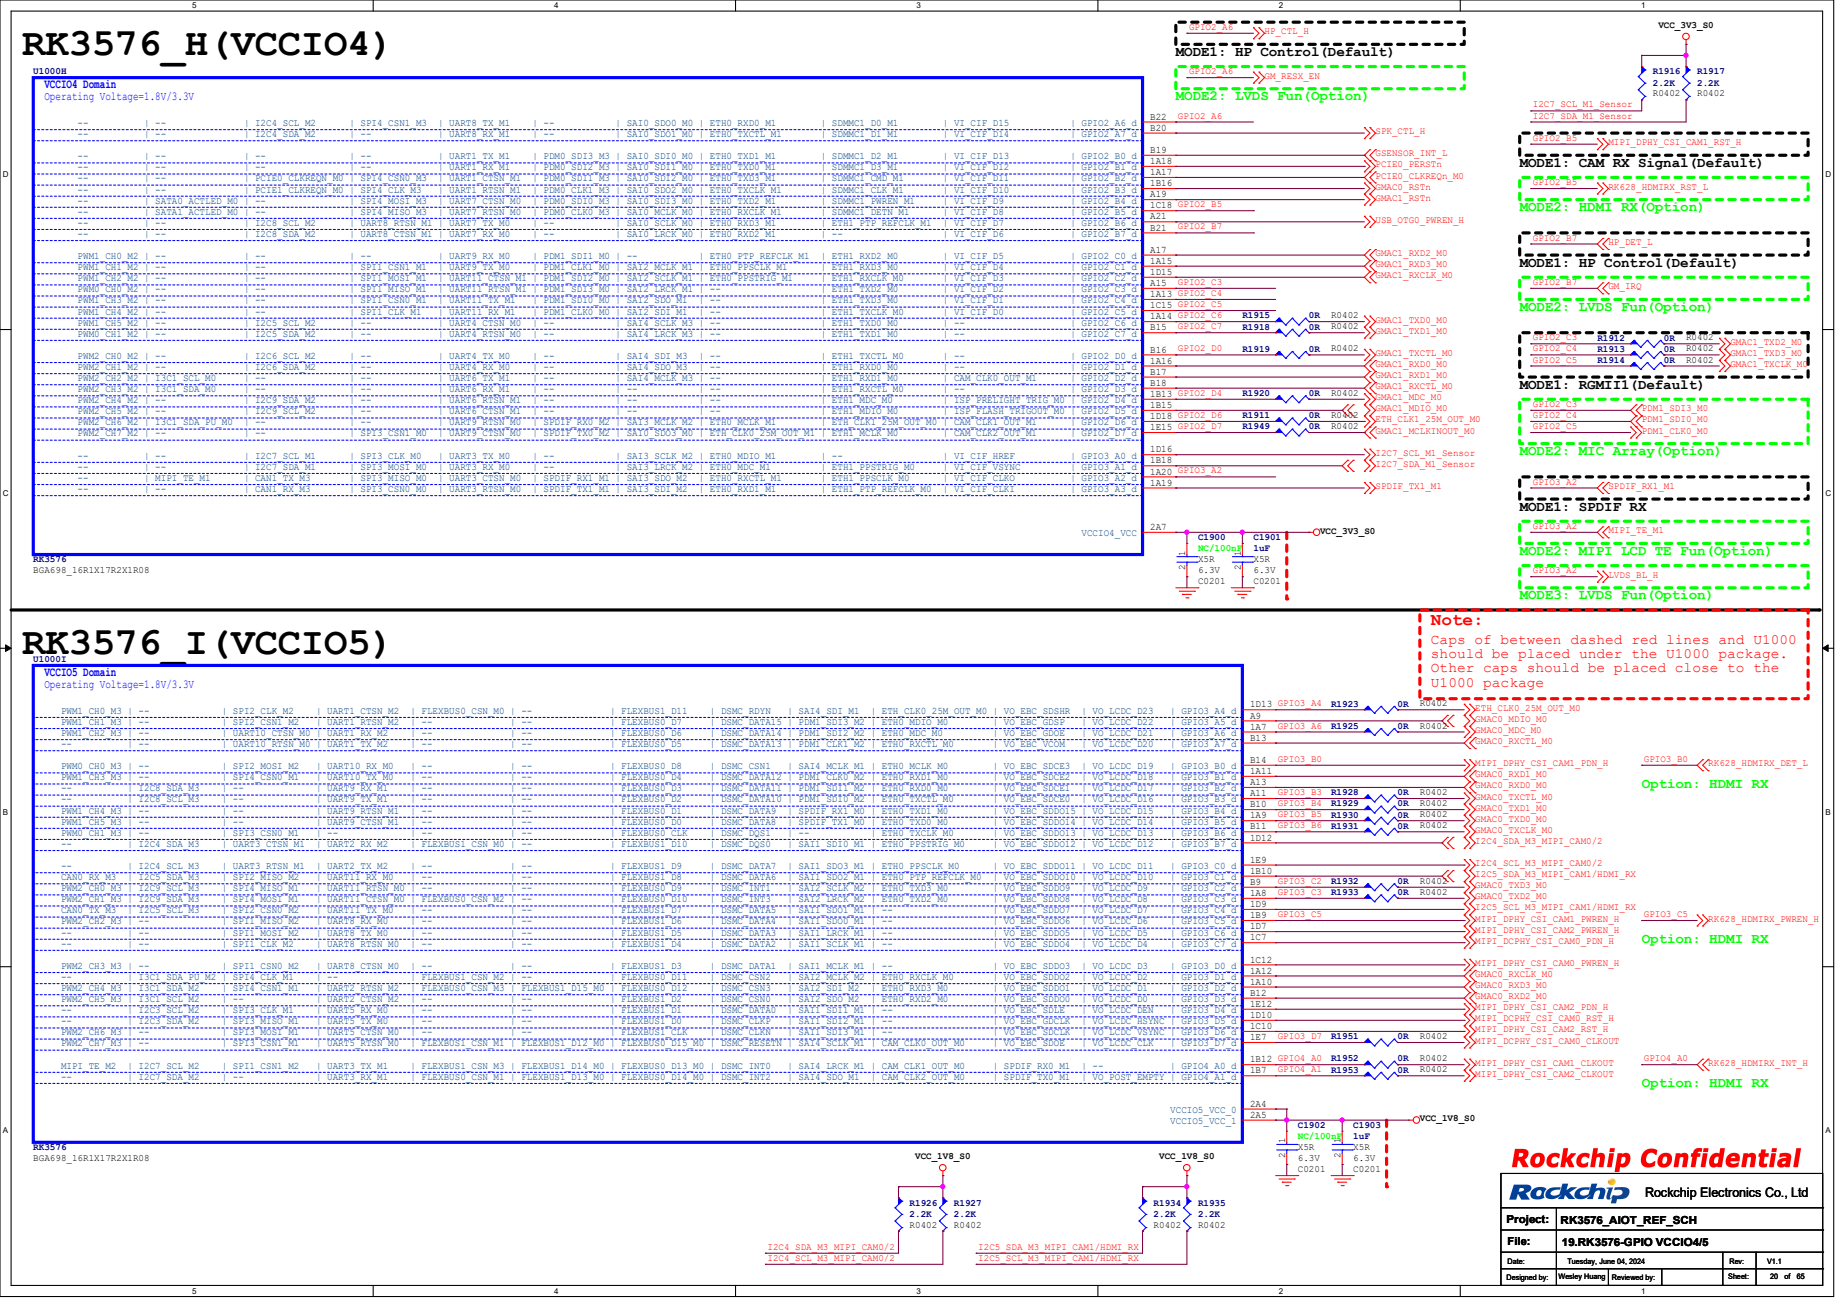
[picture p22: page 20]

GPIO3_A2
MODE2: MIPI LCD TE Fun(Option)

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

# 12V/3A DCIN

# When supporting multiple SATA or PCIe devices, the current must be designed

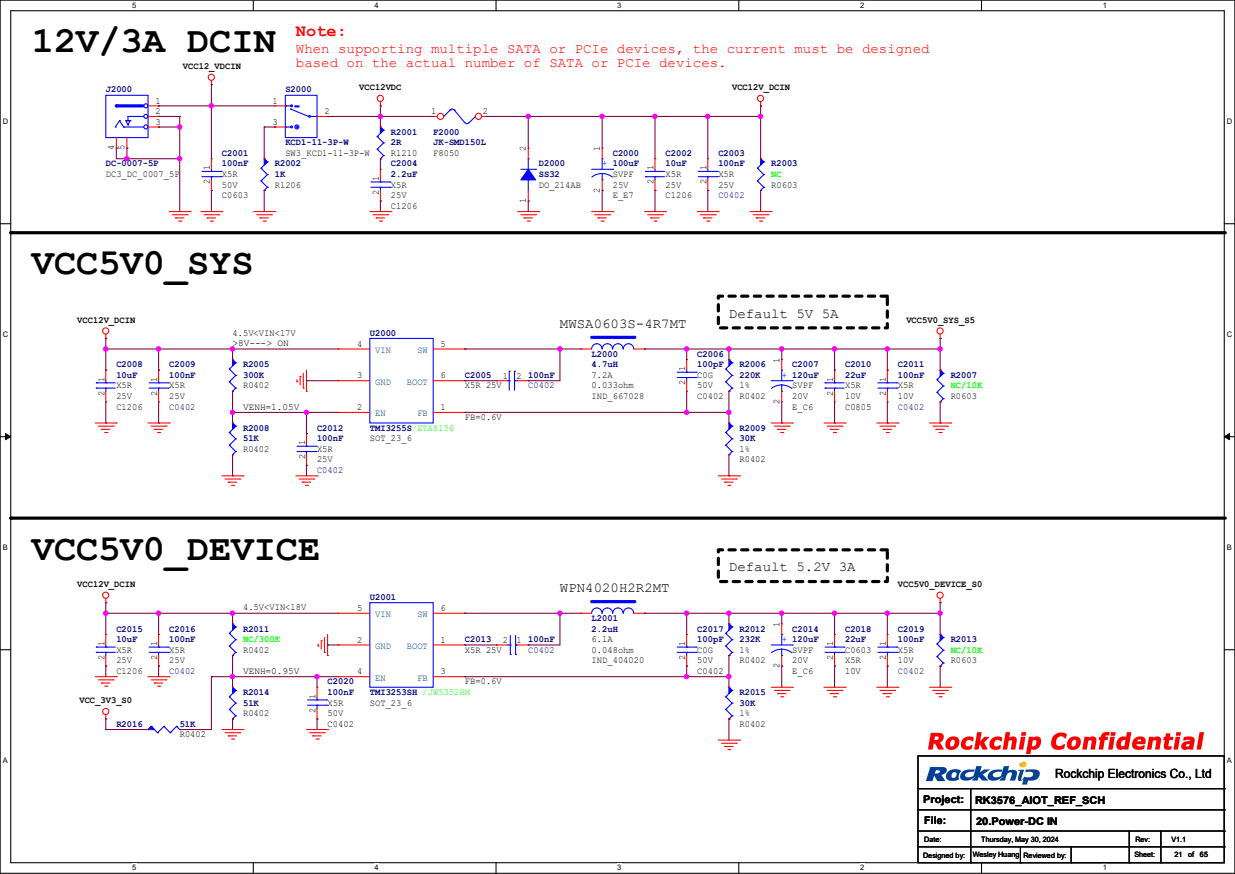
[picture p23: page 21]

based on the actual number of SATA or PCIe devices.

IF TVS UNMOUNTED,

# PMIC RK806S-5 BUCK

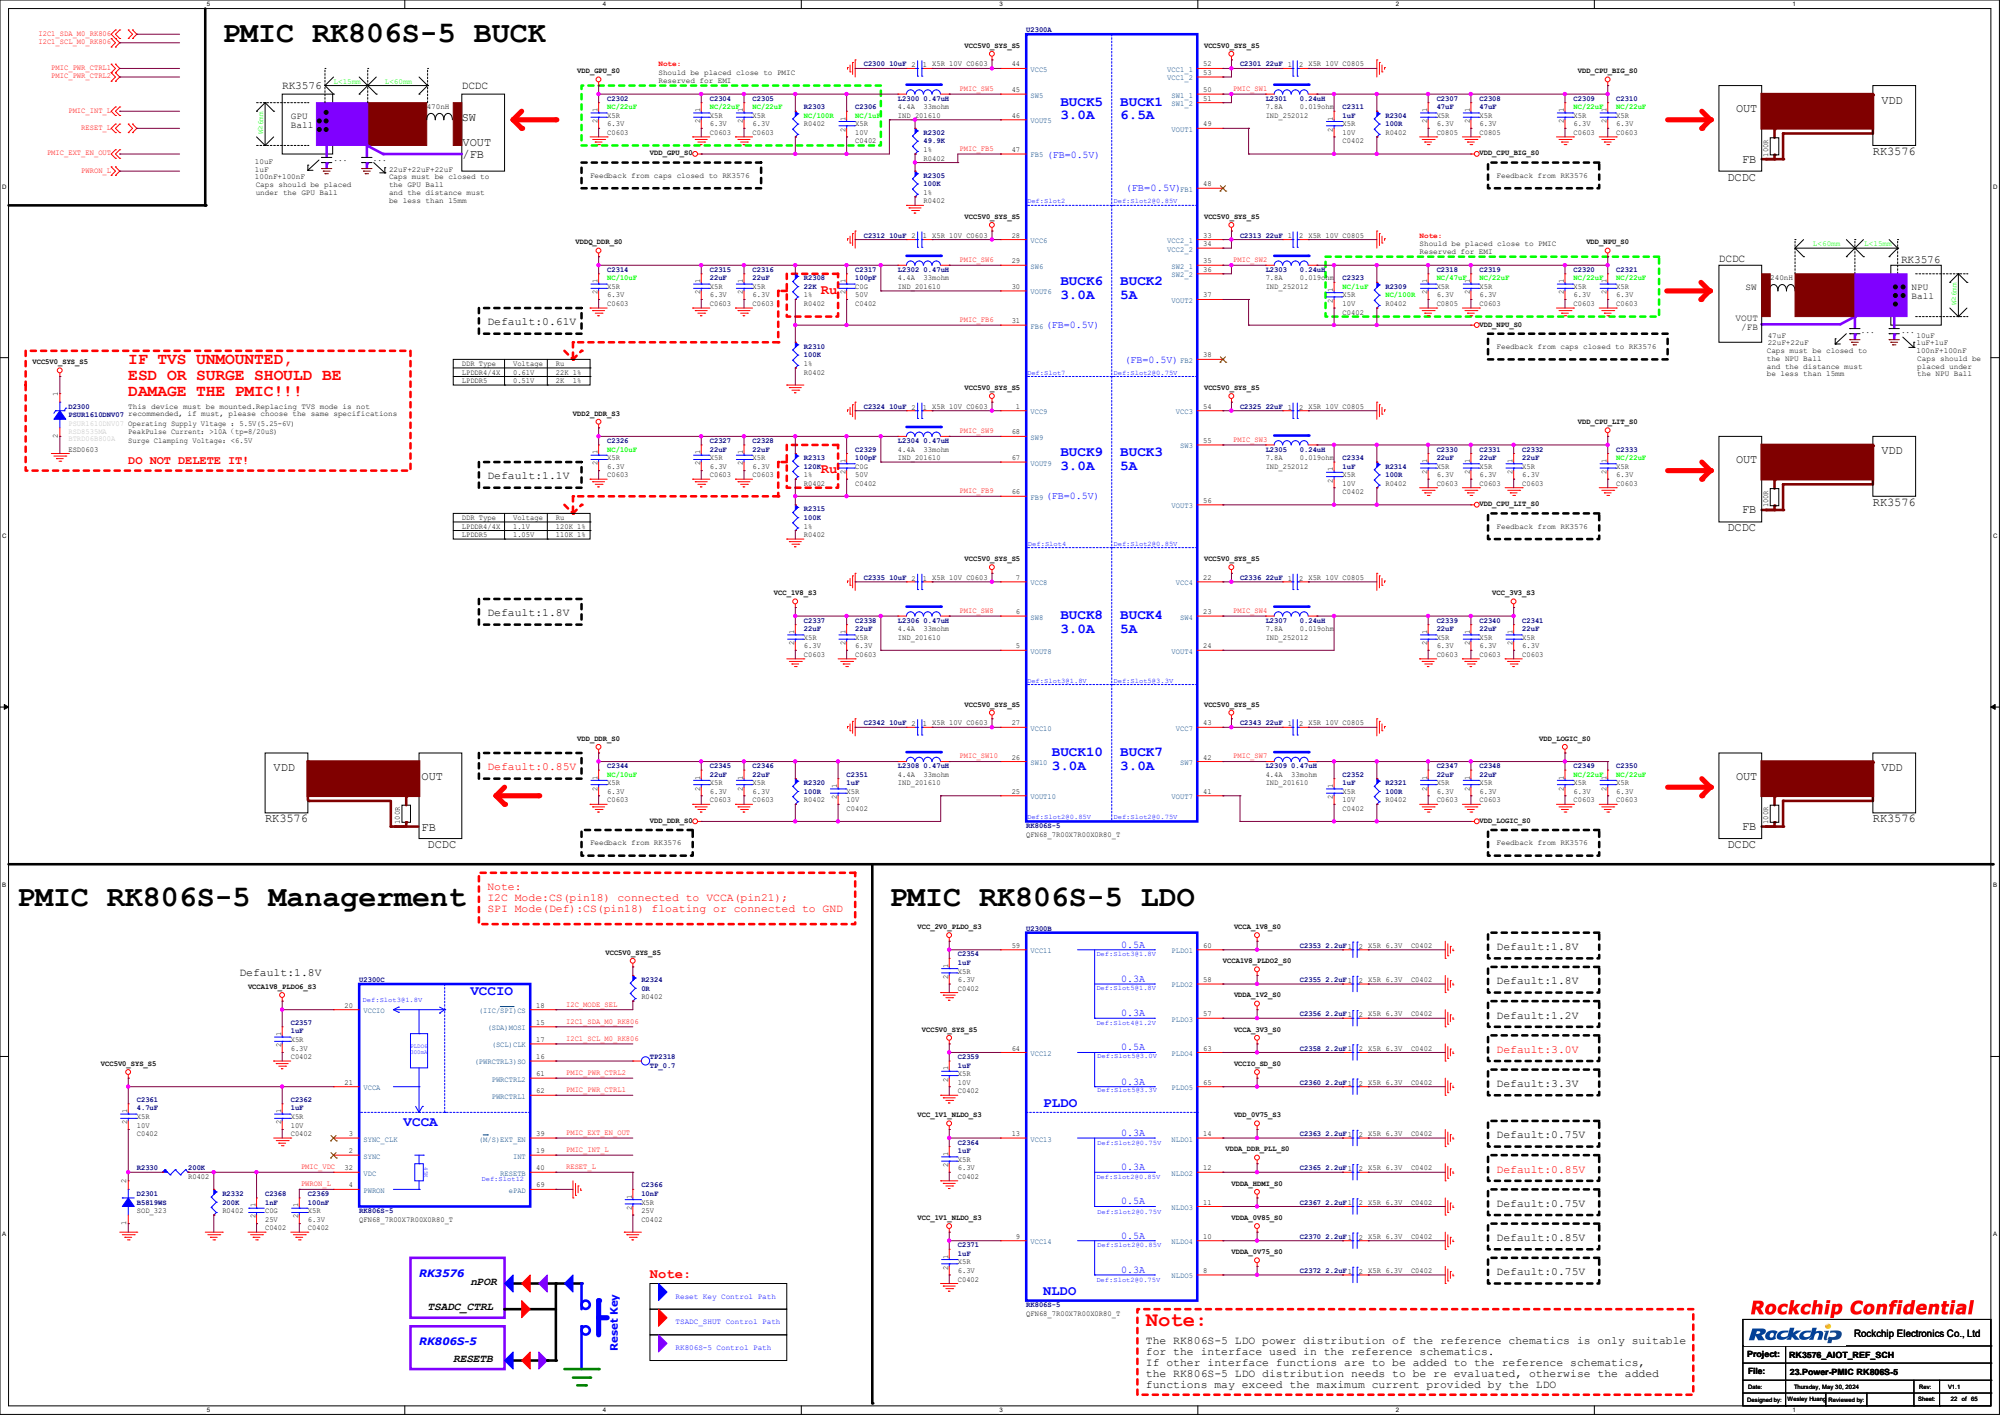
[picture p24: page 22]

Note:
Should be placed close to PMIC
Reserved for EMI

VDD Operating Supply Vltage ：5.5V(5.25-6V)

Caps must be closed to
the GPU Ball
and the distance must

Feedback from caps closed to RK3576

the NPU Ball
be less than 15mm

ESD OR SURGE SHOULD BE
DAMAGE THE PMIC!!!

This device must be mounted.Replacing TVS mode is not
recommended, if must, please choose the same specifications

PeakPulse Current：>10A（tp=8/20uS)
Surge Clamping Voltage：<6.5V
DO NOT DELETE IT!

I2C Mode:CS(pin18) connected to VCCA(pin21);
SPI Mode(Def):CS(pin18) floating or connected to GND

Reset Key Control Path

for the interface used in the reference schematics.
If other interface functions are to be added to the reference schematics,
the RK806S-5 LDO distribution needs to be re evaluated, otherwise the added
functions may exceed the maximum current provided by the LDO

## FB=0.6V 2.094V

## FB=0.6V

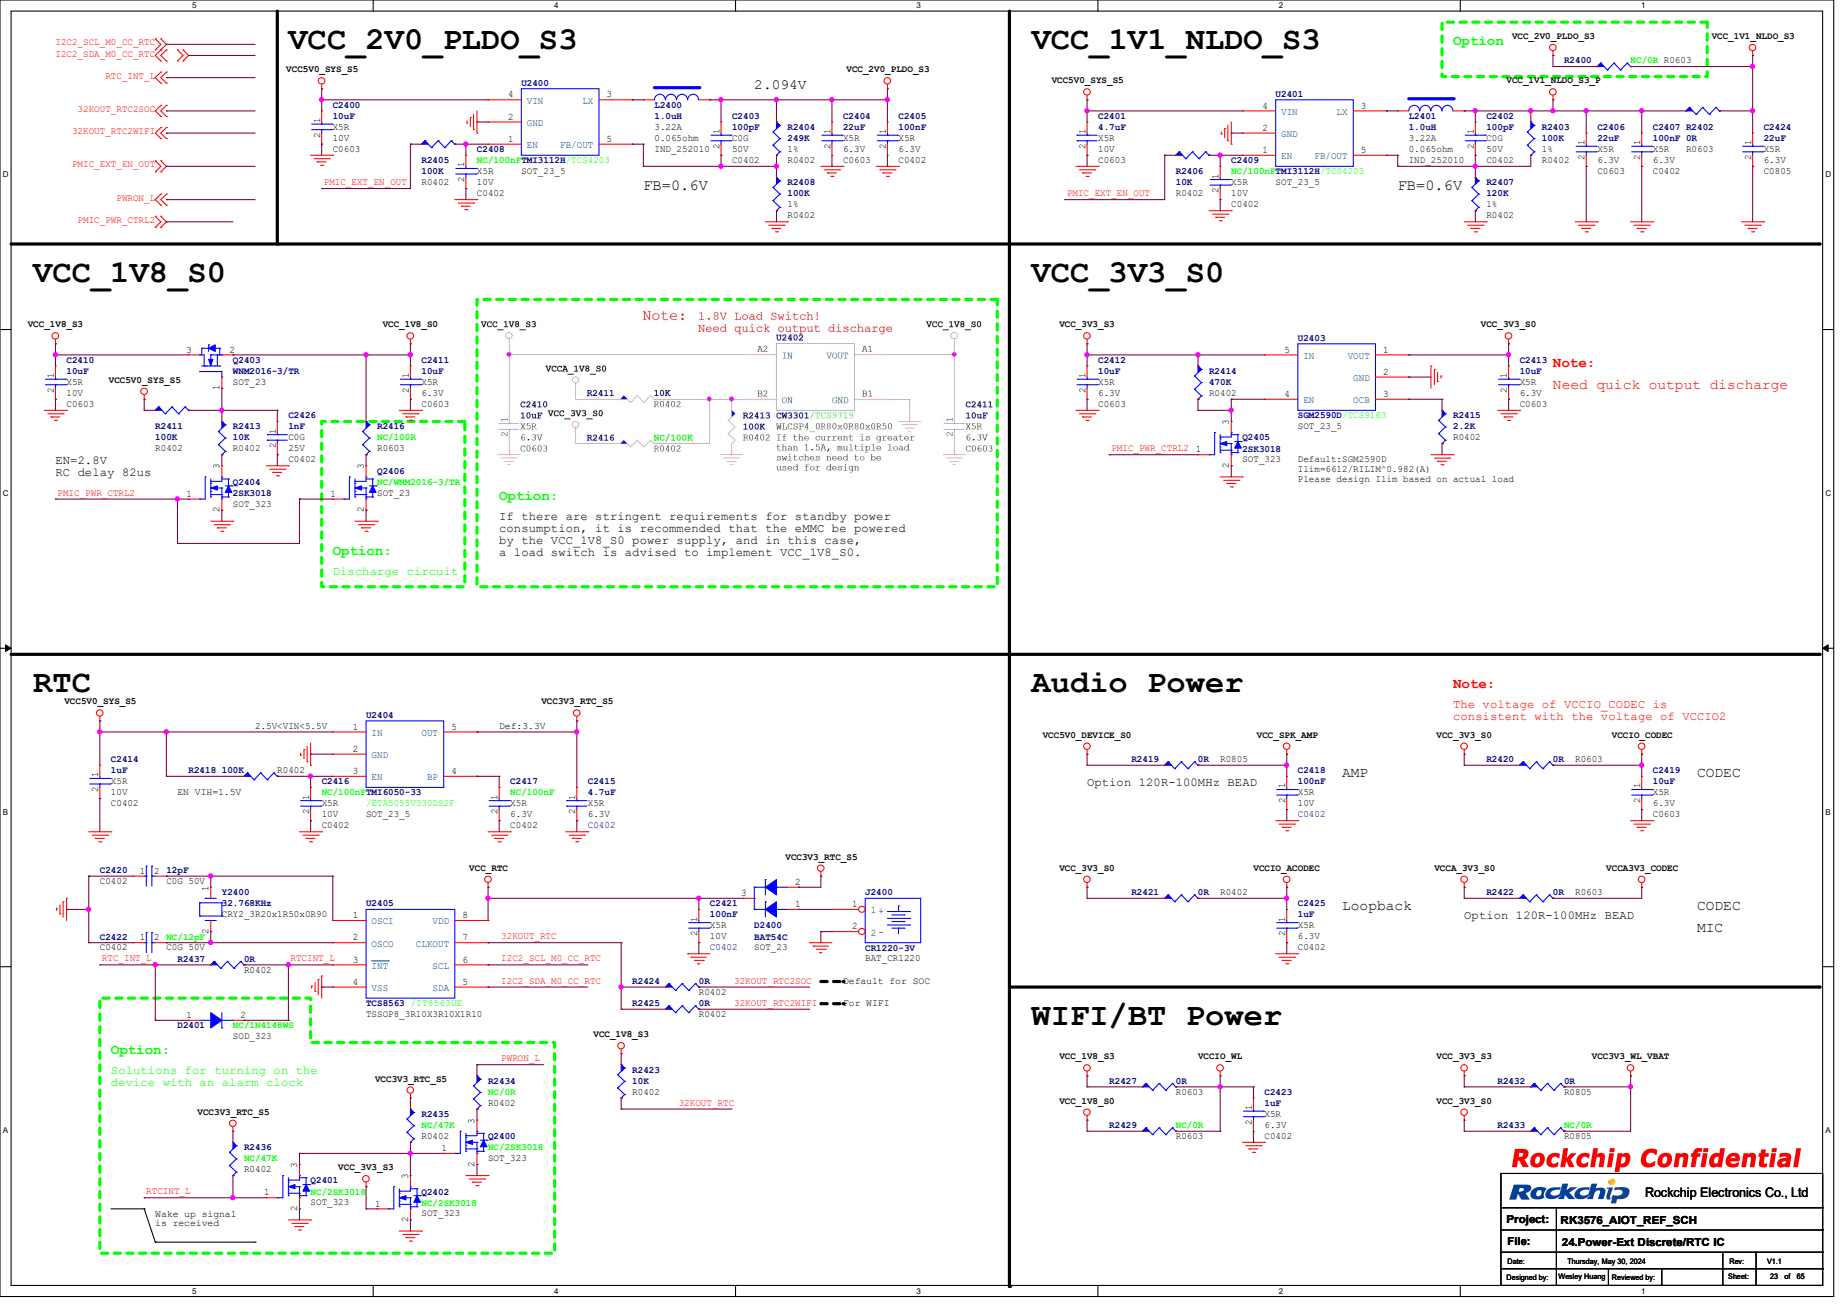
[picture p25: page 23]

Note:
Need quick output discharge

Ilim=6612/RILIM^0.982(A)
Please design Ilim based on actual load

Option:
If there are stringent requirements for standby power
consumption, it is recommended that the eMMC be powered
by the VCC_1V8_S0 power supply, and in this case,
a load switch is advised to implement VCC_1V8_S0.

The voltage of VCCIO_CODEC is
consistent with the voltage of VCCIO2 MIC

Solutions for turning on the
device with an alarm clock

24.Power-Ext Discrete/RTC IC

## With Displayport Alt Mode

# Note:

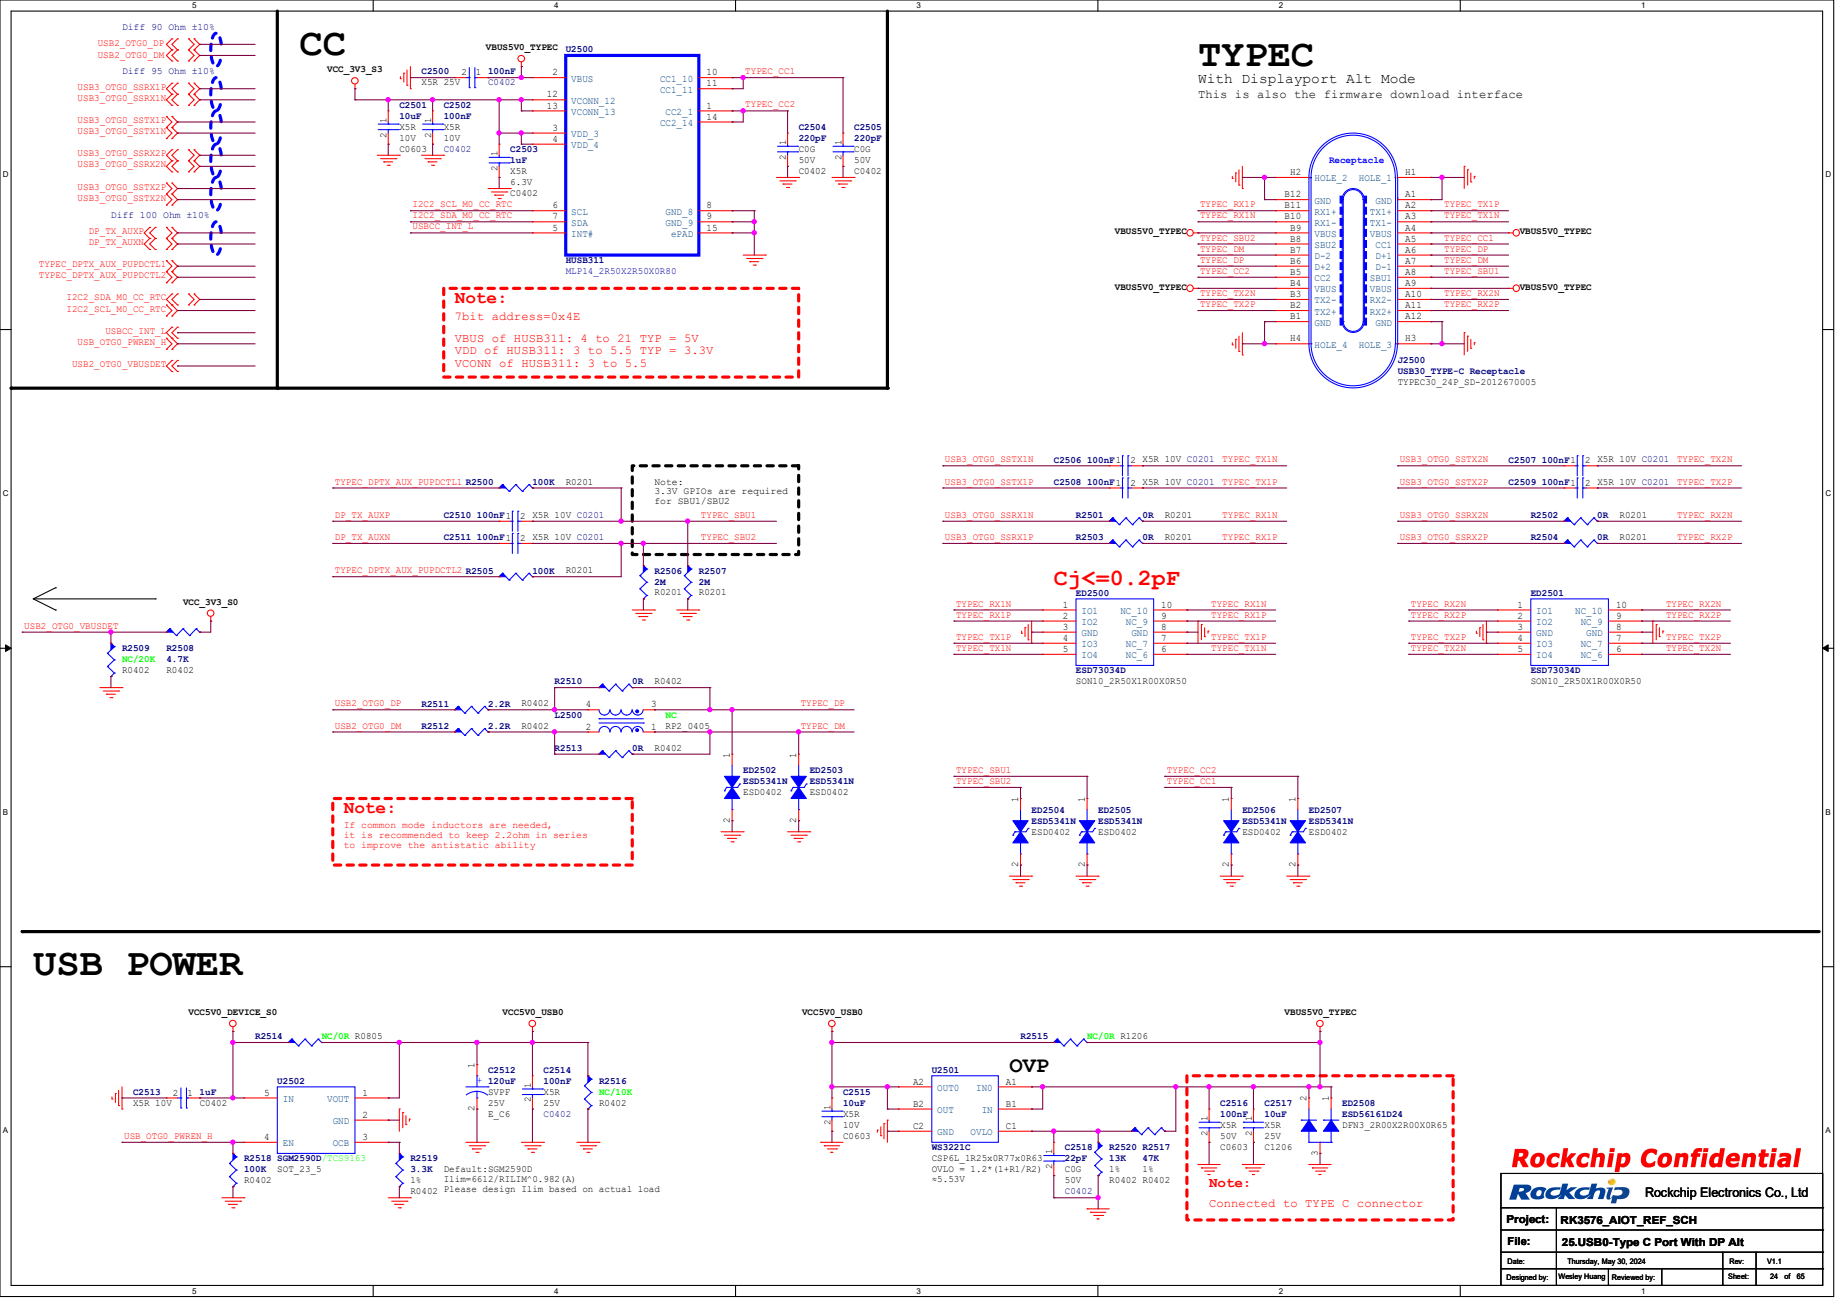
[picture p26: page 24]

This is also the firmware download interface

7bit address=0x4E
VBUS of HUSB311: 4 to 21 TYP = 5V
VDD of HUSB311: 3 to 5.5 TYP = 3.3V
VCONN of HUSB311: 3 to 5.5

If common mode inductors are needed,
it is recommended to keep 2.2ohm in series
to improve the antistatic ability

Connected to TYPE C connector VCC5V0_USB0

Default:SGM2590D
Ilim=6612/RILIM^0.982(A)
Please design Ilim based on actual load

25.USB0-Type C Port With DP Alt

# USB2.0 OTG0-Mirco Port (Together with DP 4Lanes)

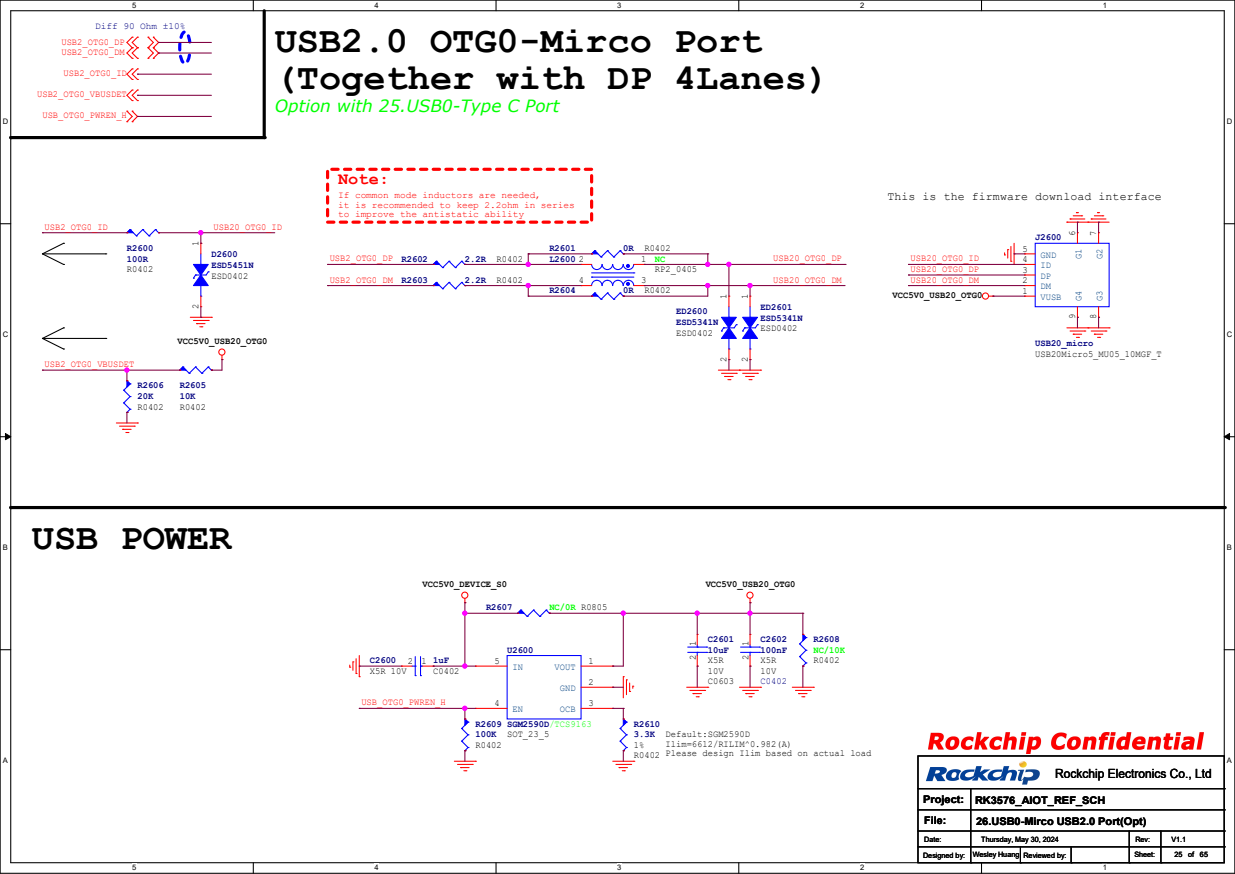
[picture p27: page 25]

Option with 25.USB0-Type C Port

Note:
If common mode inductors are needed,
it is recommended to keep 2.2ohm in series
to improve the antistatic ability

This is the firmware download interface

# USB3 OTG0-TypeA (Together with DP 2Lanes)

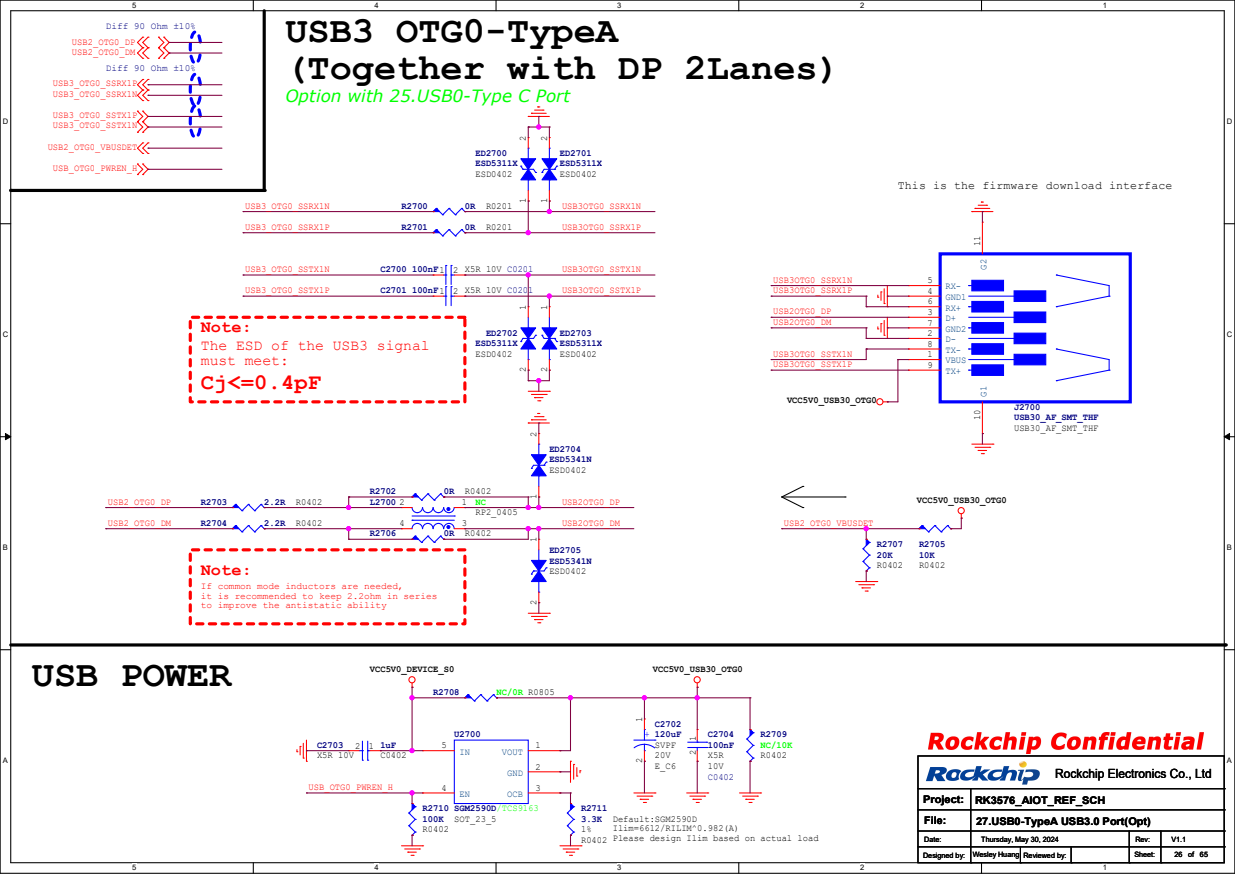
[picture p28: page 26]

Option with 25.USB0-Type C Port

This is the firmware download interface

Note:
The ESD of the USB3 signal
must meet:

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

# USB20_HUB+USB3.0 HOST

# Cj<=0.4pF

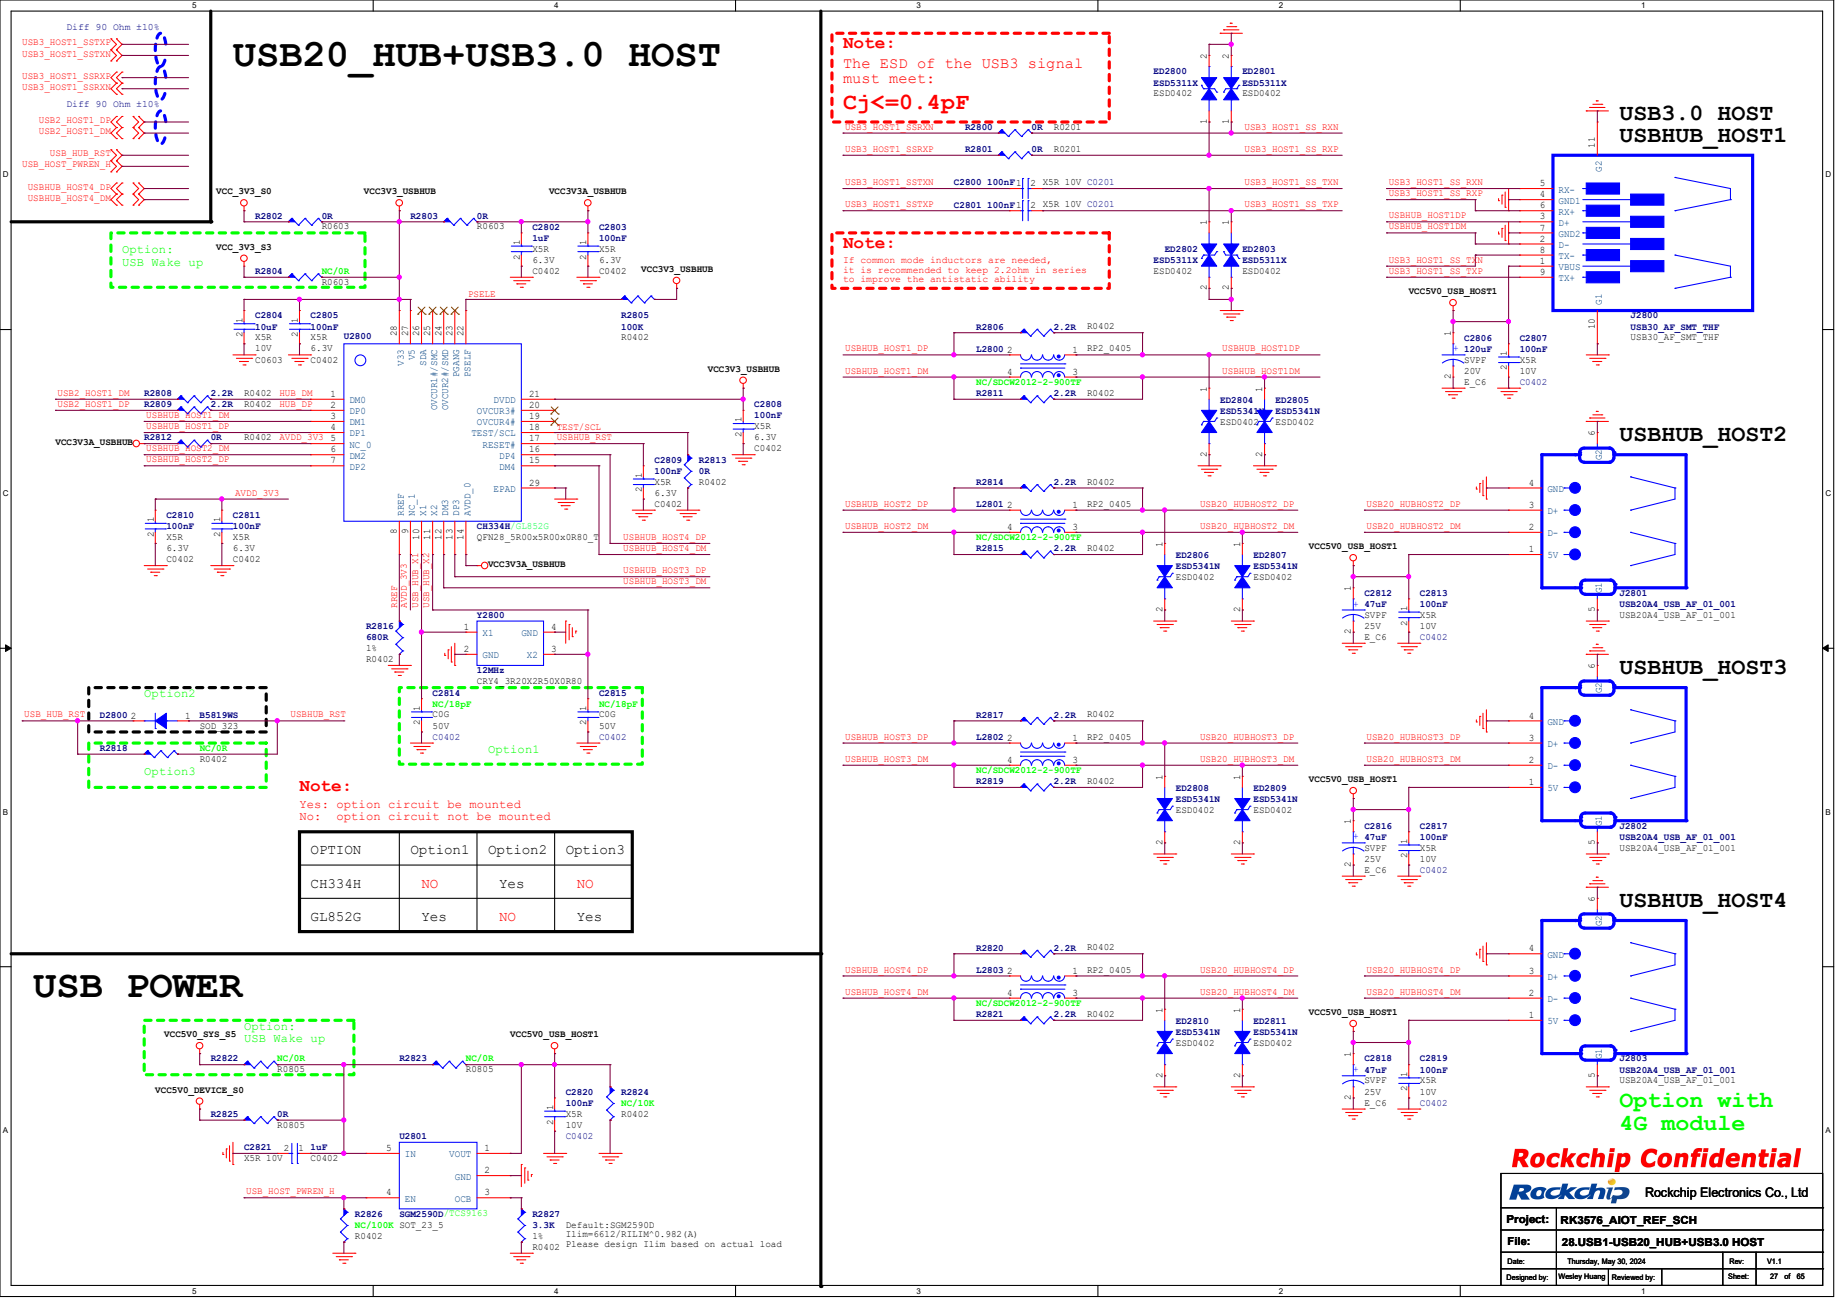
[picture p29: page 27]

Note:
The ESD of the USB3 signal
must meet:

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

9 X1 10 X2 11 DM3 12 DP3 13 AVDD_0 14 V33 28 V5 27 SDA 26 OVCUR1#/SMC 25 OVCUR2#/SMD 24 PGANG 23 PSELF 22

Yes: option circuit be mounted
No: option circuit not be mounted

Ilim=6612/RILIM^0.982(A)
Please design Ilim based on actual load

# Cj<=0.4pF

# The ESD of the USB3 signal

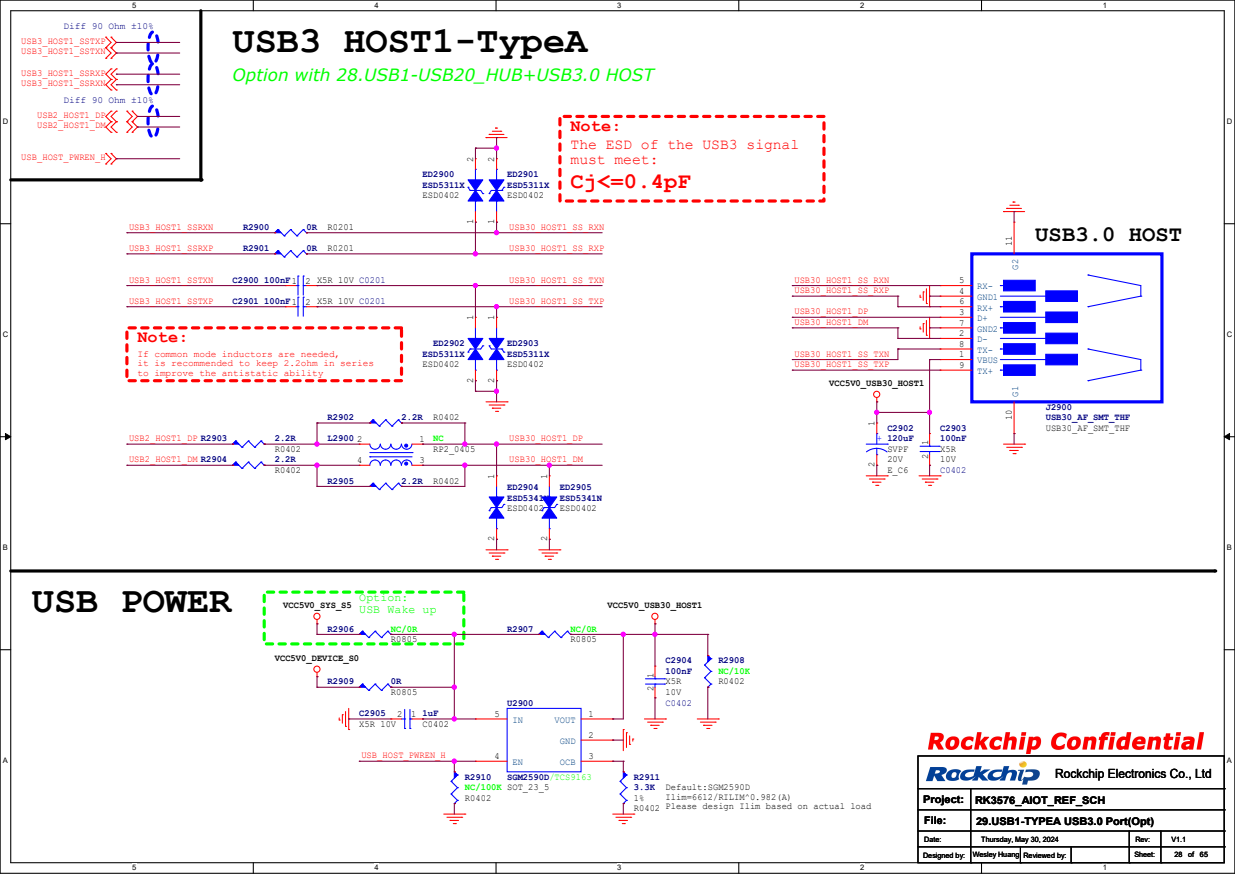
[picture p30: page 28]
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

# LPDDR4/4X

# VDD1

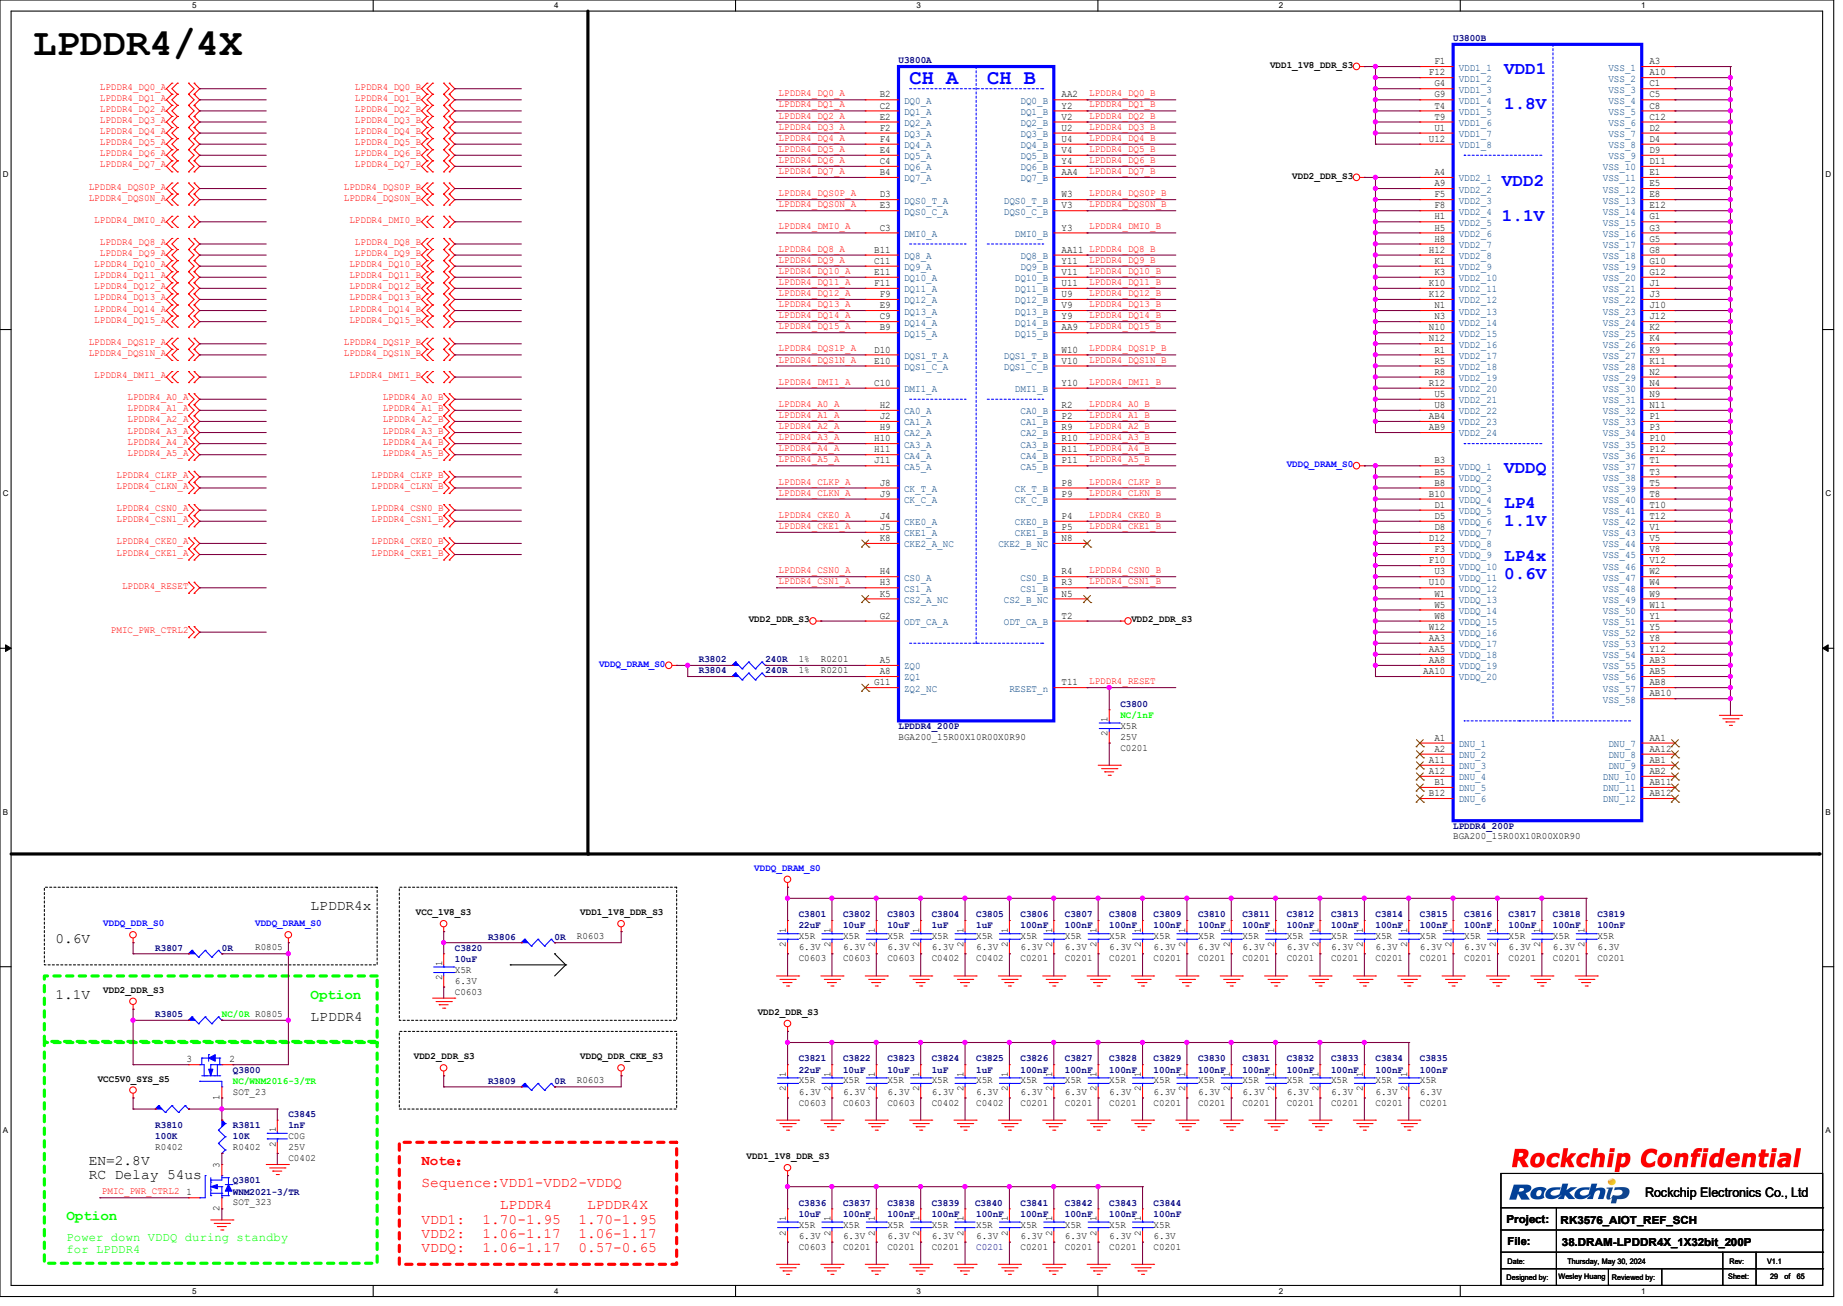
[picture p31: page 29]

Power down VDDQ during standby
for LPDDR4

# VDDQ

0.5V

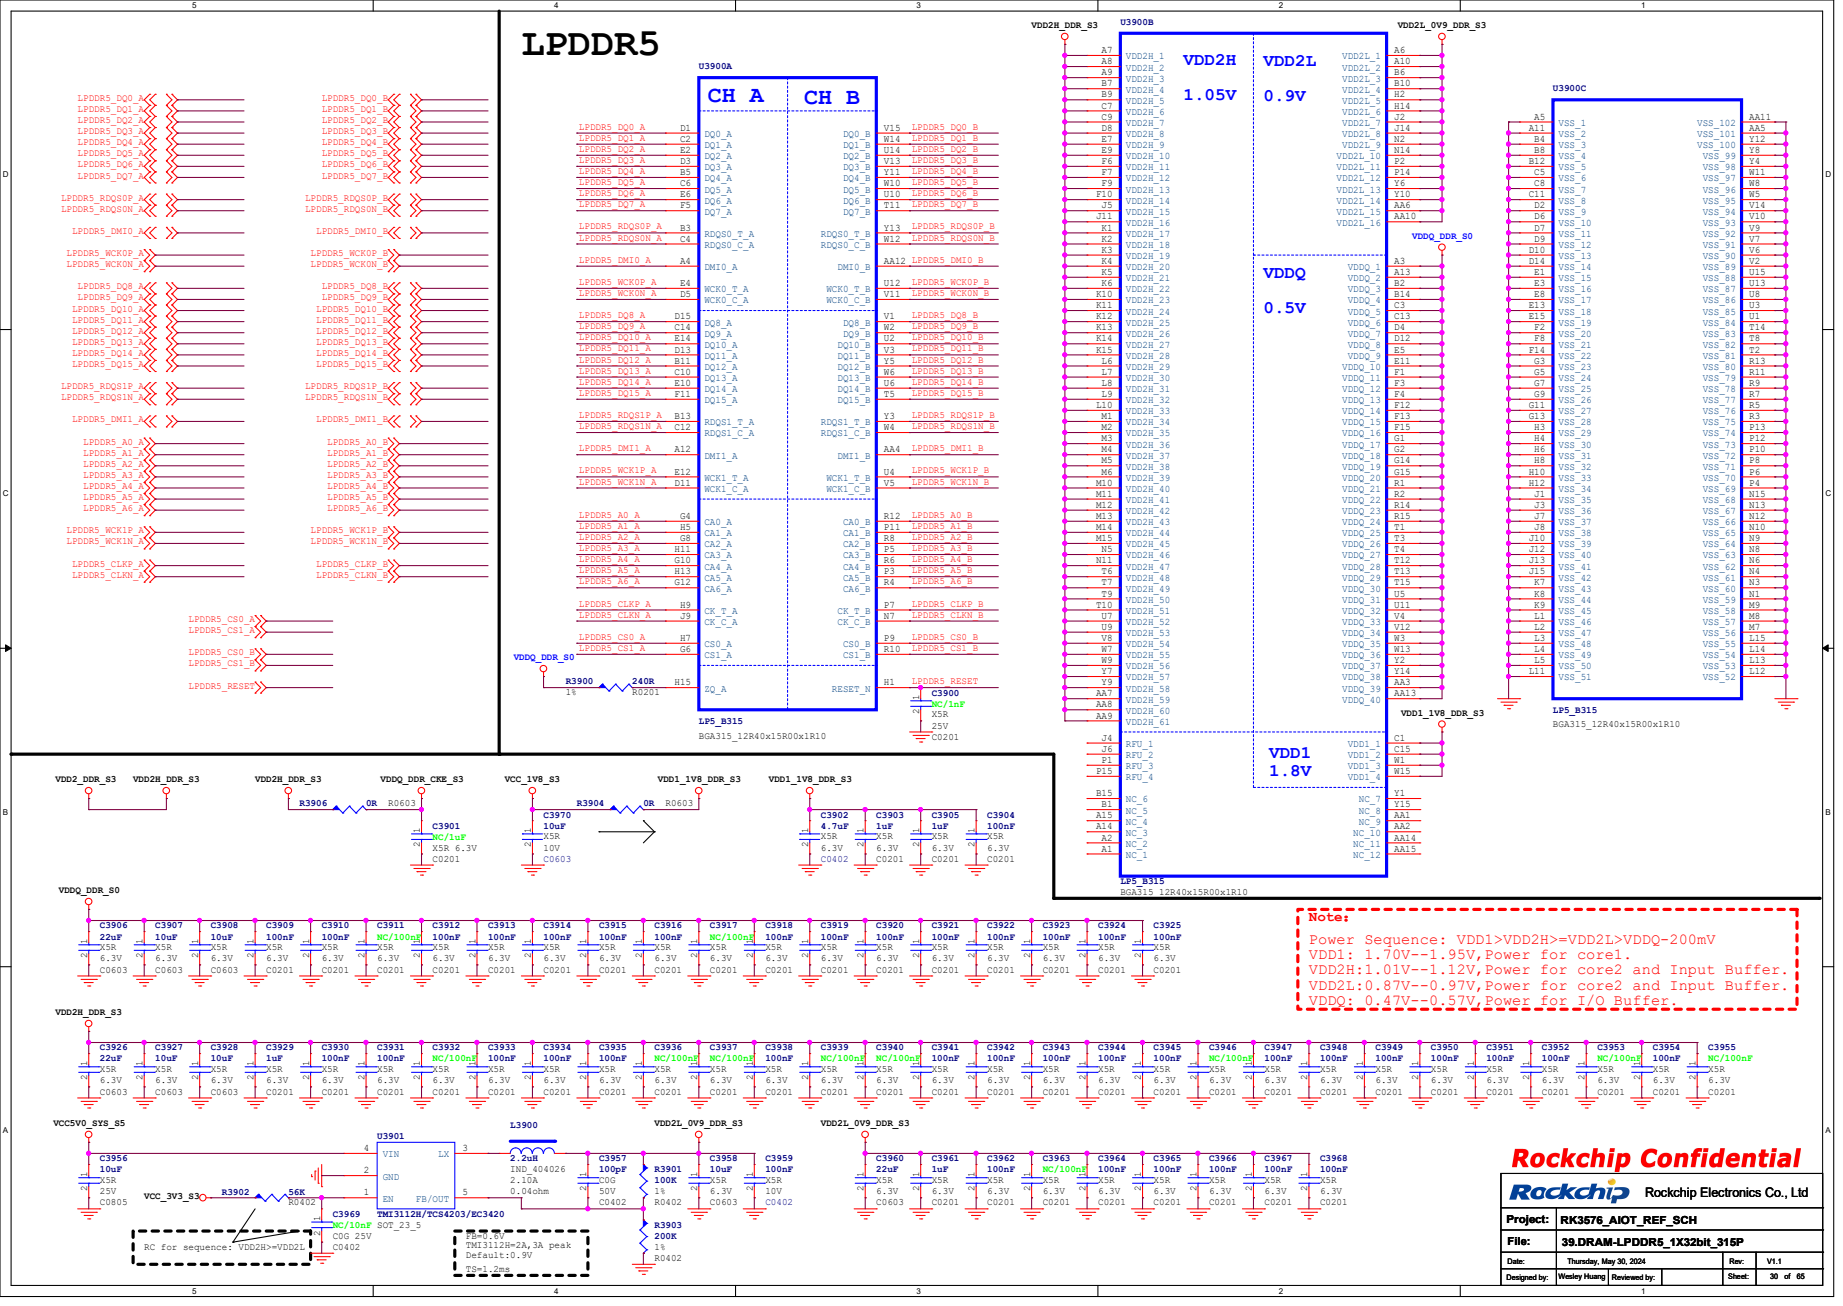
[picture p32: page 30]

VDD1: 1.70V--1.95V,Power for core1.
VDD2H:1.01V--1.12V,Power for core2 and Input Buffer.
VDD2L:0.87V--0.97V,Power for core2 and Input Buffer.

# eMMC FLASH

## VCC_1V8_S3

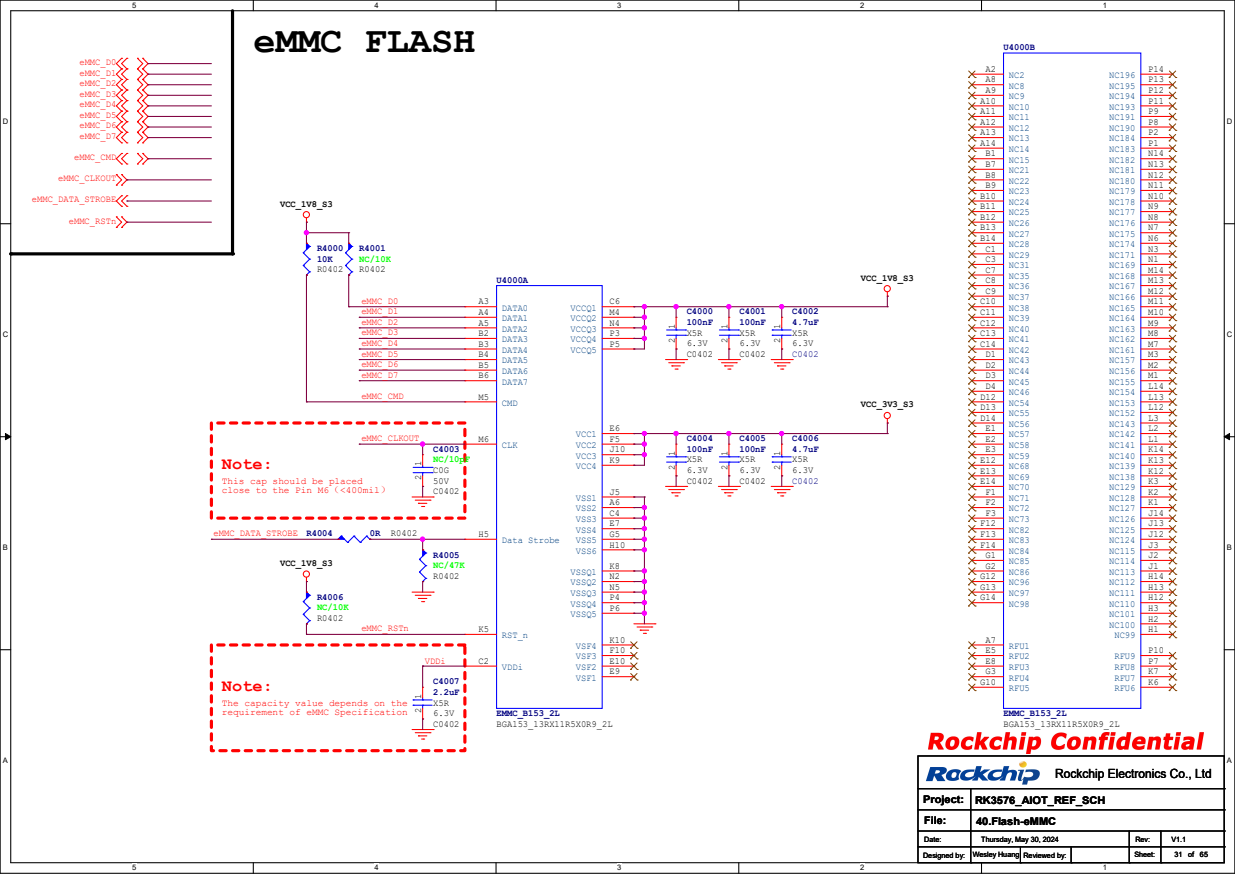
[picture p33: page 31]

Note:
This cap should be placed
close to the Pin M6（<400mil）

The capacity value depends on the
requirement of eMMC Specification

## UFS2.1

1.2V

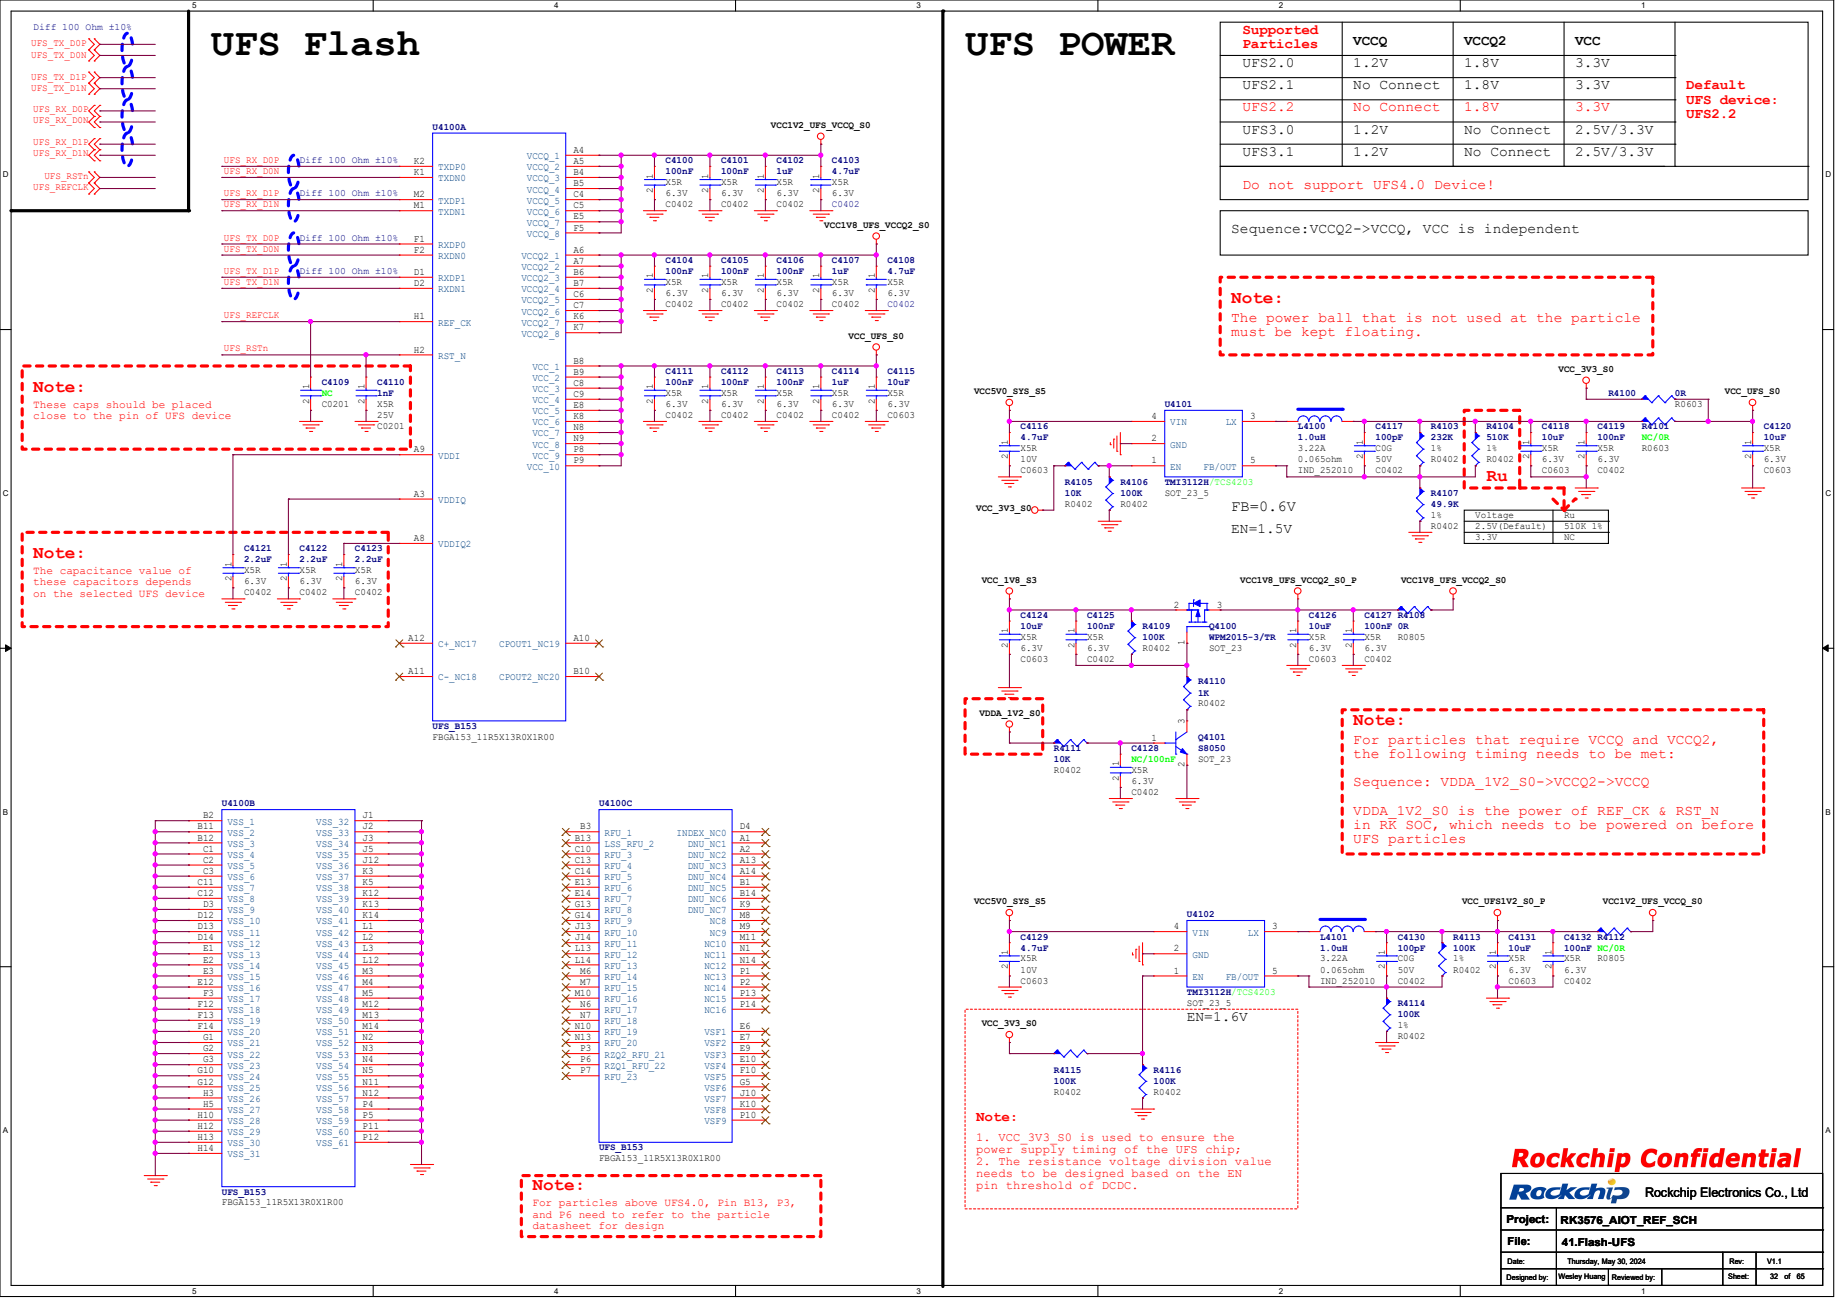
[picture p34: page 32]

Supported
Particles Sequence:VCCQ2->VCCQ, VCC is independent

UFS2.2
UFS2.2 The power ball that is not used at the particle
UFS3.0
UFS3.1

Do not support UFS4.0 Device!

must be kept floating.

Note:
These caps should be placed
close to the pin of UFS device

The capacitance value of
these capacitors depends
on the selected UFS device

For particles that require VCCQ and VCCQ2,
the following timing needs to be met:
Sequence: VDDA_1V2_S0->VCCQ2->VCCQ
VDDA_1V2_S0 is the power of REF_CK & RST_N
in RK SOC, which needs to be powered on before
UFS particles

1. VCC_3V3_S0 is used to ensure the
power supply timing of the UFS chip;
2. The resistance voltage division value
needs to be designed based on the EN
pin threshold of DCDC.

For particles above UFS4.0, Pin B13, P3,
and P6 need to refer to the particle
datasheet for design

# TF CARD

Note: | Default:SGM2590D

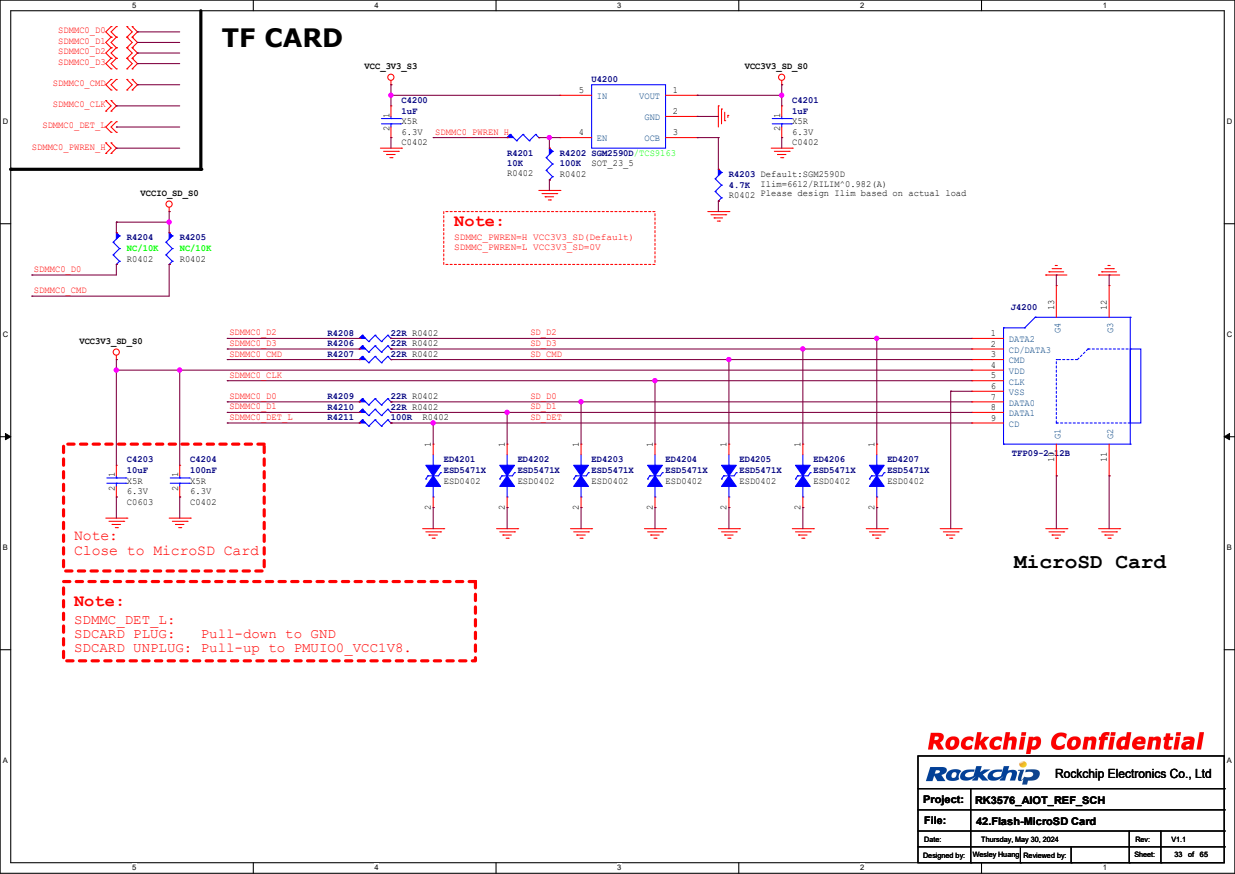
[picture p35: page 33]

5 6

Note:
Close to MicroSD Card

SDMMC_DET_L:
SDCARD UNPLUG: Pull-up to PMUIO0_VCC1V8.

# FSPI0 Flash

# Option with 40.Flash-eMMC

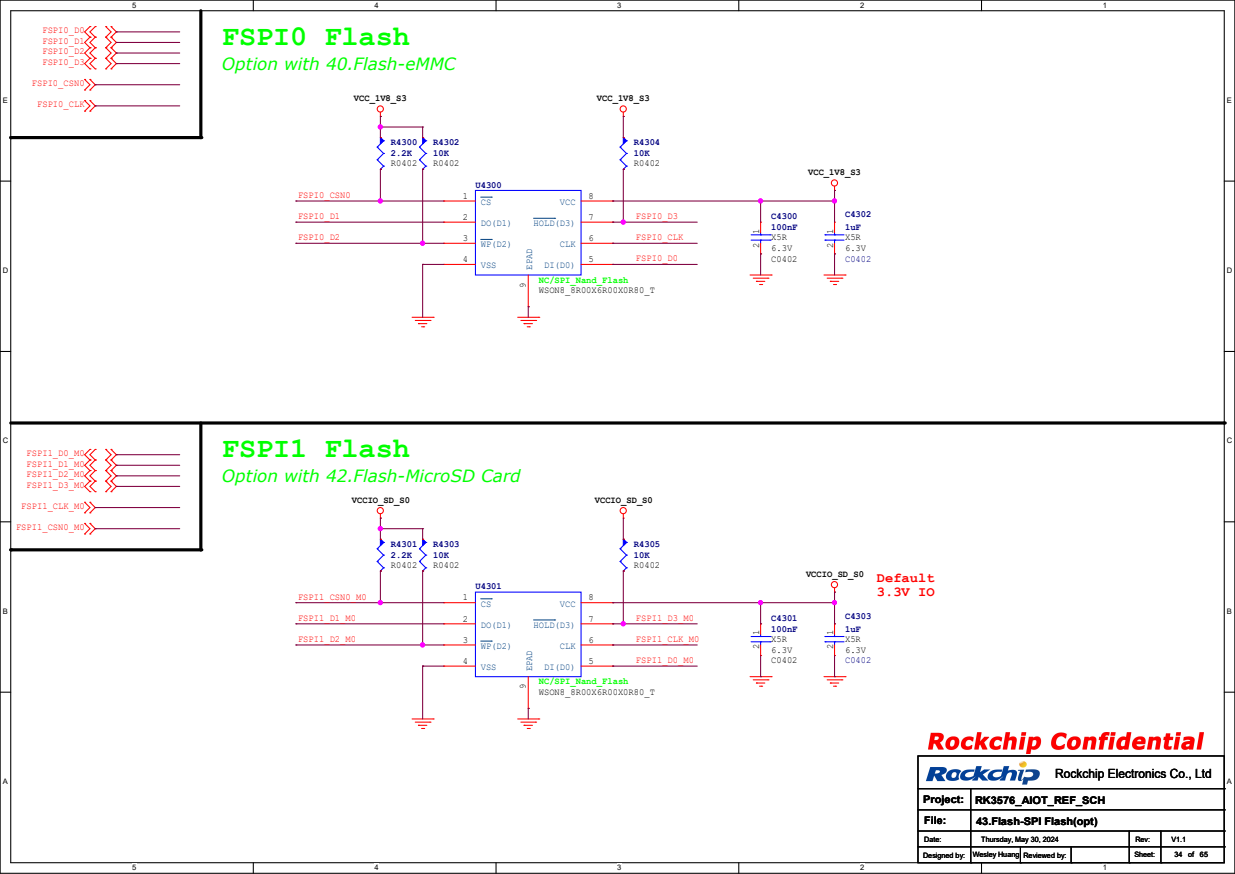
[picture p36: page 34]

FSPI1 Flash
Option with 42.Flash-MicroSD Card

RK3576_AIOT_REF_SCH
43.Flash-SPI Flash(opt)

# CAM0: VI-CAM MIPI DPHY CSI0 RX

# 30 G_31 31 G_32 32 G_33 33 G_34 34

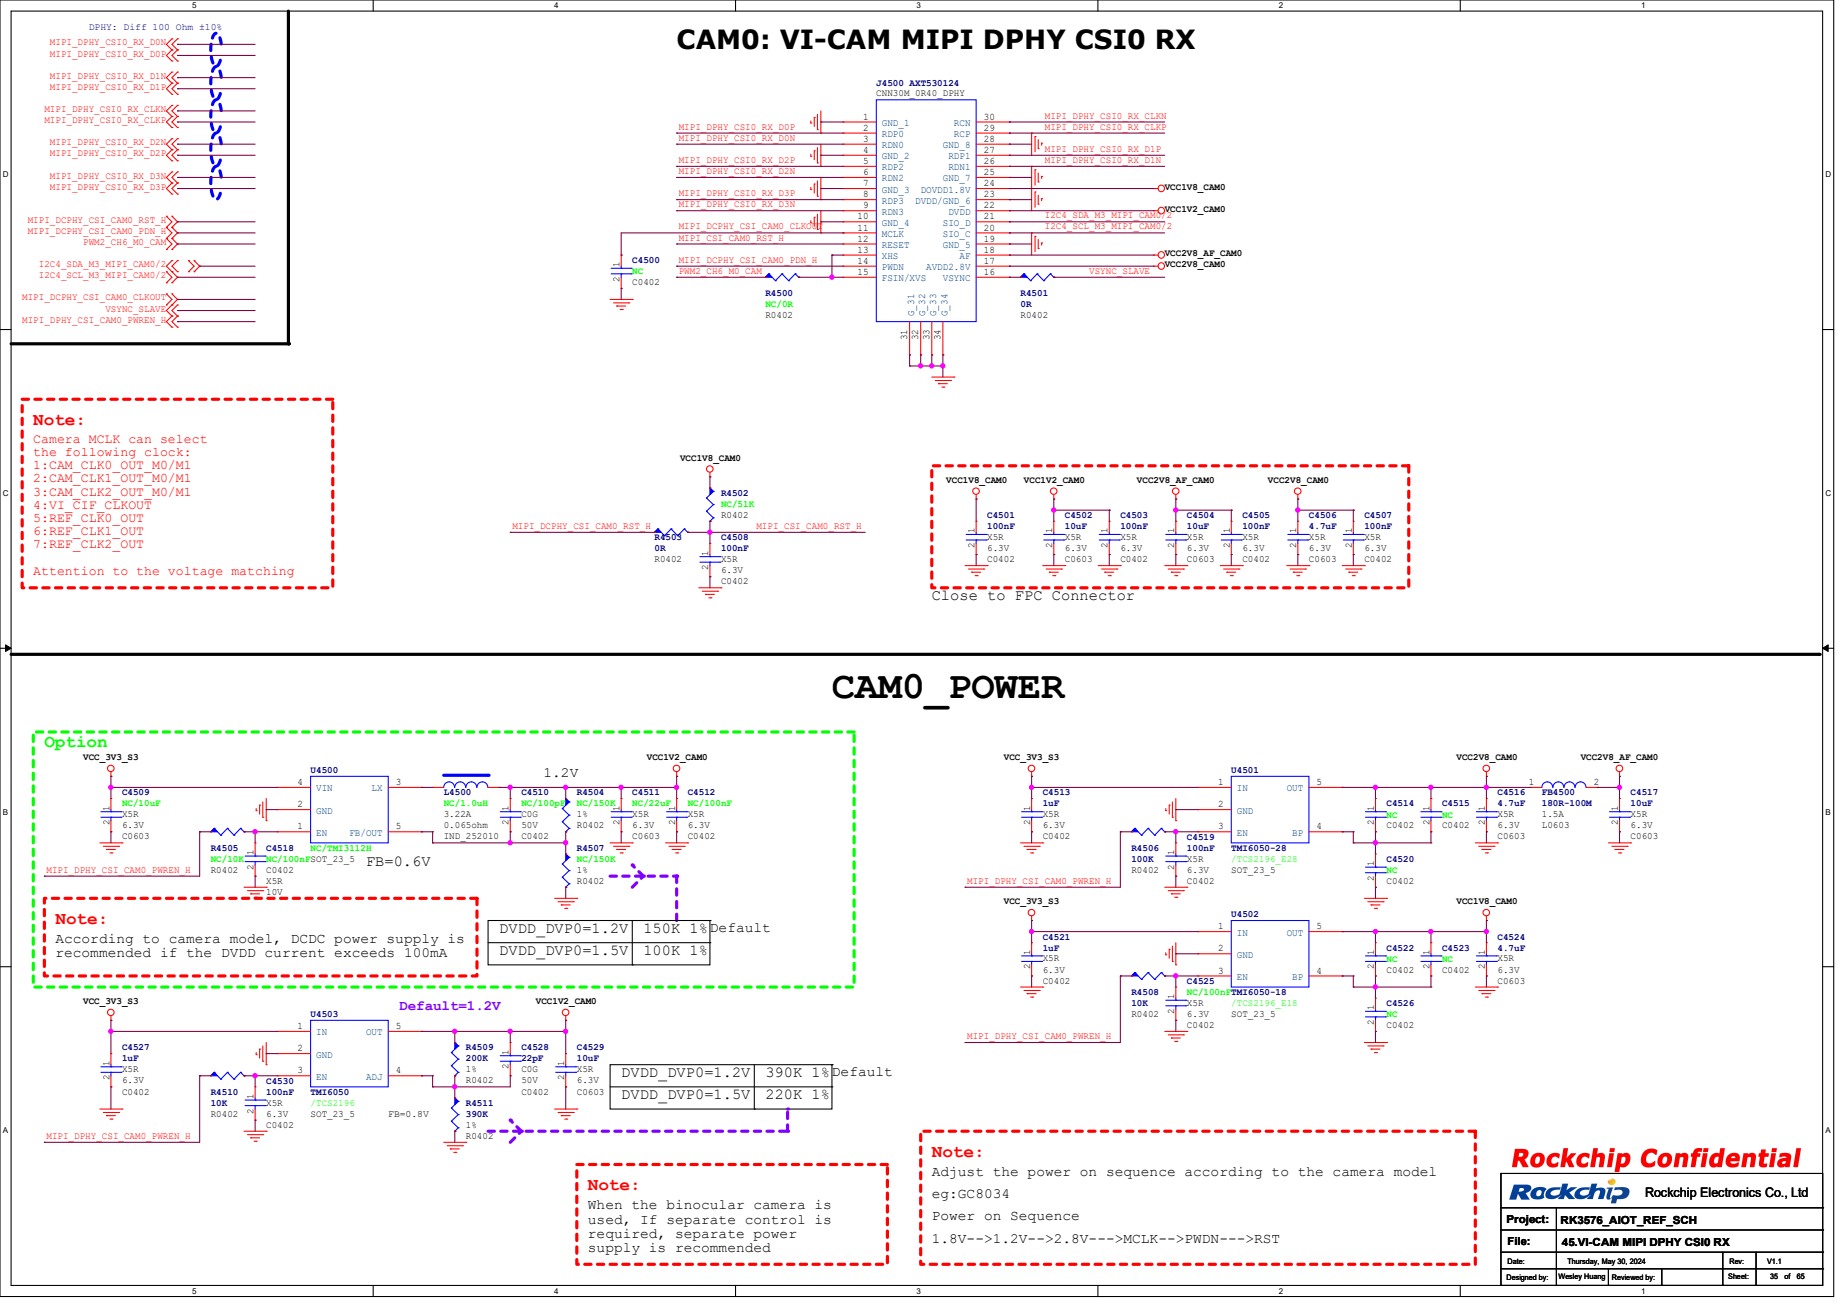
[picture p37: page 35]

Close to FPC Connector
CAM0_POWER

DVDD_DVP0=1.2V According to camera model, DCDC power supply is

Note: When the binocular camera is
Note:

Adjust the power on sequence according to the camera model
Power on Sequence
1.8V-->1.2V-->2.8V--->MCLK-->PWDN--->RST

used, If separate control is
required, separate power
supply is recommended

# CAM1: VI-CAM MIPI DPHY CSI1/2 RX

# 30 G_31 31 G_32 32 G_33 33 G_34 34

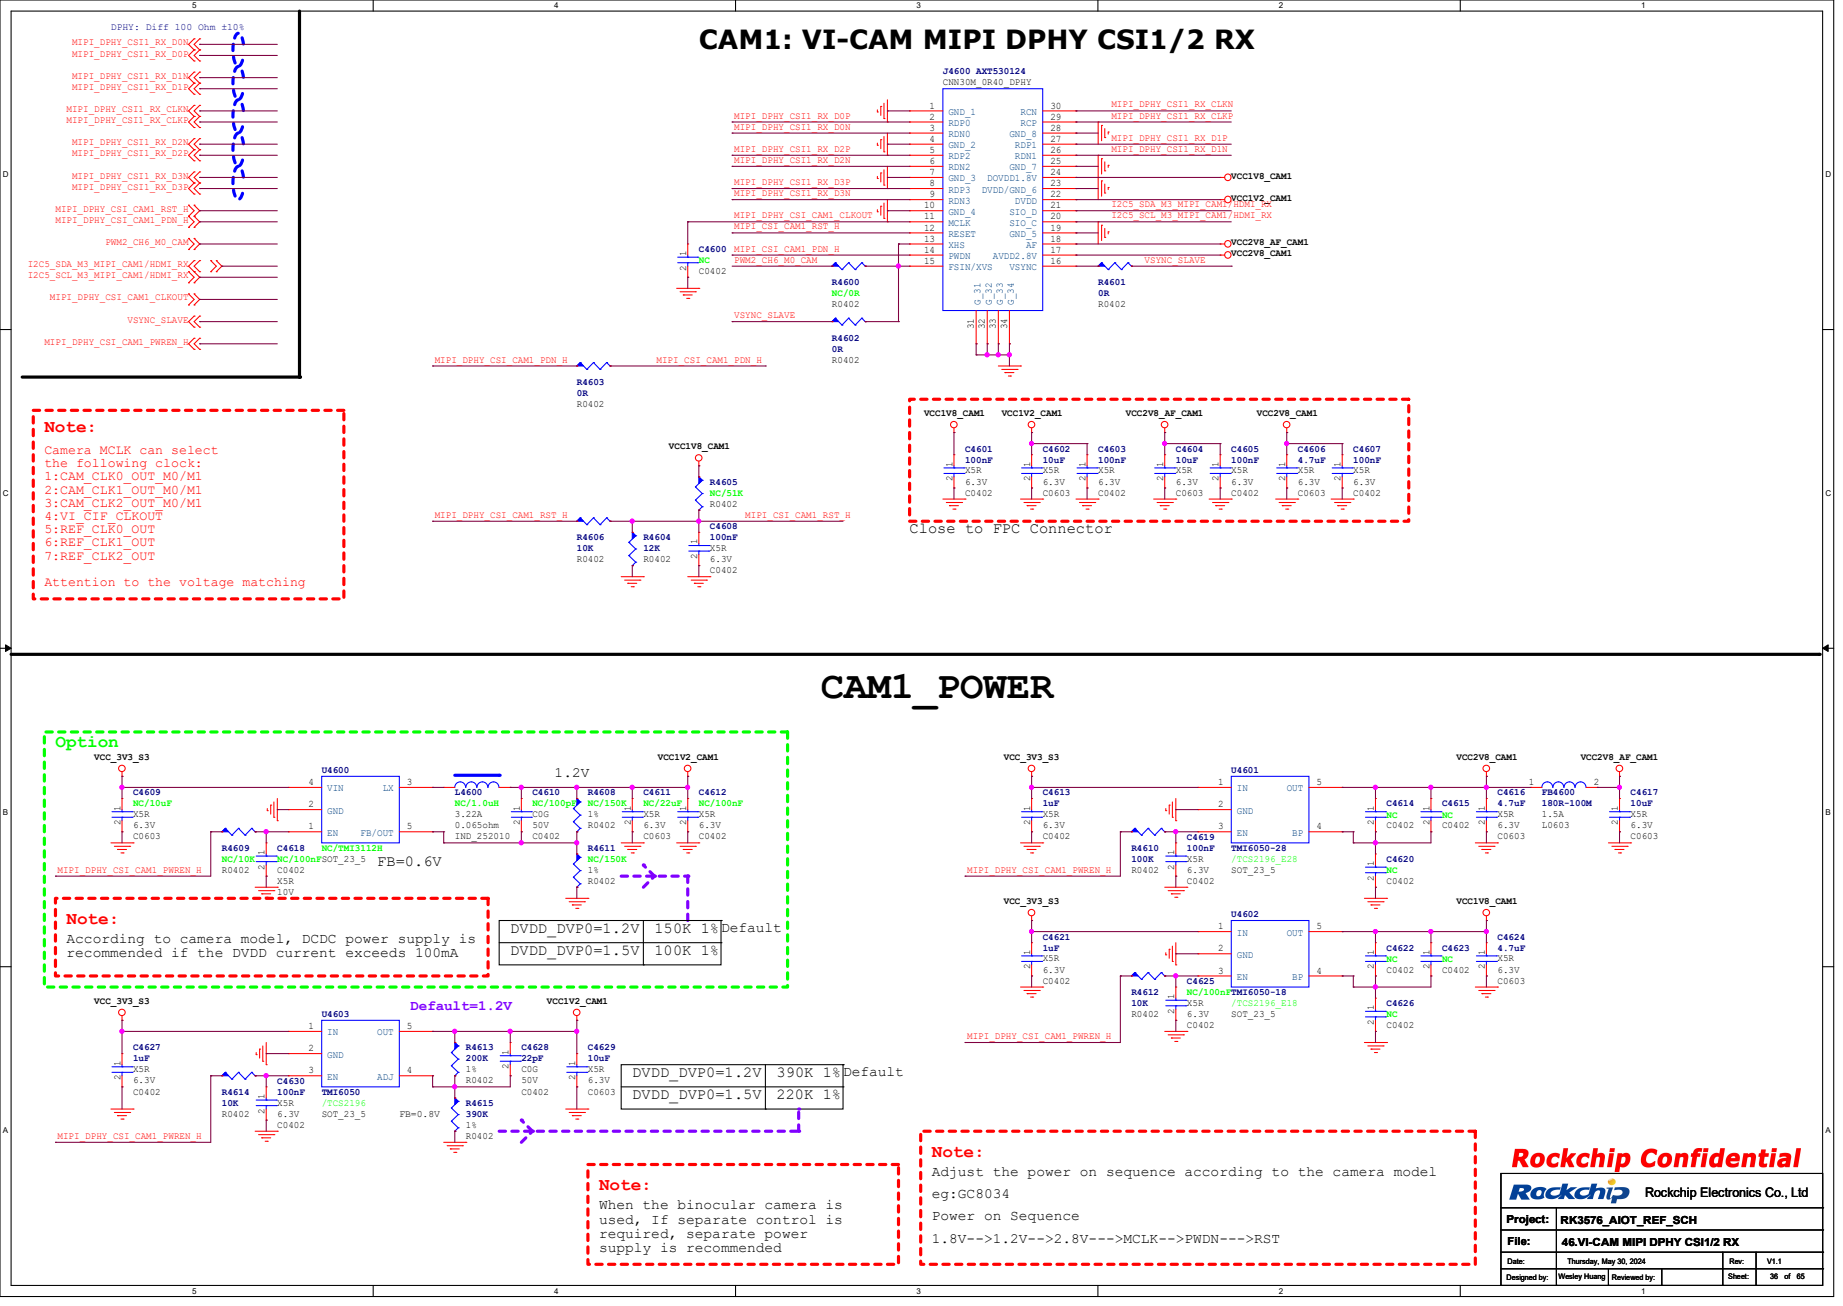
[picture p38: page 36]

Close to FPC Connector

DVDD_DVP0=1.2V Note:
According to camera model, DCDC power supply is
recommended if the DVDD current exceeds 100mA

Note: When the binocular camera is
Note:

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

used, If separate control is
required, separate power
supply is recommended

# CAM2: VI-CAM MIPI DPHY CSI3/4 RX

# 30 G_31 31 G_32 32 G_33 33 G_34 34

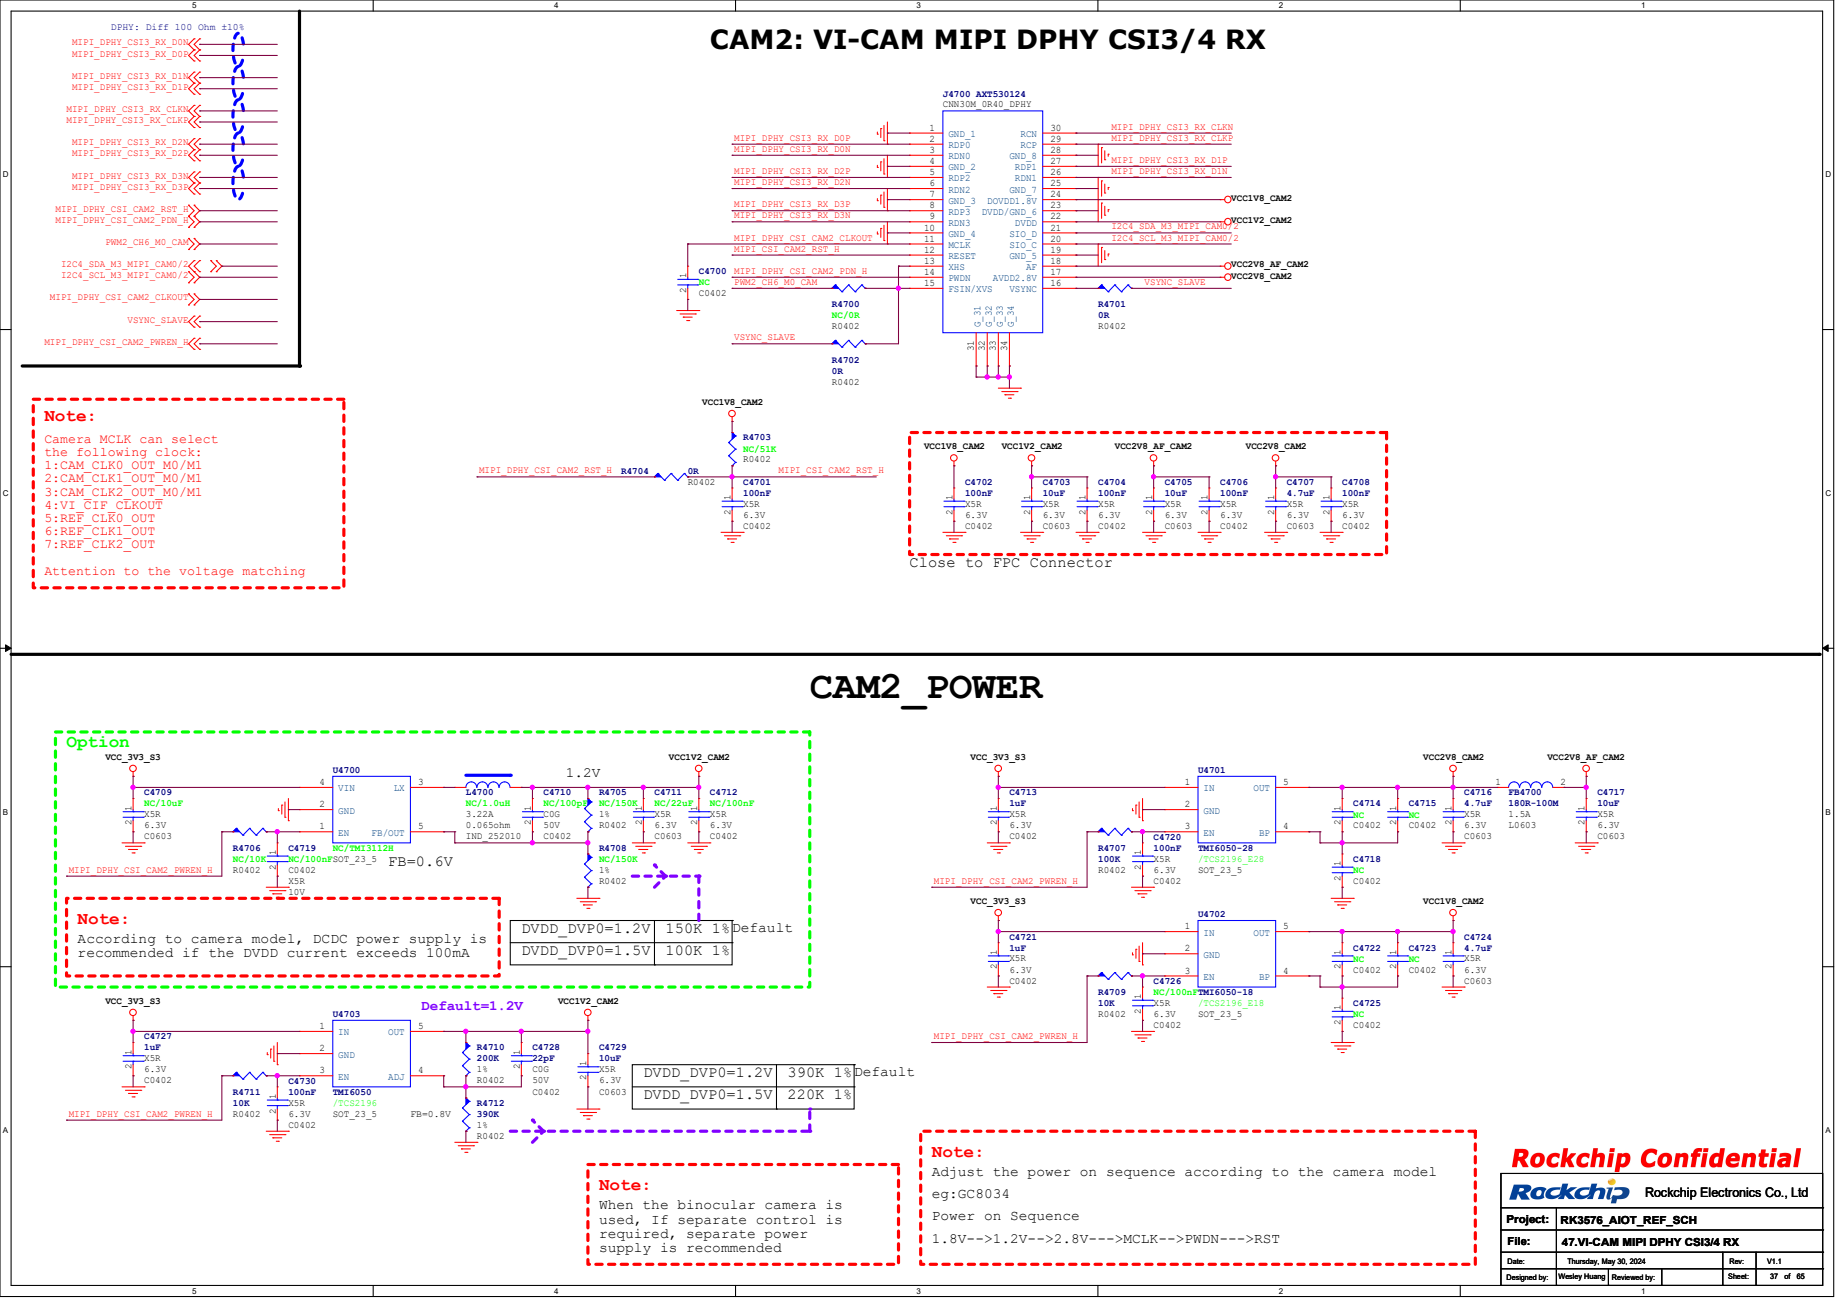
[picture p39: page 37]

Close to FPC Connector

Note:
According to camera model, DCDC power supply is

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

When the binocular camera is
used, If separate control is
required, separate power
supply is recommended

# HDMI2.0 RX

## Option with 46.VI-CAM MIPI DPHY CSI1/2 RX and 47.VI-CAM MIPI DPHY CSI3/4 RX

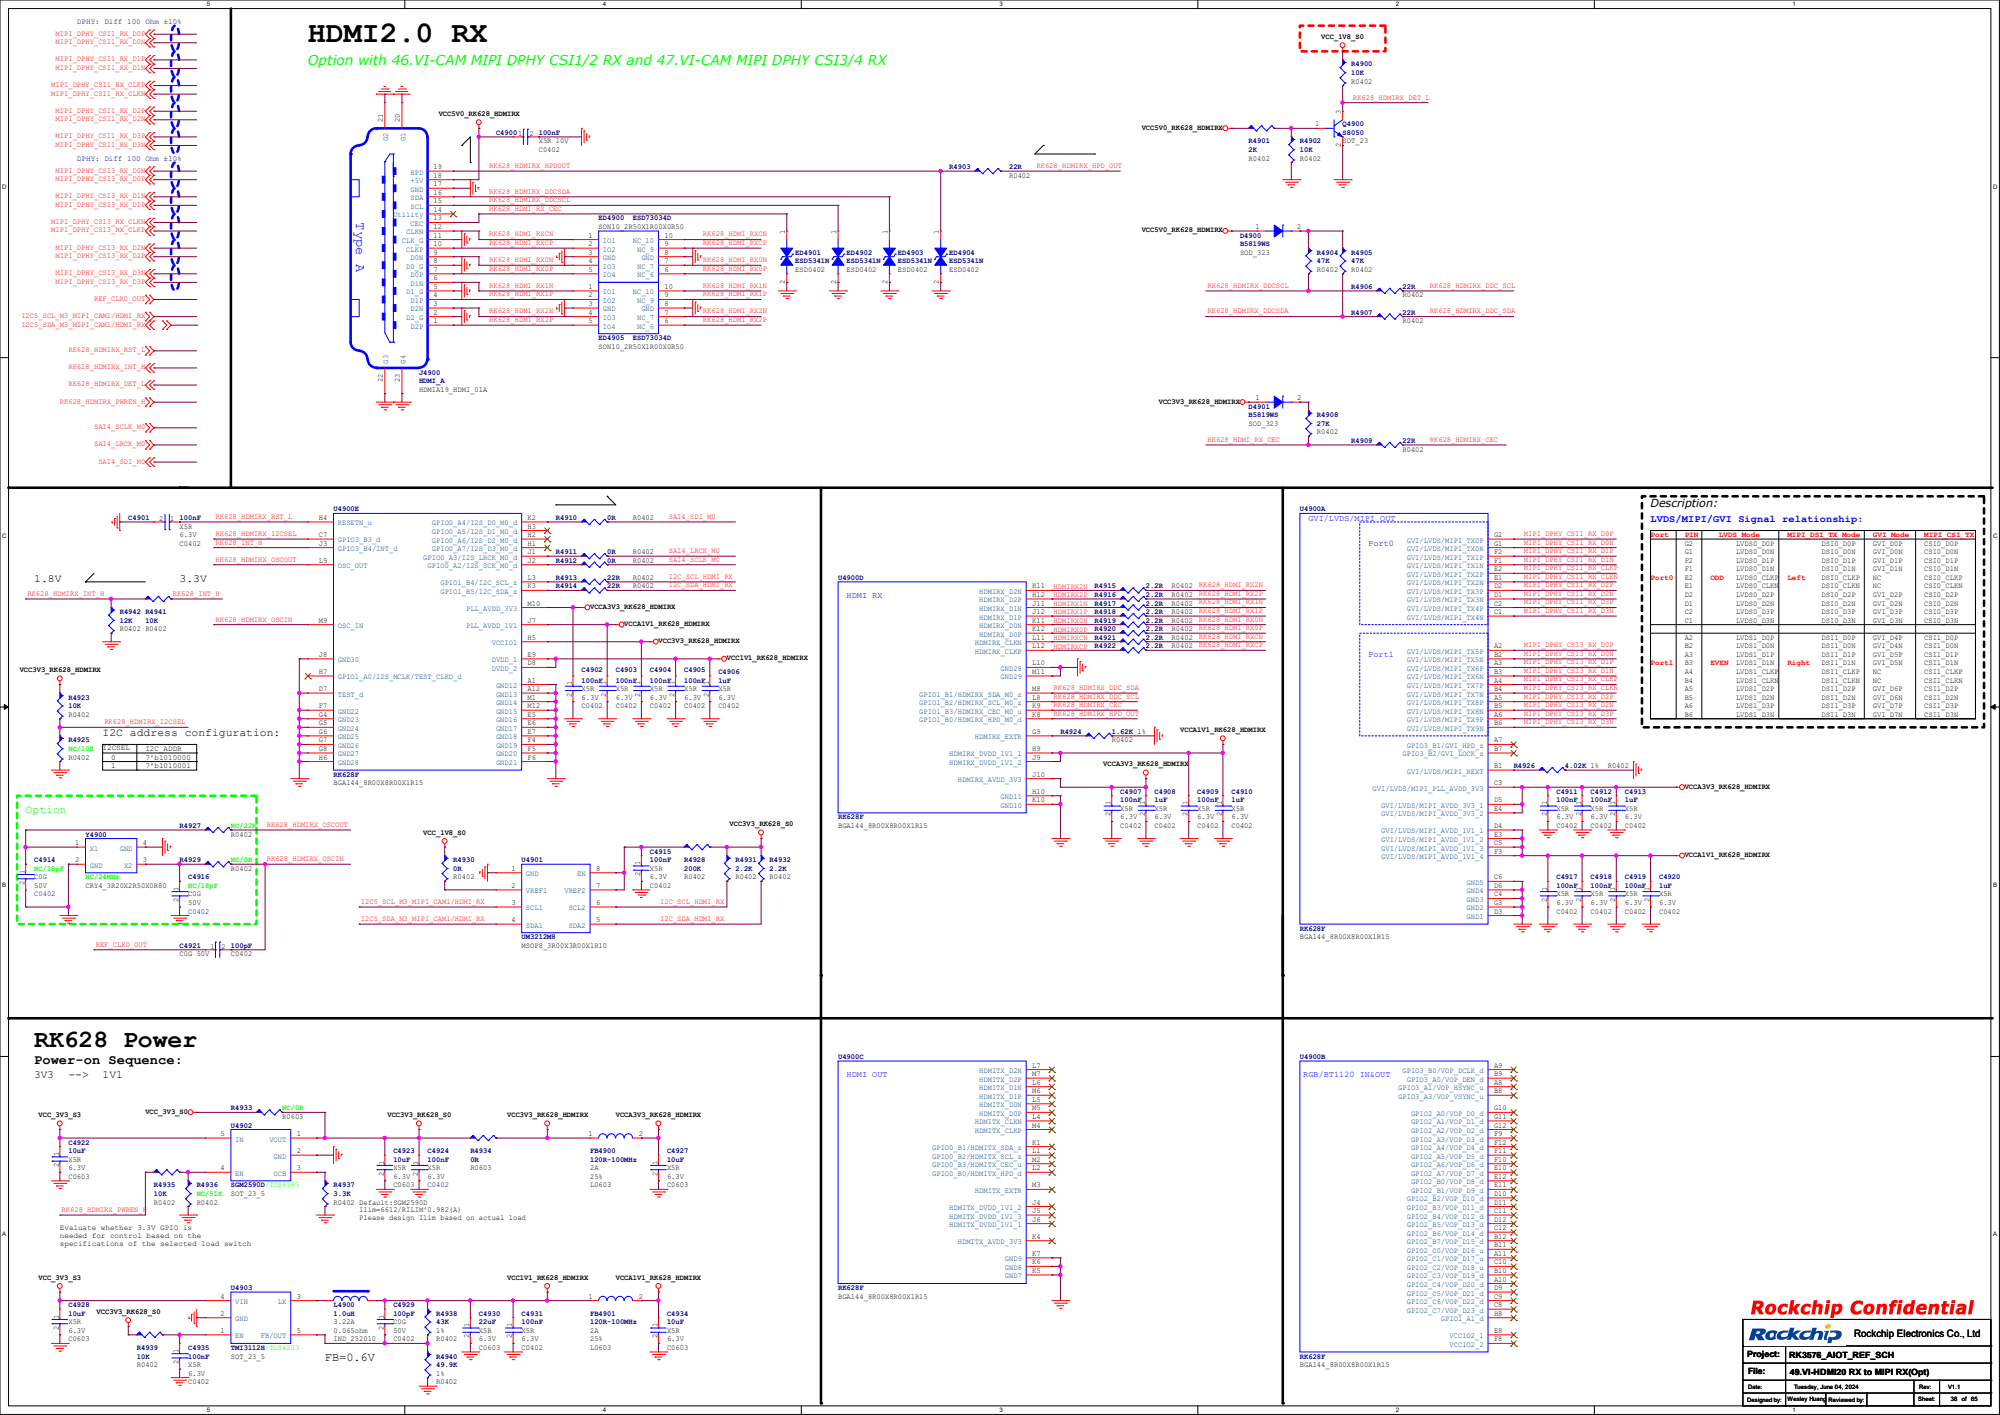
[picture p40: page 38]

LVDS/MIPI/GVI Signal relationship: DSI1_D2N

GVI/LVDS/MIPI OUT

Ilim=6612/RILIM^0.982(A)
Please design Ilim based on actual load

Evaluate whether 3.3V GPIO is
needed for control based on the
specifications of the selected load switch

## Diff 100 Ohm ±10%

# MIPI LCM

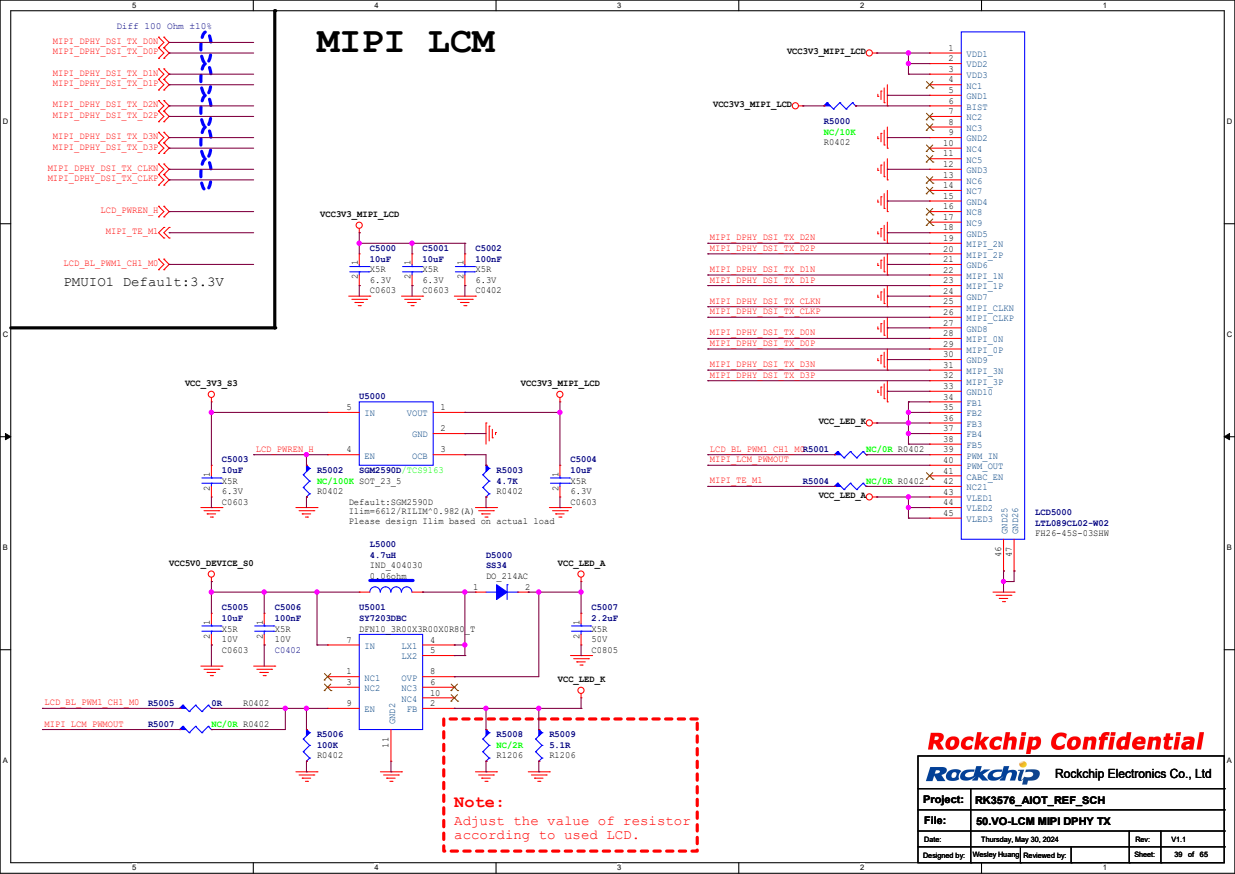
[picture p41: page 39]

Note:
Adjust the value of resistor
according to used LCD.

RK3576_AIOT_REF_SCH
50.VO-LCM MIPI DPHY TX

# 17 VDDIO 10

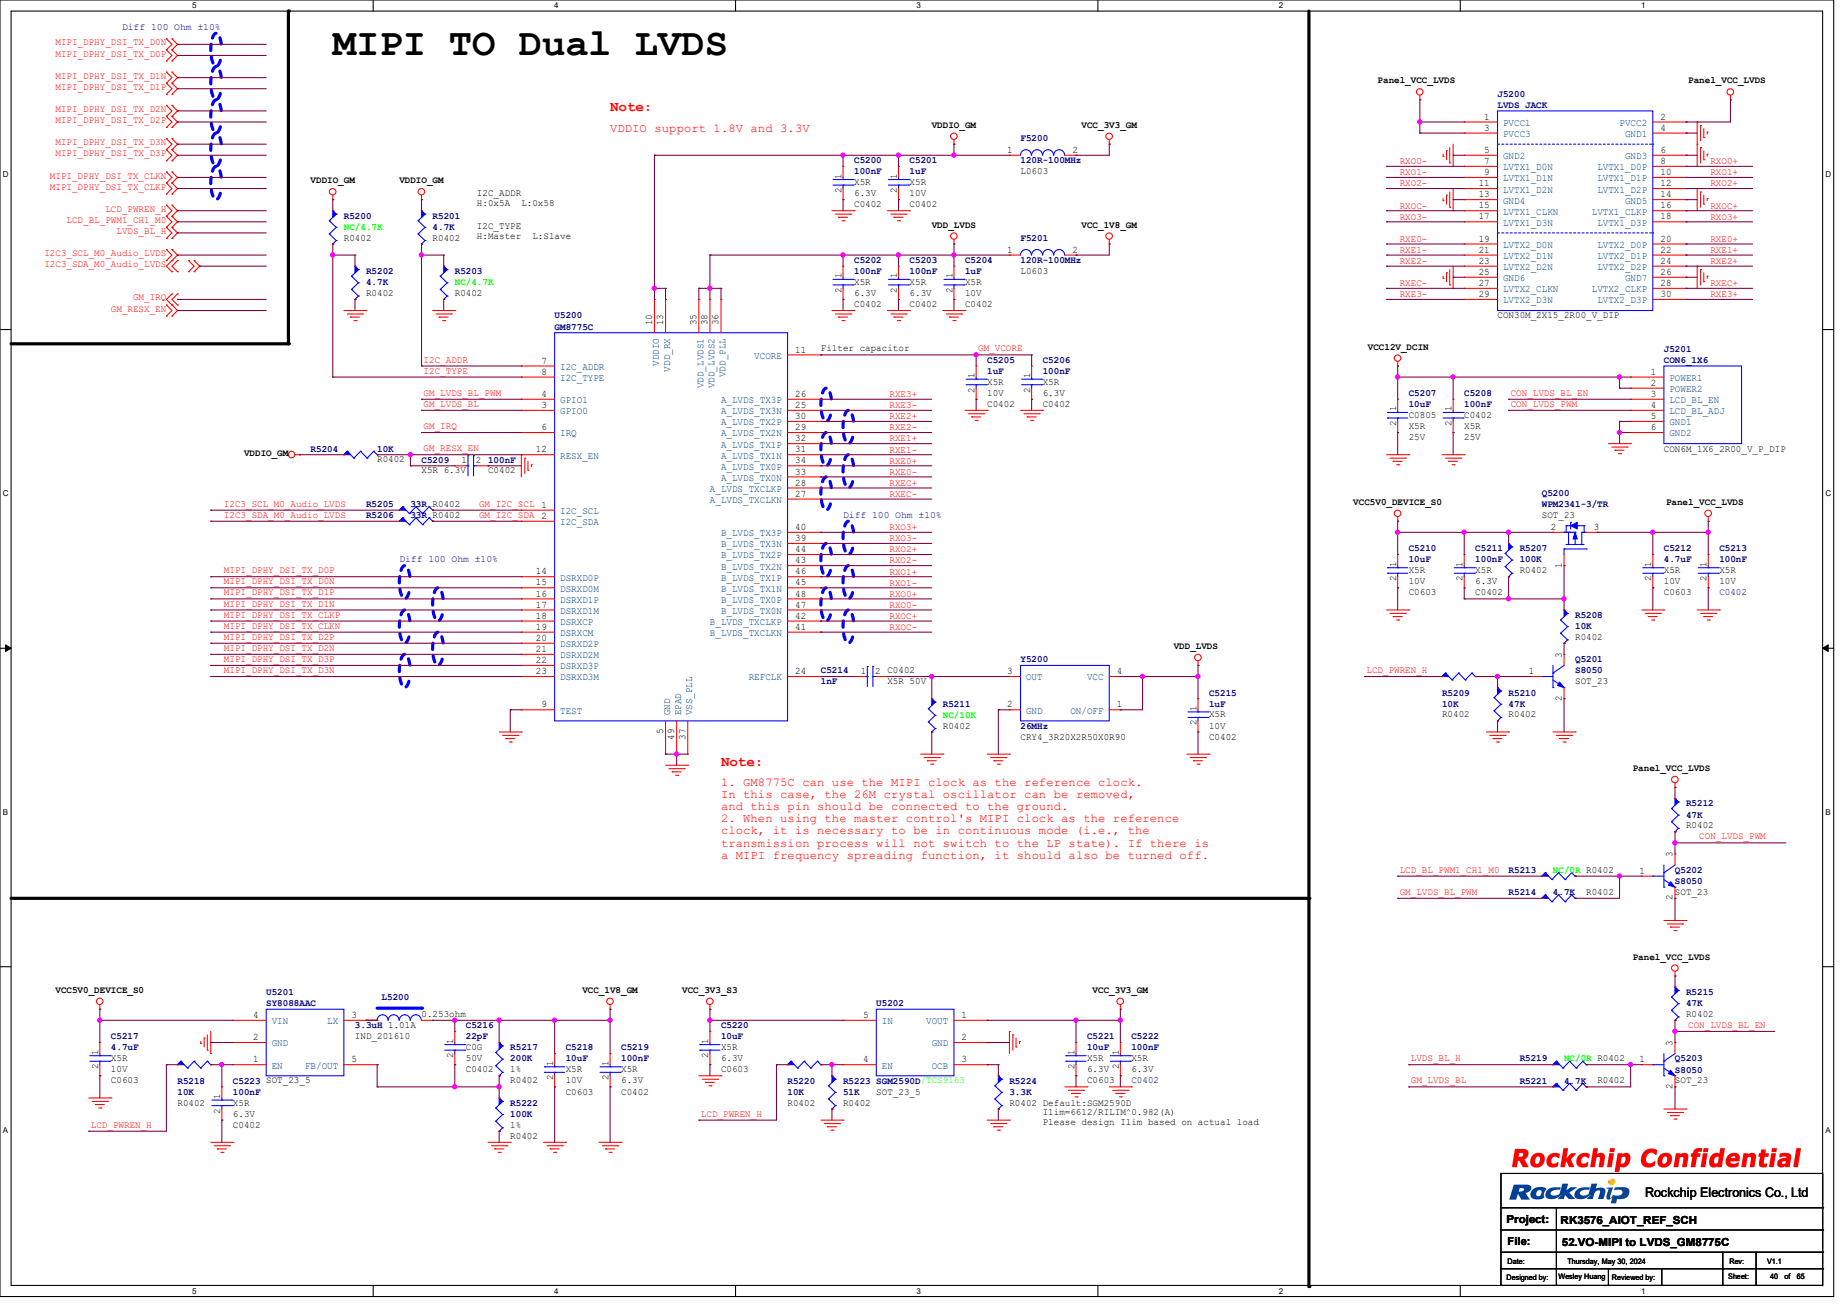
[picture p42: page 40]

Diff 100 Ohm ±10% Filter capacitor

Note:
1. GM8775C can use the MIPI clock as the reference clock.
In this case, the 26M crystal oscillator can be removed,
and this pin should be connected to the ground.
2. When using the master control's MIPI clock as the reference
clock, it is necessary to be in continuous mode (i.e., the
transmission process will not switch to the LP state). If there is
a MIPI frequency spreading function, it should also be turned off.

Default:SGM2590D
Ilim=6612/RILIM^0.982(A)
Please design Ilim based on actual load

# VO-LCM_eDP

# Option with 56.VO-HDMI TX

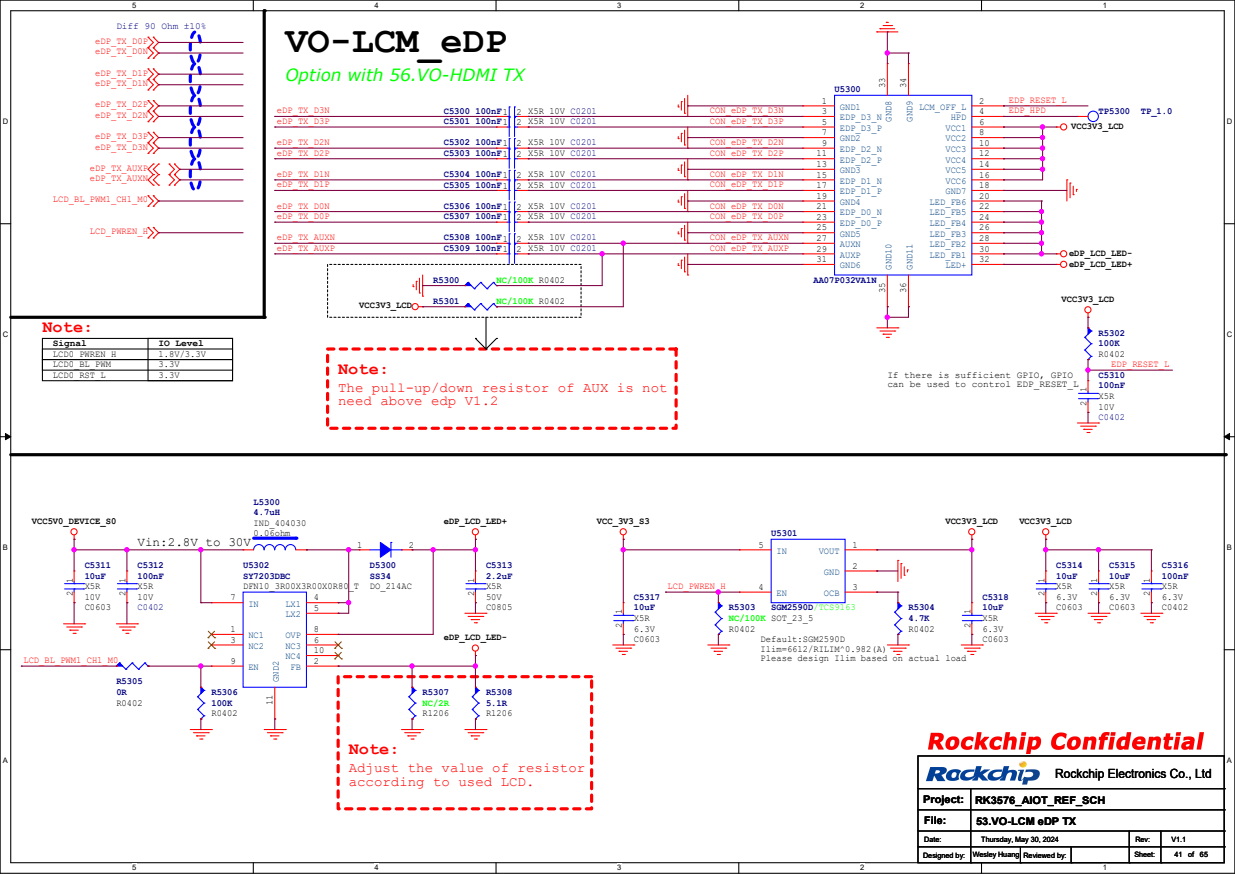
[picture p43: page 41]

Note:
The pull-up/down resistor of AUX is not
need above edp V1.2

If there is sufficient GPIO, GPIO
can be used to control EDP_RESET_L

Ilim=6612/RILIM^0.982(A)
Please design Ilim based on actual load

Adjust the value of resistor
according to used LCD.

RK3576_AIOT_REF_SCH
53.VO-LCM eDP TX

# DP TX 4Lanes (Together with USB2_OTG0)

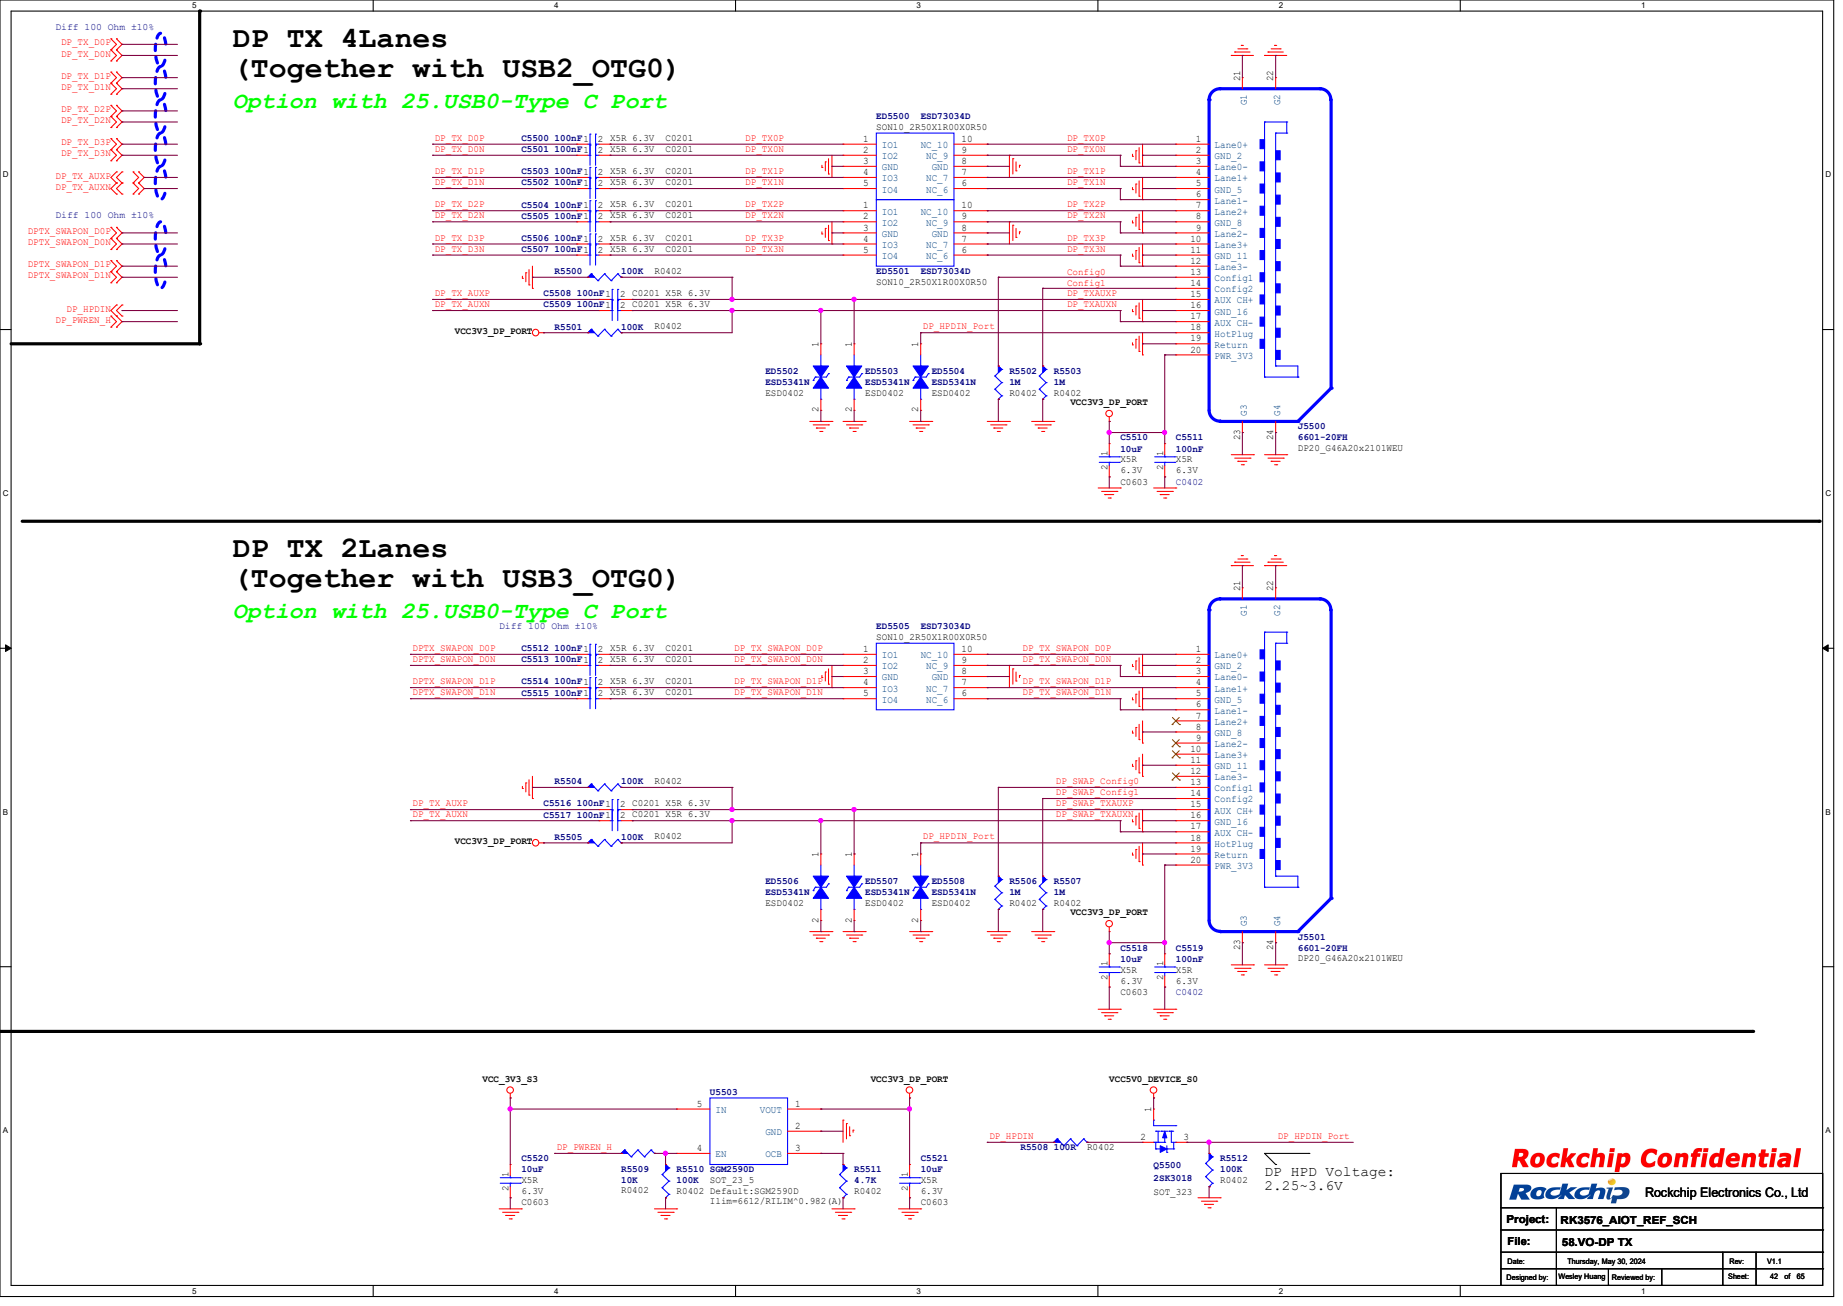
[picture p44: page 42]

Option with 25.USB0-Type C Port

DP TX 2Lanes
(Together with USB3_OTG0)

# Note:

## Note: Close to HDMI Connector

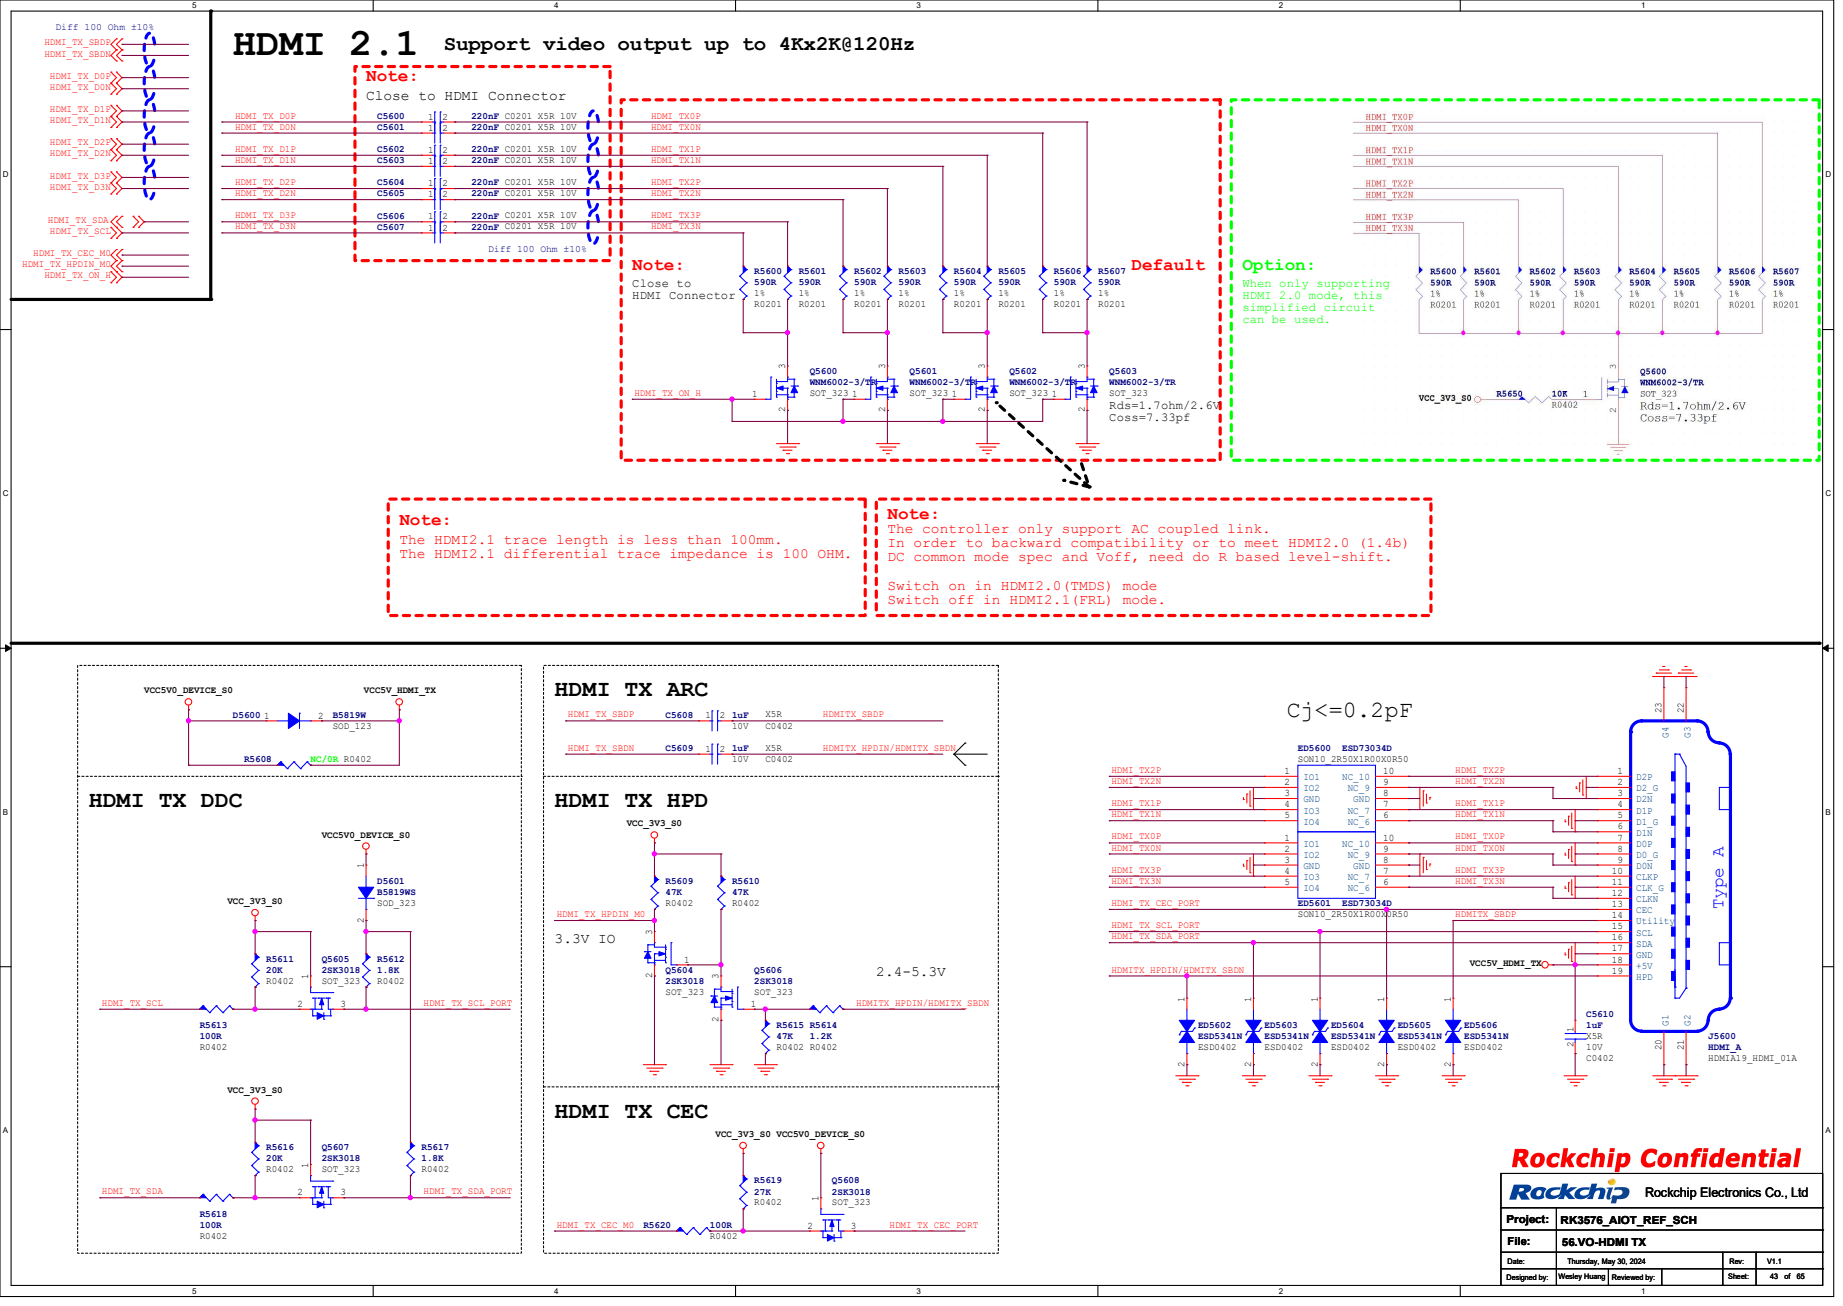
[picture p45: page 43]

Support video output up to 4Kx2K@120Hz

Note:
The HDMI2.1 trace length is less than 100mm.
The HDMI2.1 differential trace impedance is 100 OHM.

The controller only support AC coupled link.
In order to backward compatibility or to meet HDMI2.0 (1.4b)
DC common mode spec and Voff, need do R based level-shift.
Switch on in HDMI2.0(TMDS) mode
Switch off in HDMI2.1(FRL) mode.

# Touch Panel connector
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
