Rustik2044/MU-RK3576J-MB/For_production_MU-3576-MB/Stackup_MU-3576-MB.pdf

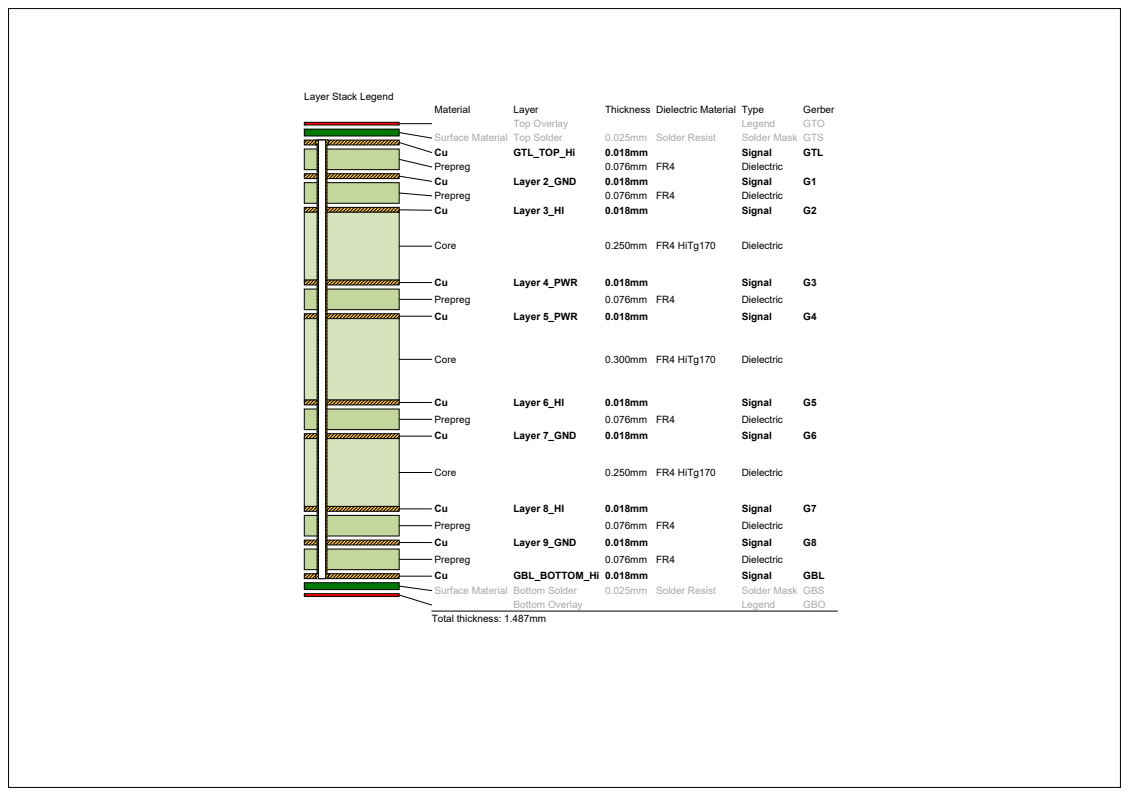
[picture p46: page 1]
Material; Layer; Thickness Dielectric Material Type; Gerber; Top Overlay; Legend; GTO; Surface Material Top Solder; 0.025mm Solder Resist; Solder Mask GTS; GTL_TOP_Hi; Signal; GTL; Prepreg; Dielectric; Layer 2_GND; Layer 3_HI; Core; 0.250mm FR4 HiTg170; Layer 4_PWR; Layer 5_PWR; 0.300mm FR4 HiTg170; Layer 6_HI; Layer 7_GND; Layer 8_HI; Layer 9_GND; GBL_BOTTOM_Hi 0.018mm; GBL; Surface Material Bottom Solder; Solder Mask GBS; Bottom Overlay; GBO; Total thickness: 1.487mm

Layer Stack Legend
