Rustik2044/MU-RK3576J-MB/Project/refdoc/V-by-One.pdf

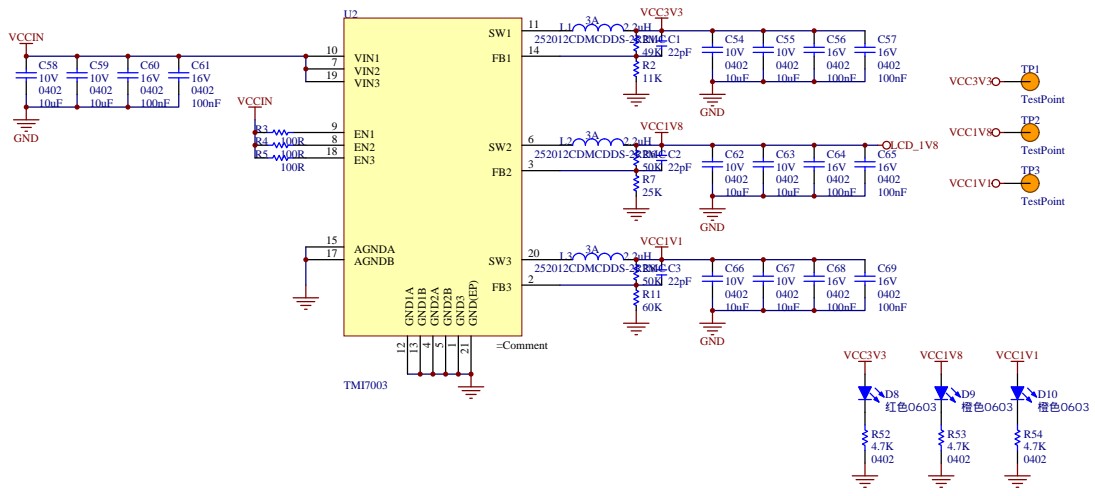
[picture p47: page 1]

## Boost

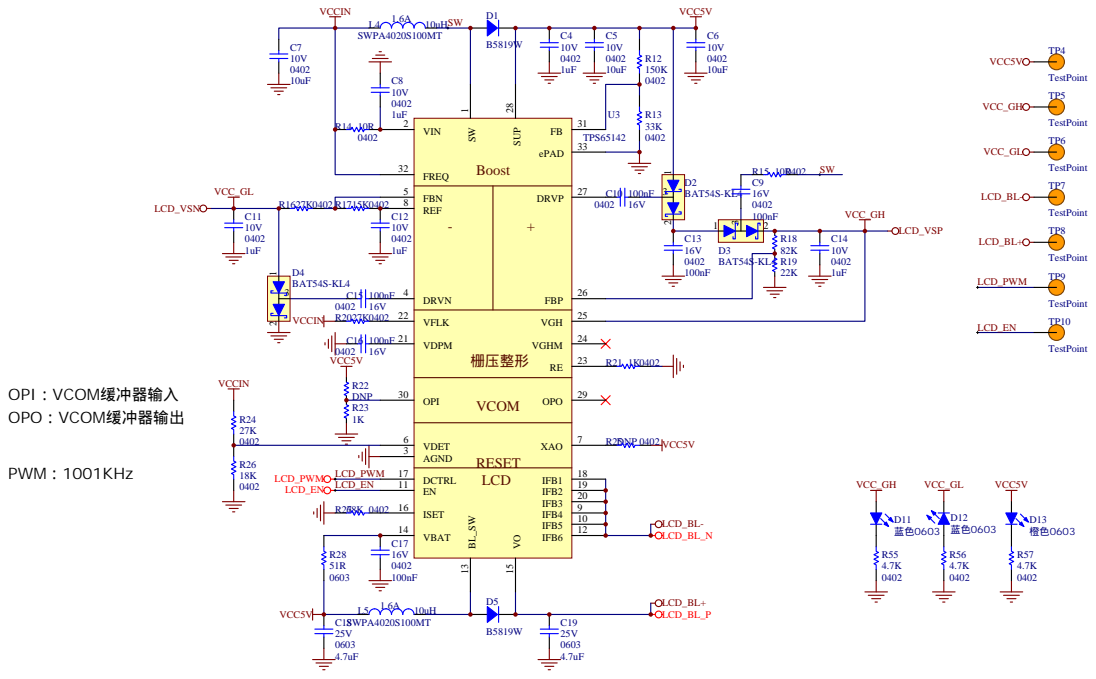
[picture p48: page 2]

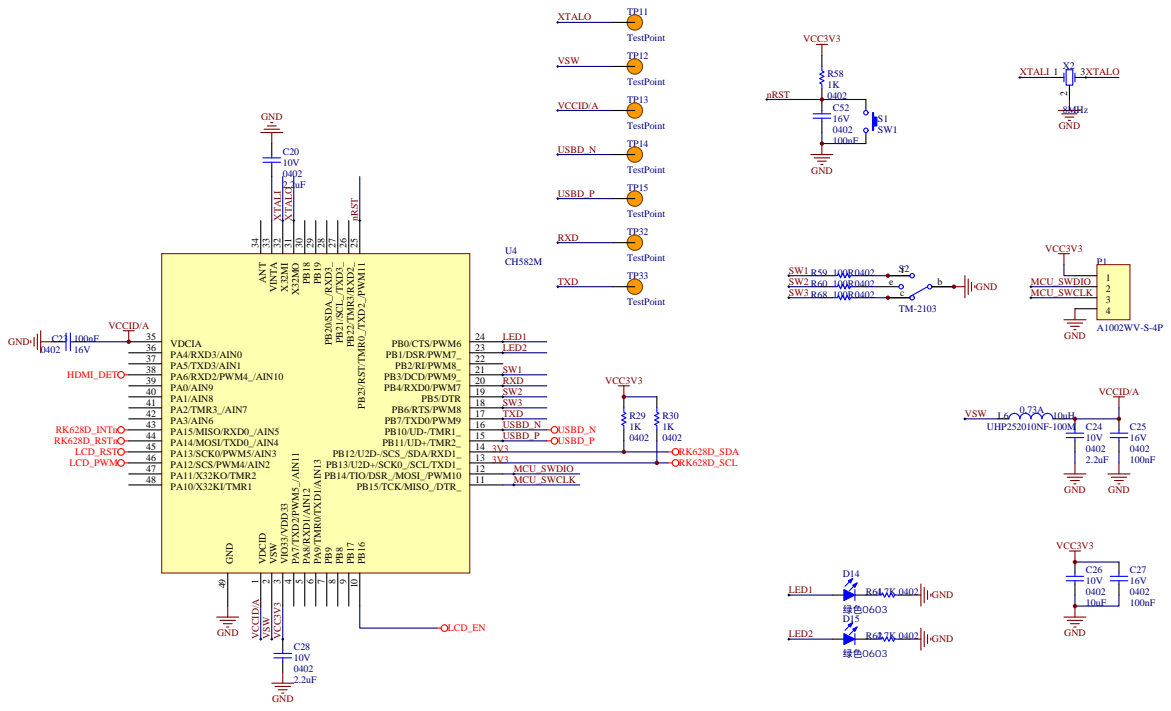
[picture p49: page 3]

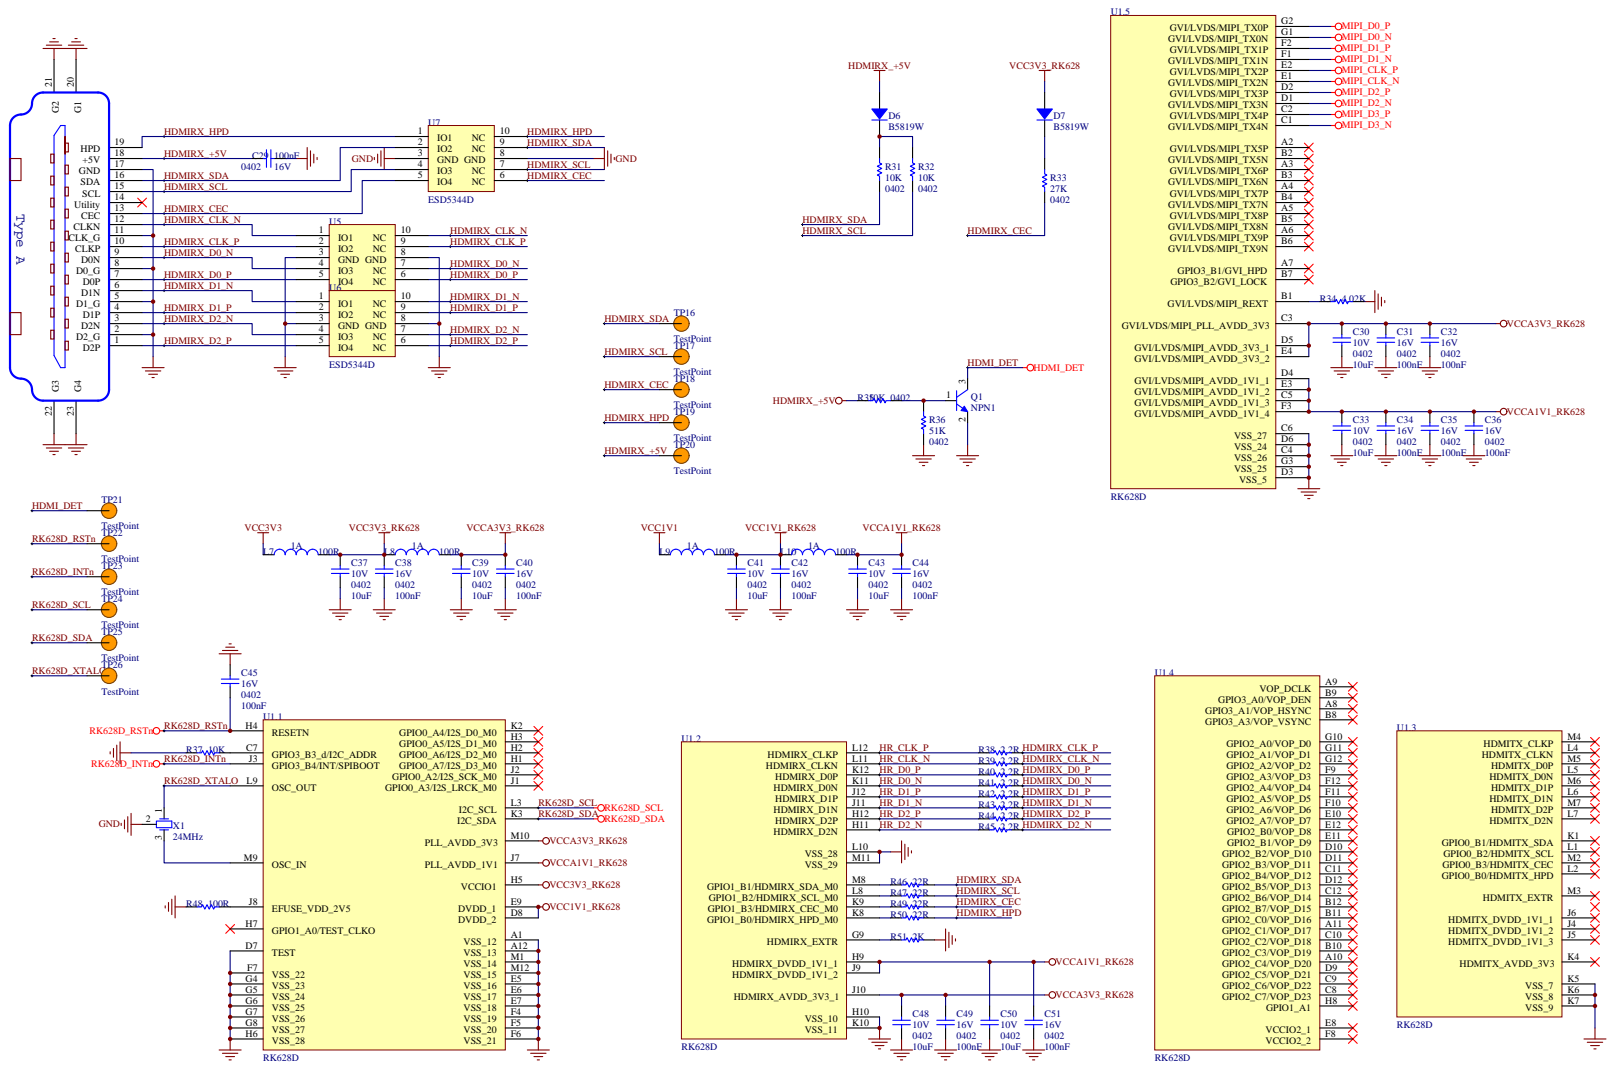
[picture p50: page 4]

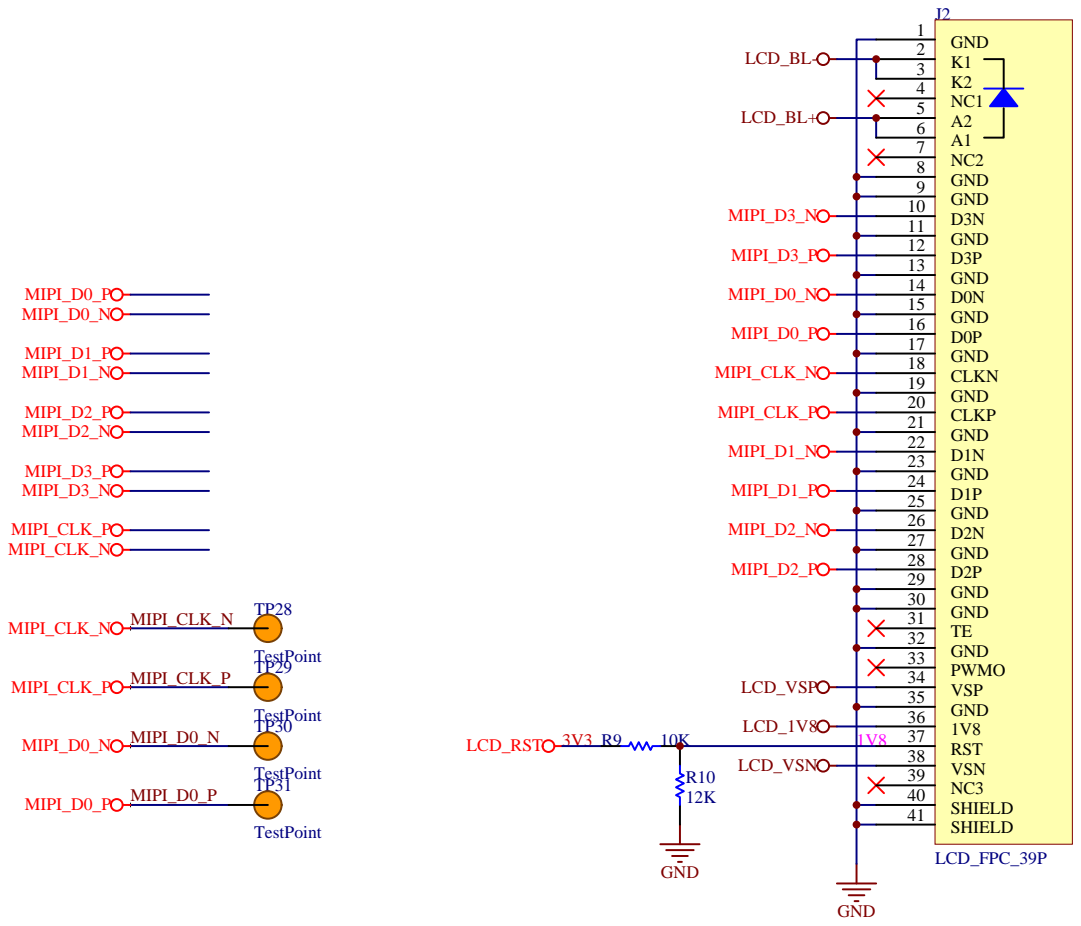
[picture p51: page 5]

VBUS
TestPoint

TP27

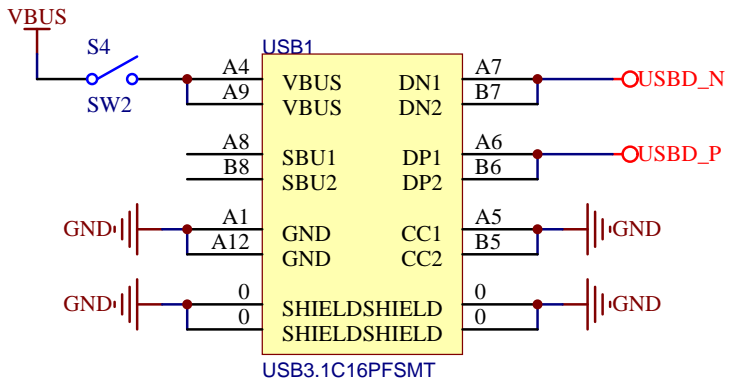
[picture p52: figure]
VBUS; USBD_N; USBD_P; GND; USB3.1C16PFSMT; USB1; SBU2; SHIELD; SBU1
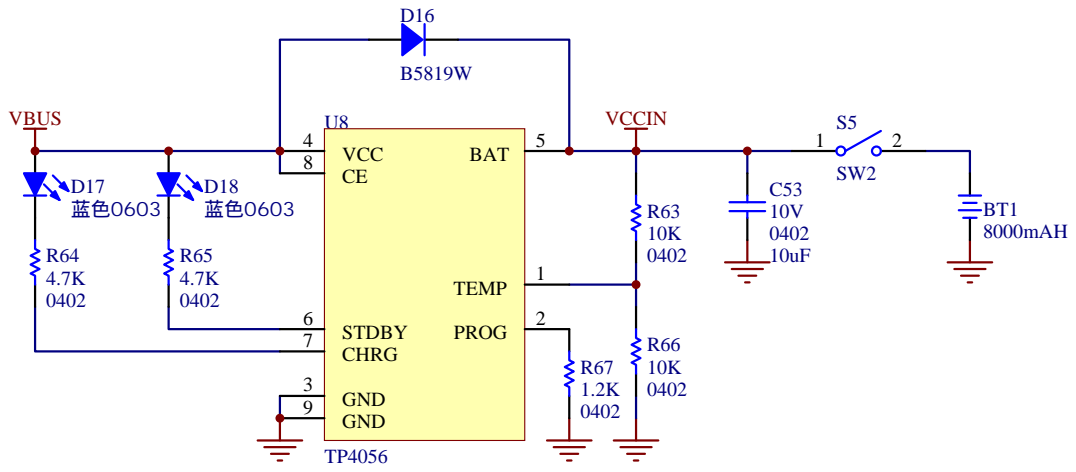
[picture p53: page 7]
