Rustik2044/MU-RK3576J-MB/Project/refdoc/ATB_RK3588_SMARC_R1_POWEROFF_1_8V.pdf

R43

R42

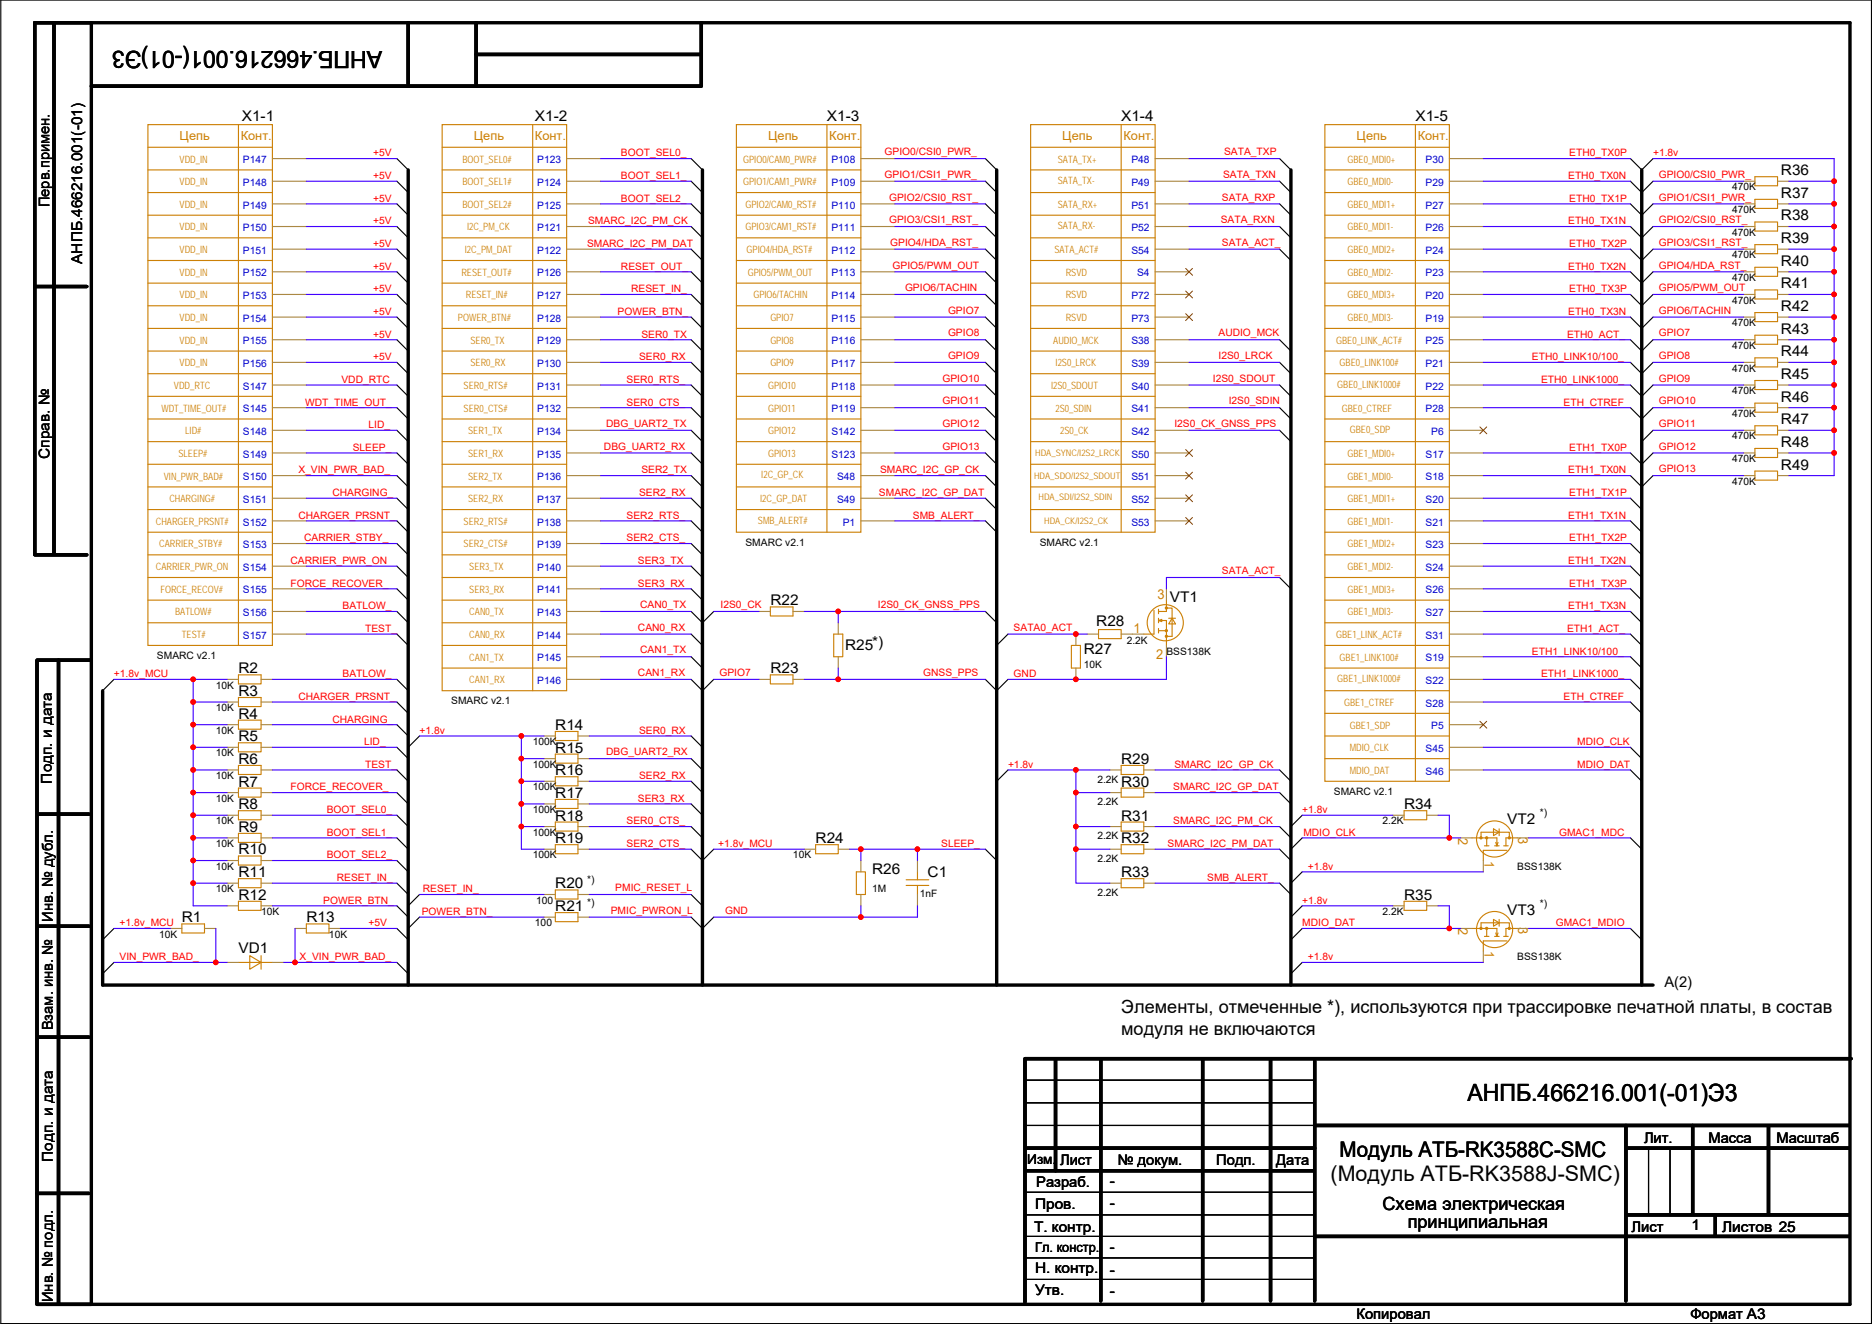
[picture p54: page 1]

Инв. № подл. Инв. № дубл. Подп. и дата Подп. и дата Взам. инв. № R8 10K

GBE1_SDP | P5

MDIO_CLK | S45

MDIO_DAT | S46

Элементы, отмеченные *), используются при трассировке печатной платы, в состав
модуля не включаются

Цепь Конт.

# PCIE_A_REFCK- PCIE_B_TX+ PCIE_A_RX+ PCIE_B_TX- PCIE_A_RX- PCIE_B_RST#

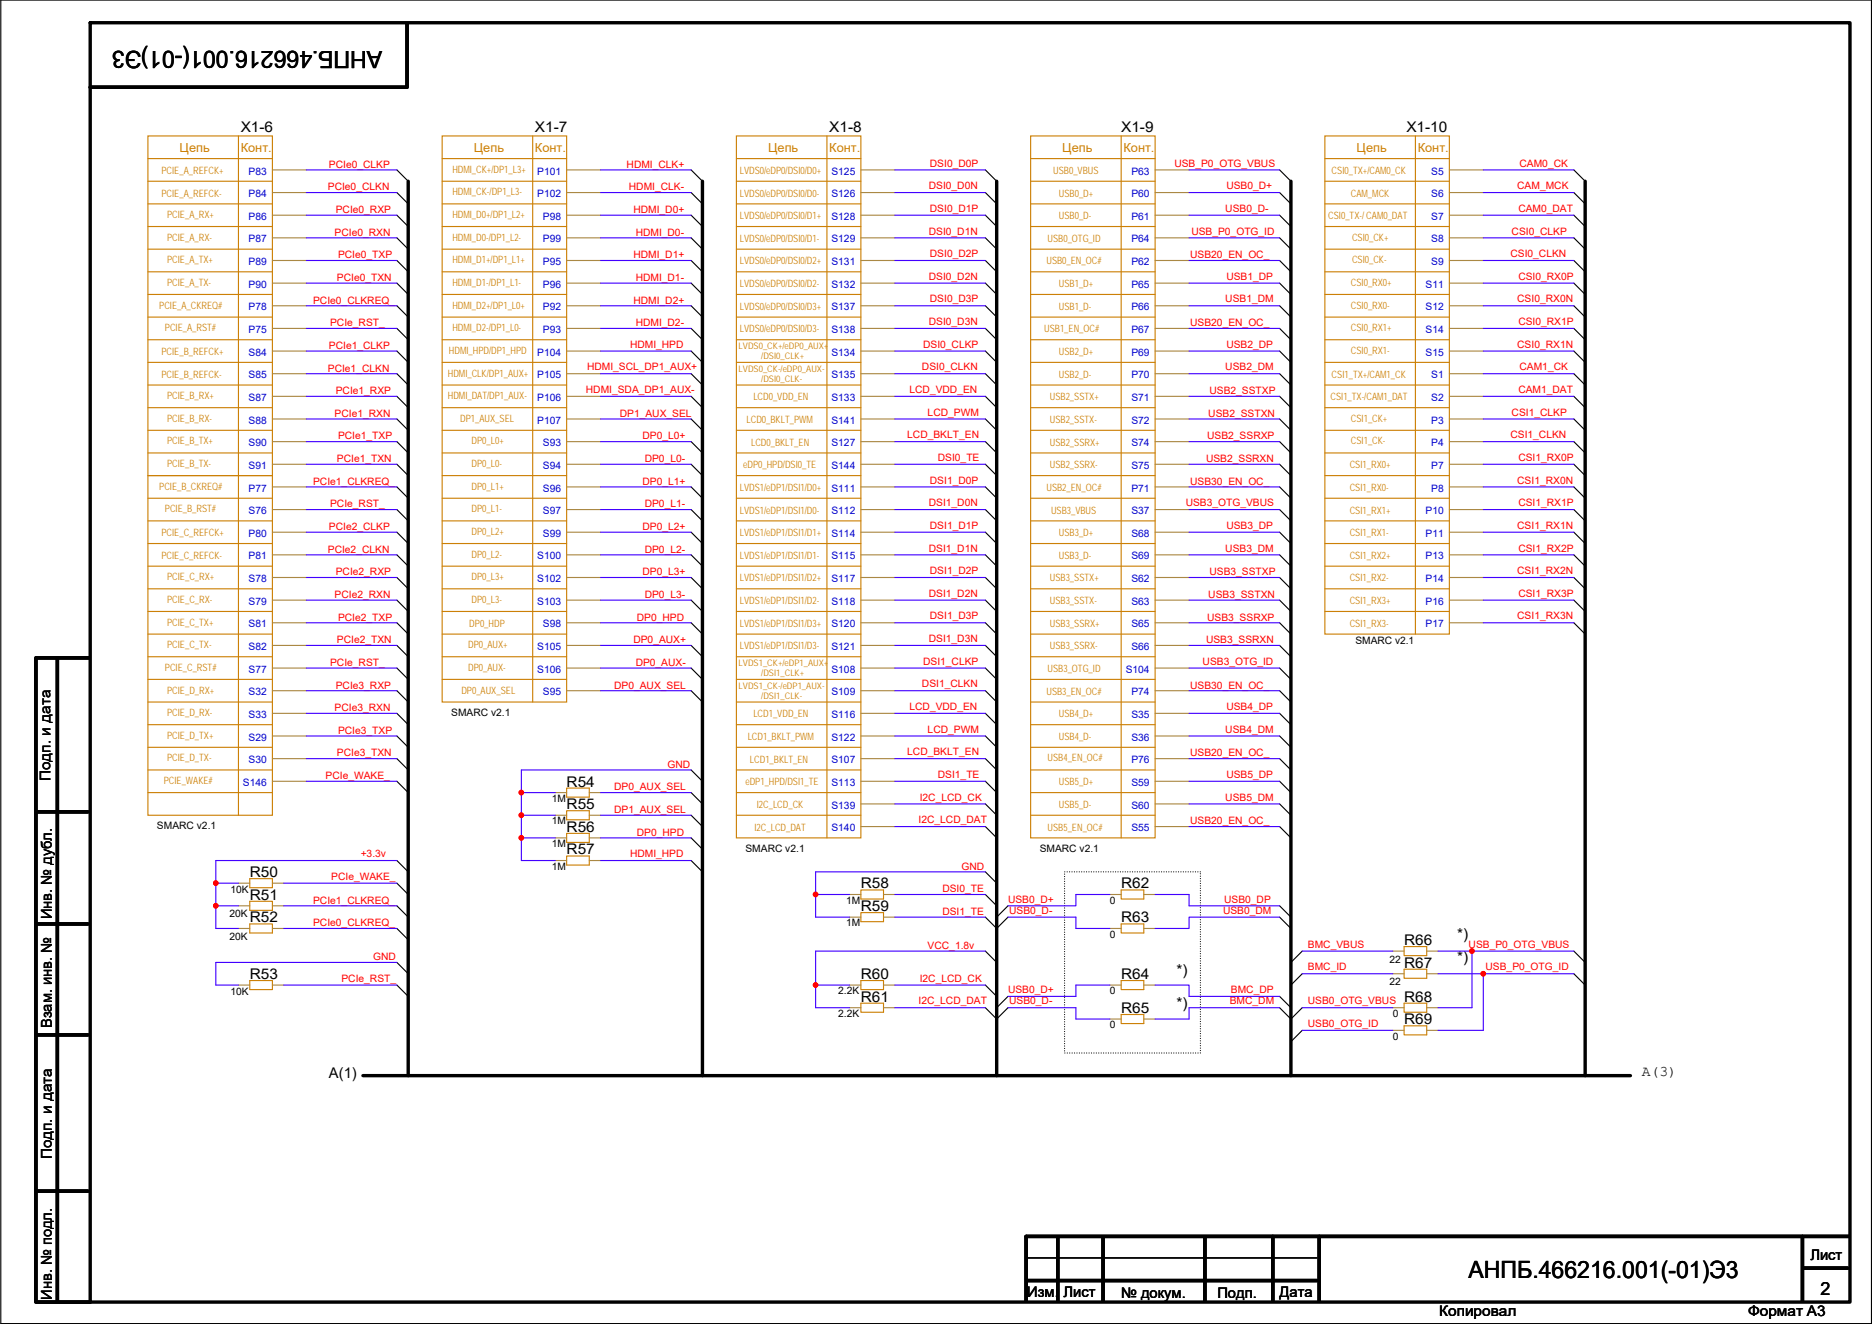
[picture p55: page 2]

Инв. № подл. Инв. № дубл. Подп. и дата Подп. и дата Взам. инв. № Изм. Лист № докум. Подп. Дата Лист

Цепь Конт.

X1-11

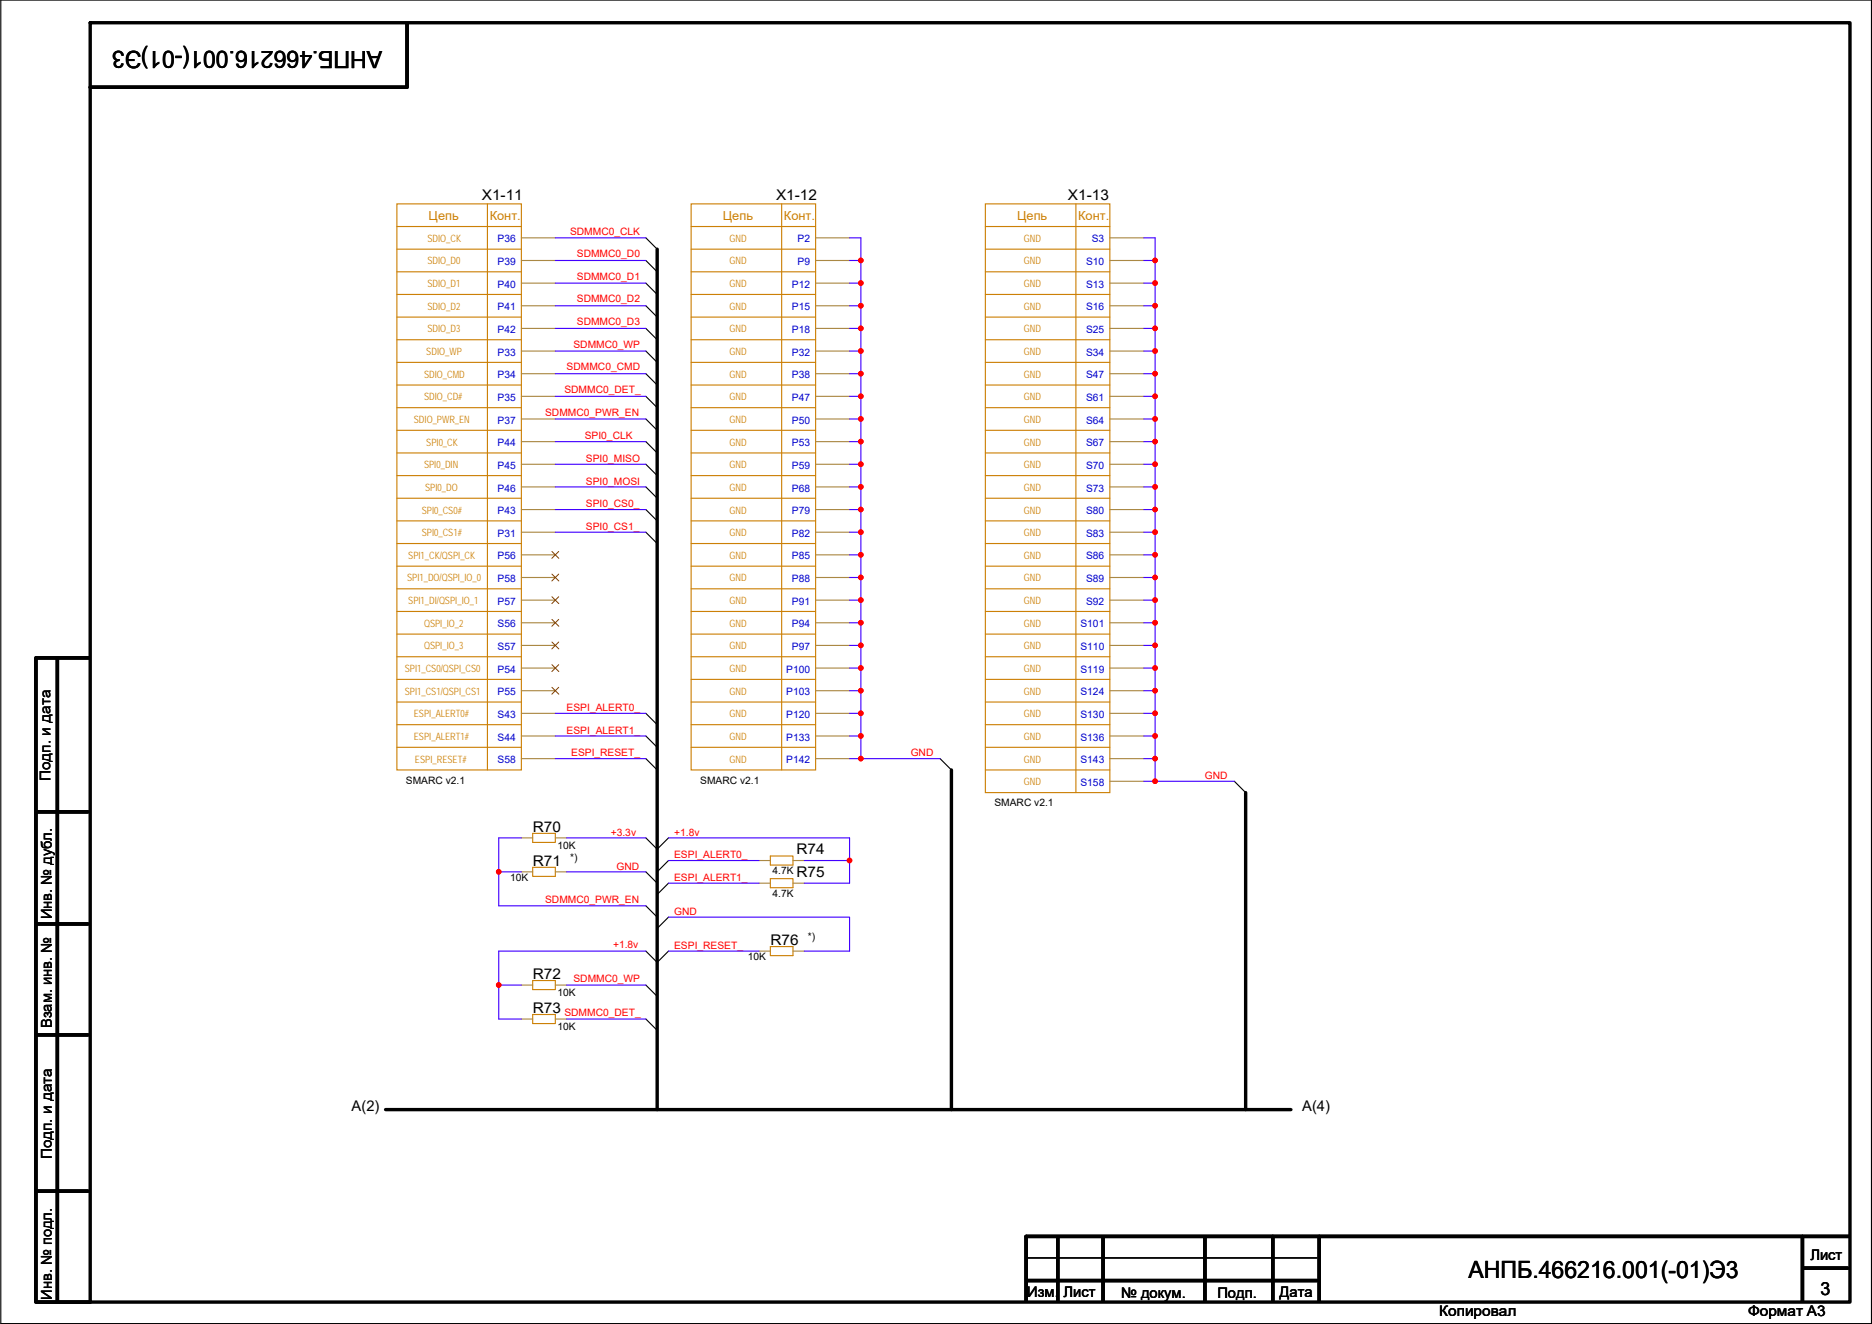
[picture p56: page 3]
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

3 АНПБ.466216.001(-01)Э3 Изм. Лист

№ докум. | Подп. | Дата

# Feedback from RK3588

# Feedback from RK3588

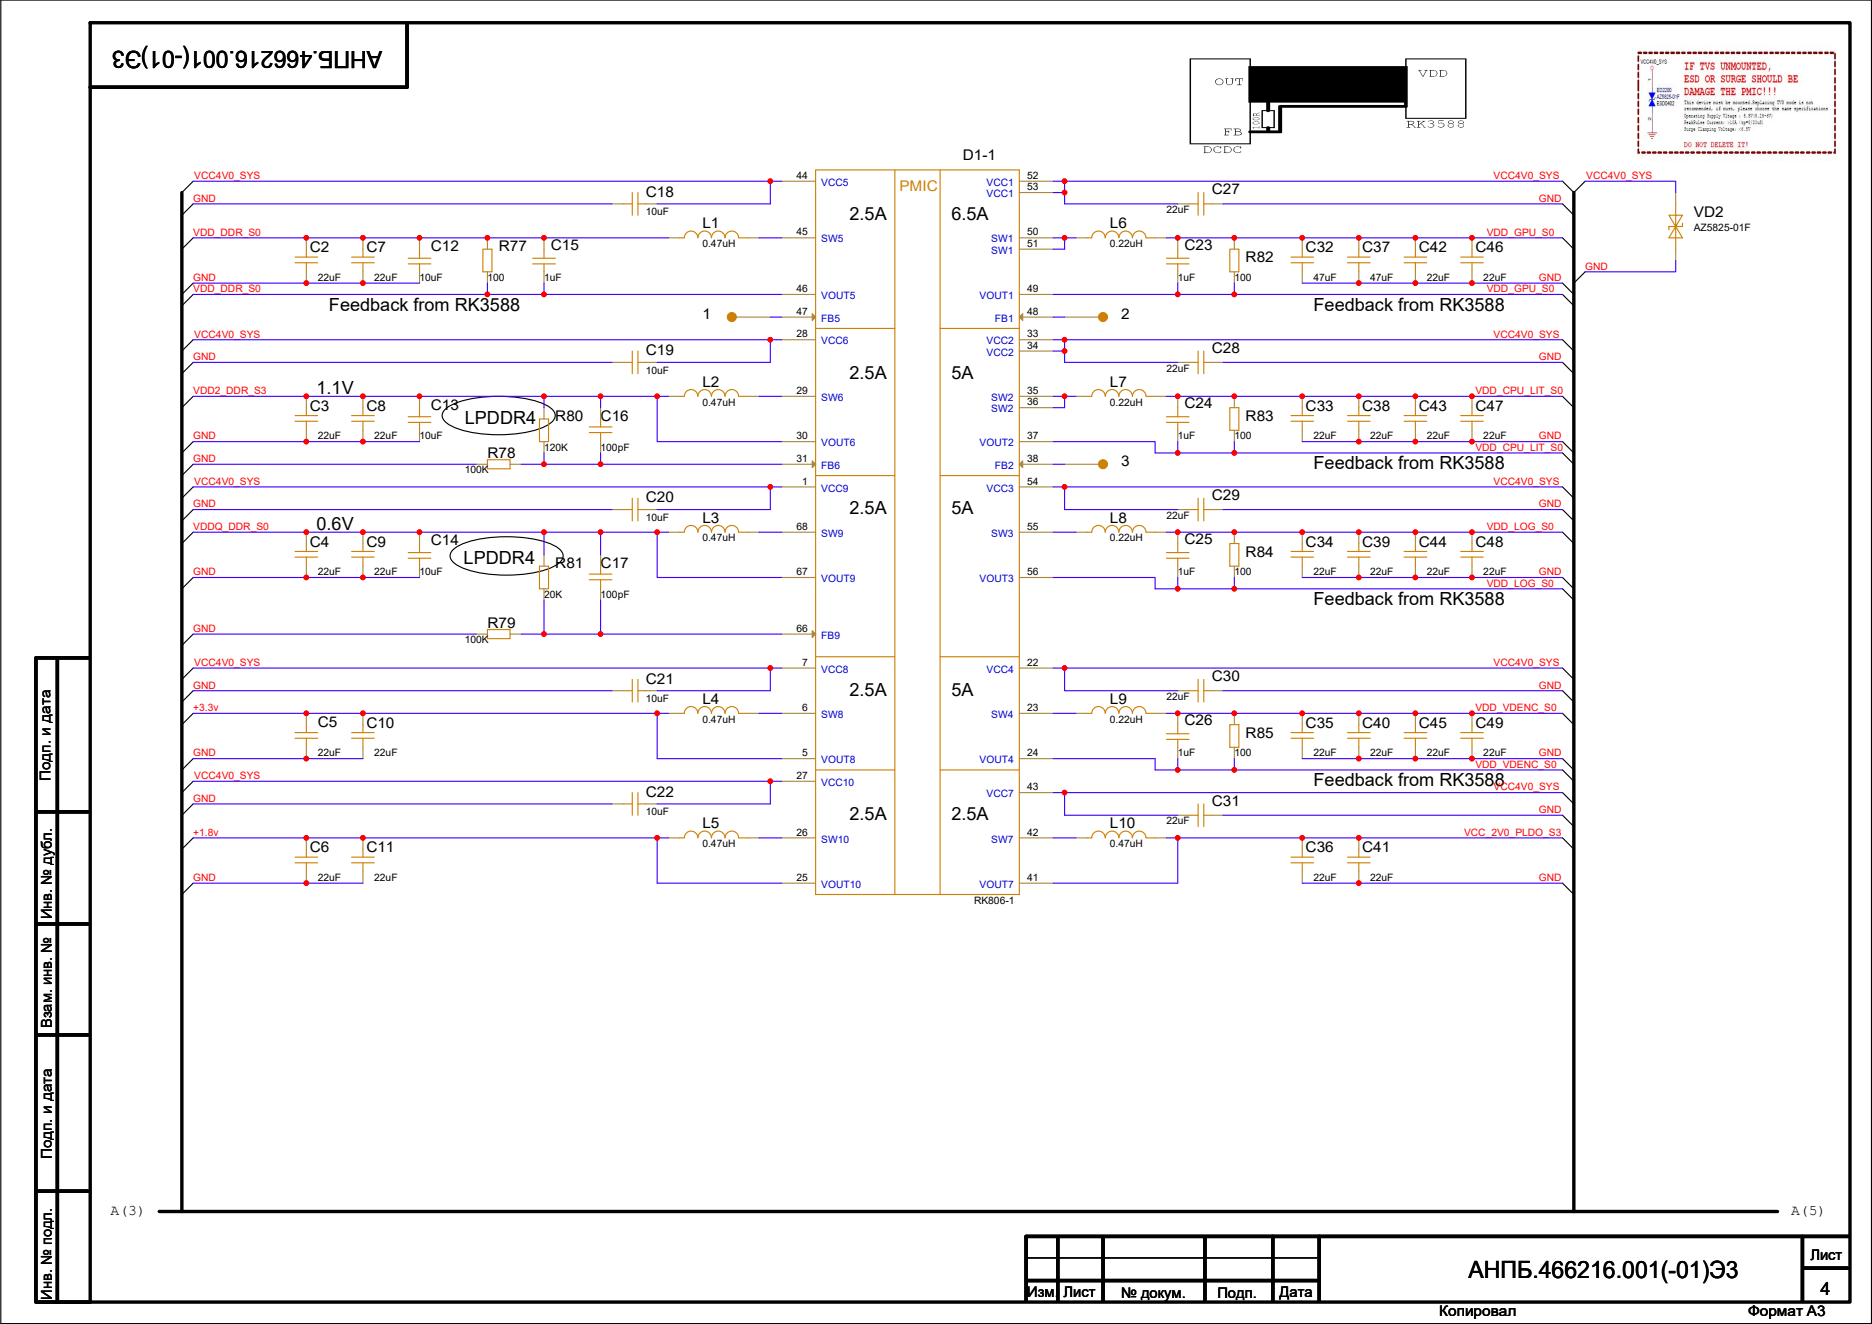
[picture p57: page 4]
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

4 АНПБ.466216.001(-01)Э3 Изм. Лист

№ докум. | Подп. | Дата

# Feedback from RK3588

C61

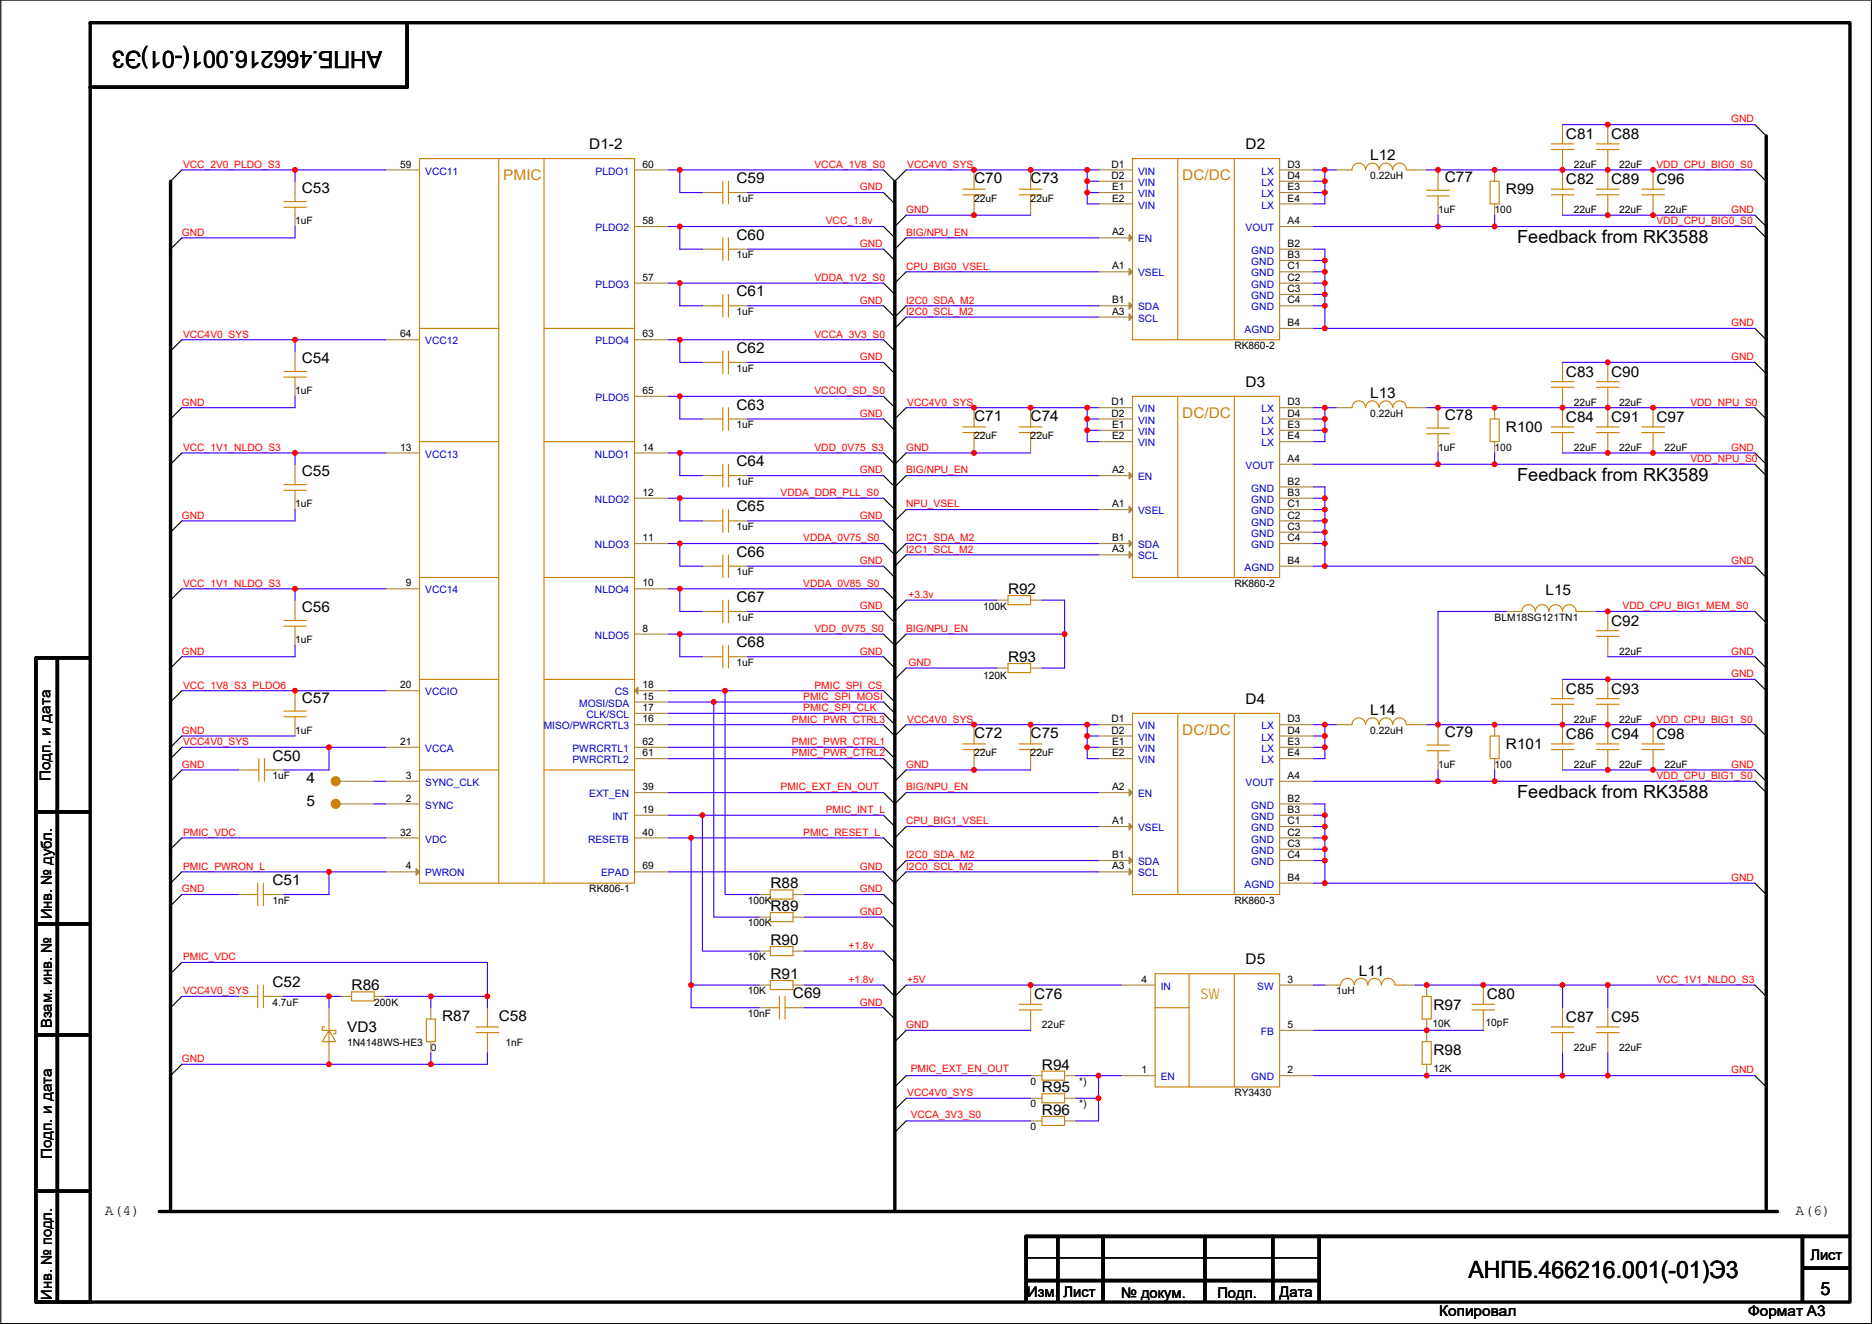
[picture p58: page 5]
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

5 АНПБ.466216.001(-01)Э3 Изм. Лист

№ докум. | Подп. | Дата

C104

R106

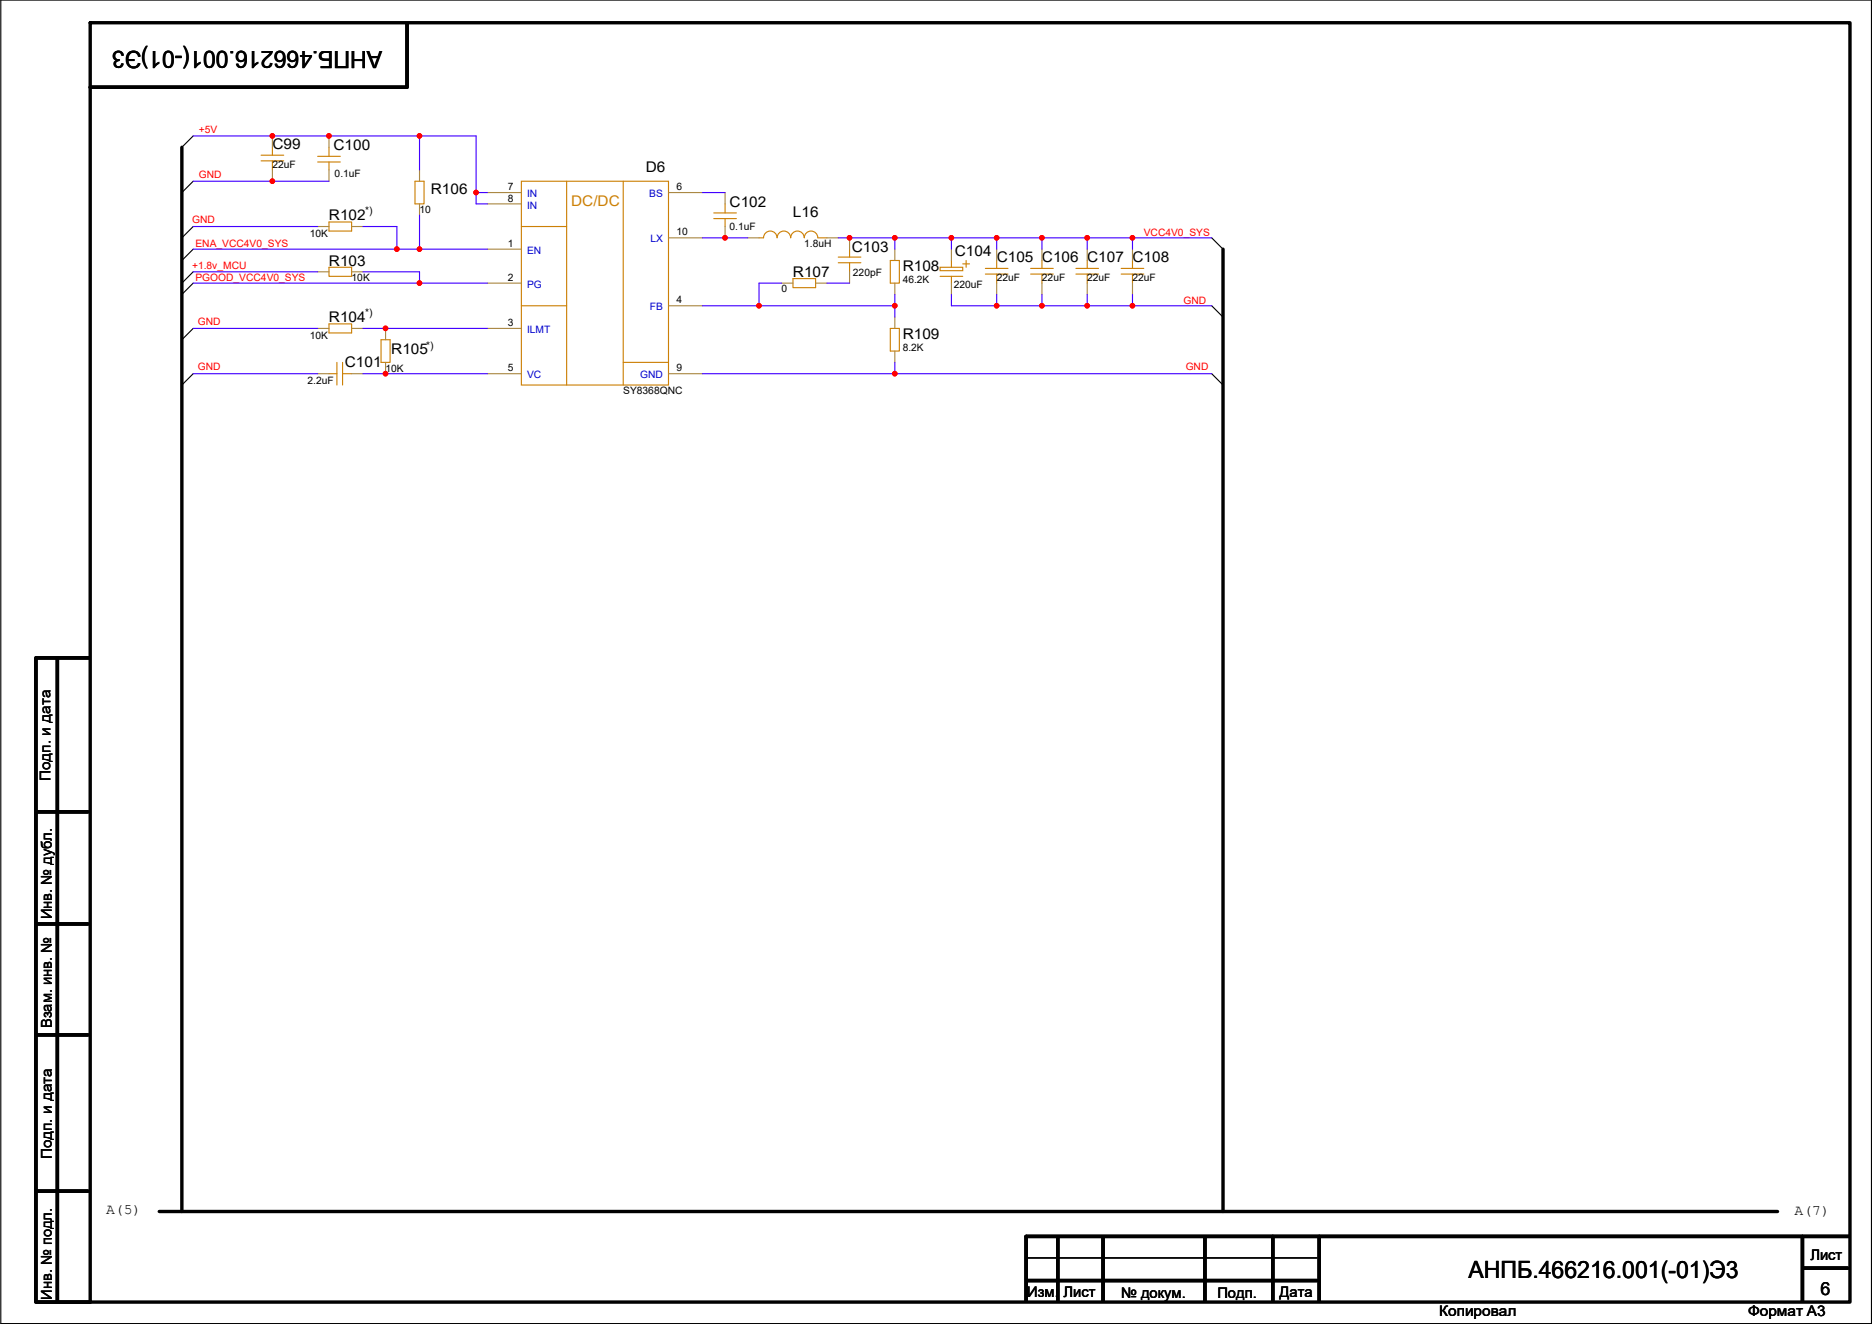
[picture p59: page 6]
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

6 АНПБ.466216.001(-01)Э3 Изм. Лист

№ докум. | Подп. | Дата

1.8V

1.1V

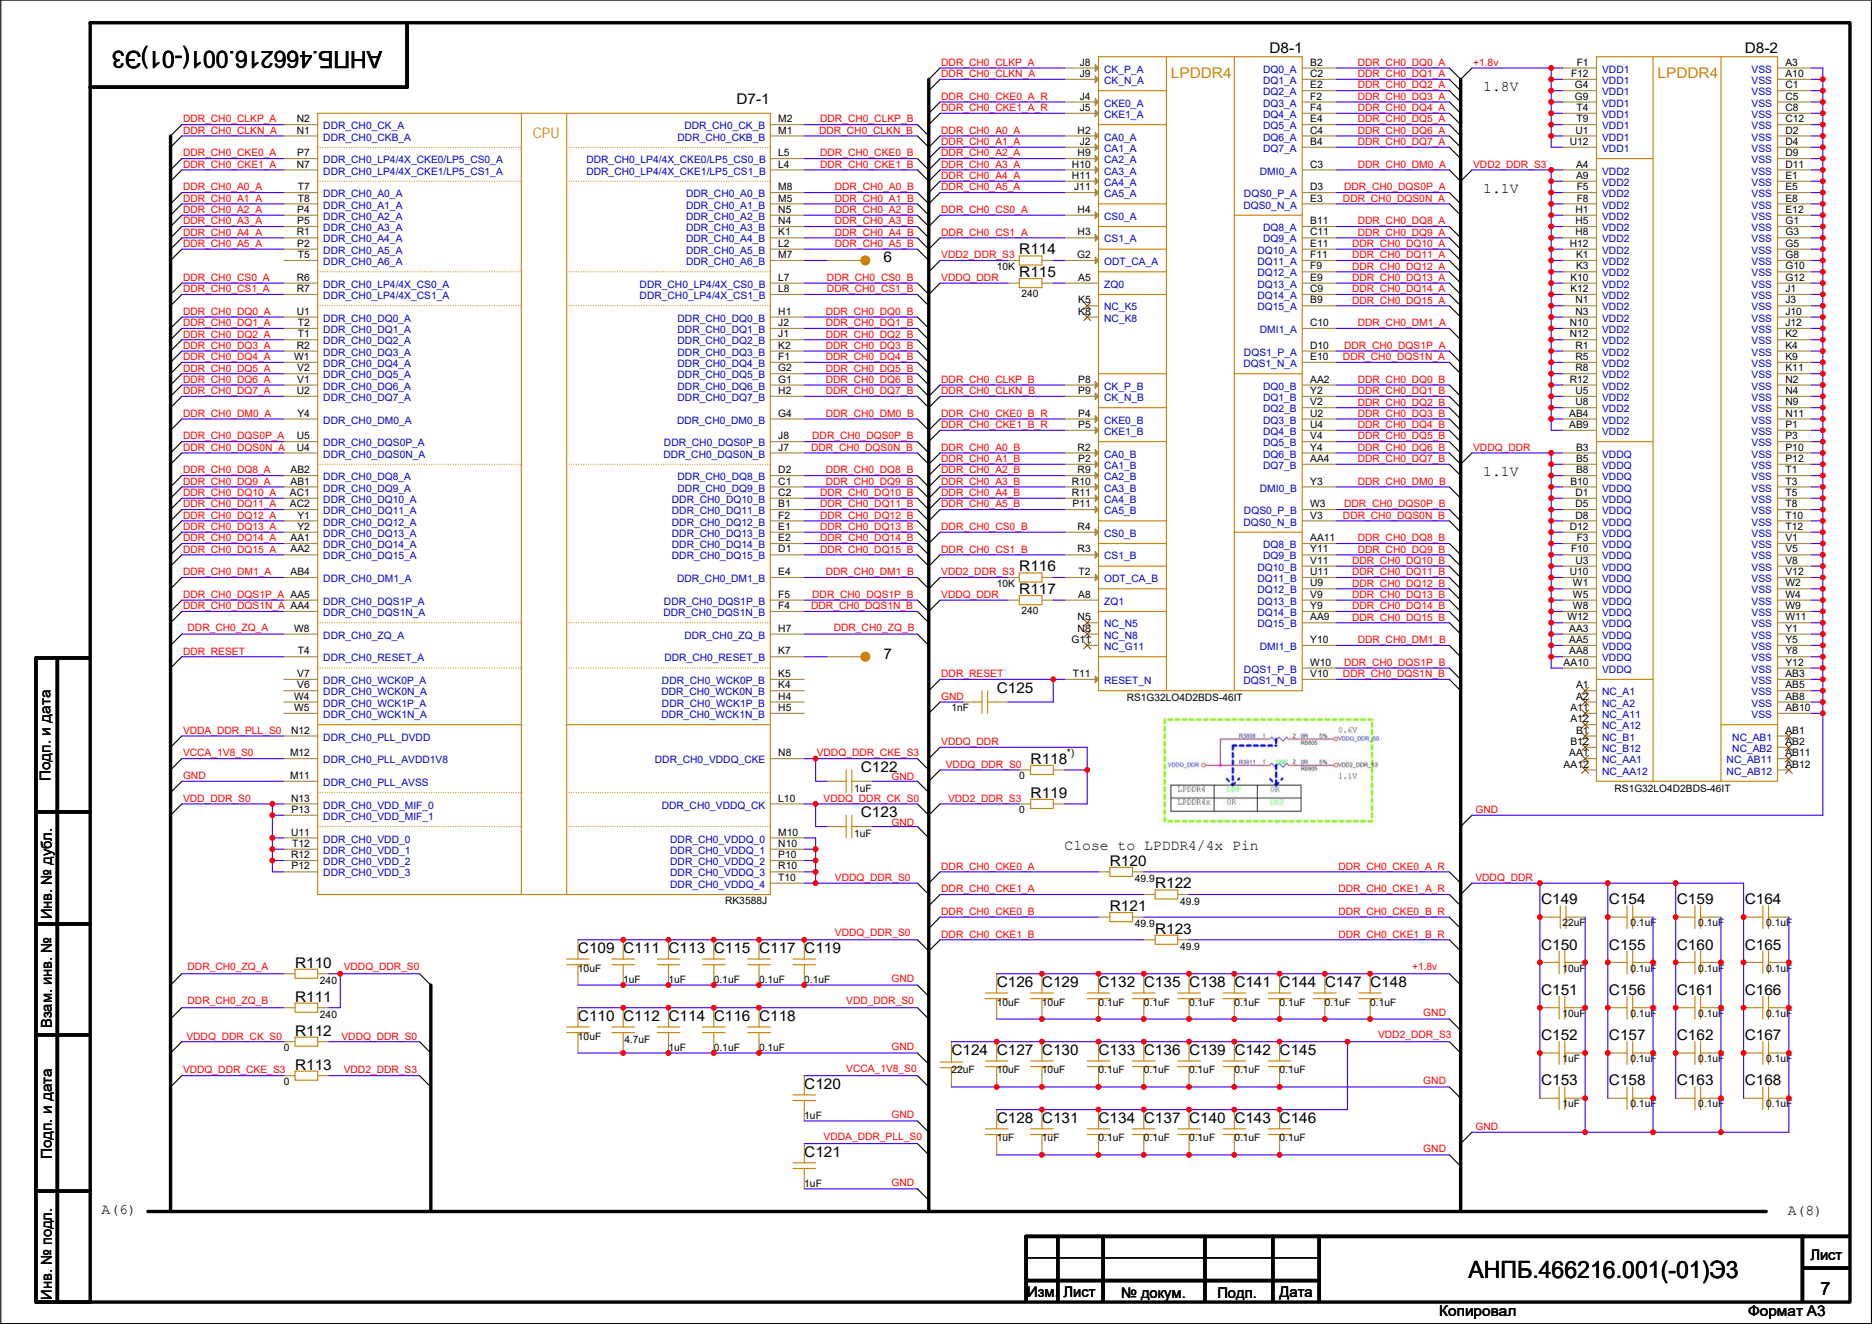
[picture p60: page 7]
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

7 АНПБ.466216.001(-01)Э3 Изм. Лист

№ докум. | Подп. | Дата

R127

D9-1

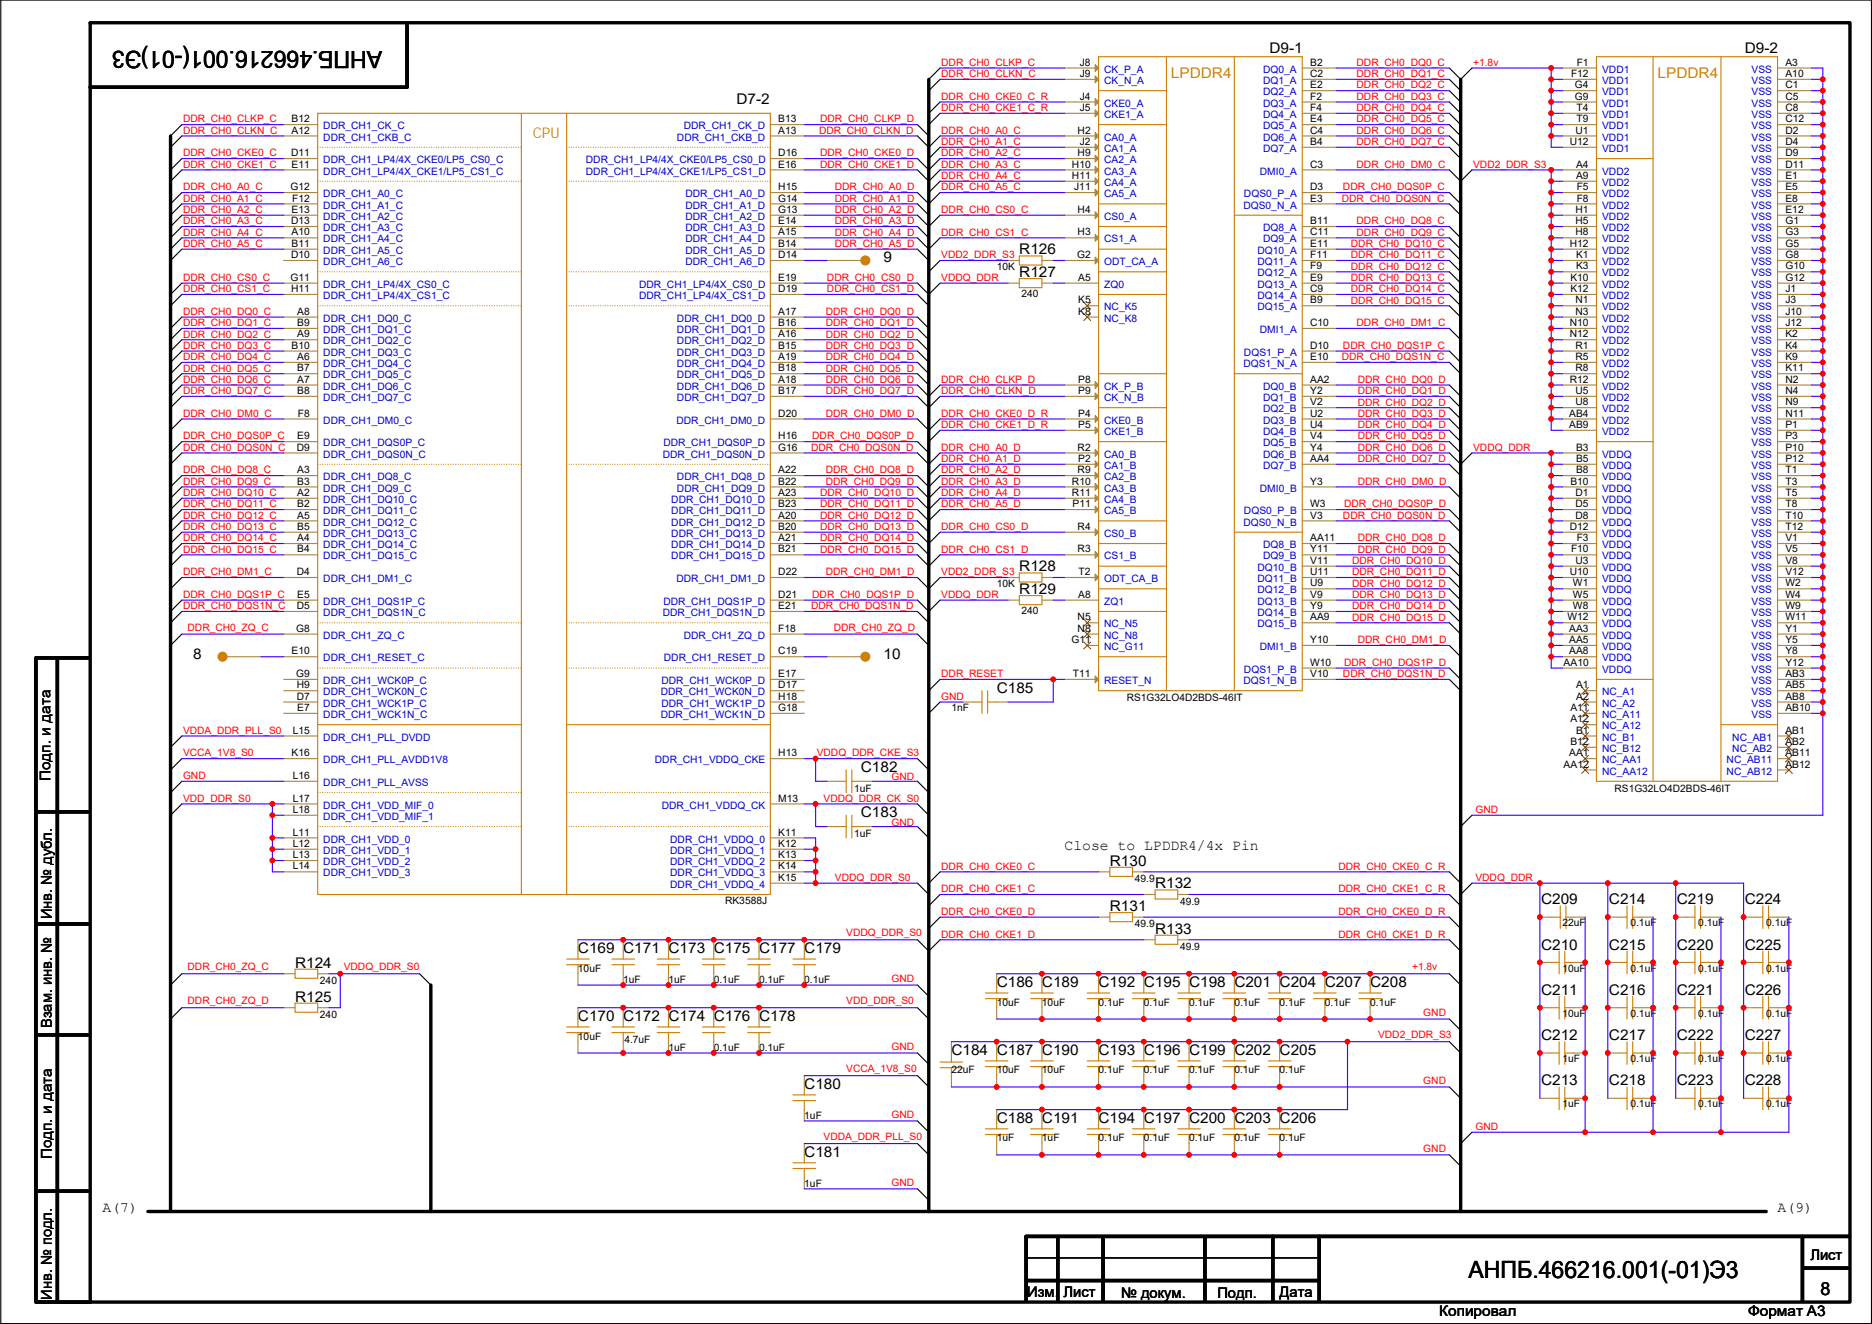
[picture p61: page 8]
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

8 АНПБ.466216.001(-01)Э3 Изм. Лист

№ докум. | Подп. | Дата

# Operating Voltage=1.8V

# RK3588_C(EMMCIO Domain)

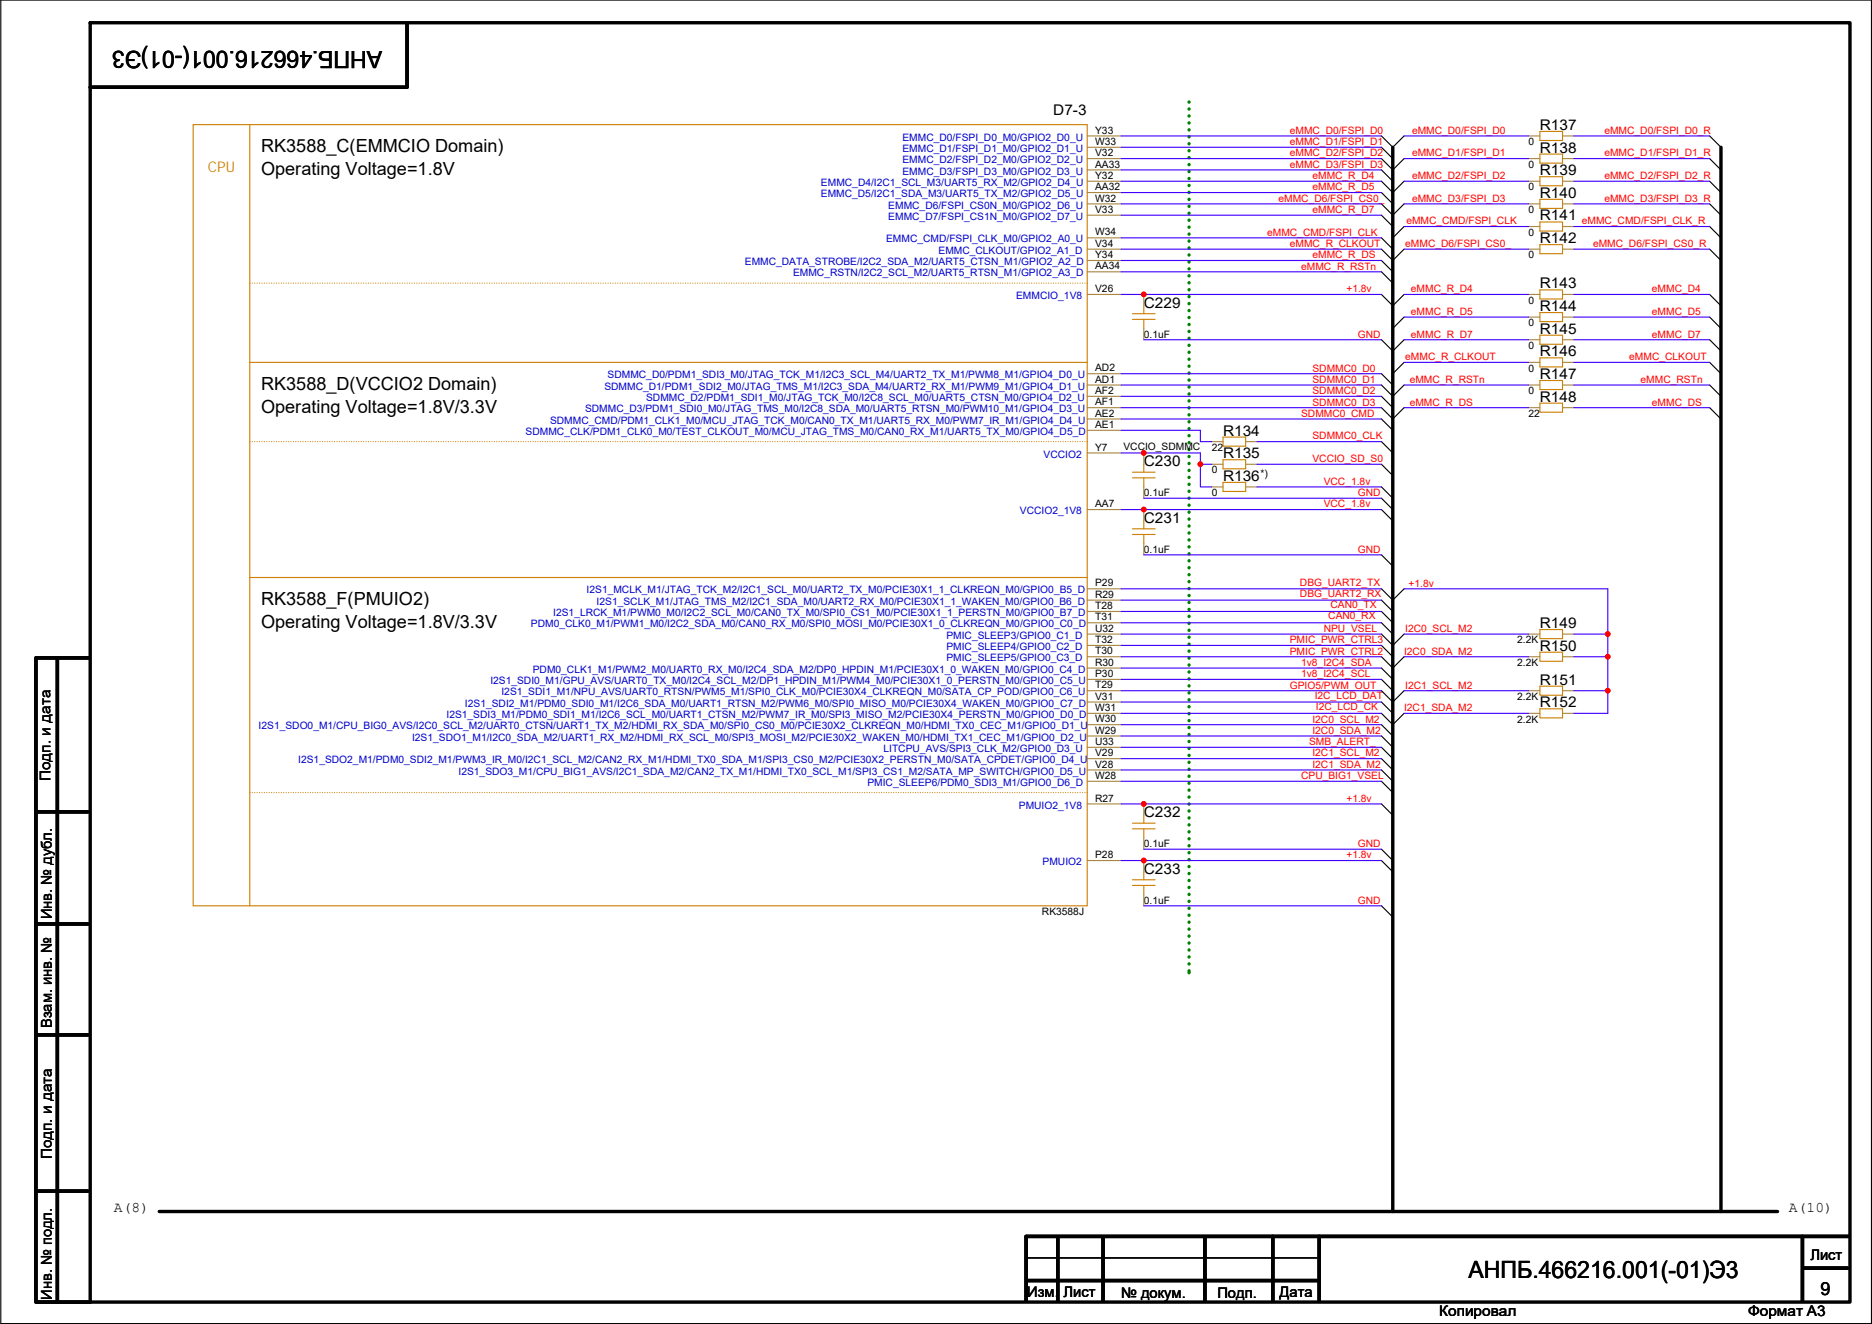
[picture p62: page 9]
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

9 АНПБ.466216.001(-01)Э3 Изм. Лист

№ докум. | Подп. | Дата

## This cap should be placed close to the Pin M6(<400mil)

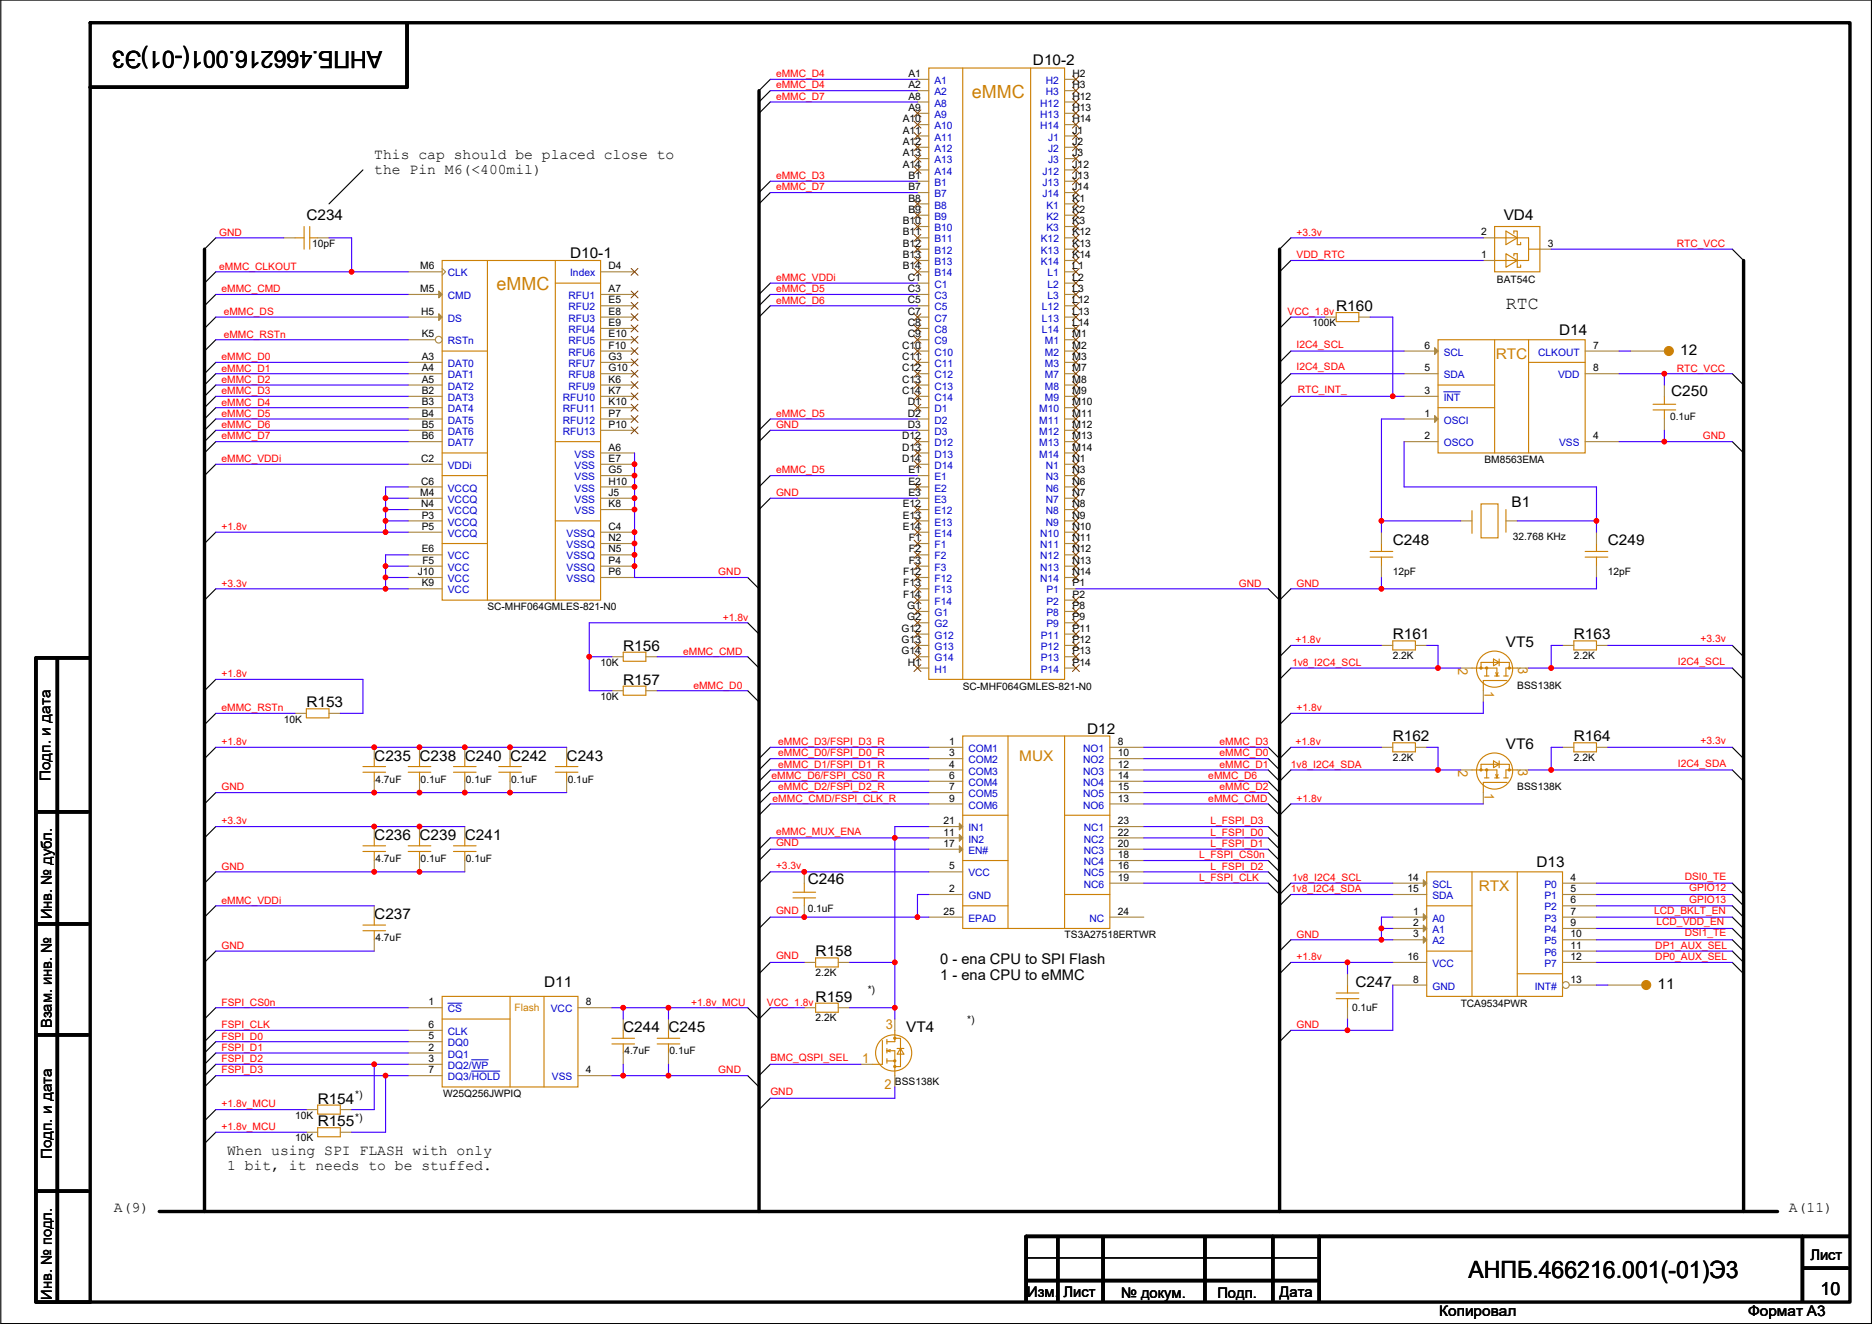
[picture p63: page 10]
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

0 - ena CPU to SPI Flash
1 - ena CPU to eMMC

+1.8v_MCU
When using SPI FLASH with only
1 bit, it needs to be stuffed.

10 АНПБ.466216.001(-01)Э3 Изм. Лист

№ докум. | Подп. | Дата

R165

C254

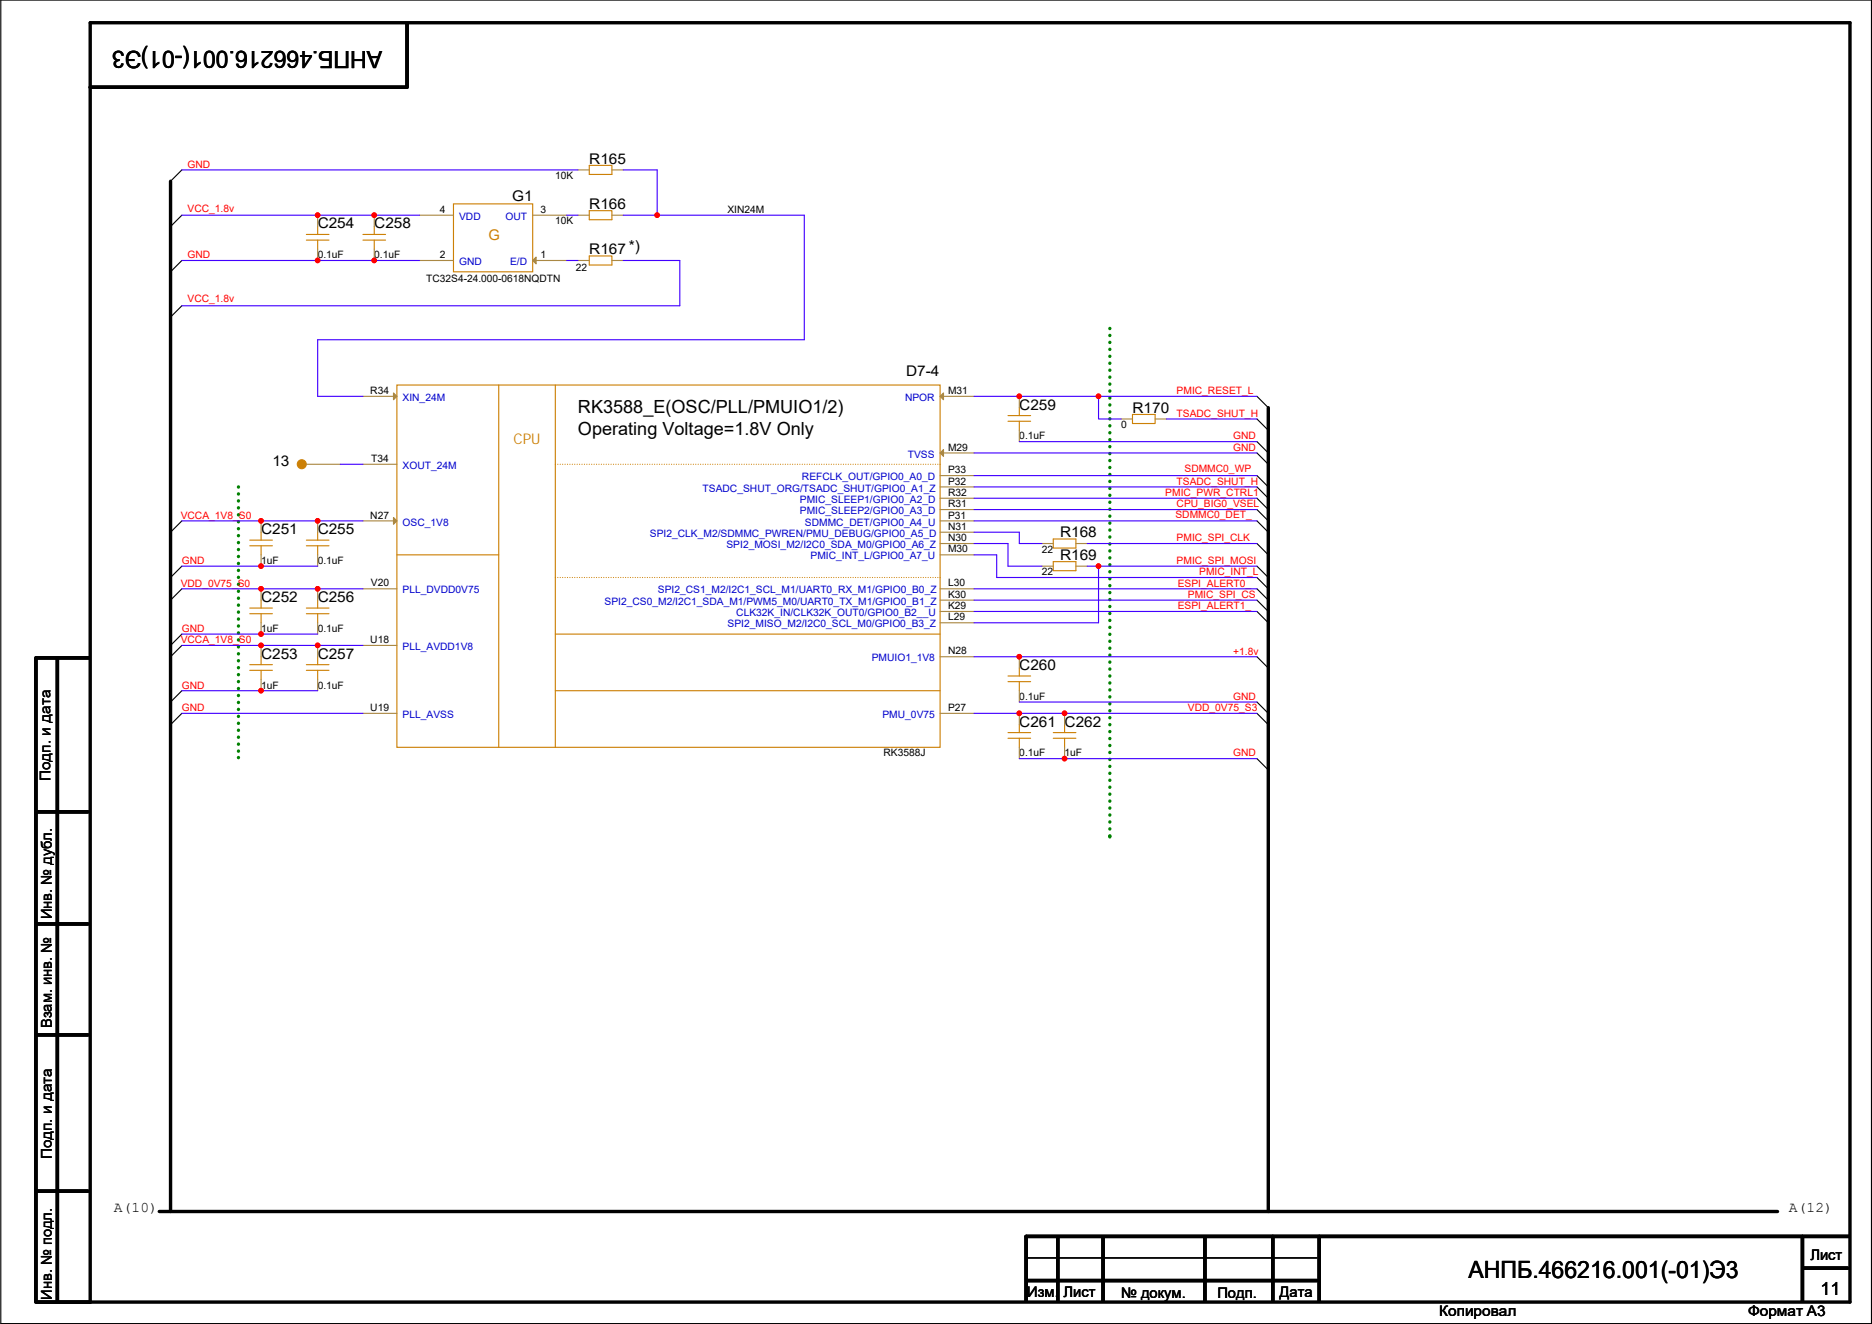
[picture p64: page 11]

Инв. № подл. Инв. № дубл. Подп. и дата Подп. и дата Взам. инв. №

11 АНПБ.466216.001(-01)Э3 Изм. Лист
Изм. Лист | № докум. | Подп. | Дата

№ докум. | Подп. | Дата

# VCCIO1 Domain

# Operating Voltage=1.8V

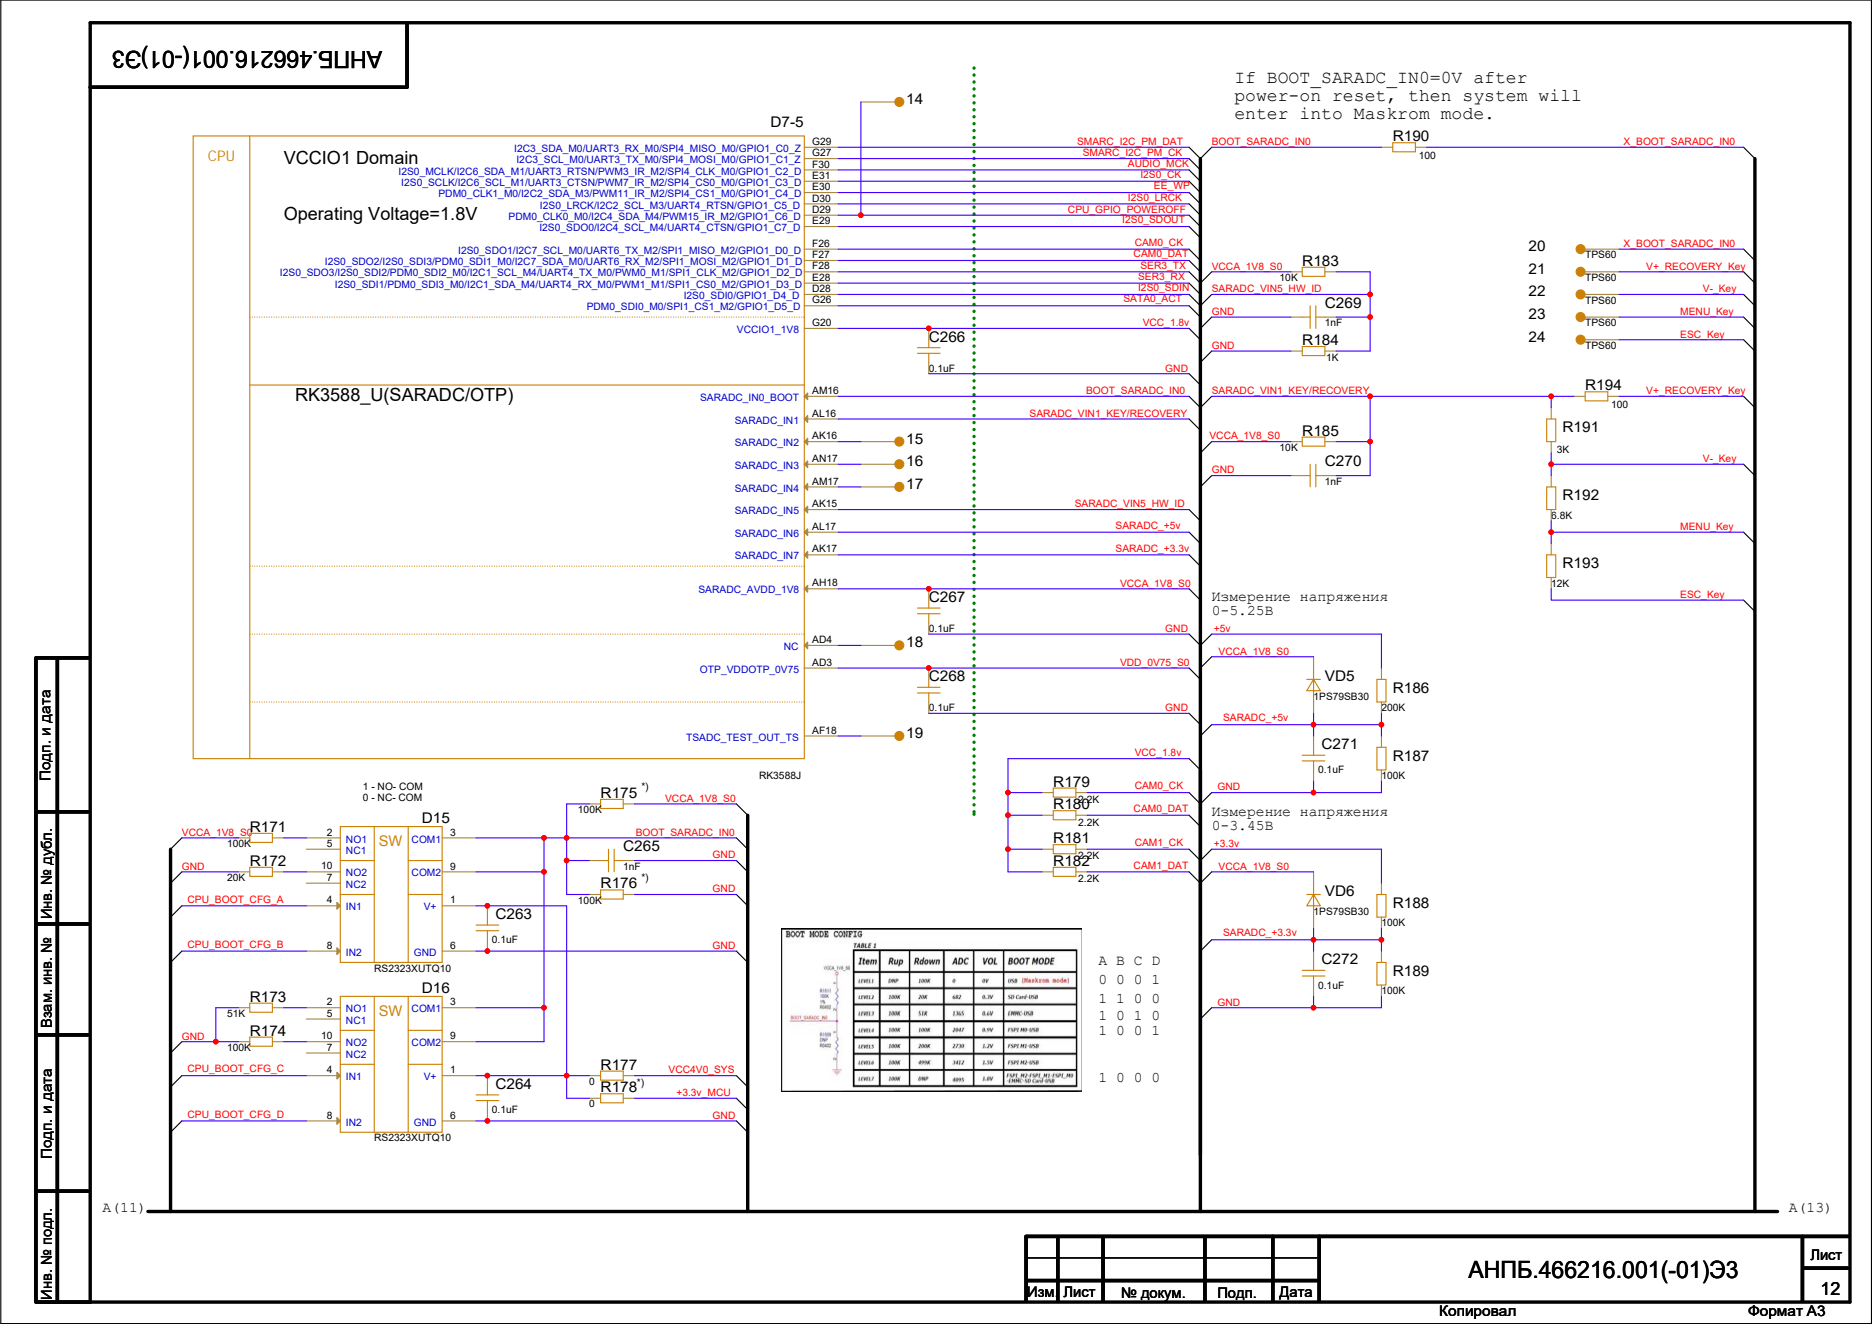
[picture p65: page 12]

If BOOT_SARADC_IN0=0V after
power-on reset, then system will
enter into Maskrom mode.

Инв. № подл. Инв. № дубл. Подп. и дата Подп. и дата Взам. инв. №

12 АНПБ.466216.001(-01)Э3 Изм. Лист
Изм. Лист | № докум. | Подп. | Дата

№ докум. | Подп. | Дата

# Operating Voltage=1.8V

# VCCIO3 Domain

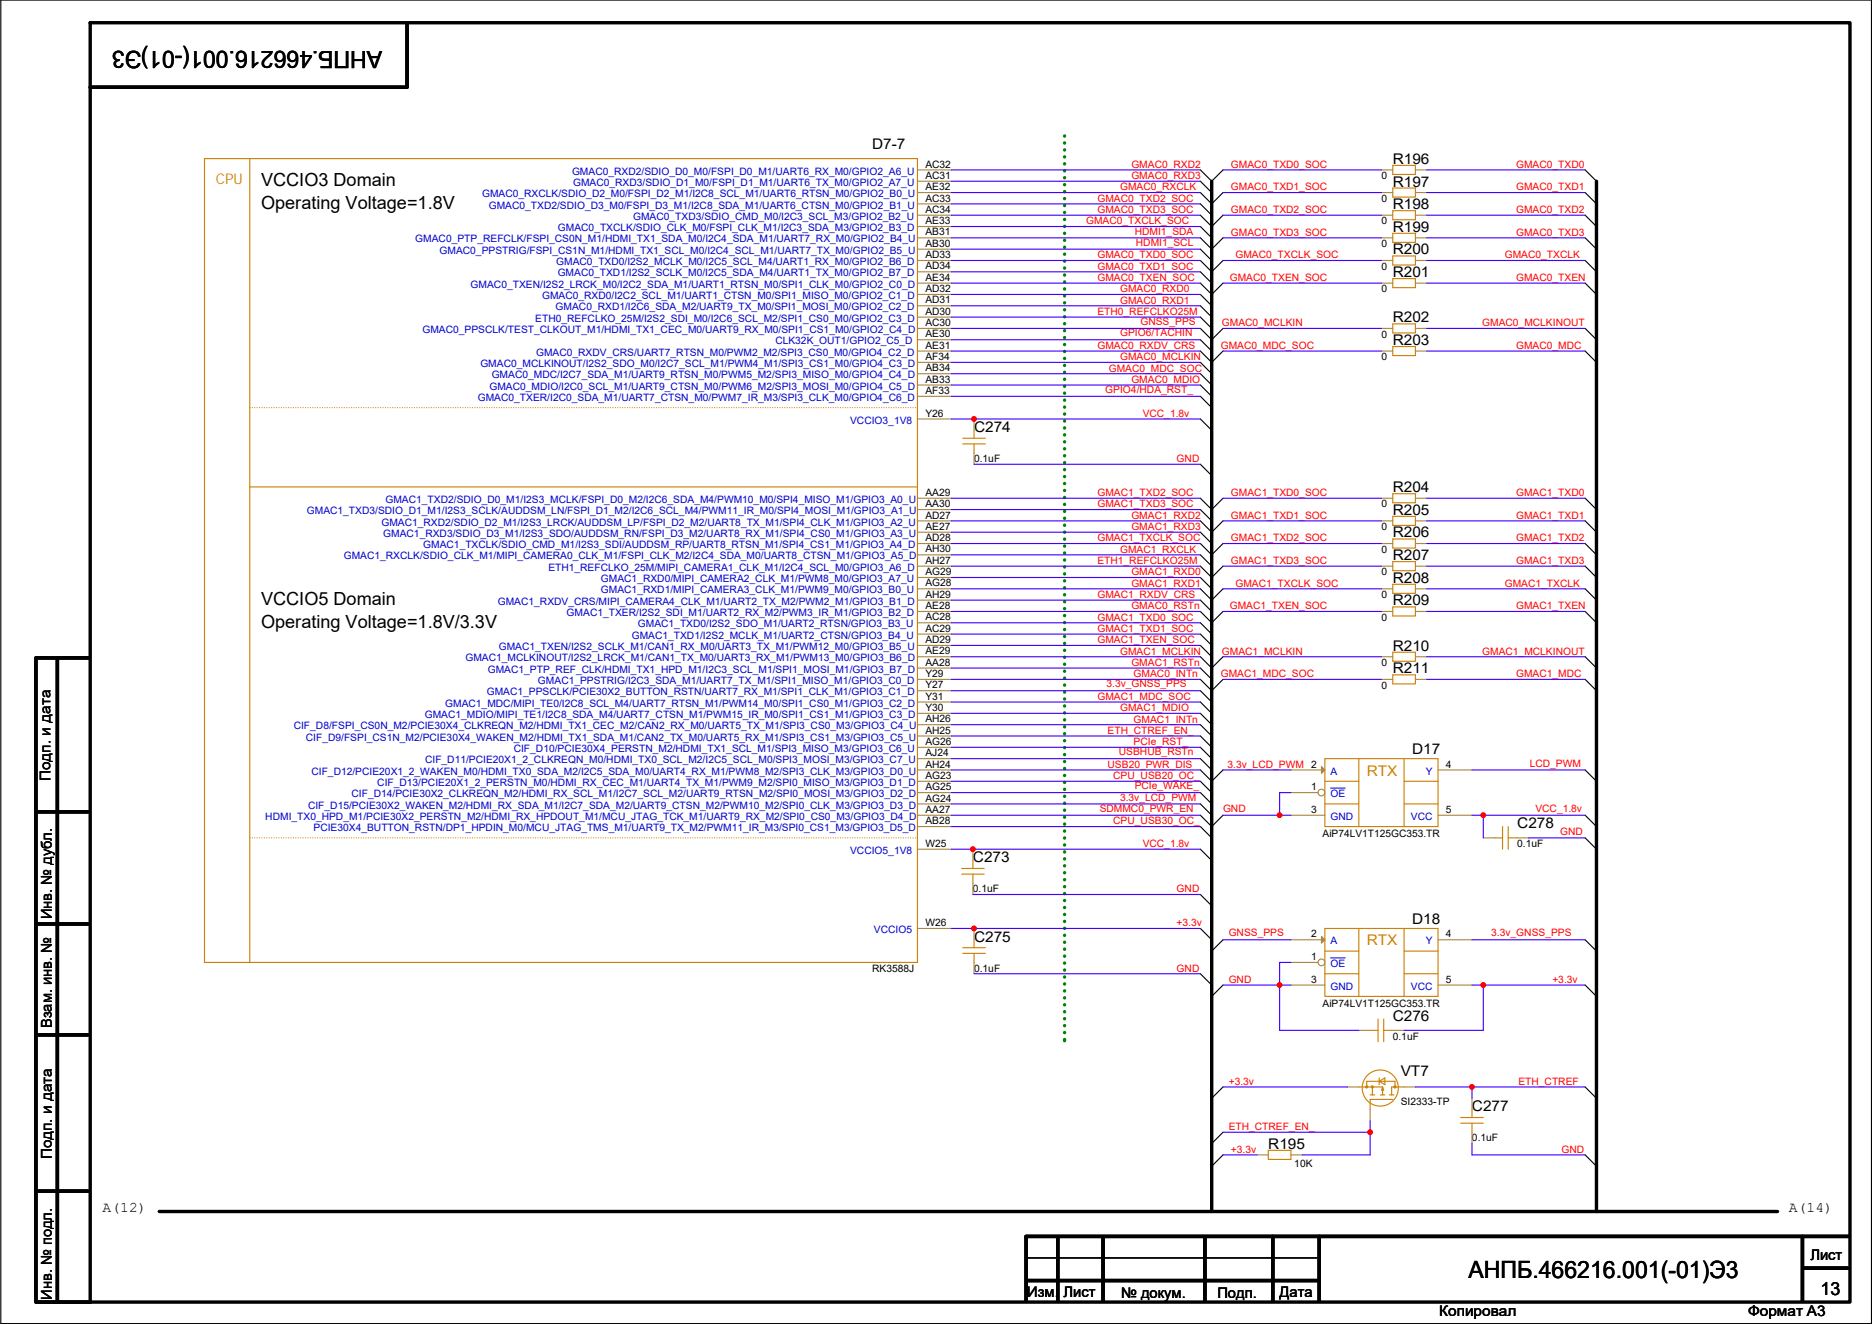
[picture p66: page 13]
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

13 АНПБ.466216.001(-01)Э3 Изм. Лист

№ докум. | Подп. | Дата

## RTL8211FDI-VD-CG only Поставить под L1

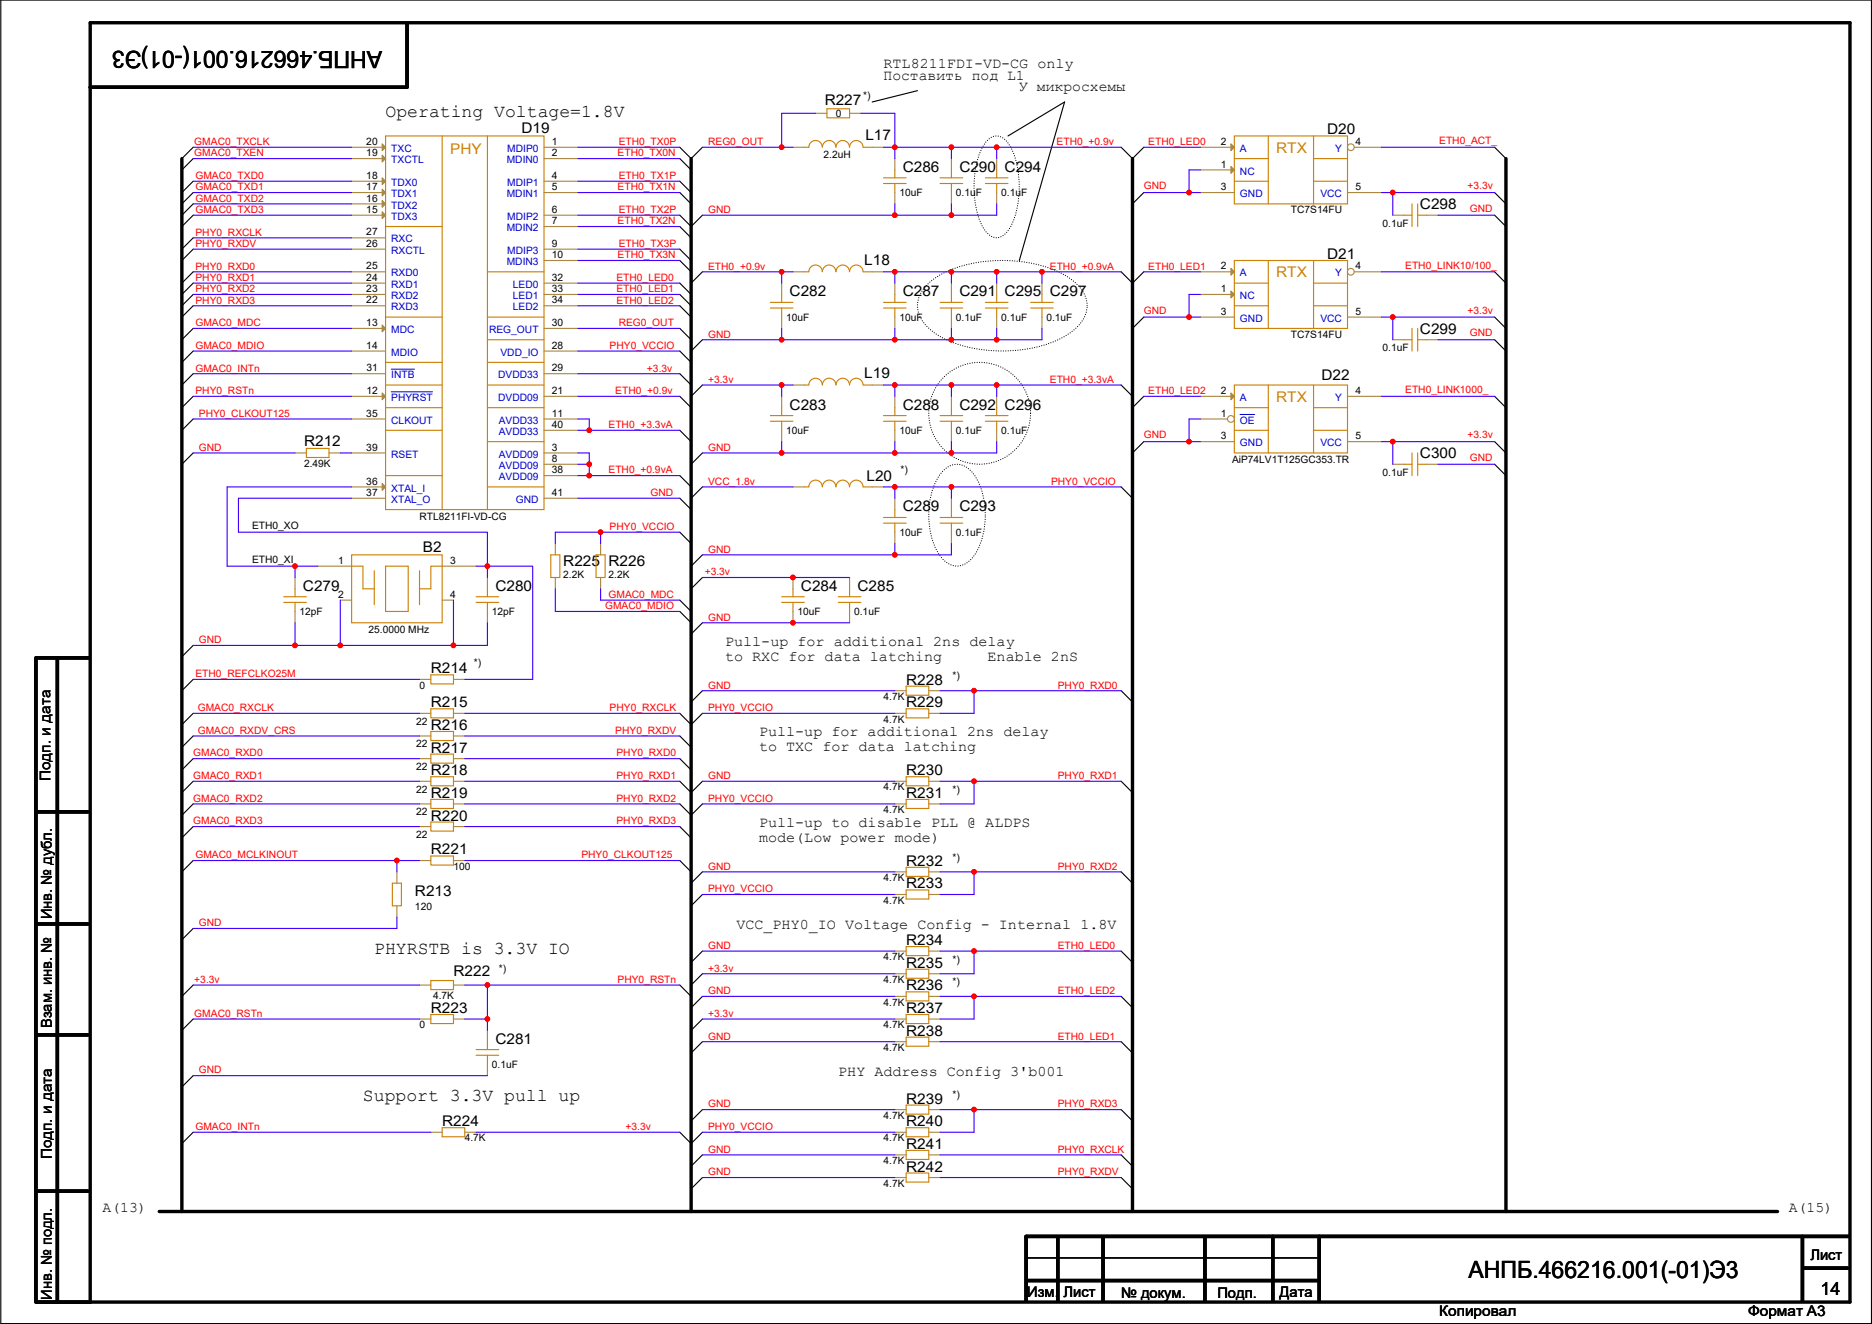
[picture p67: page 14]

GND
Pull-up for additional 2ns delay

Инв. № подл. Инв. № дубл. Подп. и дата Подп. и дата Взам. инв. №

to TXC for data latching

Pull-up to disable PLL @ ALDPS
mode(Low power mode)

14 АНПБ.466216.001(-01)Э3 Изм. Лист
Изм. Лист | № докум. | Подп. | Дата

№ докум. | Подп. | Дата

## RTL8211FDI-VD-CG only Поставить под L1У микросхемы

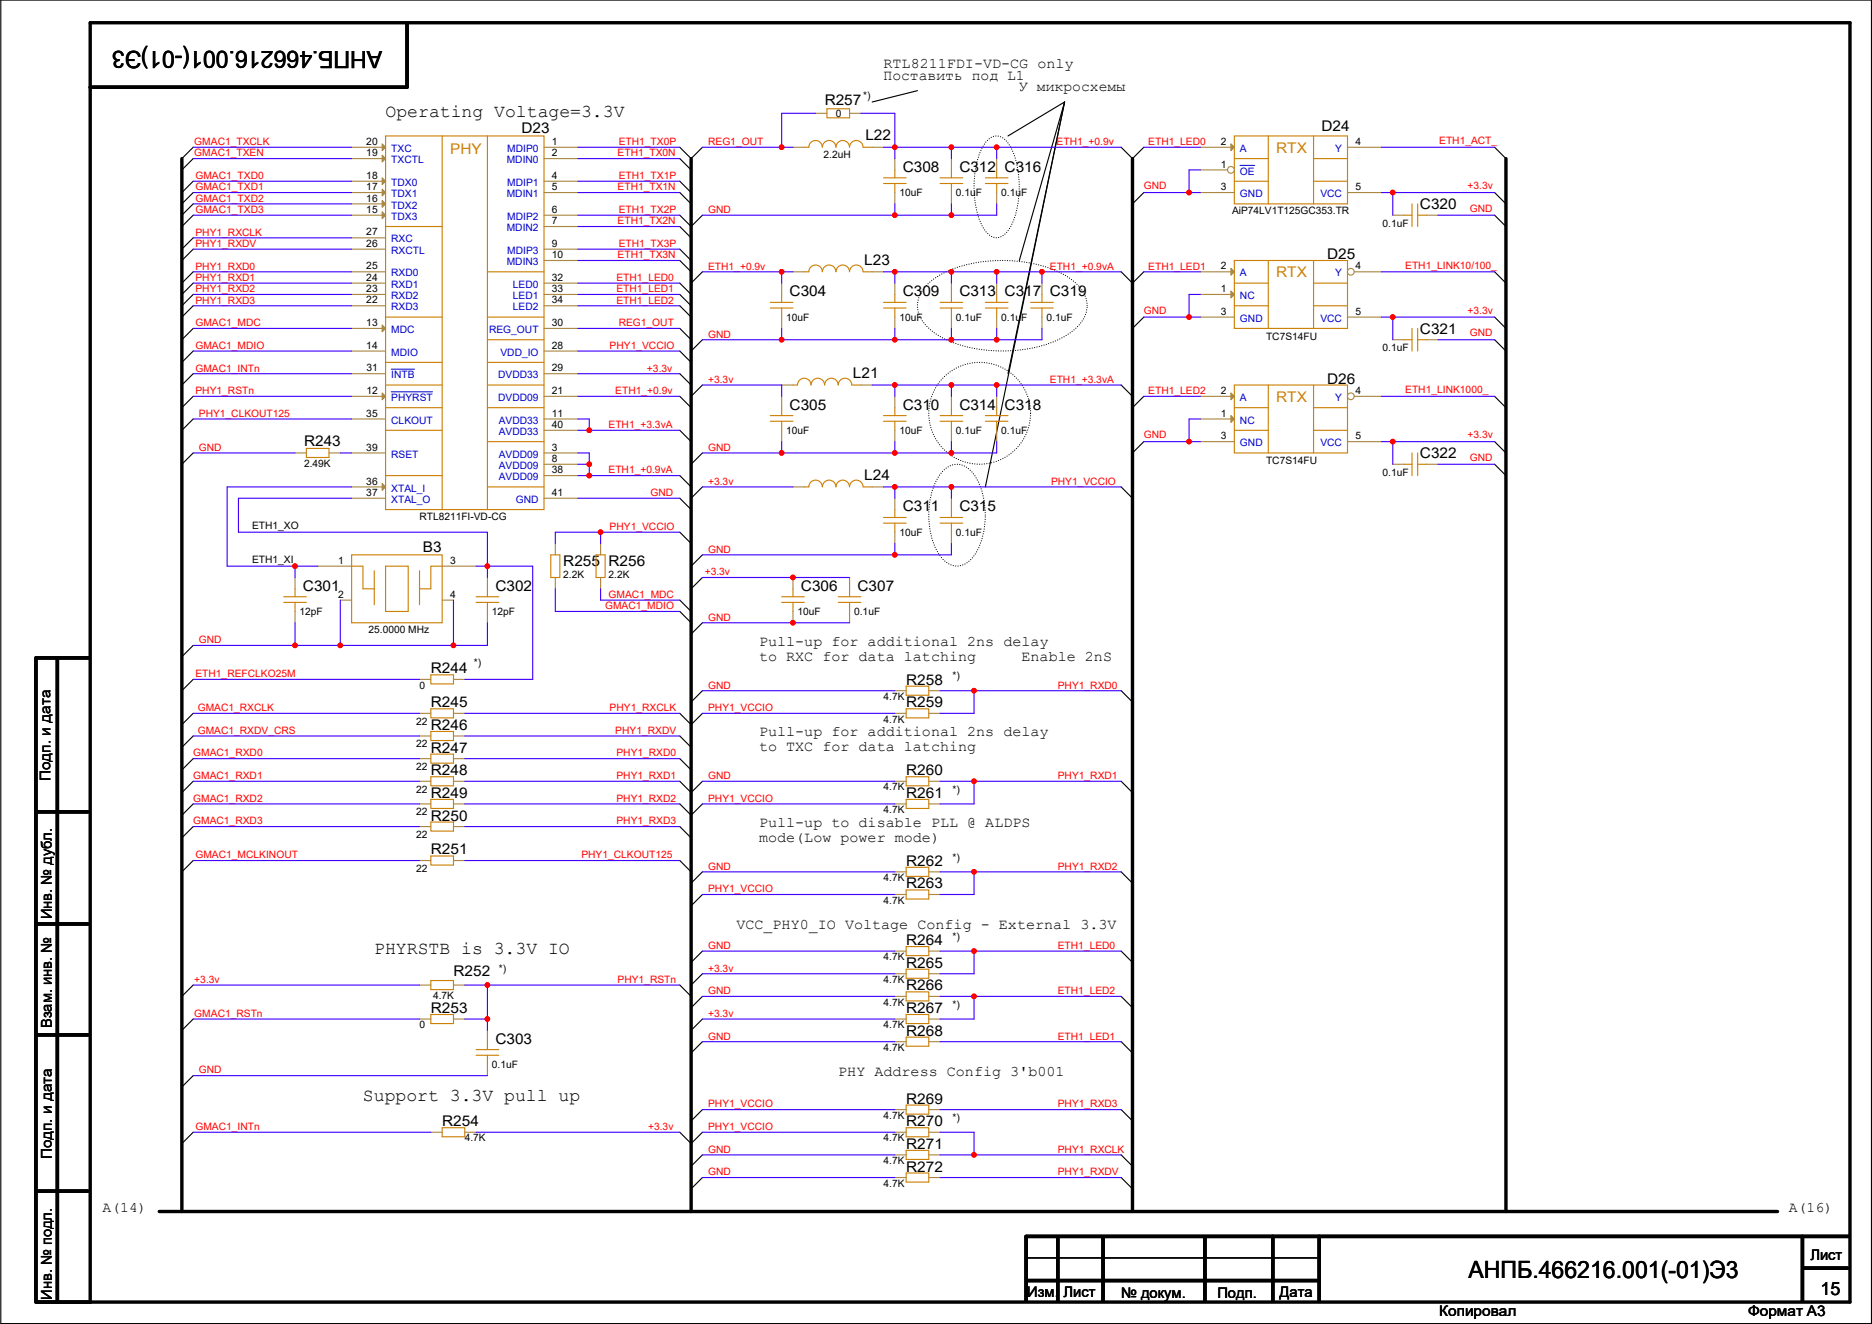
[picture p68: page 15]

Pull-up for additional 2ns delay

Инв. № подл. Инв. № дубл. Подп. и дата Подп. и дата Взам. инв. № R270 4.7K *)

to TXC for data latching

Pull-up to disable PLL @ ALDPS
mode(Low power mode)

15 АНПБ.466216.001(-01)Э3 Изм. Лист
Изм. Лист | № докум. | Подп. | Дата

№ докум. | Подп. | Дата

# Operating Voltage=1.8V/3.3V

# VCCIO4 Domain

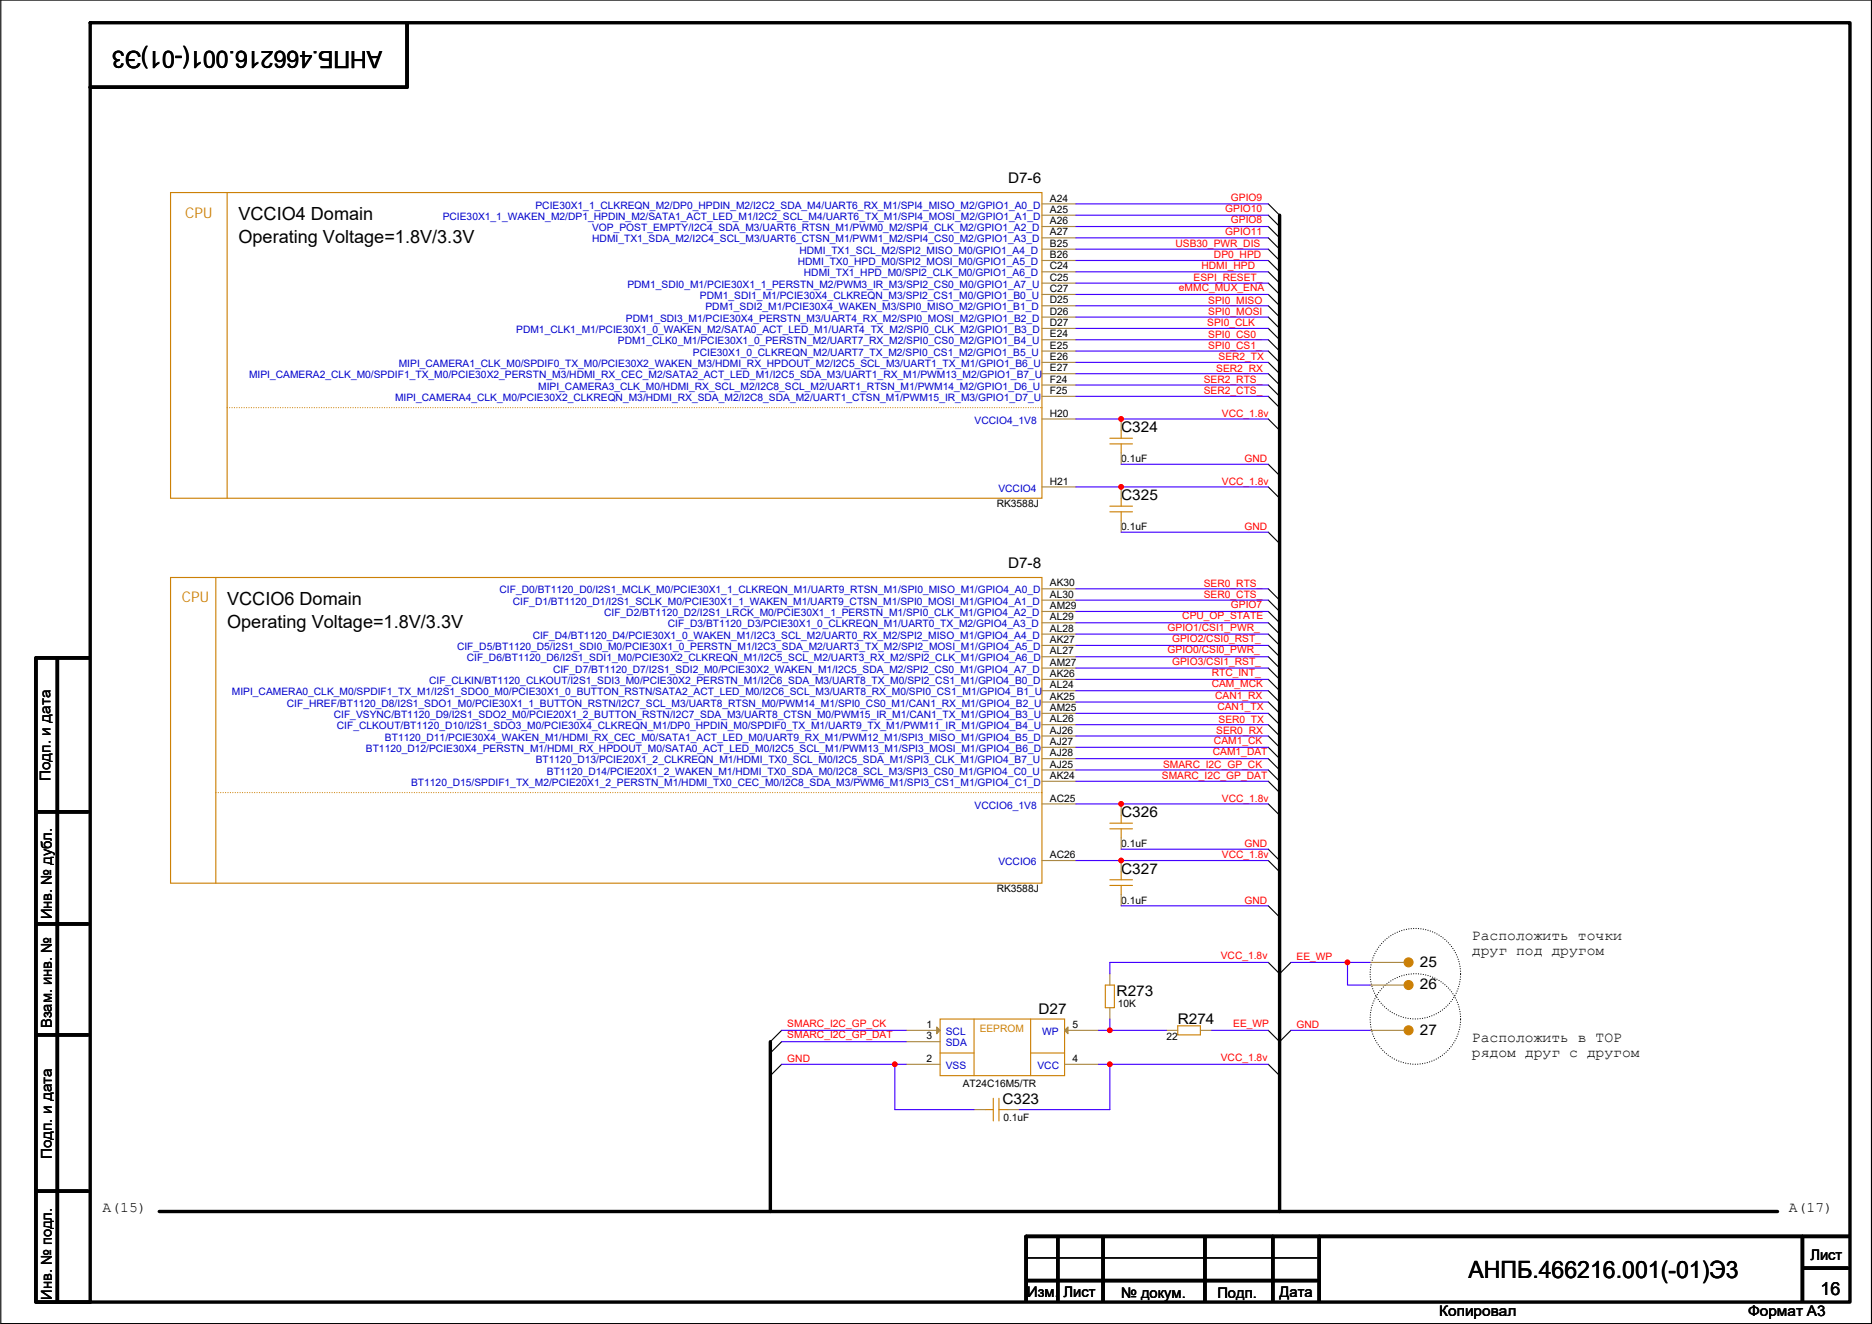
[picture p69: page 16]
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

16 АНПБ.466216.001(-01)Э3 Изм. Лист

№ докум. | Подп. | Дата

R295

R293

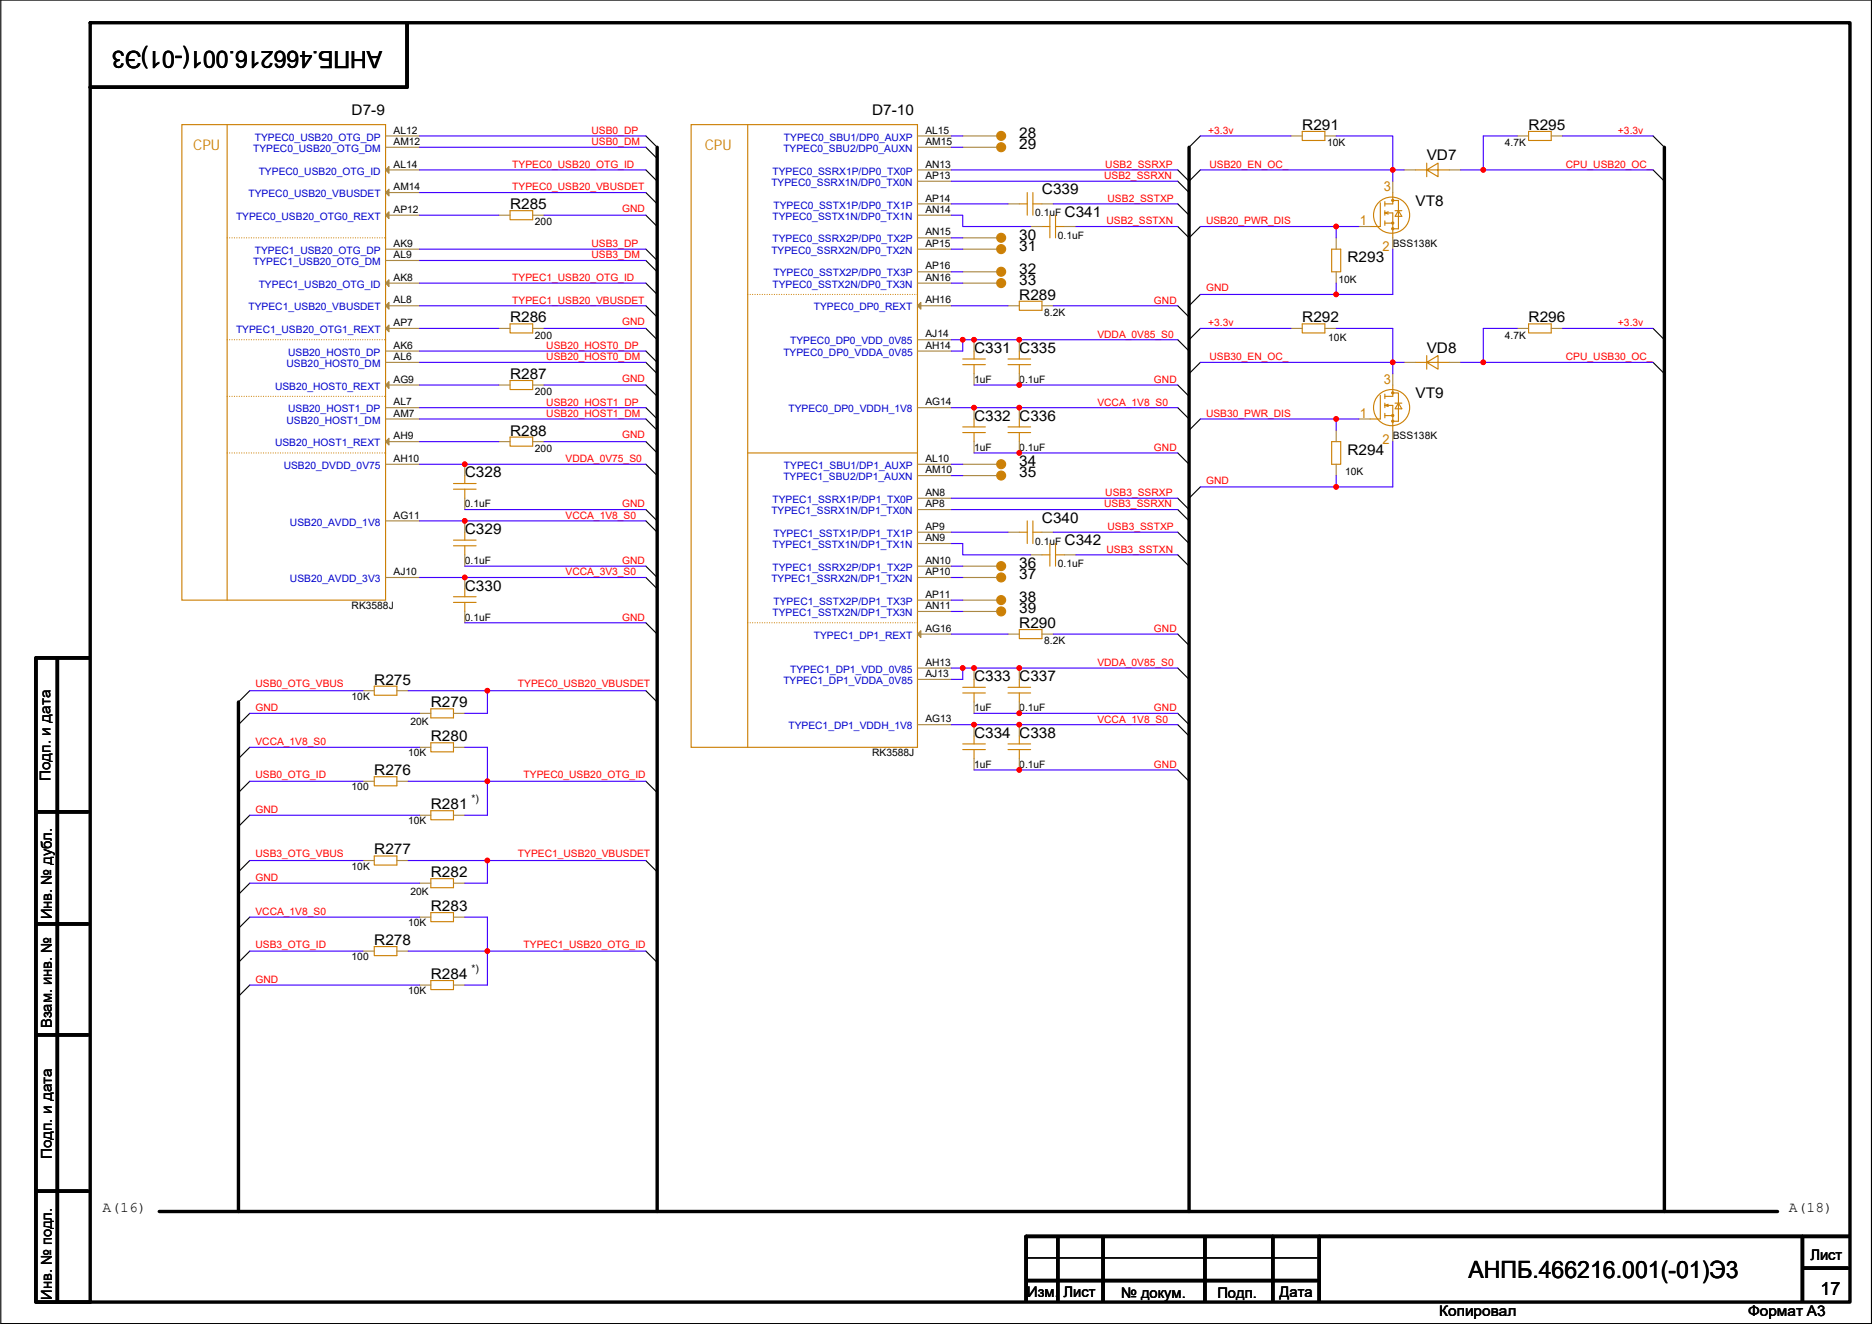
[picture p70: page 17]
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

17 АНПБ.466216.001(-01)Э3 Изм. Лист

№ докум. | Подп. | Дата

B4

R300

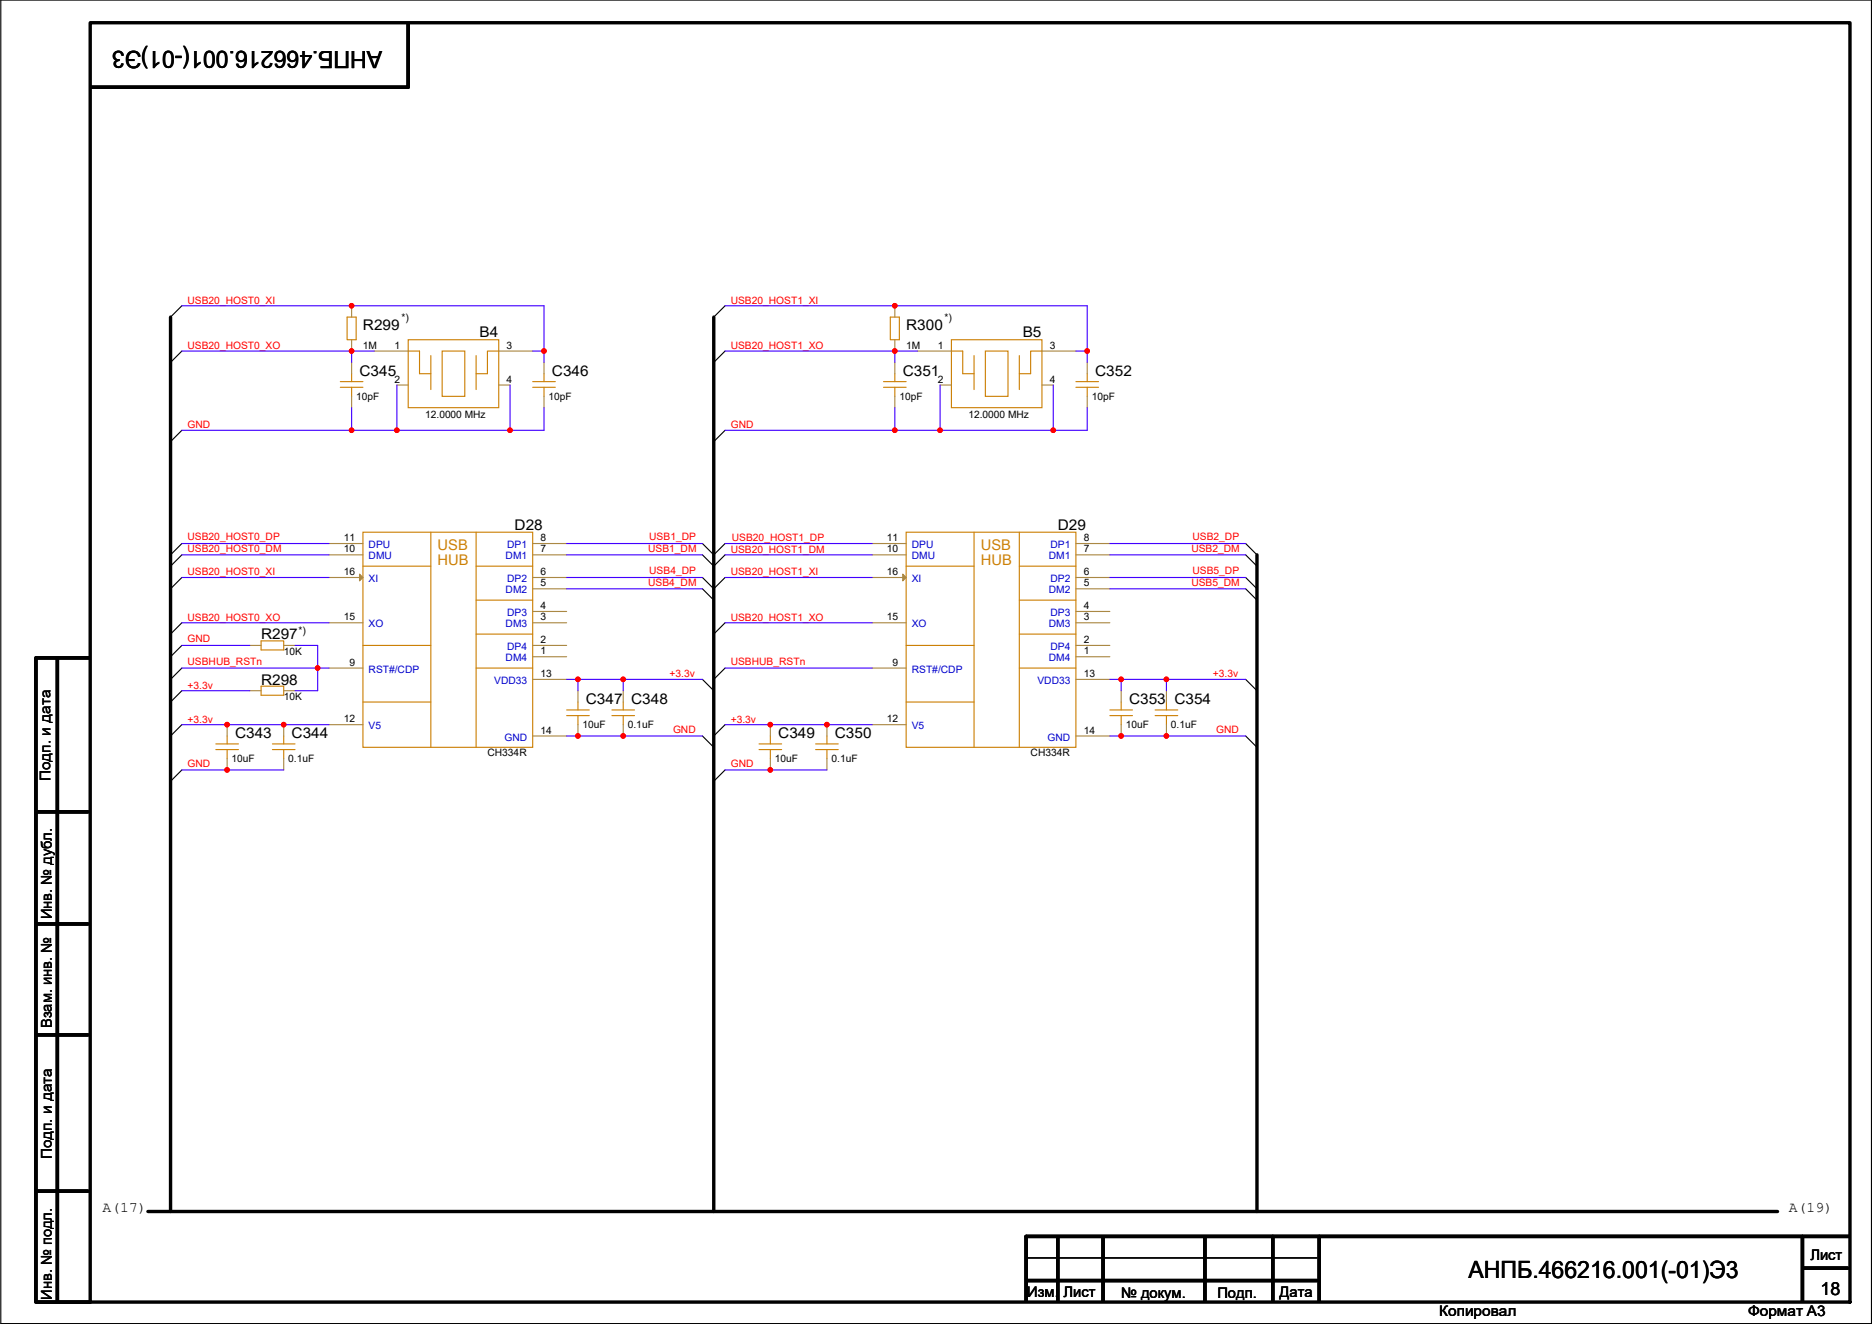
[picture p71: page 18]

Инв. № подл. Инв. № дубл. Подп. и дата Подп. и дата Взам. инв. №

18 АНПБ.466216.001(-01)Э3 Изм. Лист
Изм. Лист | № докум. | Подп. | Дата

№ докум. | Подп. | Дата

C369

C371

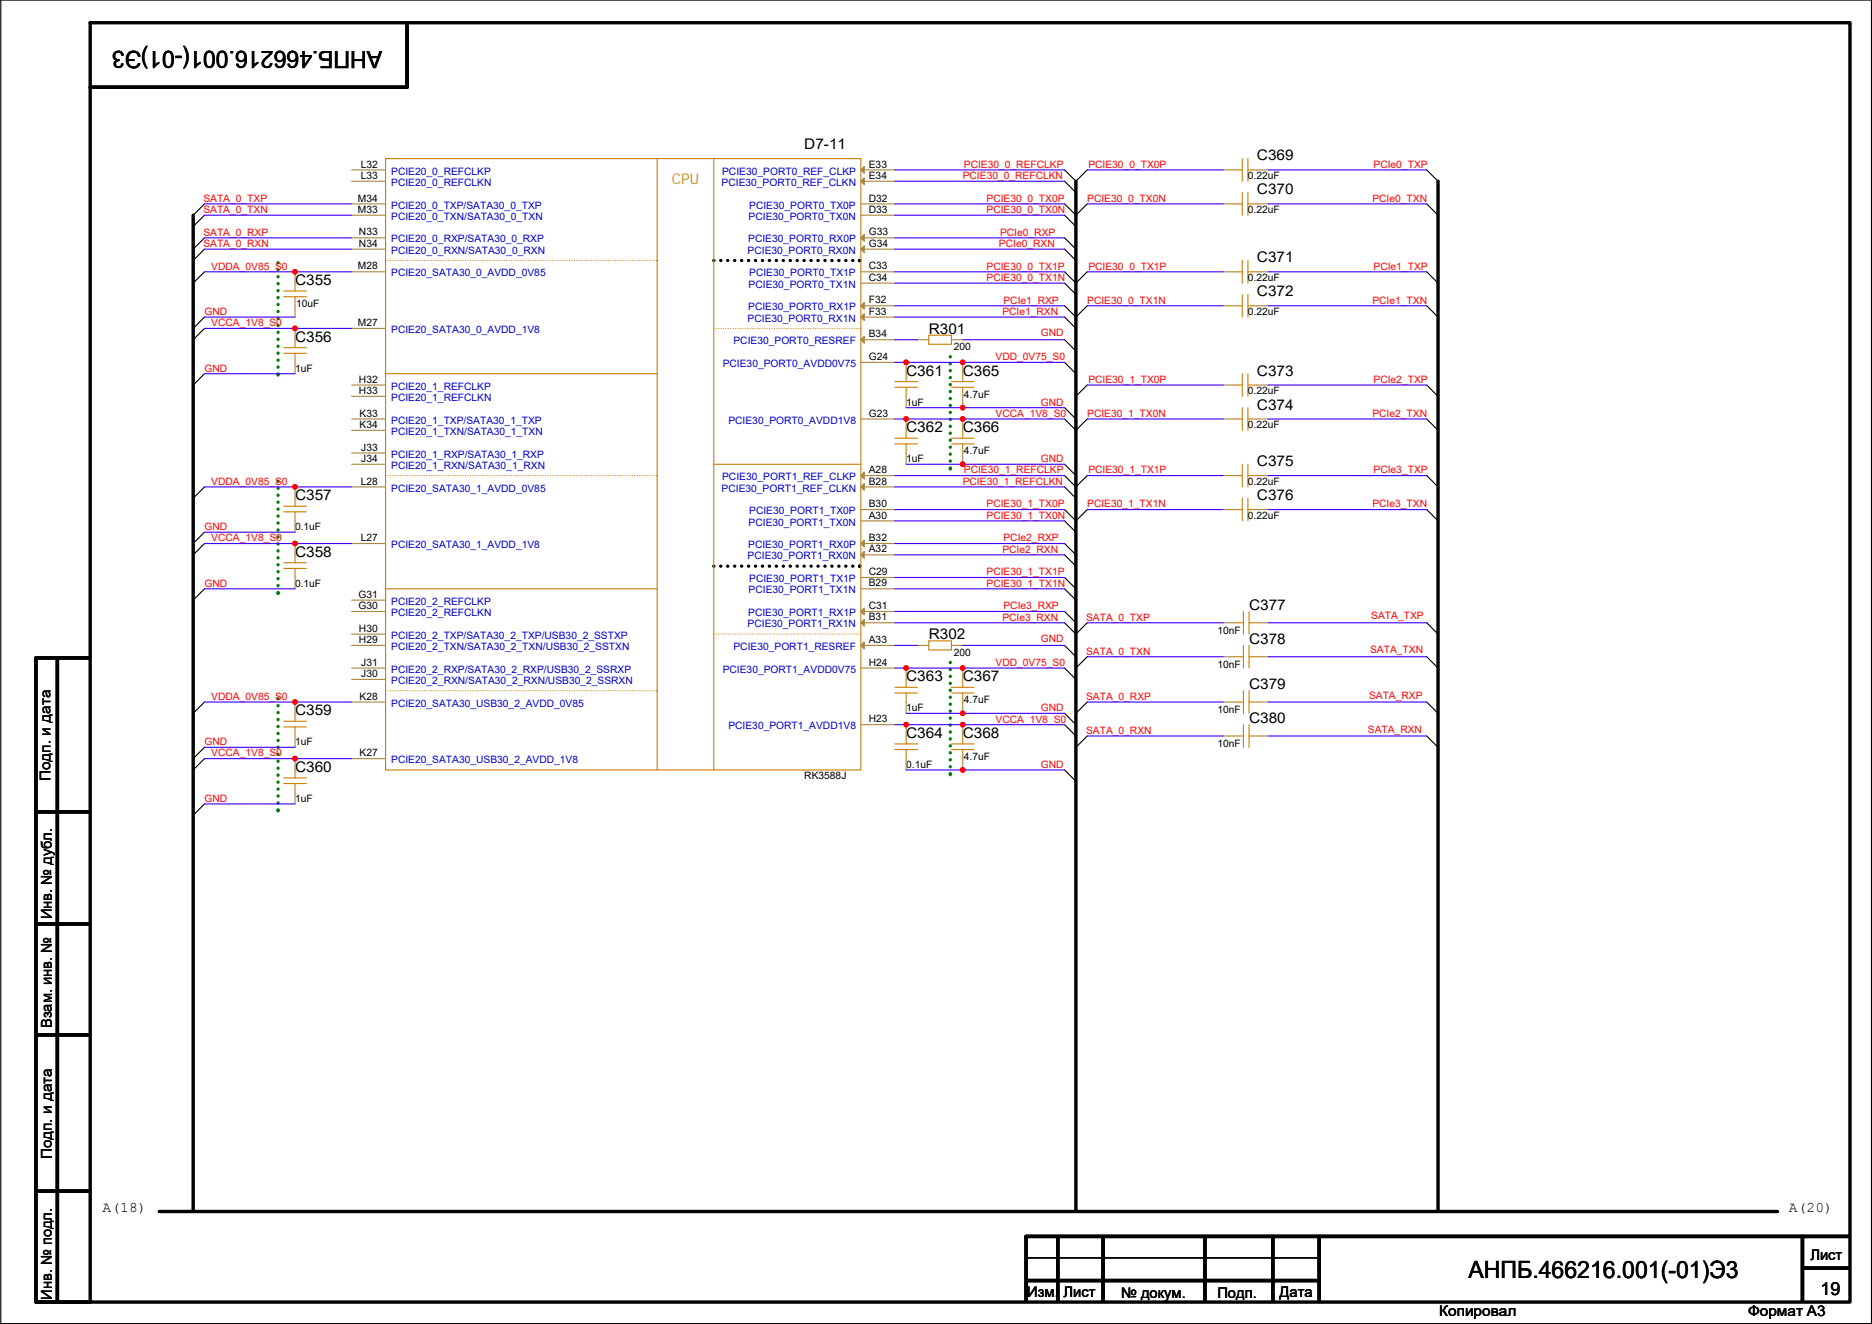
[picture p72: page 19]
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

19 АНПБ.466216.001(-01)Э3 Изм. Лист

№ докум. | Подп. | Дата

R312
1M | C394

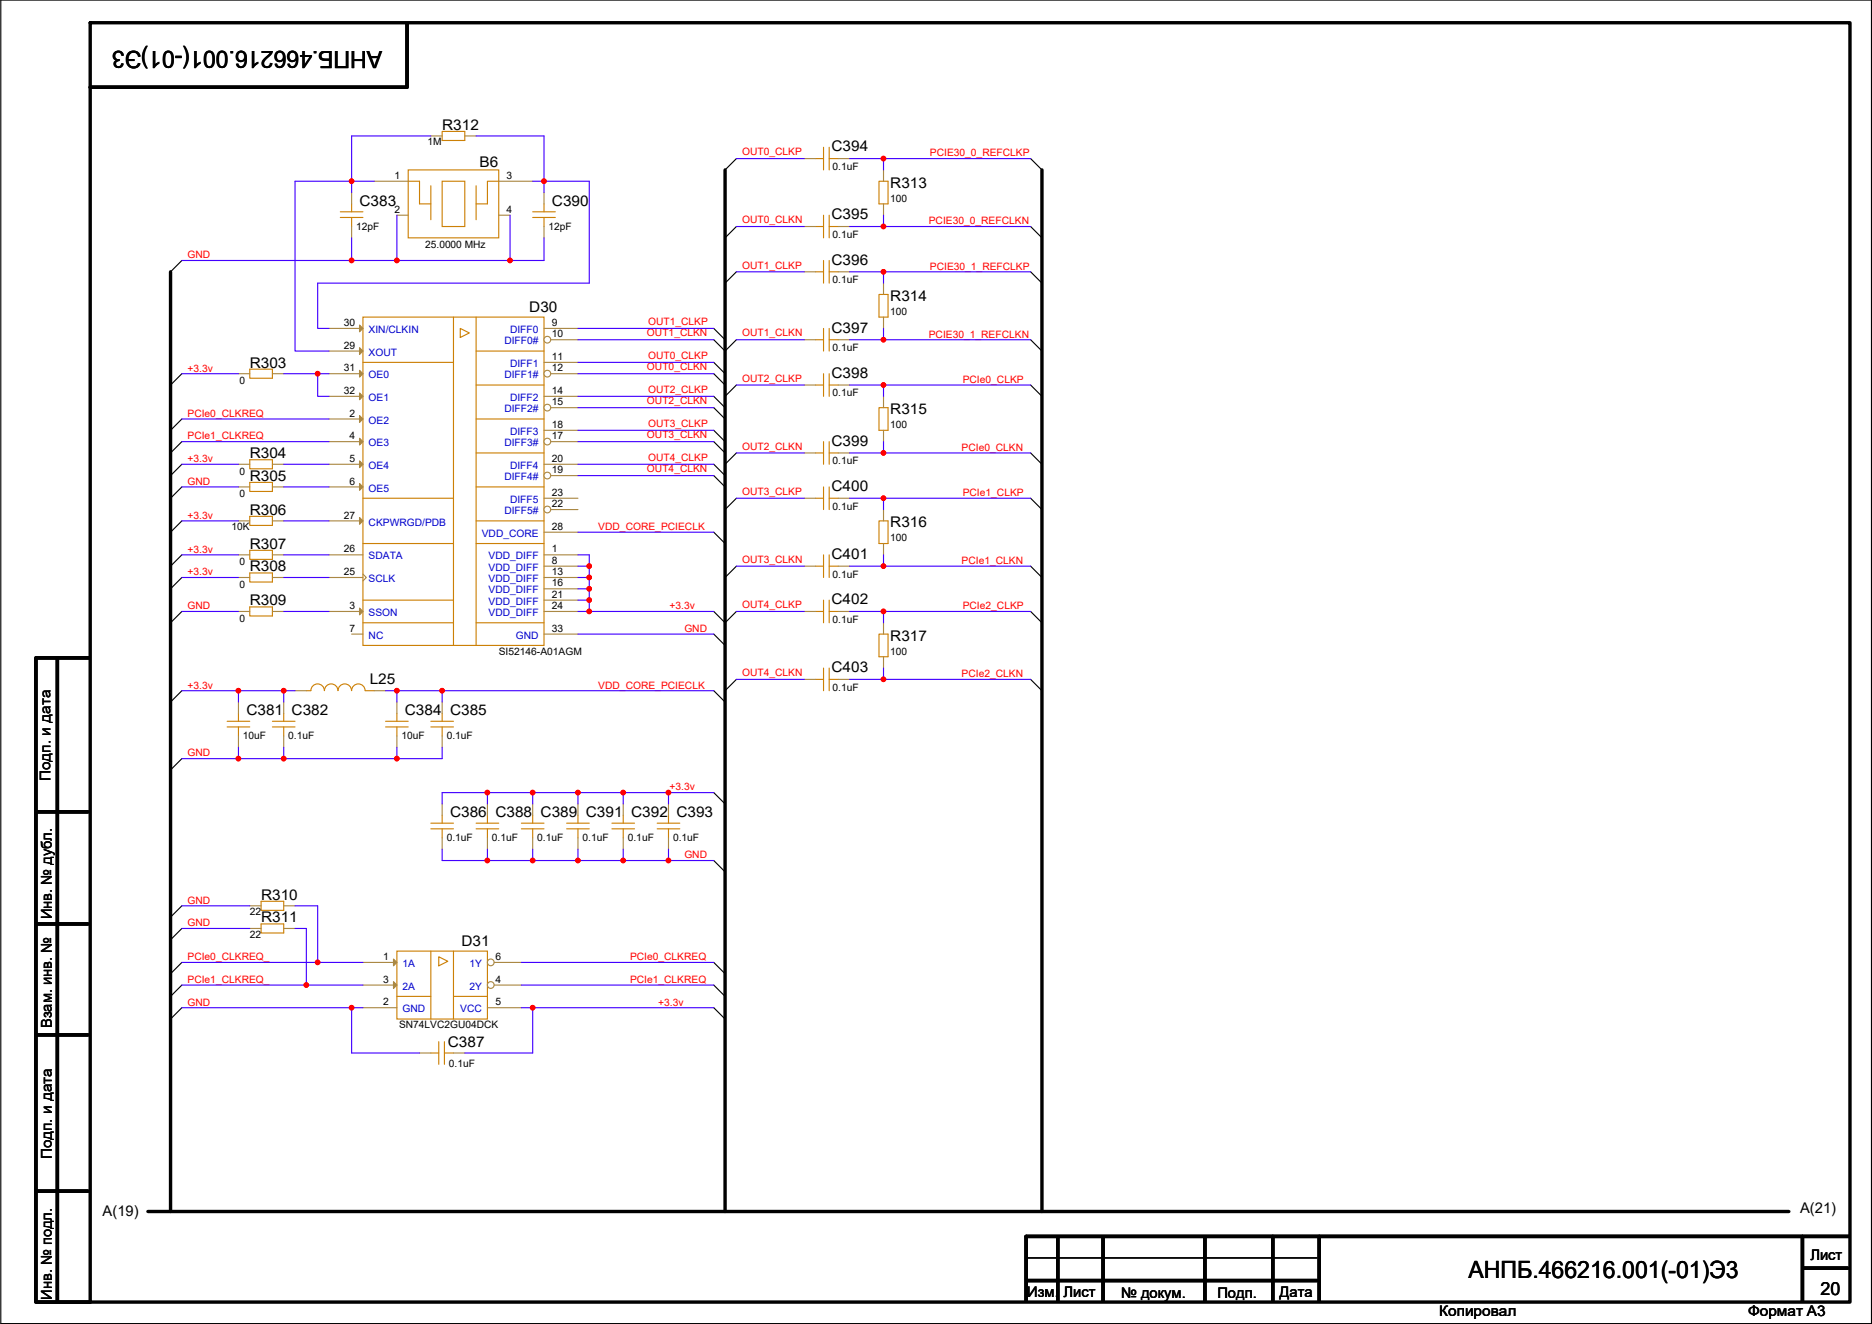
[picture p73: page 20]
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

20 АНПБ.466216.001(-01)Э3 Изм. Лист

№ докум. | Подп. | Дата

C405

## CPU

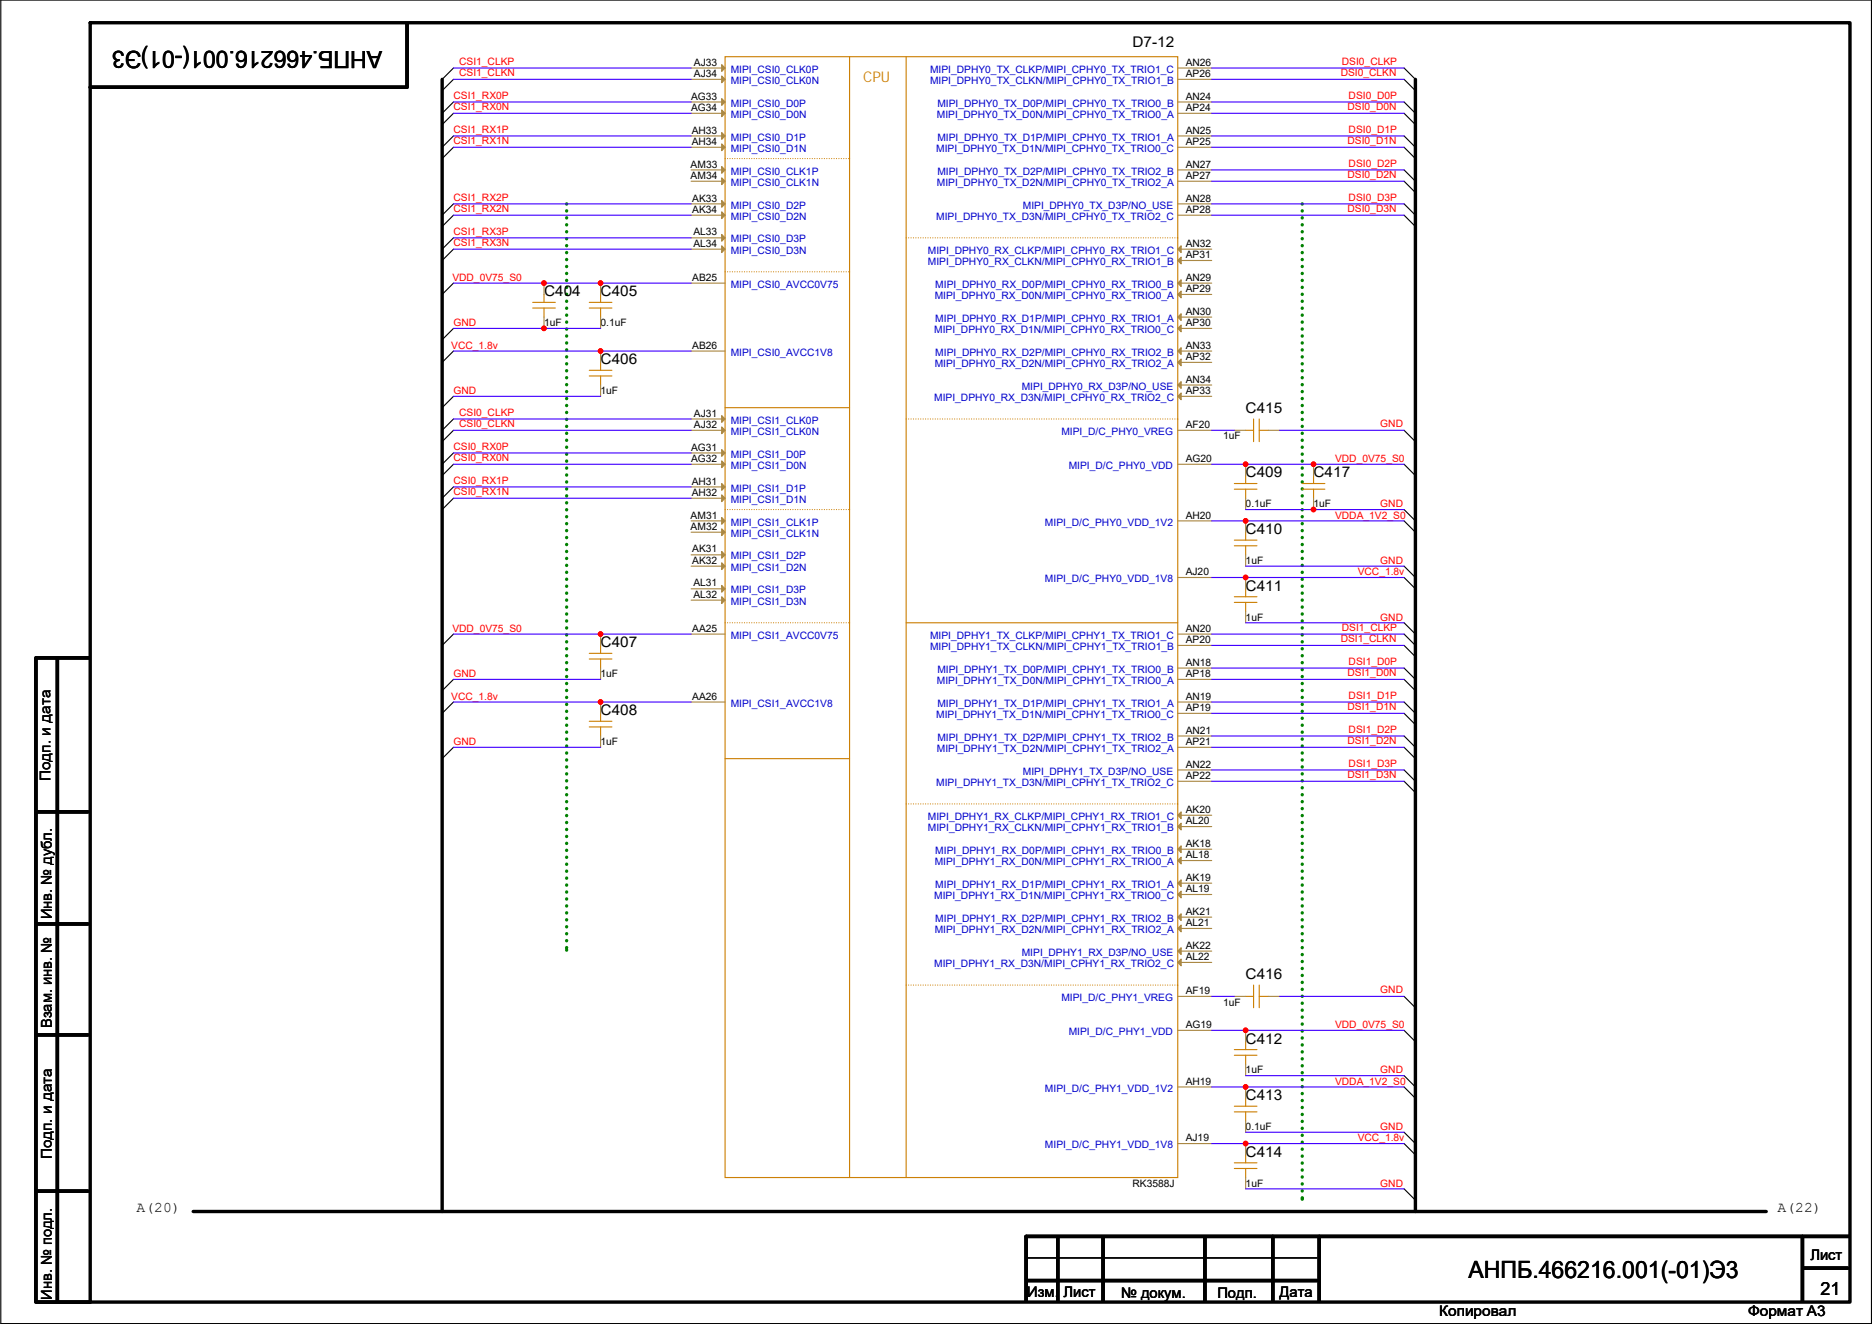
[picture p74: page 21]
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

21 АНПБ.466216.001(-01)Э3 Изм. Лист

№ докум. | Подп. | Дата

1
2

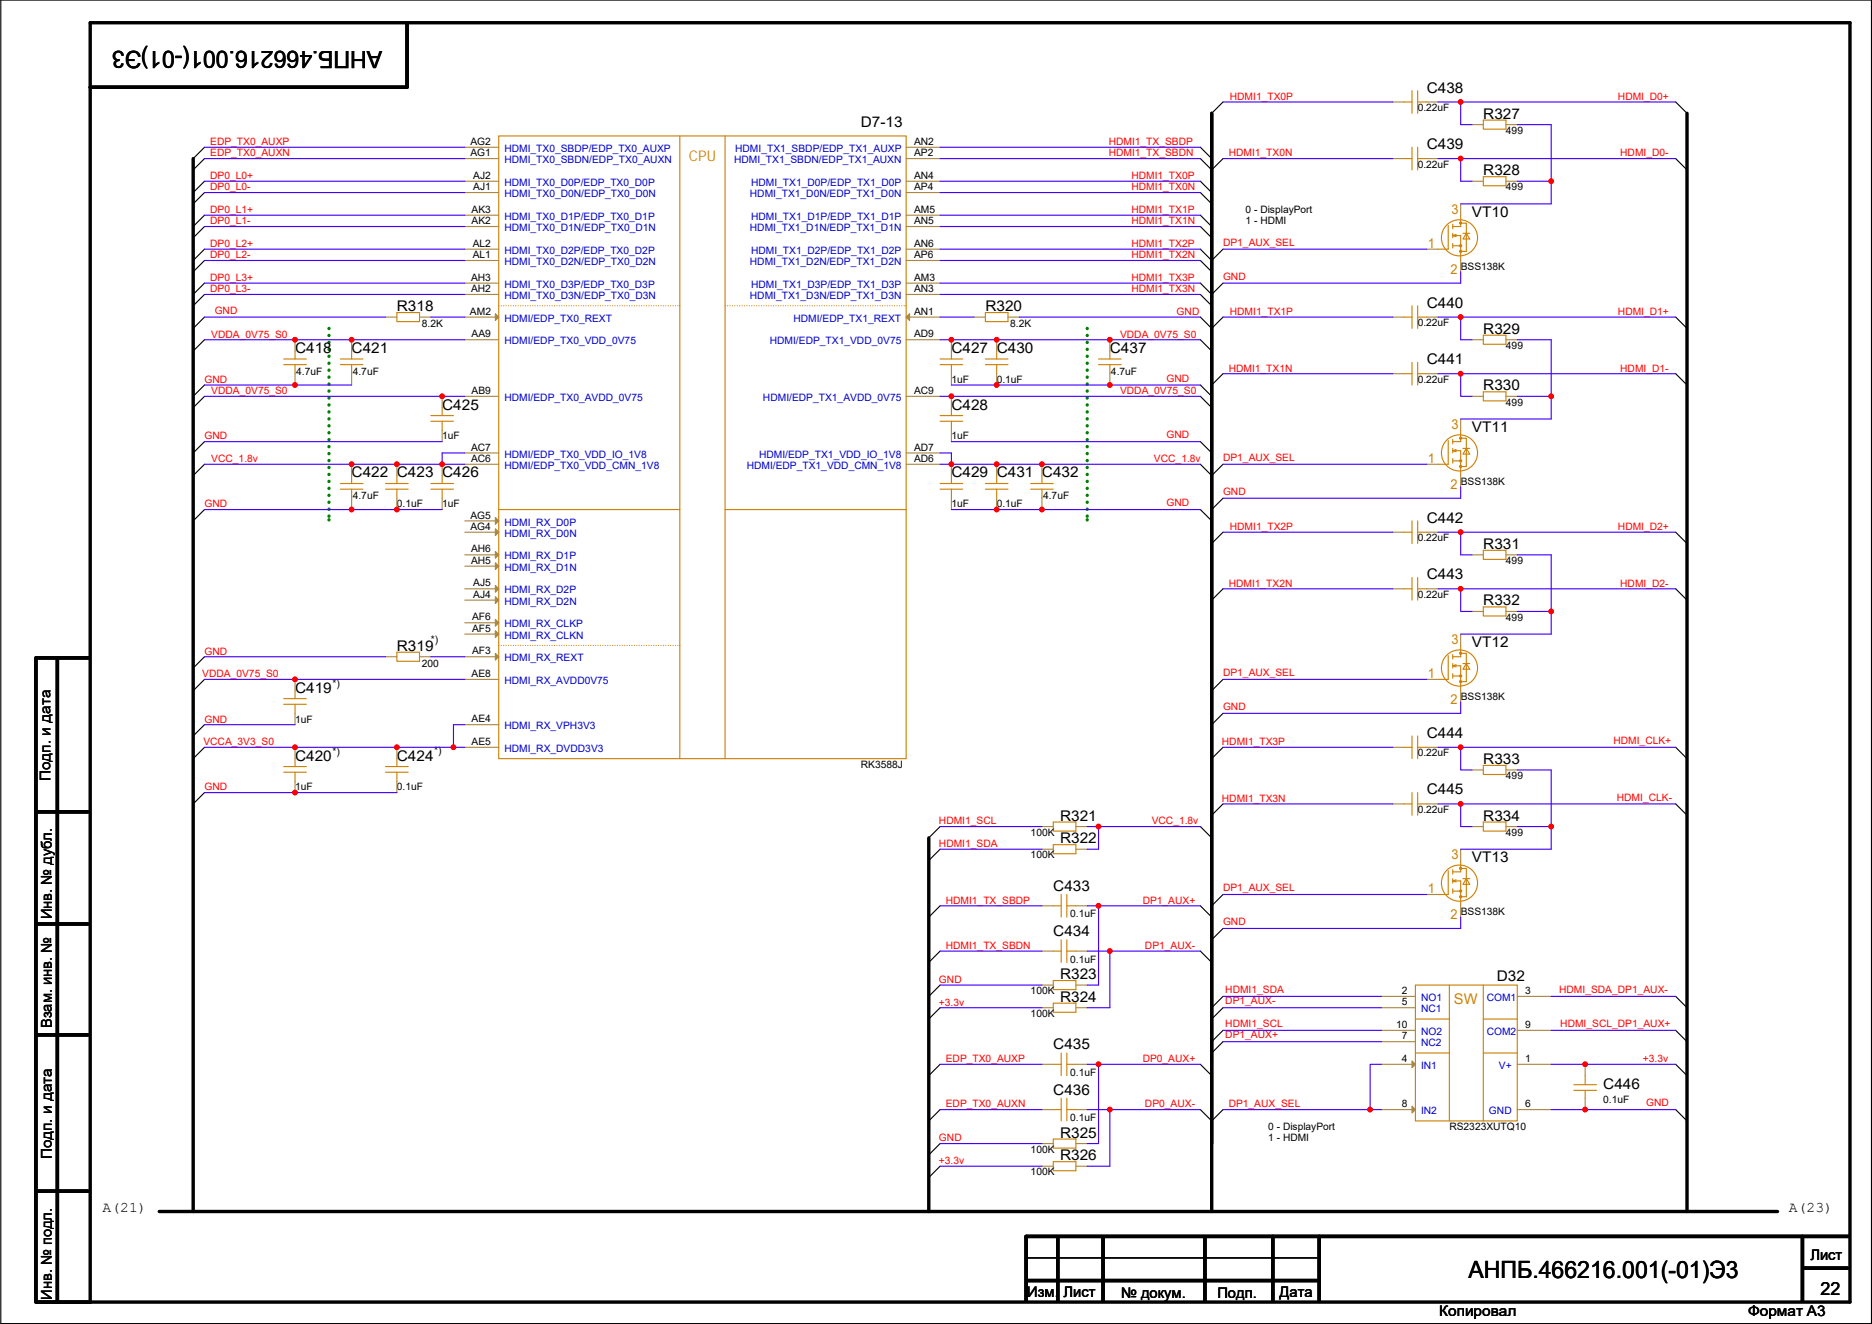
[picture p75: page 22]

Инв. № подл. Инв. № дубл. Подп. и дата Подп. и дата Взам. инв. № R323 100K

22 АНПБ.466216.001(-01)Э3 Изм. Лист
Изм. Лист | № докум. | Подп. | Дата

№ докум. | Подп. | Дата

C447

C451

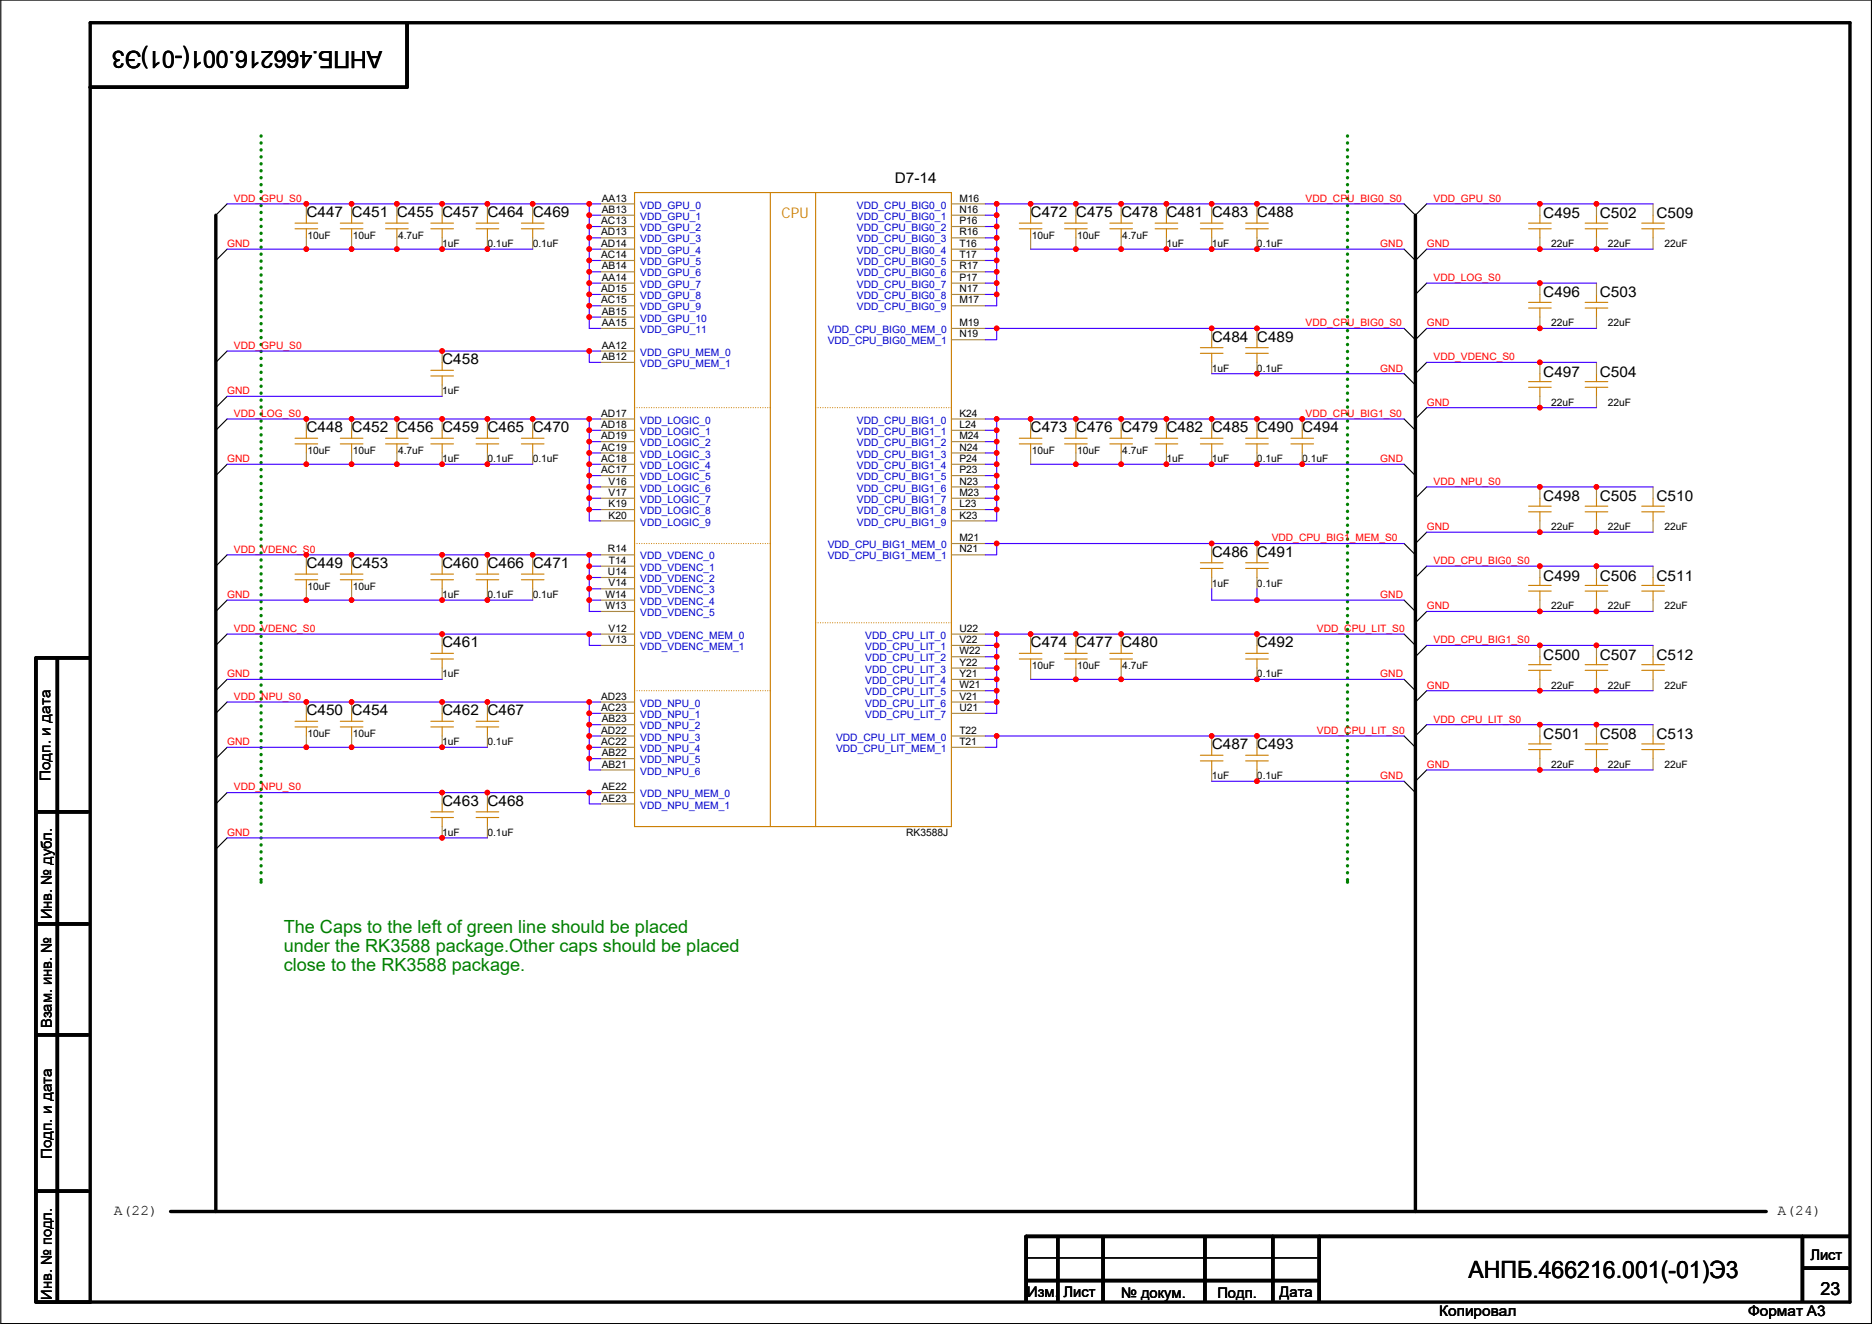
[picture p76: page 23]

Инв. № подл. Инв. № дубл. Подп. и дата Подп. и дата Взам. инв. №

The Caps to the left of green line should be placed
under the RK3588 package.Other caps should be placed
close to the RK3588 package.

23 АНПБ.466216.001(-01)Э3 Изм. Лист
Изм. Лист | № докум. | Подп. | Дата

№ докум. | Подп. | Дата

D7-15

D7-16

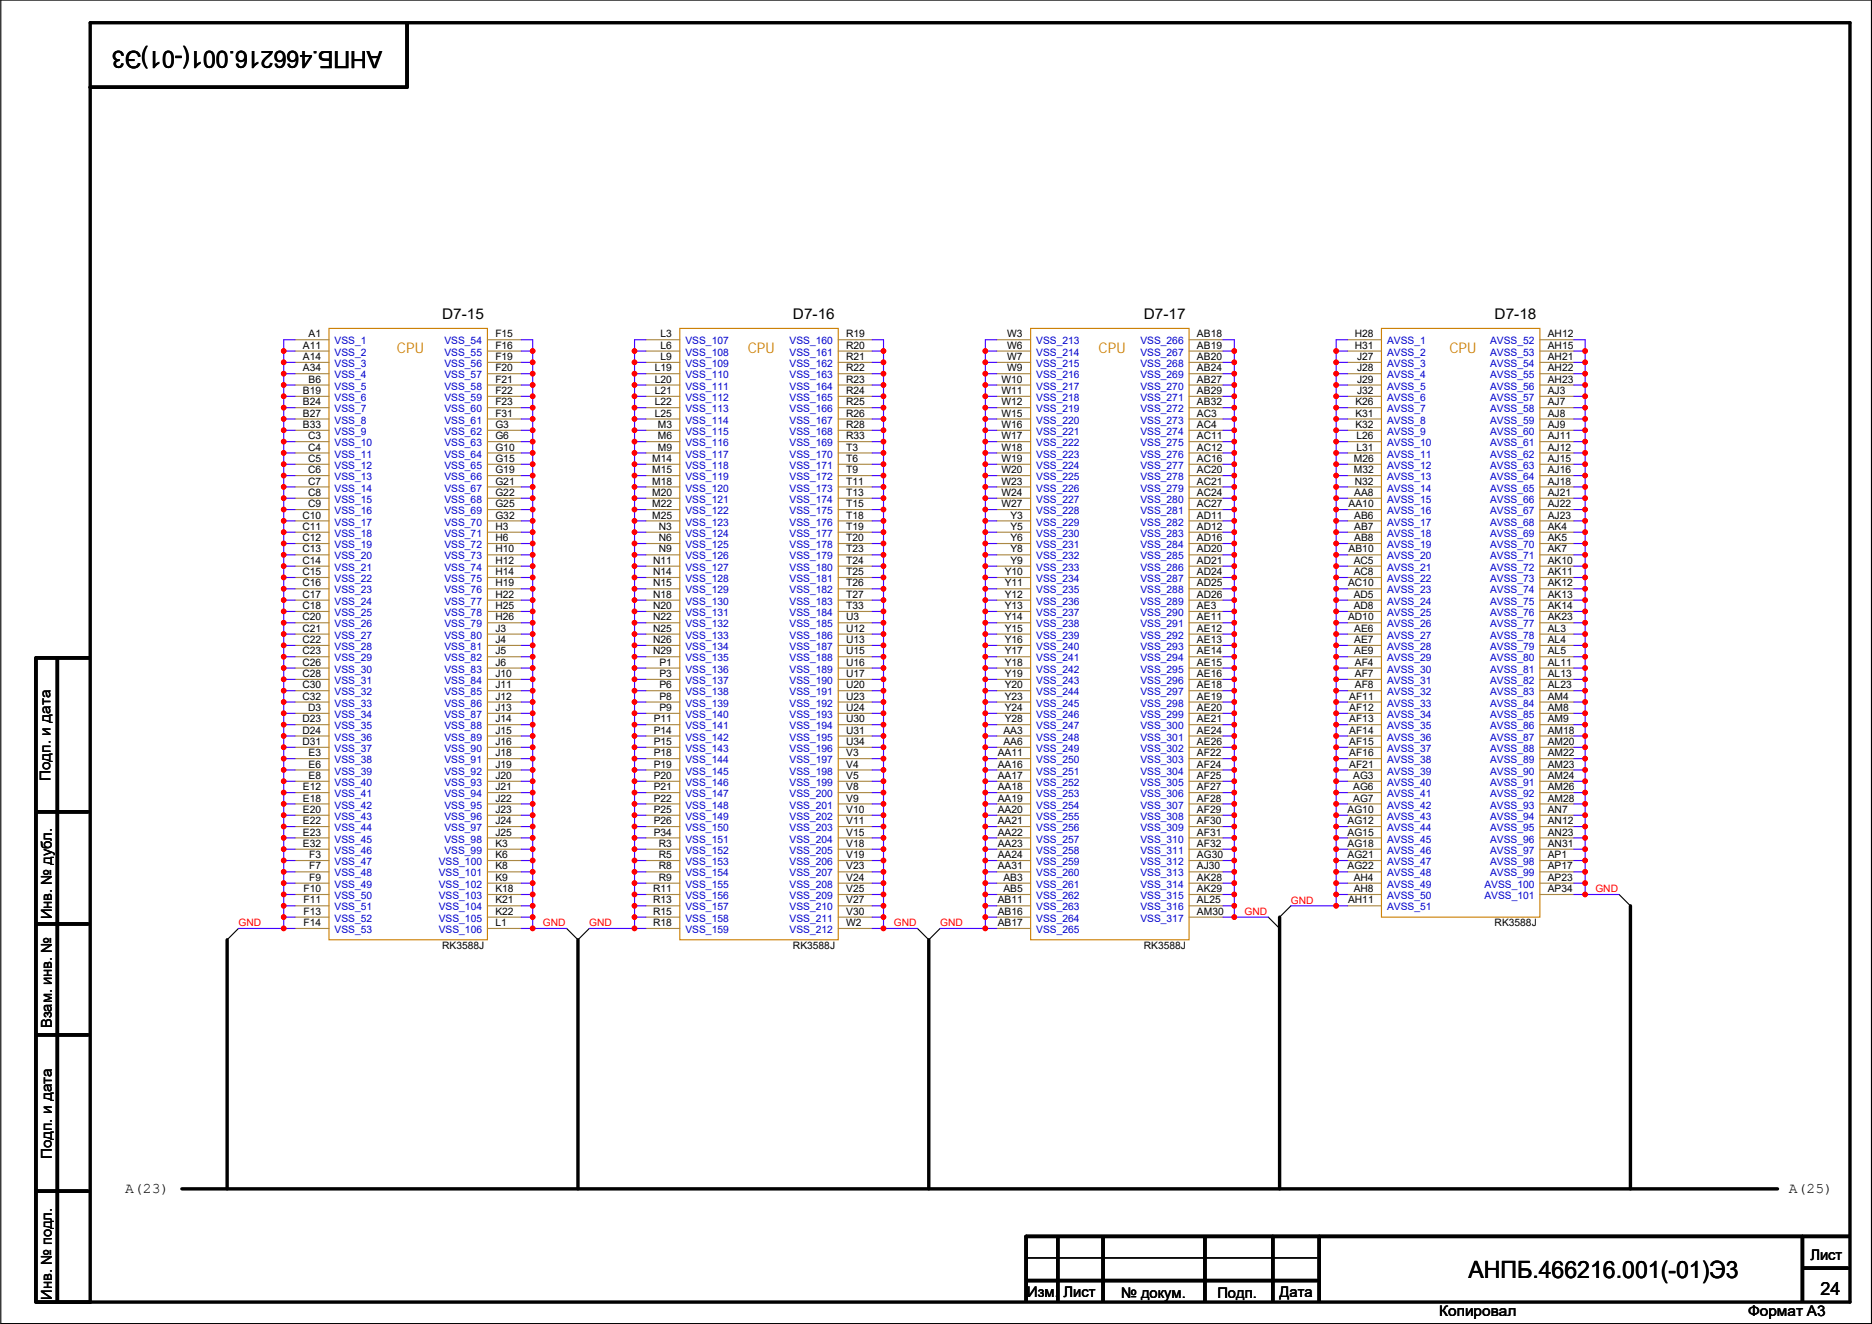
[picture p77: page 24]

Инв. № подл. Инв. № дубл. Подп. и дата Подп. и дата Взам. инв. №

24 АНПБ.466216.001(-01)Э3 Изм. Лист
Изм. Лист | № докум. | Подп. | Дата

№ докум. | Подп. | Дата

## A B C D

0 0 0 1

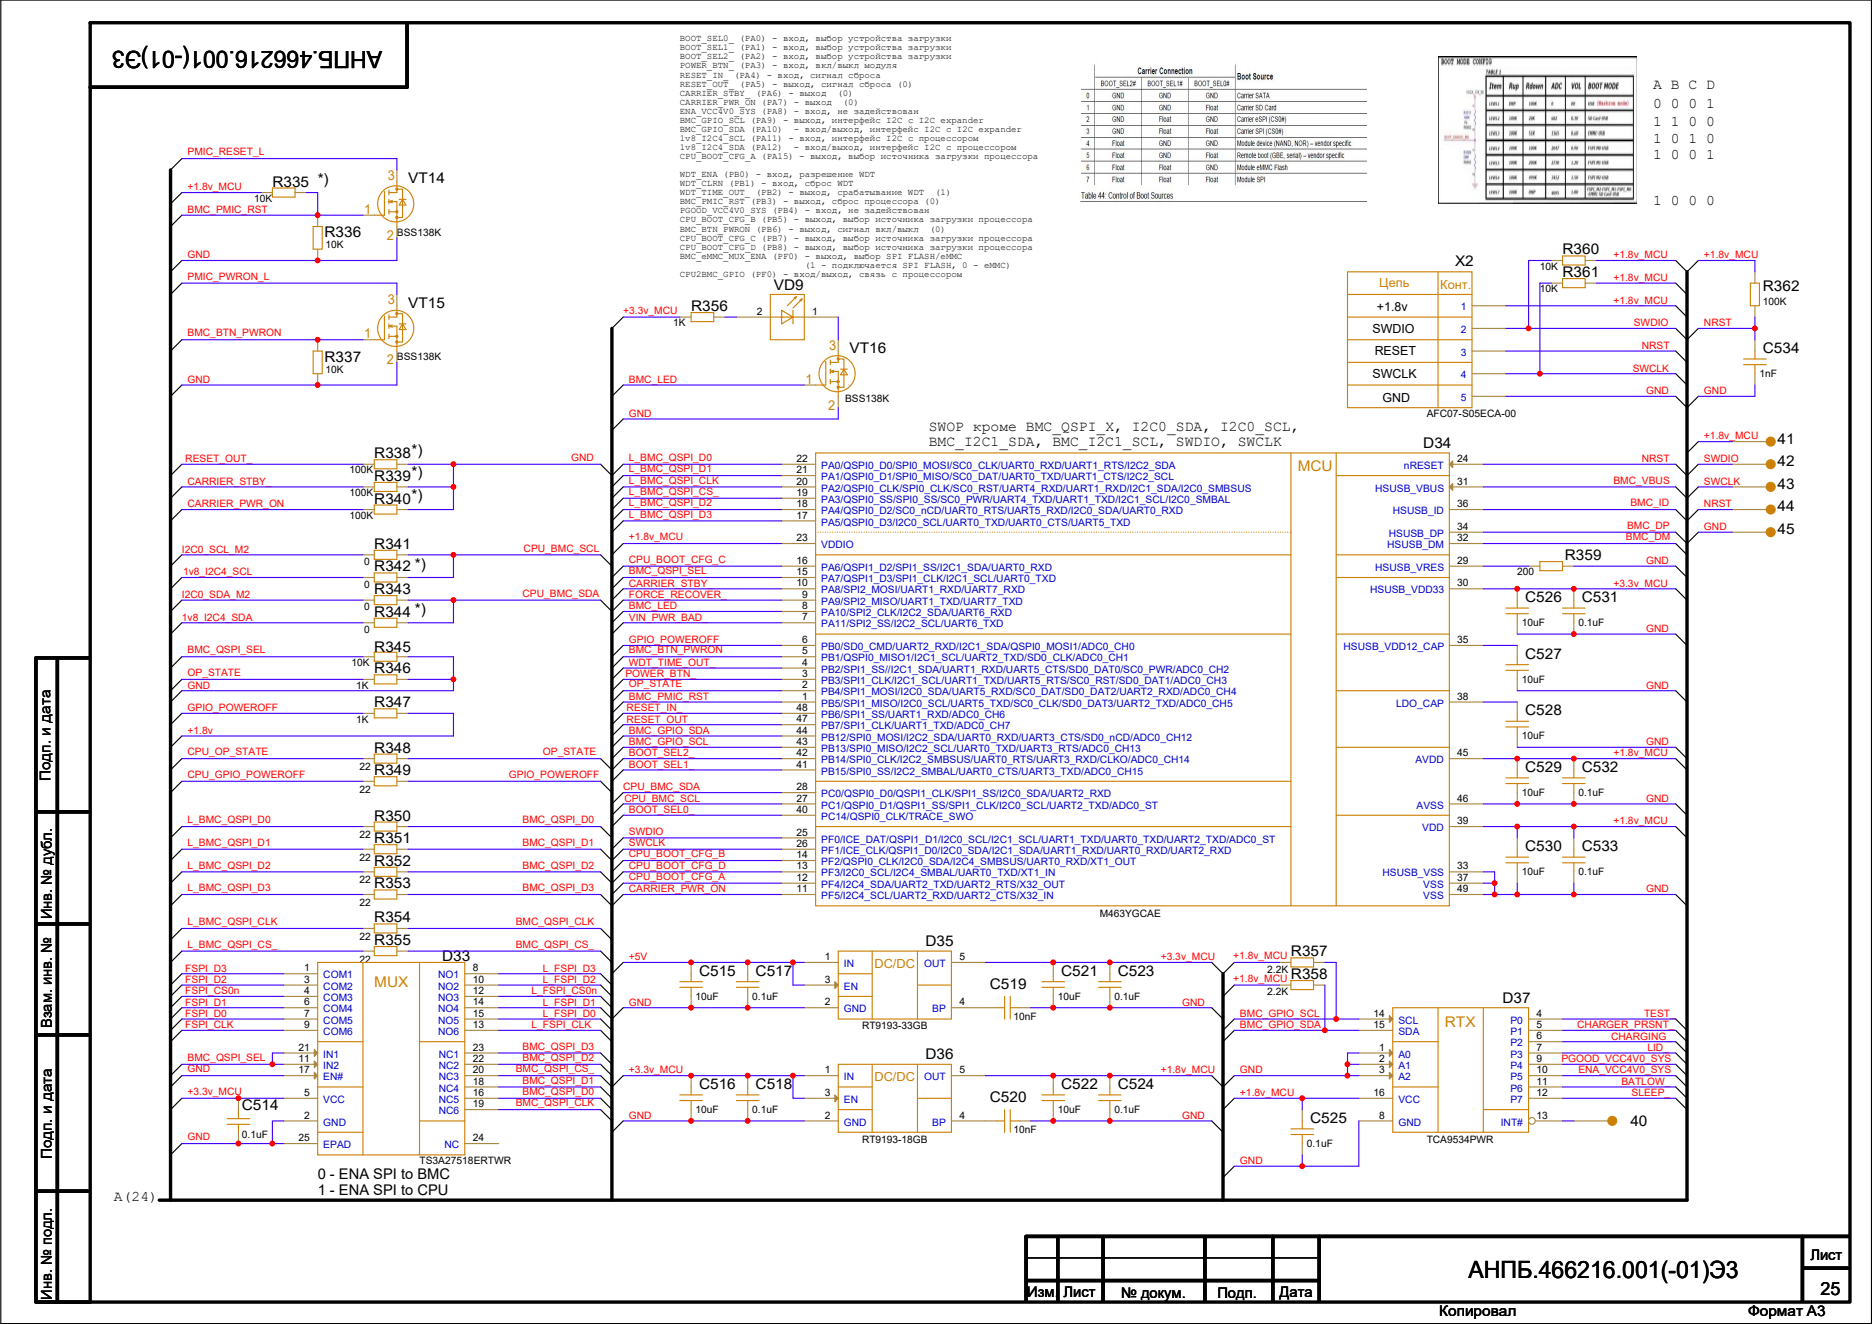
[picture p78: page 25]

BOOT_SEL0_ (PA0) - вход, выбор устройства загрузки
BOOT_SEL1_ (PA1) - вход, выбор устройства загрузки
BOOT_SEL2_ (PA2) - вход, выбор устройства загрузки
POWER_BTN_ (PA3) - вход, вкл/выкл модуля
RESET_IN_ (PA4) - вход, сигнал сброса
RESET_OUT_ (PA5) - выход, сигнал сброса (0)
CARRIER_STBY_ (PA6) - выход (0)
CARRIER_PWR_ON (PA7) - выход (0)
ENA_VCC4V0_SYS (PA8) - вход, не задействован
BMC_GPIO_SCL (PA9) - выход, интерфейс I2C с I2C expander
BMC_GPIO_SDA (PA10) - вход/выход, интерфейс I2C с I2C expander
1v8_I2C4_SCL (PA11) - вход, интерфейс I2C с процессором
1v8_I2C4_SDA (PA12) - вход/выход, интерфейс I2C с процессором
CPU_BOOT_CFG_A (PA15) - выход, выбор источника загрузки процессора
WDT_ENA (PB0) - вход, разрешение WDT
WDT_CLRN (PB1) - вход, сброс WDT
WDT_TIME_OUT_ (PB2) - выход, срабатывание WDT (1)
BMC_PMIC_RST (PB3) - выход, сброс процессора (0)
PGOOD_VCC4V0_SYS (PB4) - вход, не задействован
CPU_BOOT_CFG_B (PB5) - выход, выбор источника загрузки процессора
BMC_BTN_PWRON (PB6) - выход, сигнал вкл/выкл (0)
CPU_BOOT_CFG_C (PB7) - выход, выбор источника загрузки процессора
CPU_BOOT_CFG_D (PB8) - выход, выбор источника загрузки процессора
BMC_eMMC_MUX_ENA (PF0) - выход, выбор SPI FLASH/eMMC
CPU2BMC_GPIO (PF0) - вход/выход, связь с процессором

(1 - подключается SPI FLASH, 0 - eMMC)

Цепь | Конт.
+1.8v | 1
SWDIO | 2

SWCLK | 4
GND | 5

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

COM1 1 COM2 3 COM3 4 COM4 6 COM5 7 COM6 9 | MUX

SCL 14 SDA 15 | RTX

0 - ENA SPI to BMC
1 - ENA SPI to CPU

25 АНПБ.466216.001(-01)Э3 Изм. Лист

№ докум. | Подп. | Дата
