Rustik2044/MU-RK3576J-MB/Project/refdoc/Radxa_ROCK_4D_SCH_V1.11.pdf

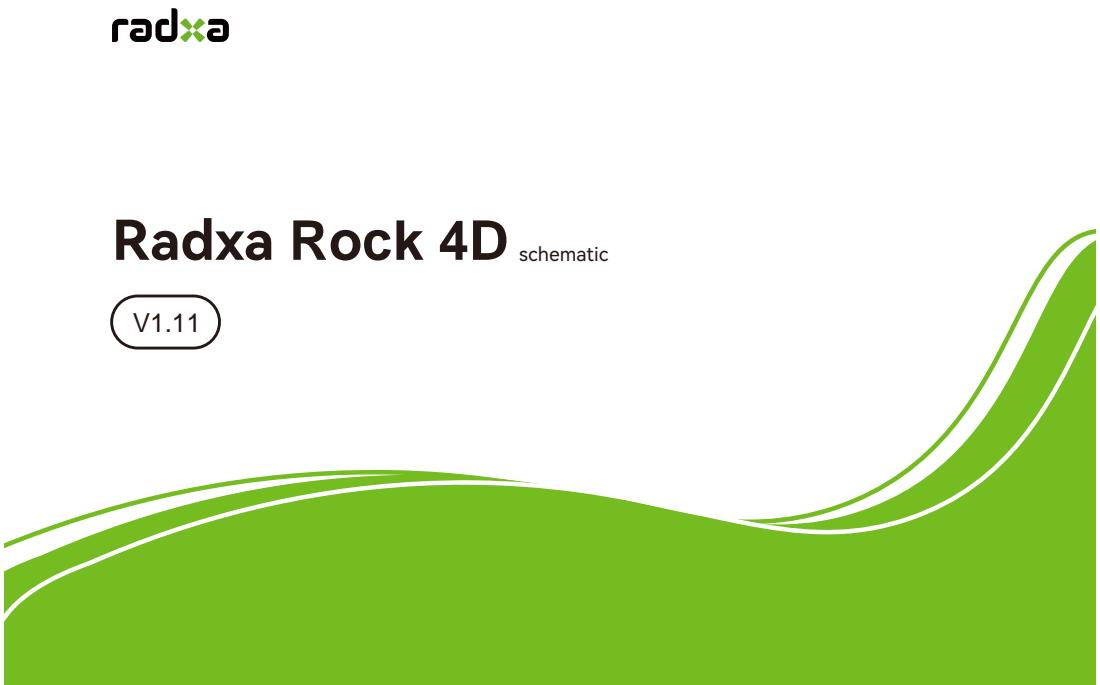
[picture p79: page 1]

Radxa Rock 4D schematic

# 01.cover 02.Index and Notes

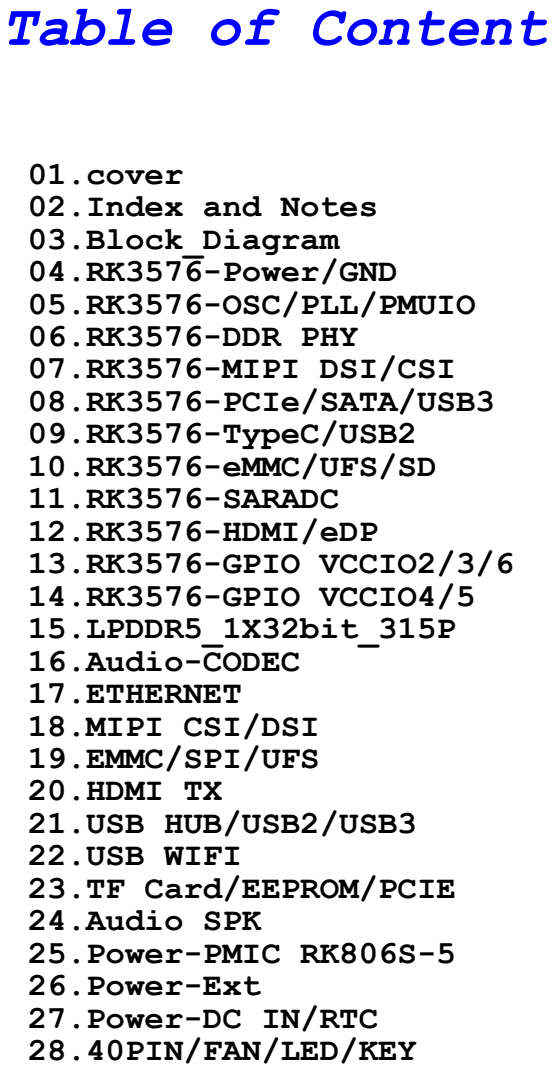
[picture p80: page 2]
Size; REV; Date:; Sheet; Title:; Page Name:; Index and Notes; ROCK 4D; Thursday, May 15, 2025

Table of Content

03.Block_Diagram
04.RK3576-Power/GND
05.RK3576-OSC/PLL/PMUIO
06.RK3576-DDR PHY
07.RK3576-MIPI DSI/CSI
08.RK3576-PCIe/SATA/USB3
09.RK3576-TypeC/USB2
10.RK3576-eMMC/UFS/SD
11.RK3576-SARADC
12.RK3576-HDMI/eDP
13.RK3576-GPIO VCCIO2/3/6
14.RK3576-GPIO VCCIO4/5
15.LPDDR5_1X32bit_315P
16.Audio-CODEC
17.ETHERNET
18.MIPI CSI/DSI
19.EMMC/SPI/UFS
20.HDMI TX
21.USB HUB/USB2/USB3
22.USB WIFI
23.TF Card/EEPROM/PCIE
24.Audio SPK
25.Power-PMIC RK806S-5
26.Power-Ext
27.Power-DC IN/RTC
28.40PIN/FAN/LED/KEY

## PHY RTL8211F-CG

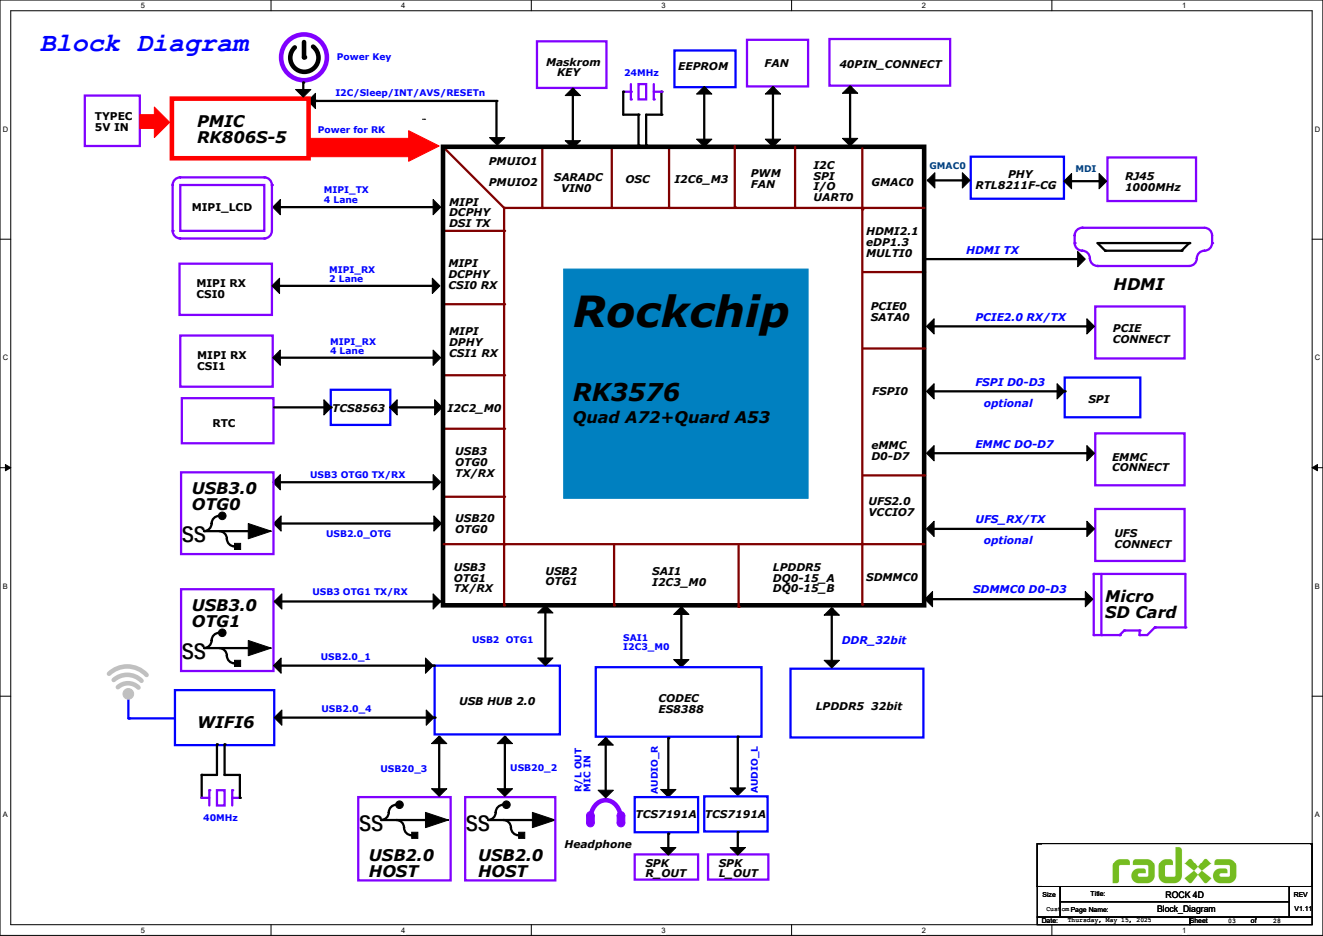
[picture p81: page 3]
USB HUB 2.0; USB2.0 HOST; MIPI RX CSI1; USB2.0_OTG; RJ45 1000MHz; 40PIN_CONNECT; I2C SPI I/O UART0; MIPI_RX 4 Lane; GMAC0; TYPEC 5V IN; USB3 OTG0 TX/RX; USB2.0_4; USB2 OTG1; DDR_32bit; MIPI DCPHY CSI0 RX; PMIC RK806S-5; PCIE0 SATA0; MIPI DCPHY DSI TX; MIPI DPHY CSI1 RX; HDMI2.1 eDP1.3 MULTI0; eMMC D0-D7; Rockchip; Quad A72+Quard A53; OSC; SAI1 I2C3_M0; 24MHz; USB20 OTG0; LPDDR5 DQ0-15_A DQ0-15_B; UFS CONNECT; Micro SD Card; PMUIO1; PMUIO2; SDMMC0 USB2 OTG1; LPDDR5 32bit; MIPI_TX 4 Lane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

I2C/Sleep/INT/AVS/RESETn

Power for RK

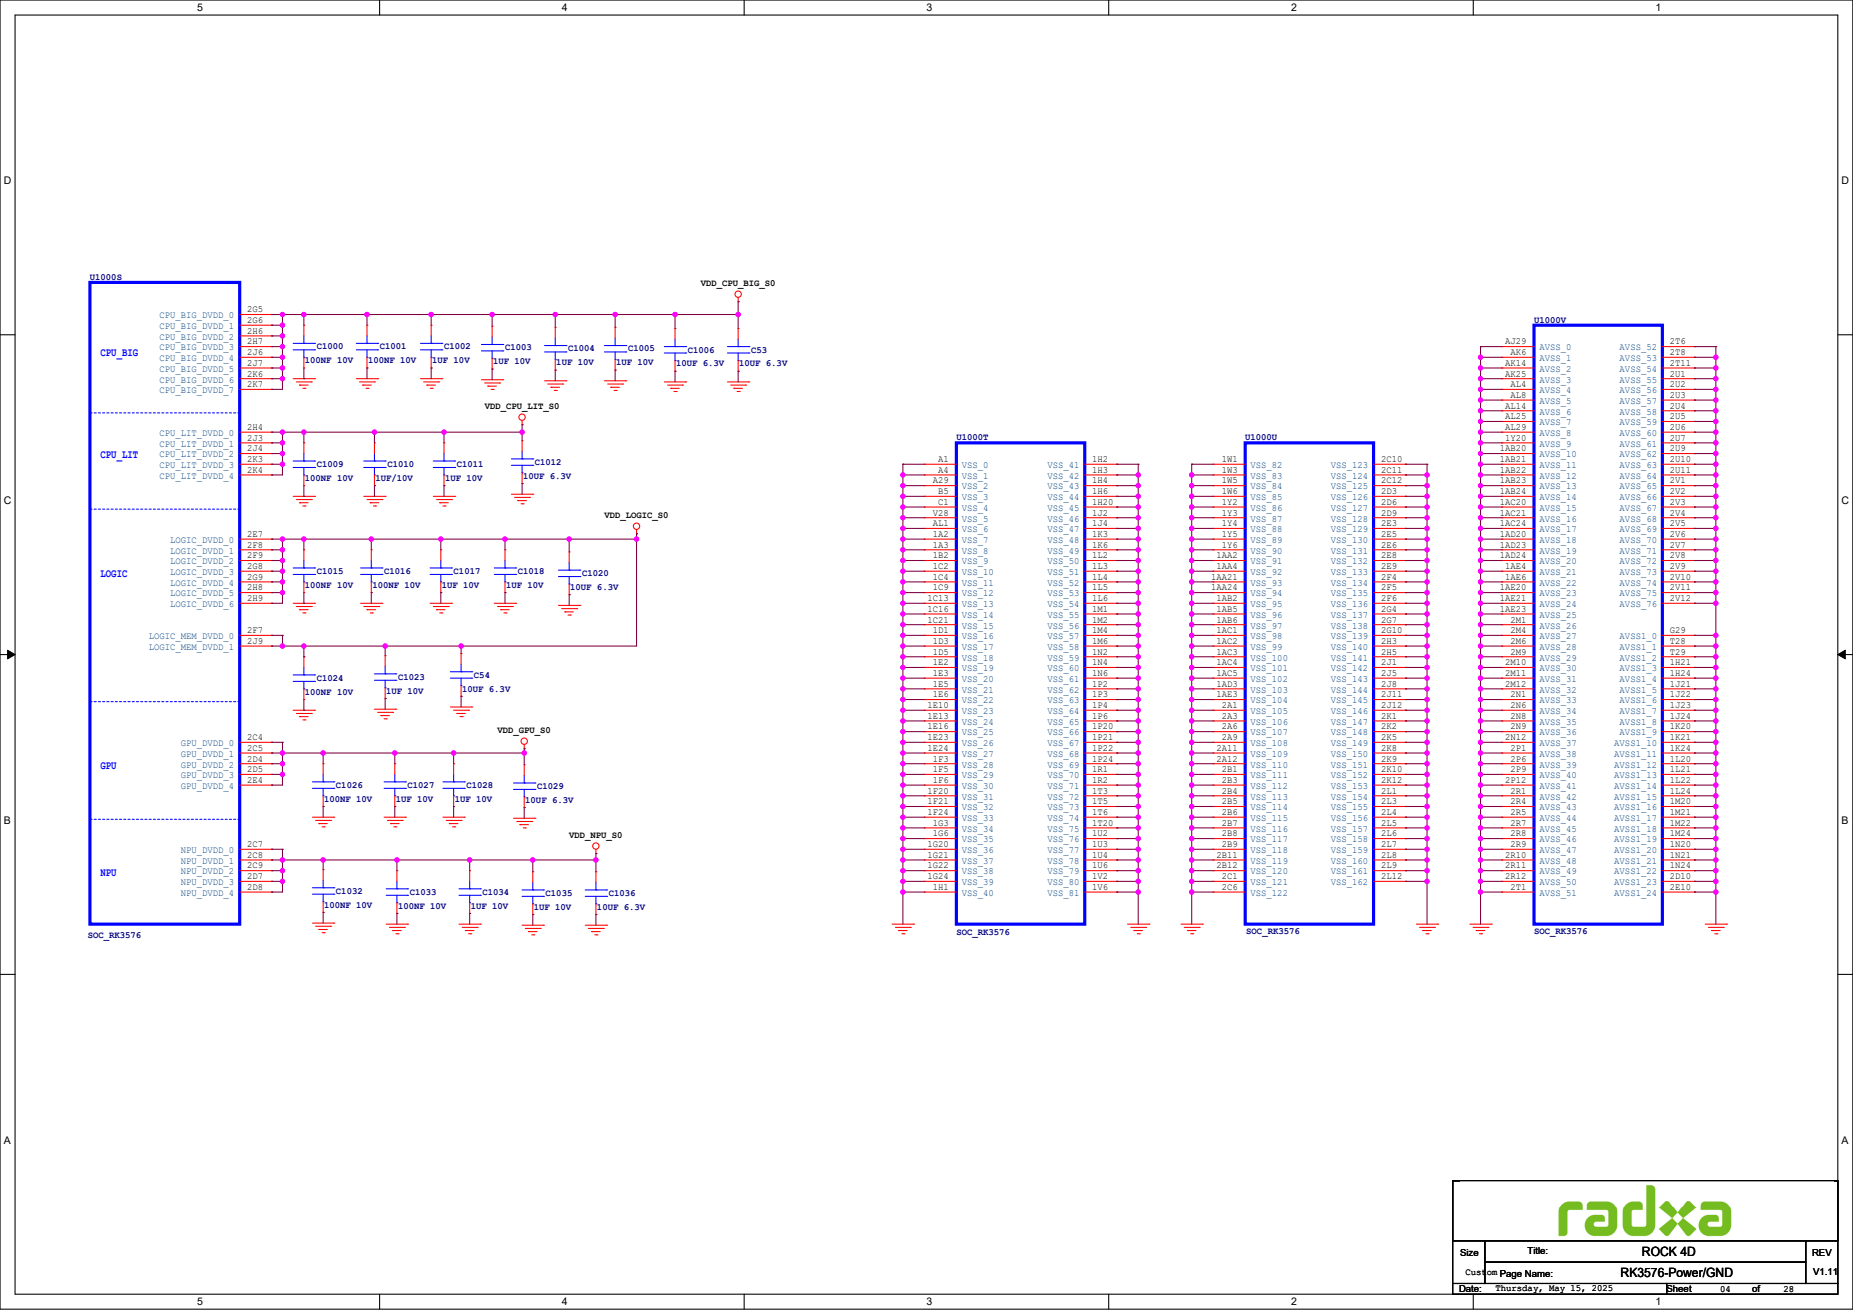
[picture p82: page 4]

OSC | PMUIO0 Domain

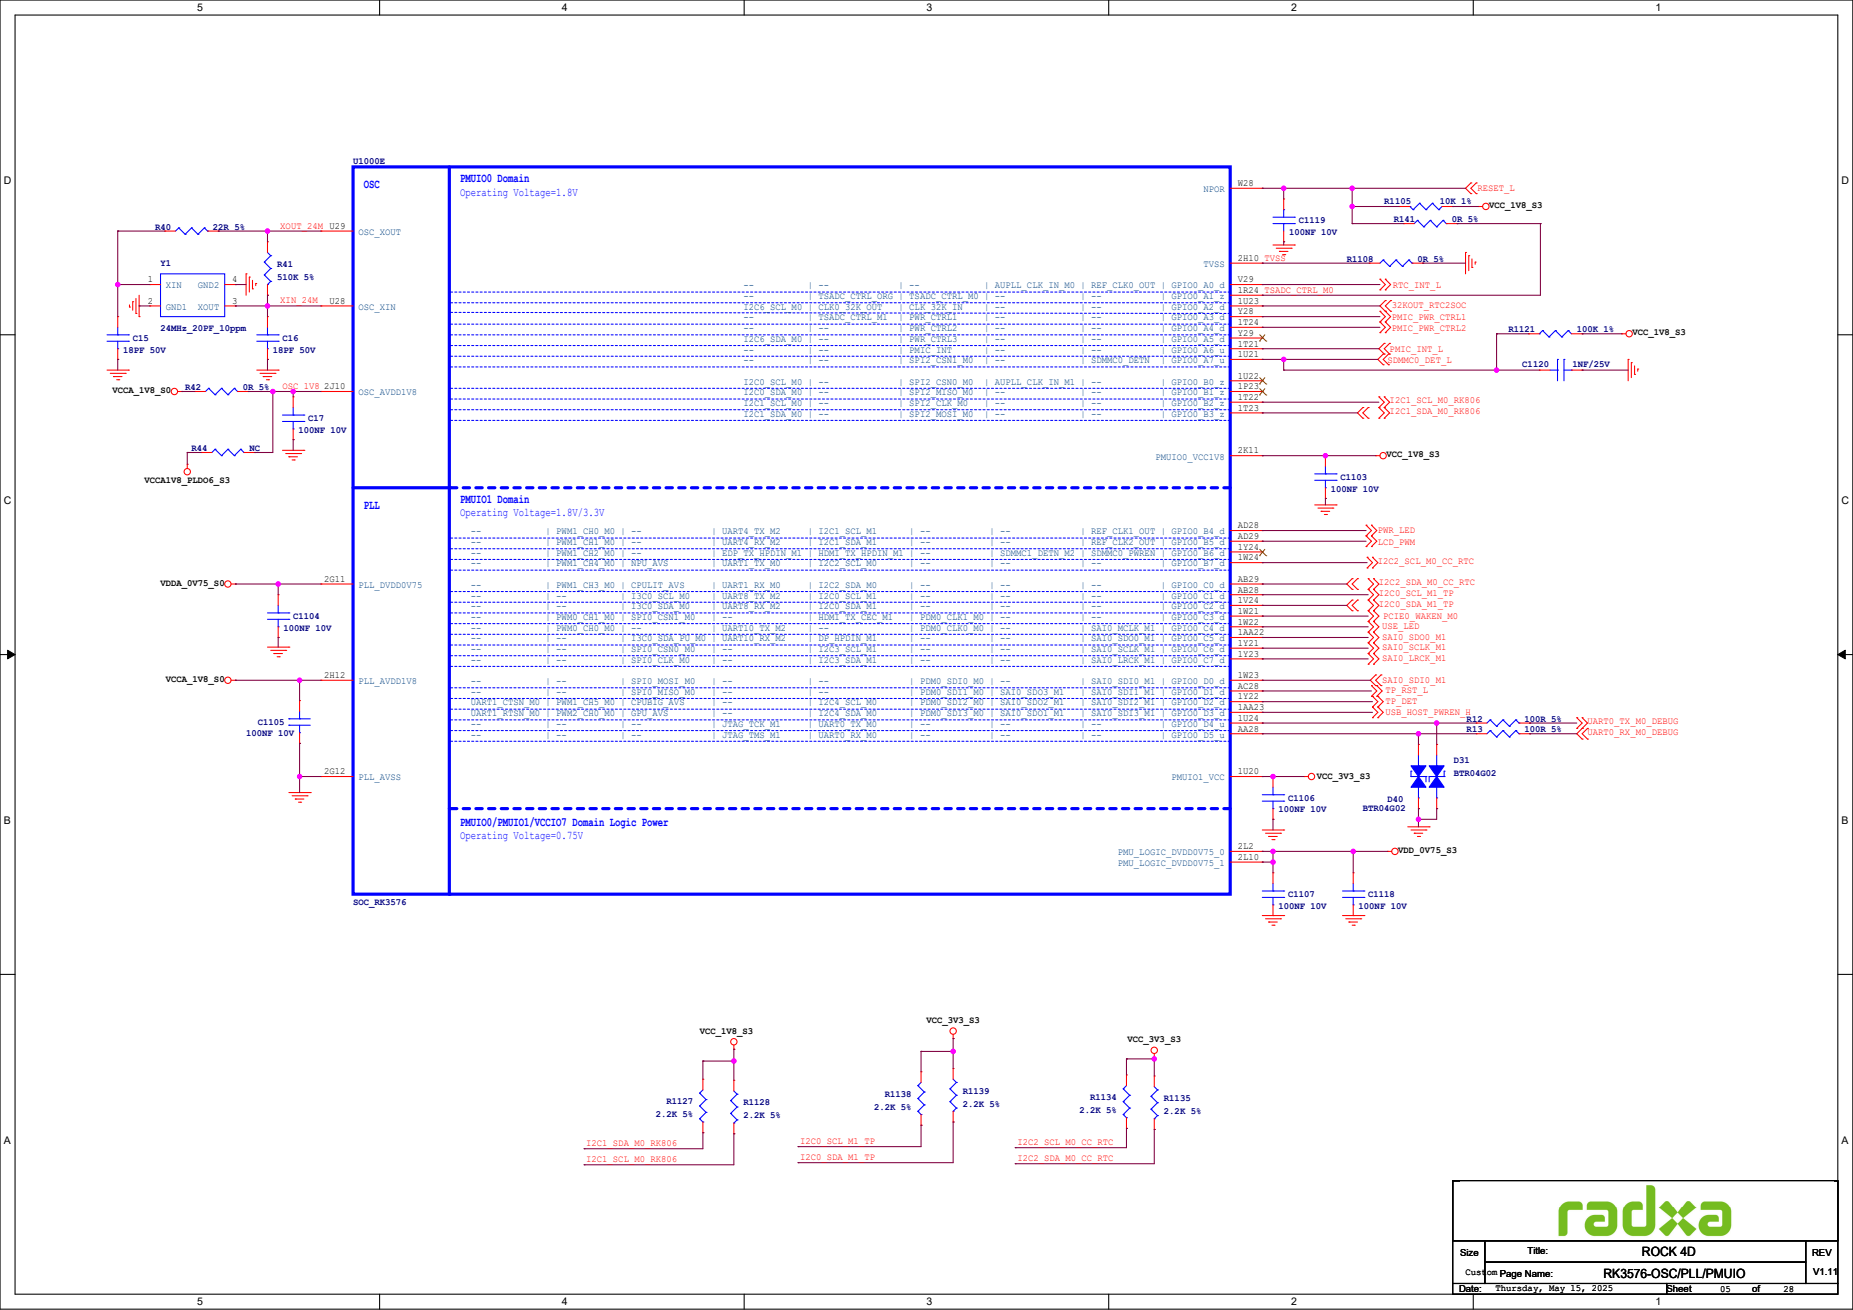
[picture p83: page 5]

LPDDR4 | LPDDR4X | LPDDR5
LPDDR4 | LPDDR4X | LPDDR5

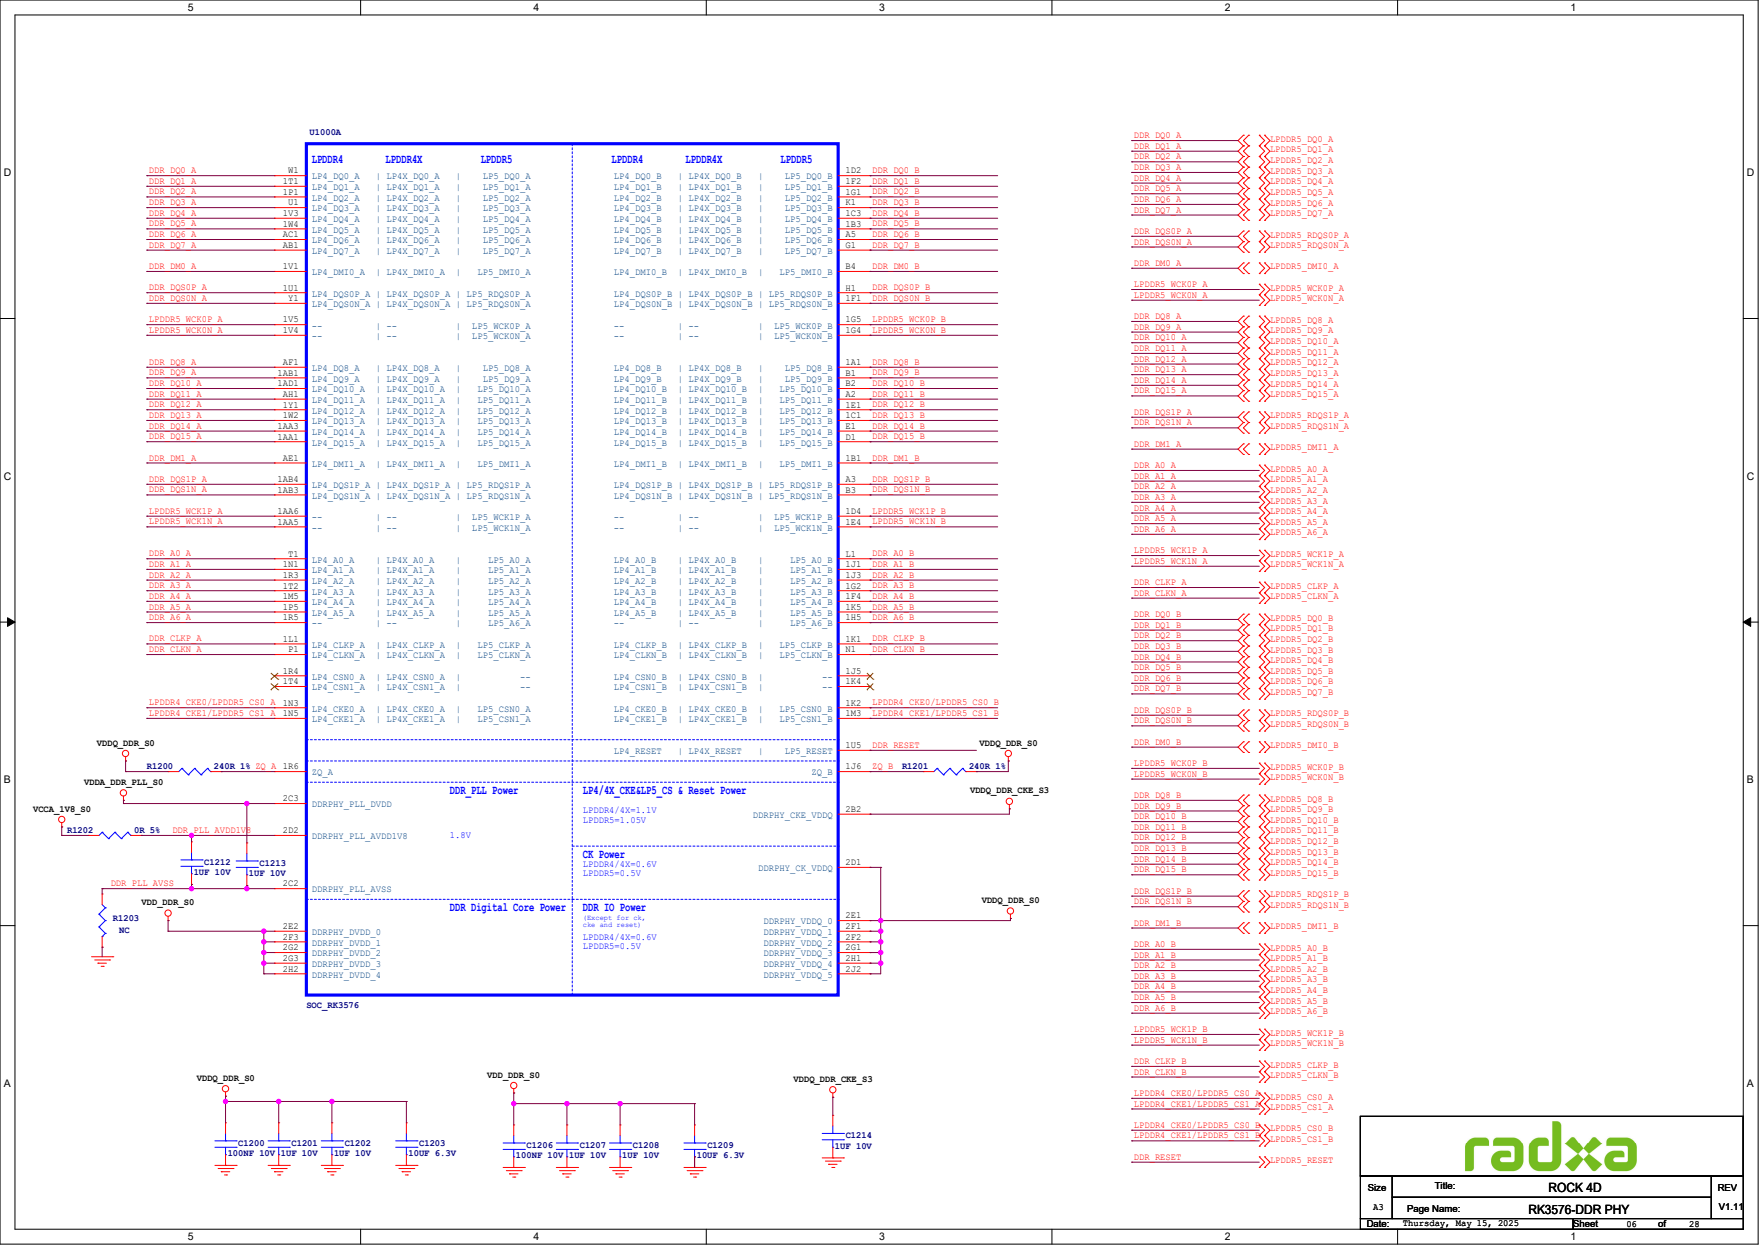
[picture p84: page 6]

## MIPI_DPHY_DSI_TX_CLKP

## MIPI_DPHY_DSI_TX_CLKN

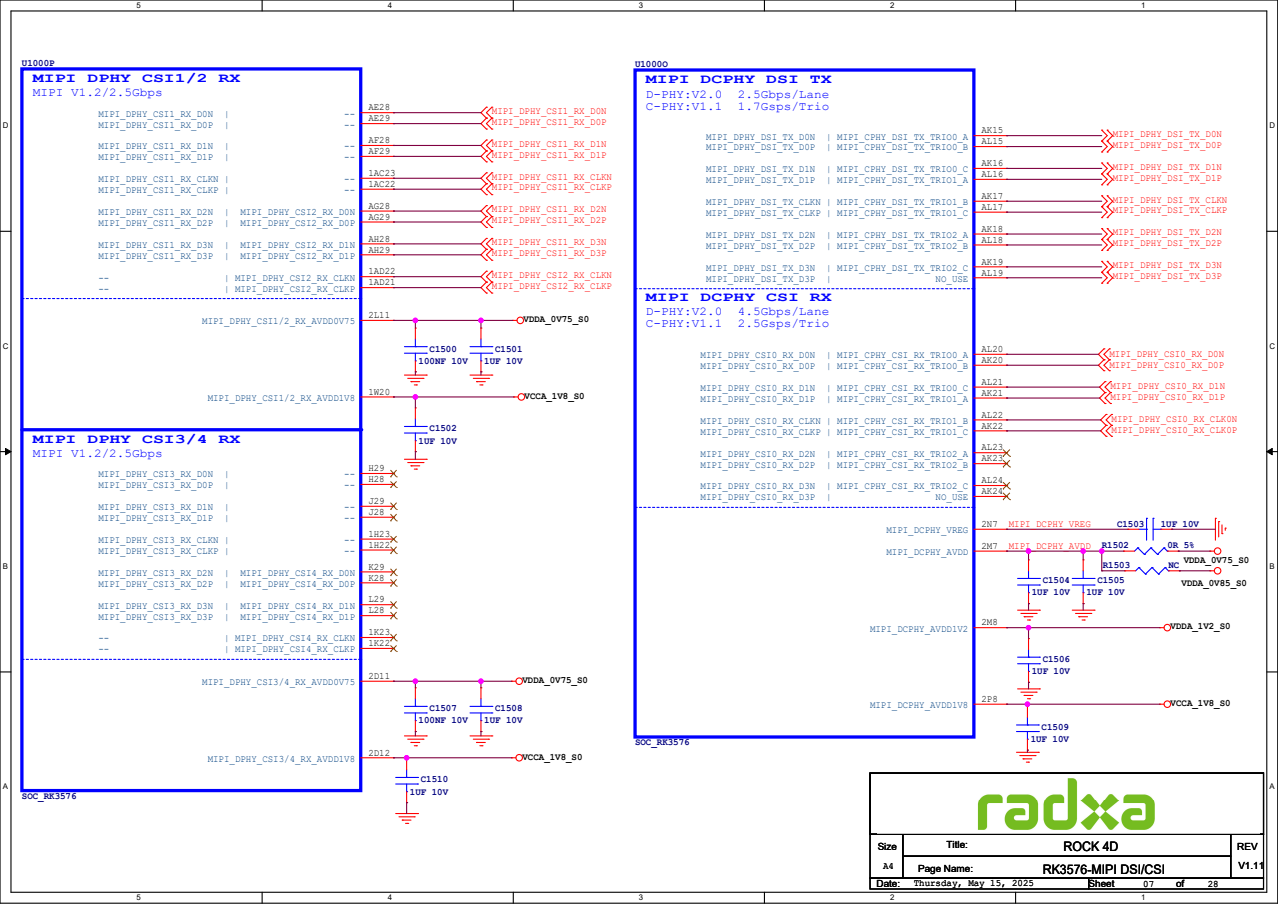
[picture p85: page 7]

MIPI DCPHY DSI TX
D-PHY:V2.0 2.5Gbps/Lane
C-PHY:V1.1 1.7Gsps/Trio

MIPI DCPHY CSI RX
D-PHY:V2.0 4.5Gbps/Lane
C-PHY:V1.1 2.5Gsps/Trio

## PCIE0_SOC_REFCLKP PCIE0_SOC_REFCLKN

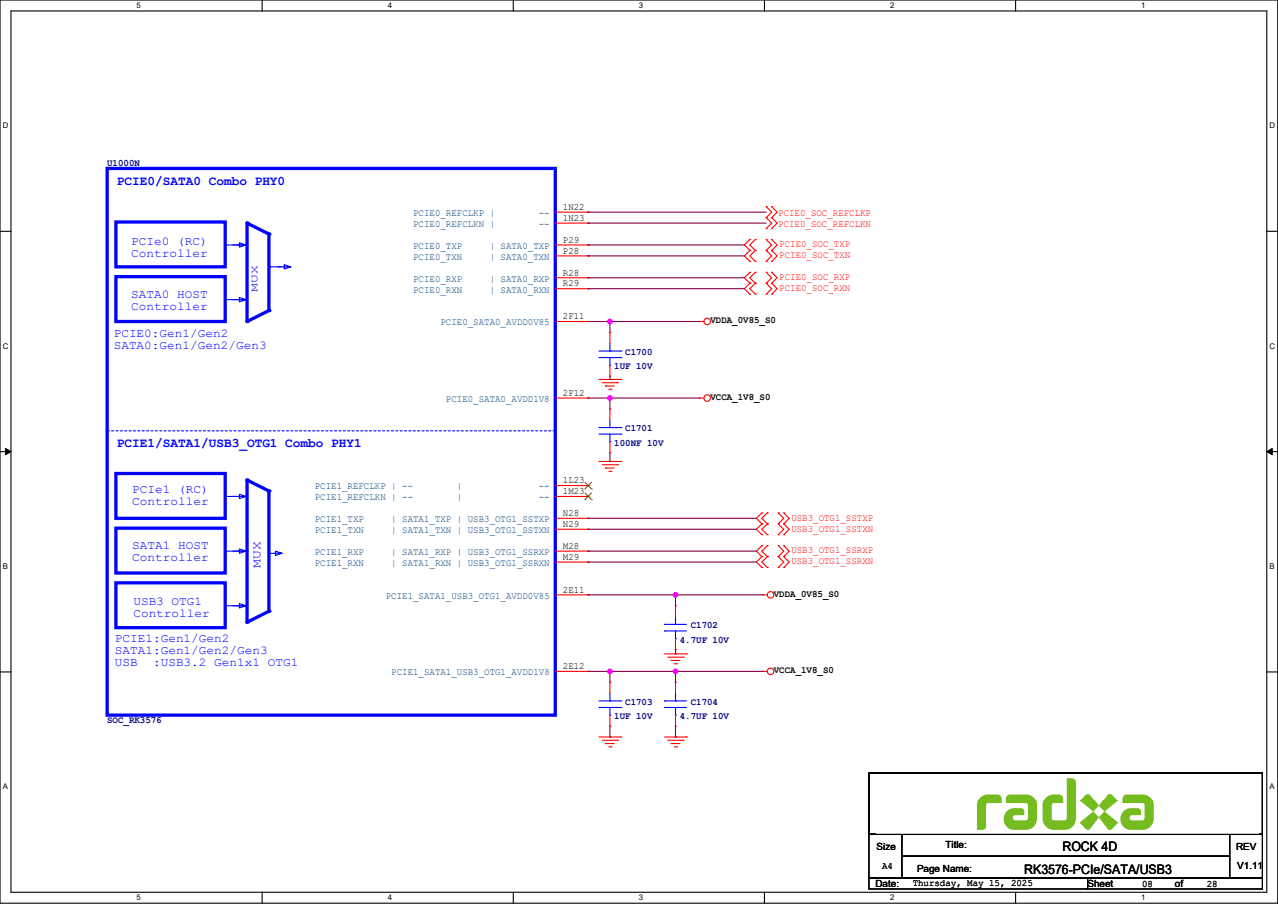
[picture p86: page 8]

## USB3_OTG0_SSTXP USB3_OTG0_SSTXN

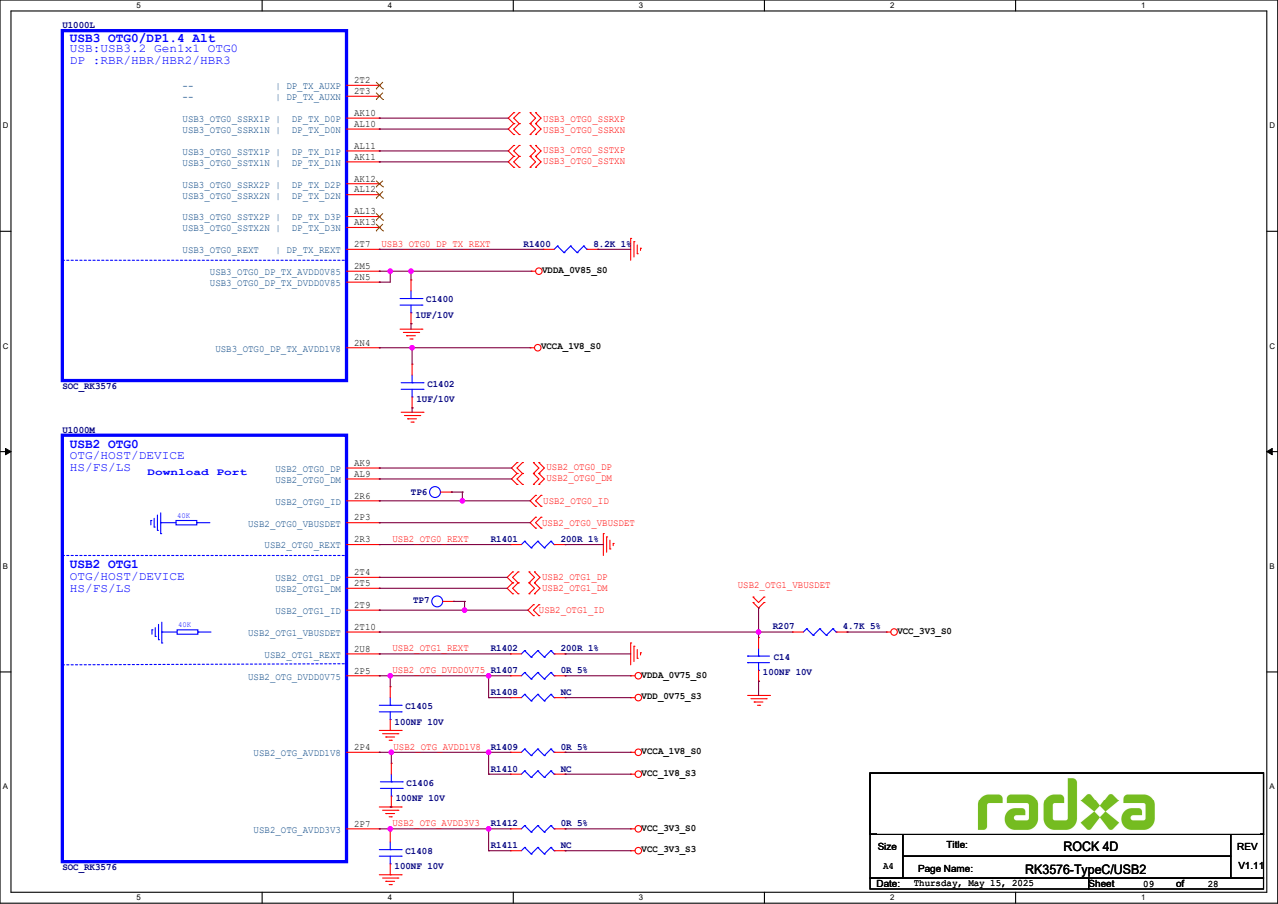
[picture p87: page 9]

## UFS2.0

## OSC for UFS

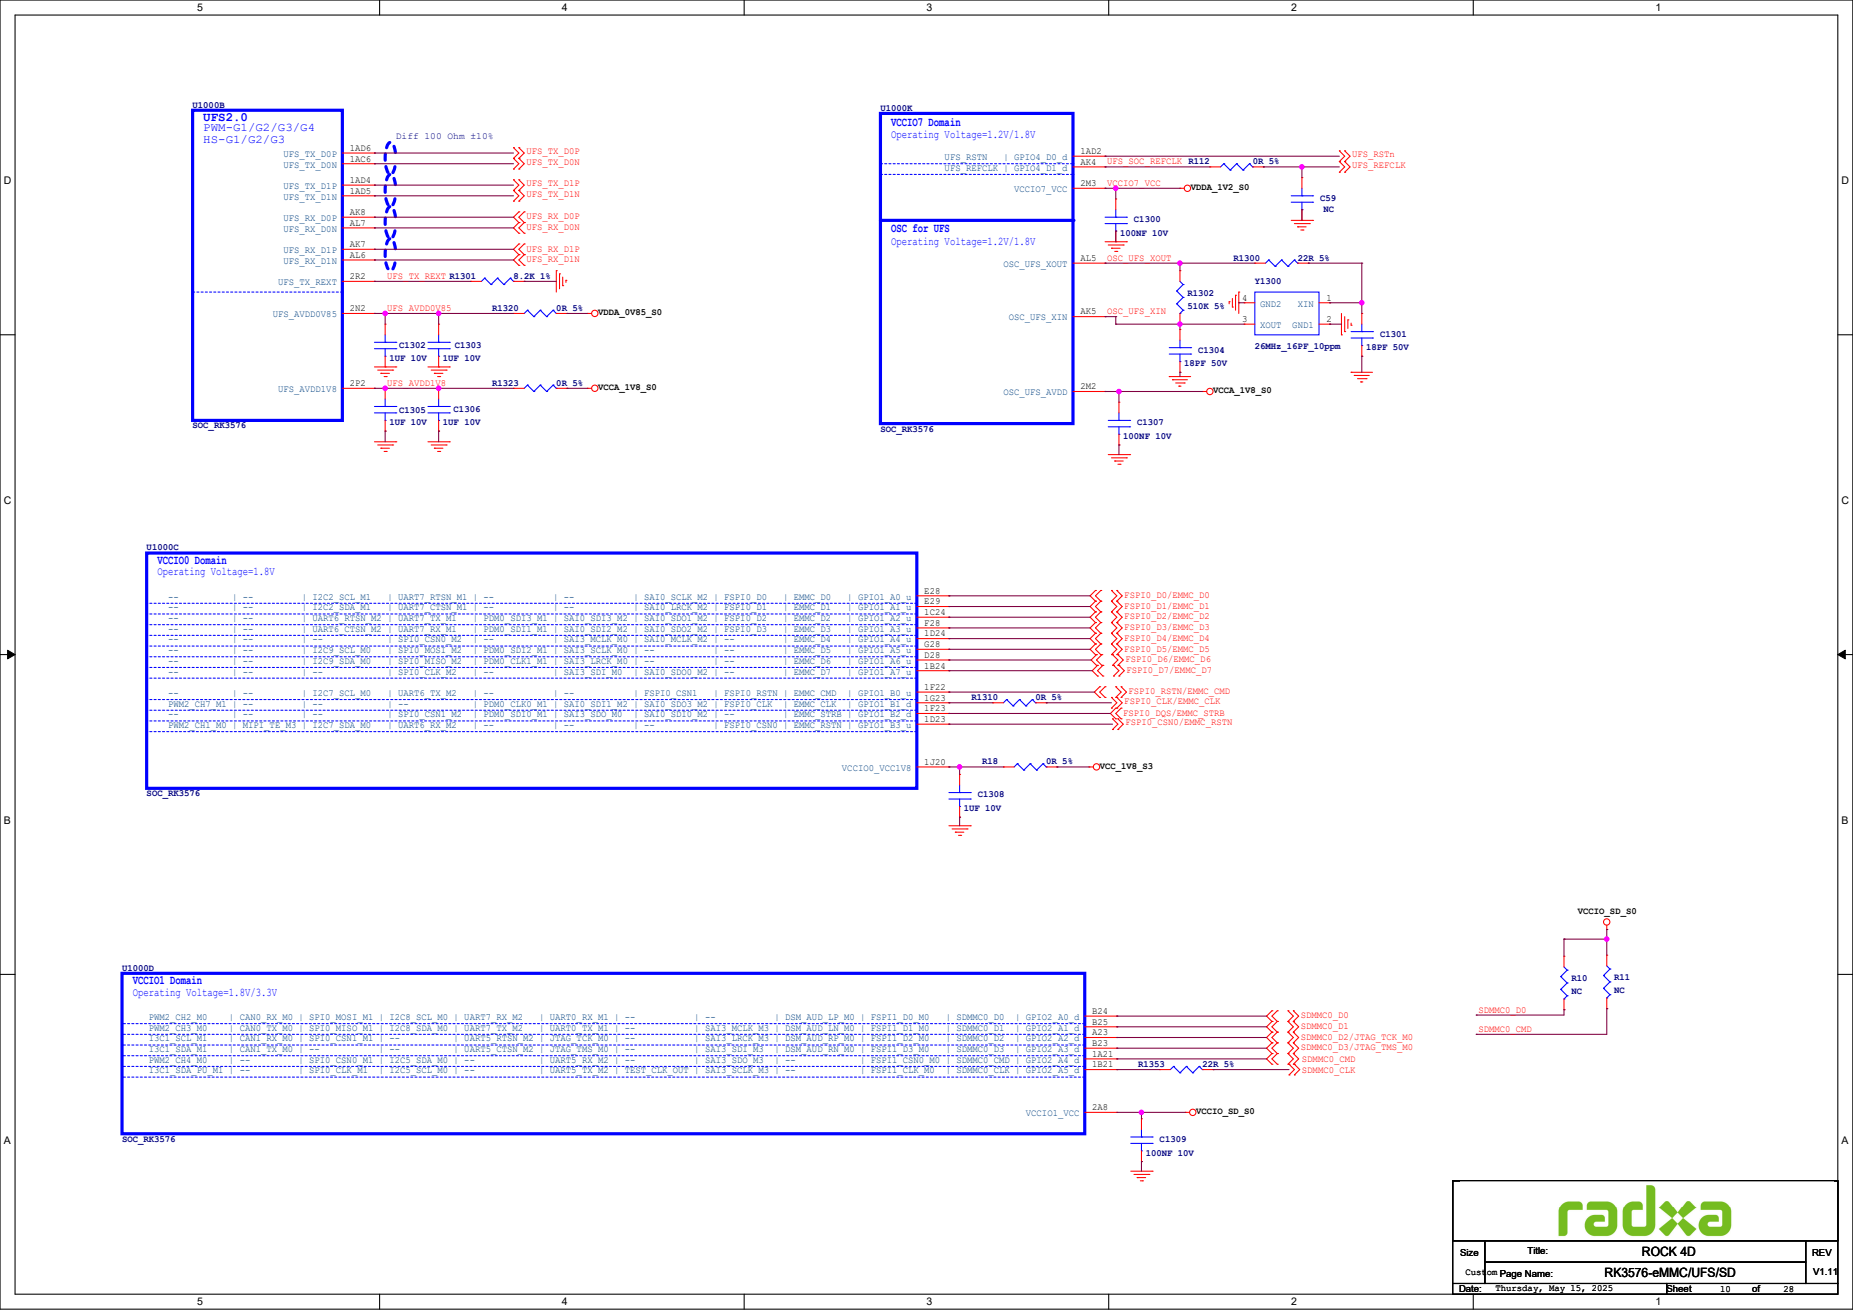
[picture p88: page 10]

## VCCA1V8_PLDO2_S0

## VCCA1V8_PLDO2_S0

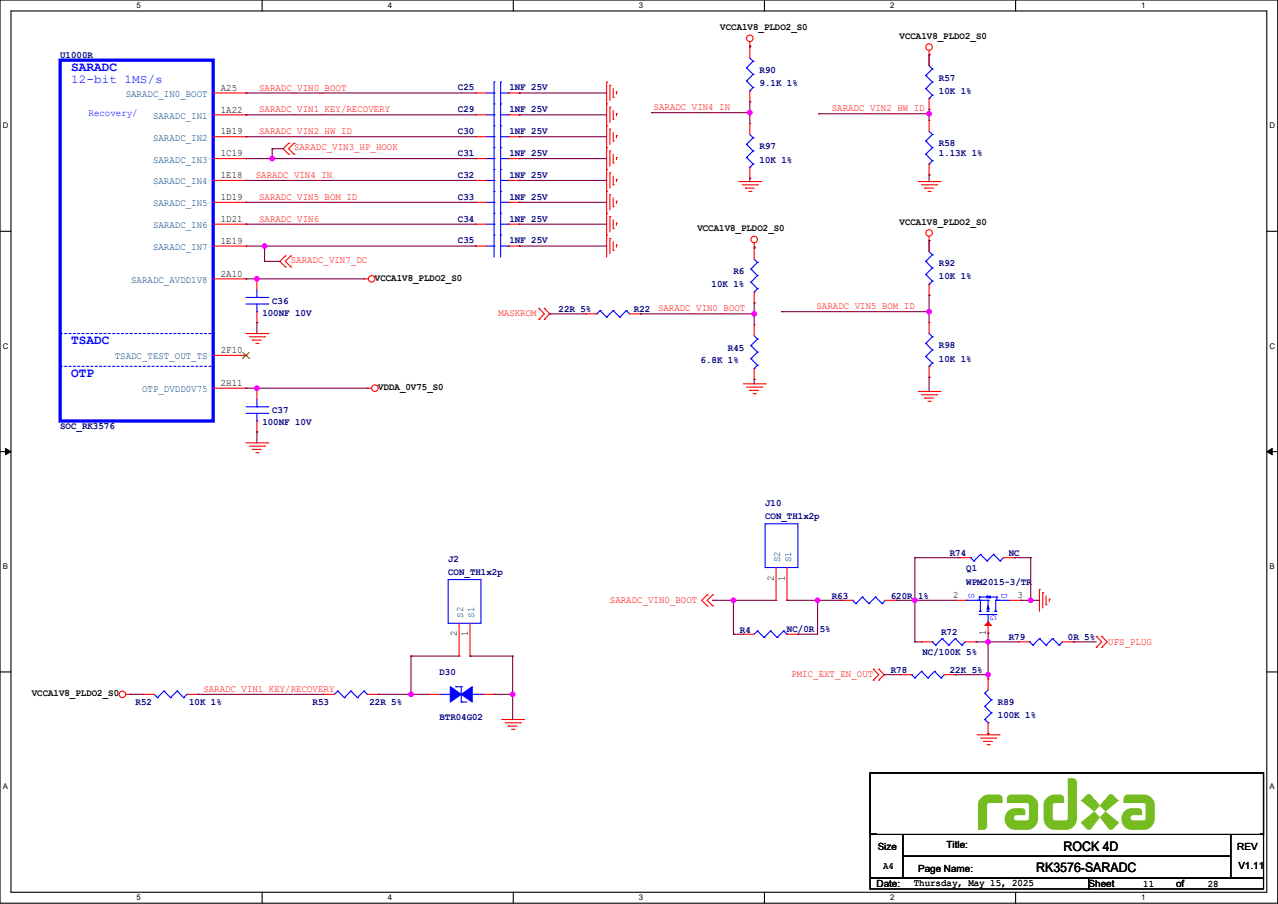
[picture p89: page 11]

## HDMI_TX_D0P

## HDMI_TX_SBDP

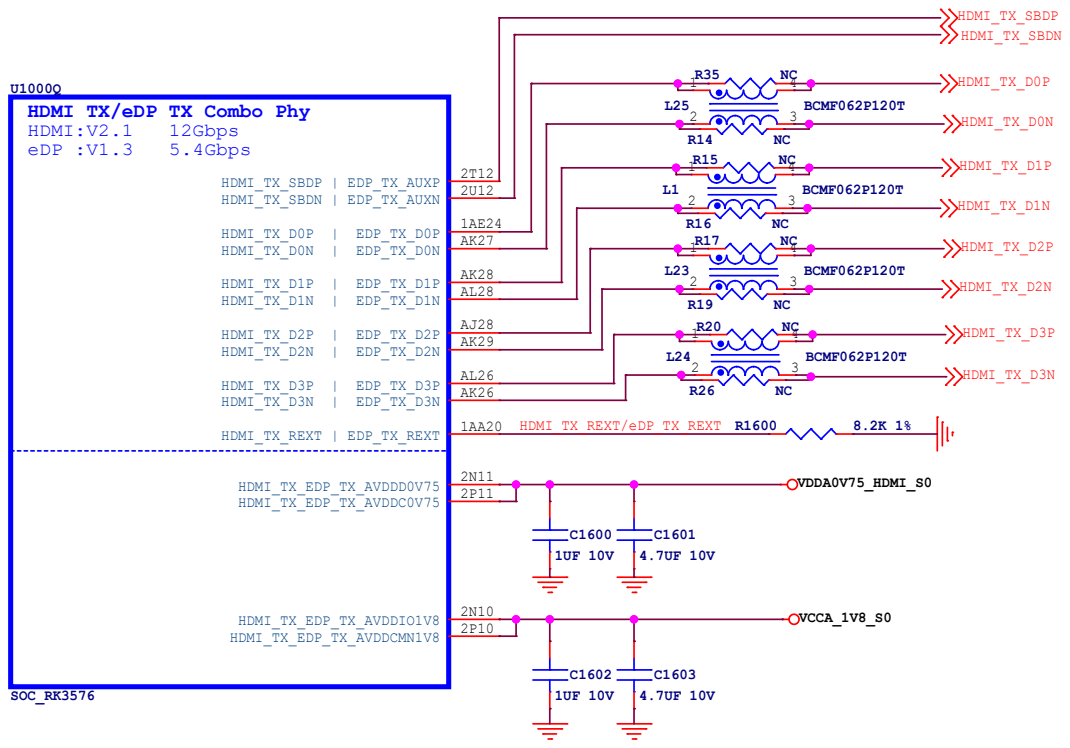
[picture p90: page 12]

HDMI TX/eDP TX Combo Phy

## VCCIO2 Domain

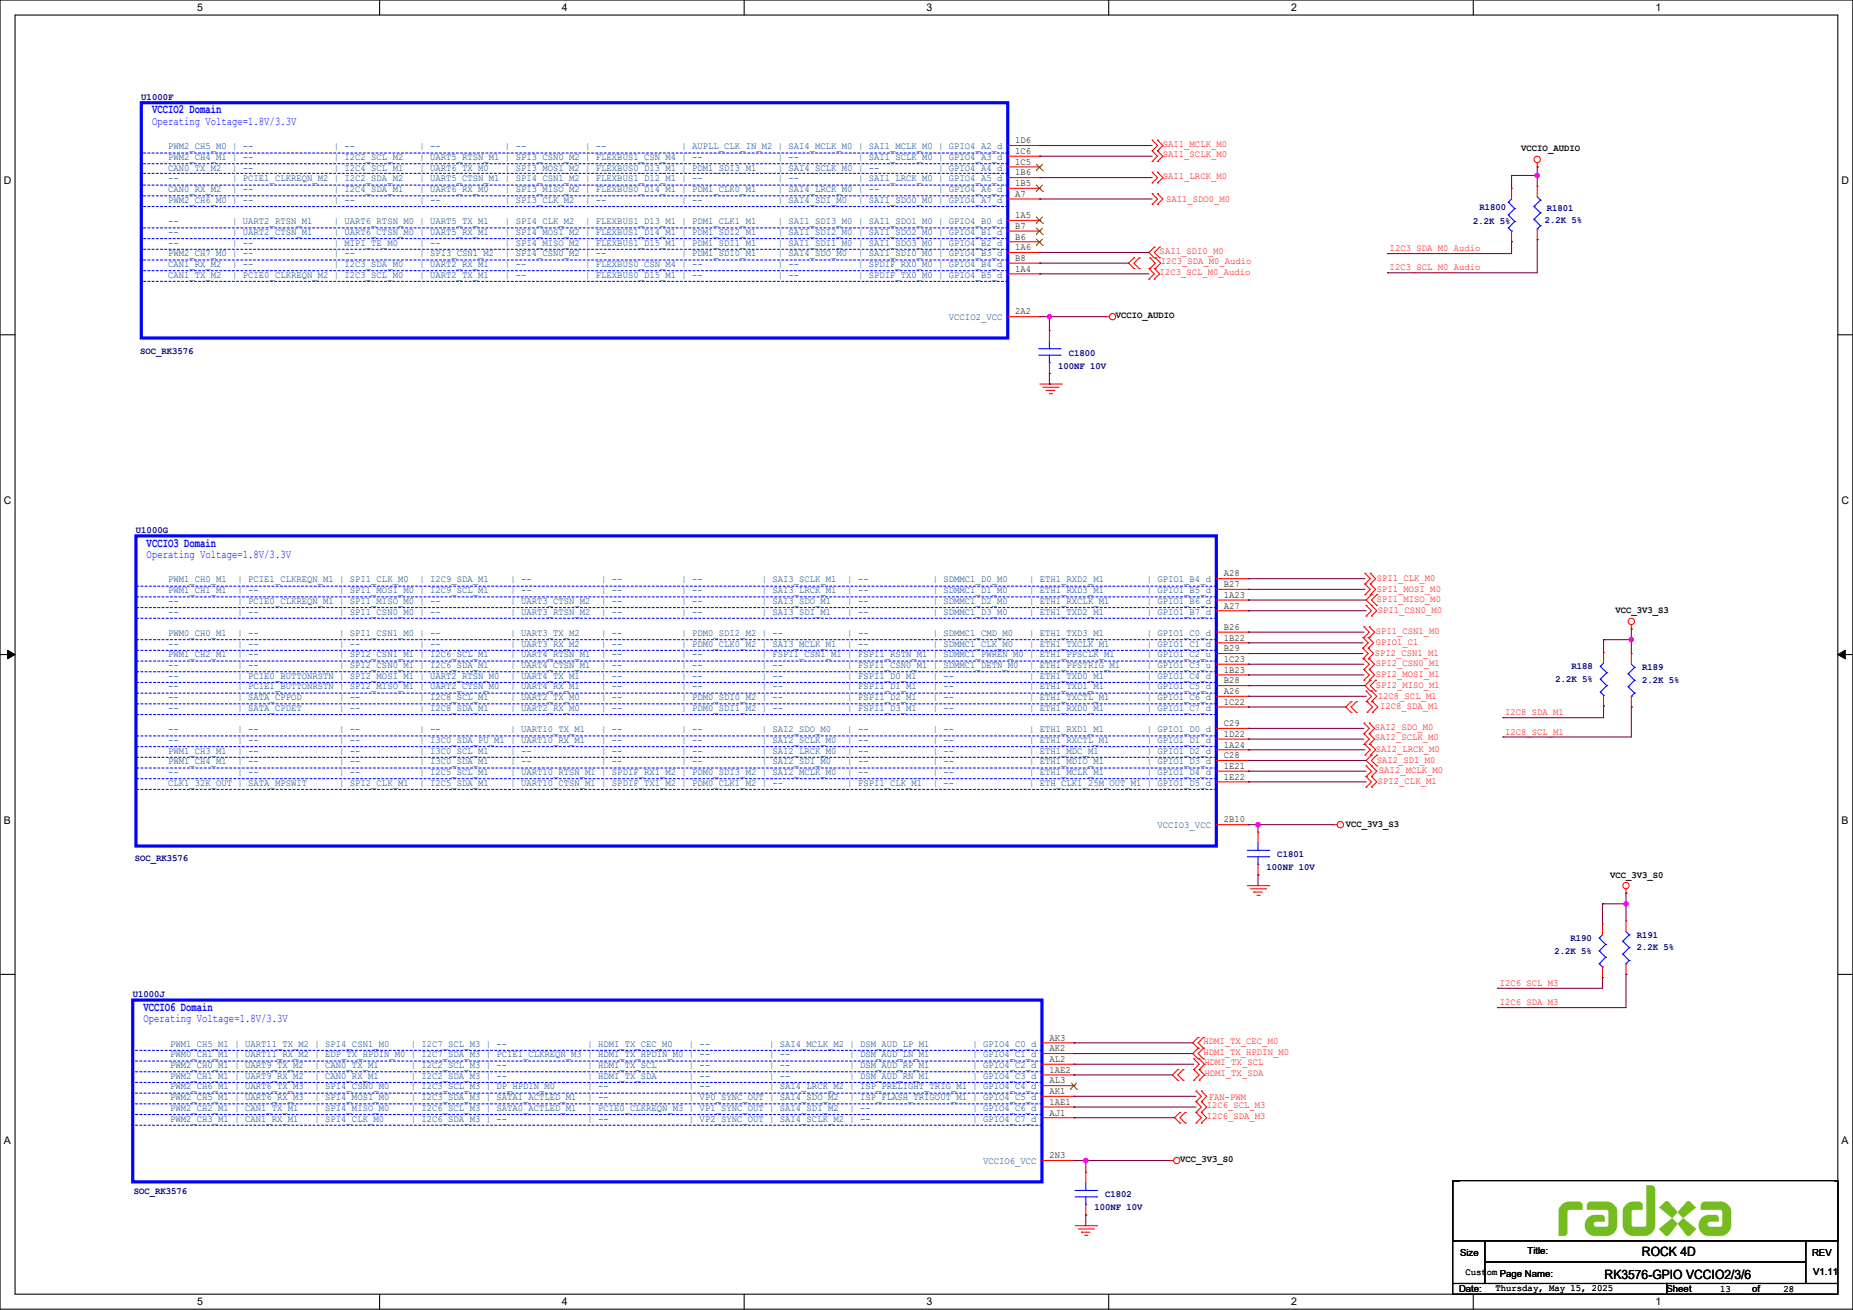
[picture p91: page 13]

## VCCIO4 Domain

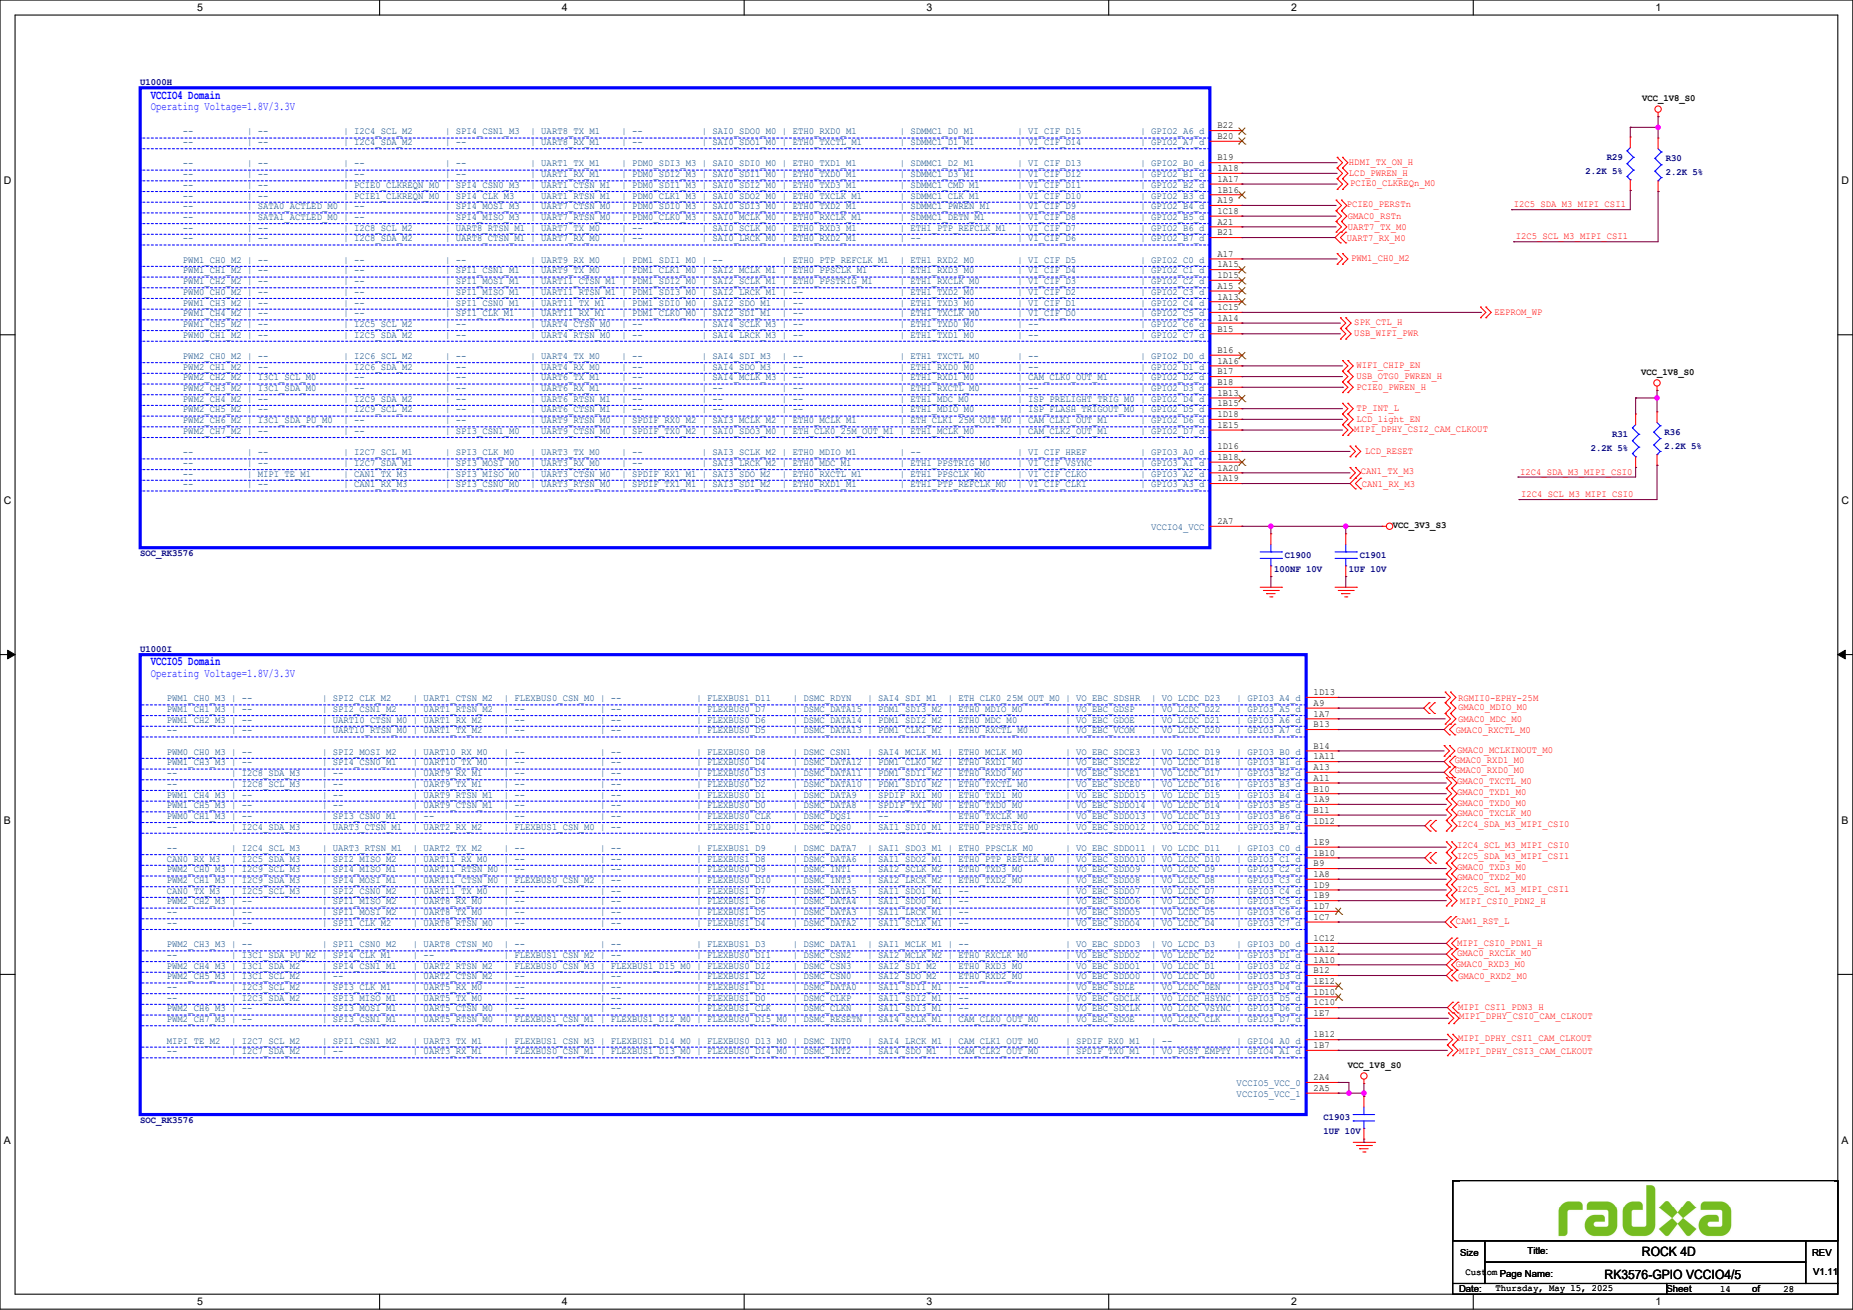
[picture p92: page 14]

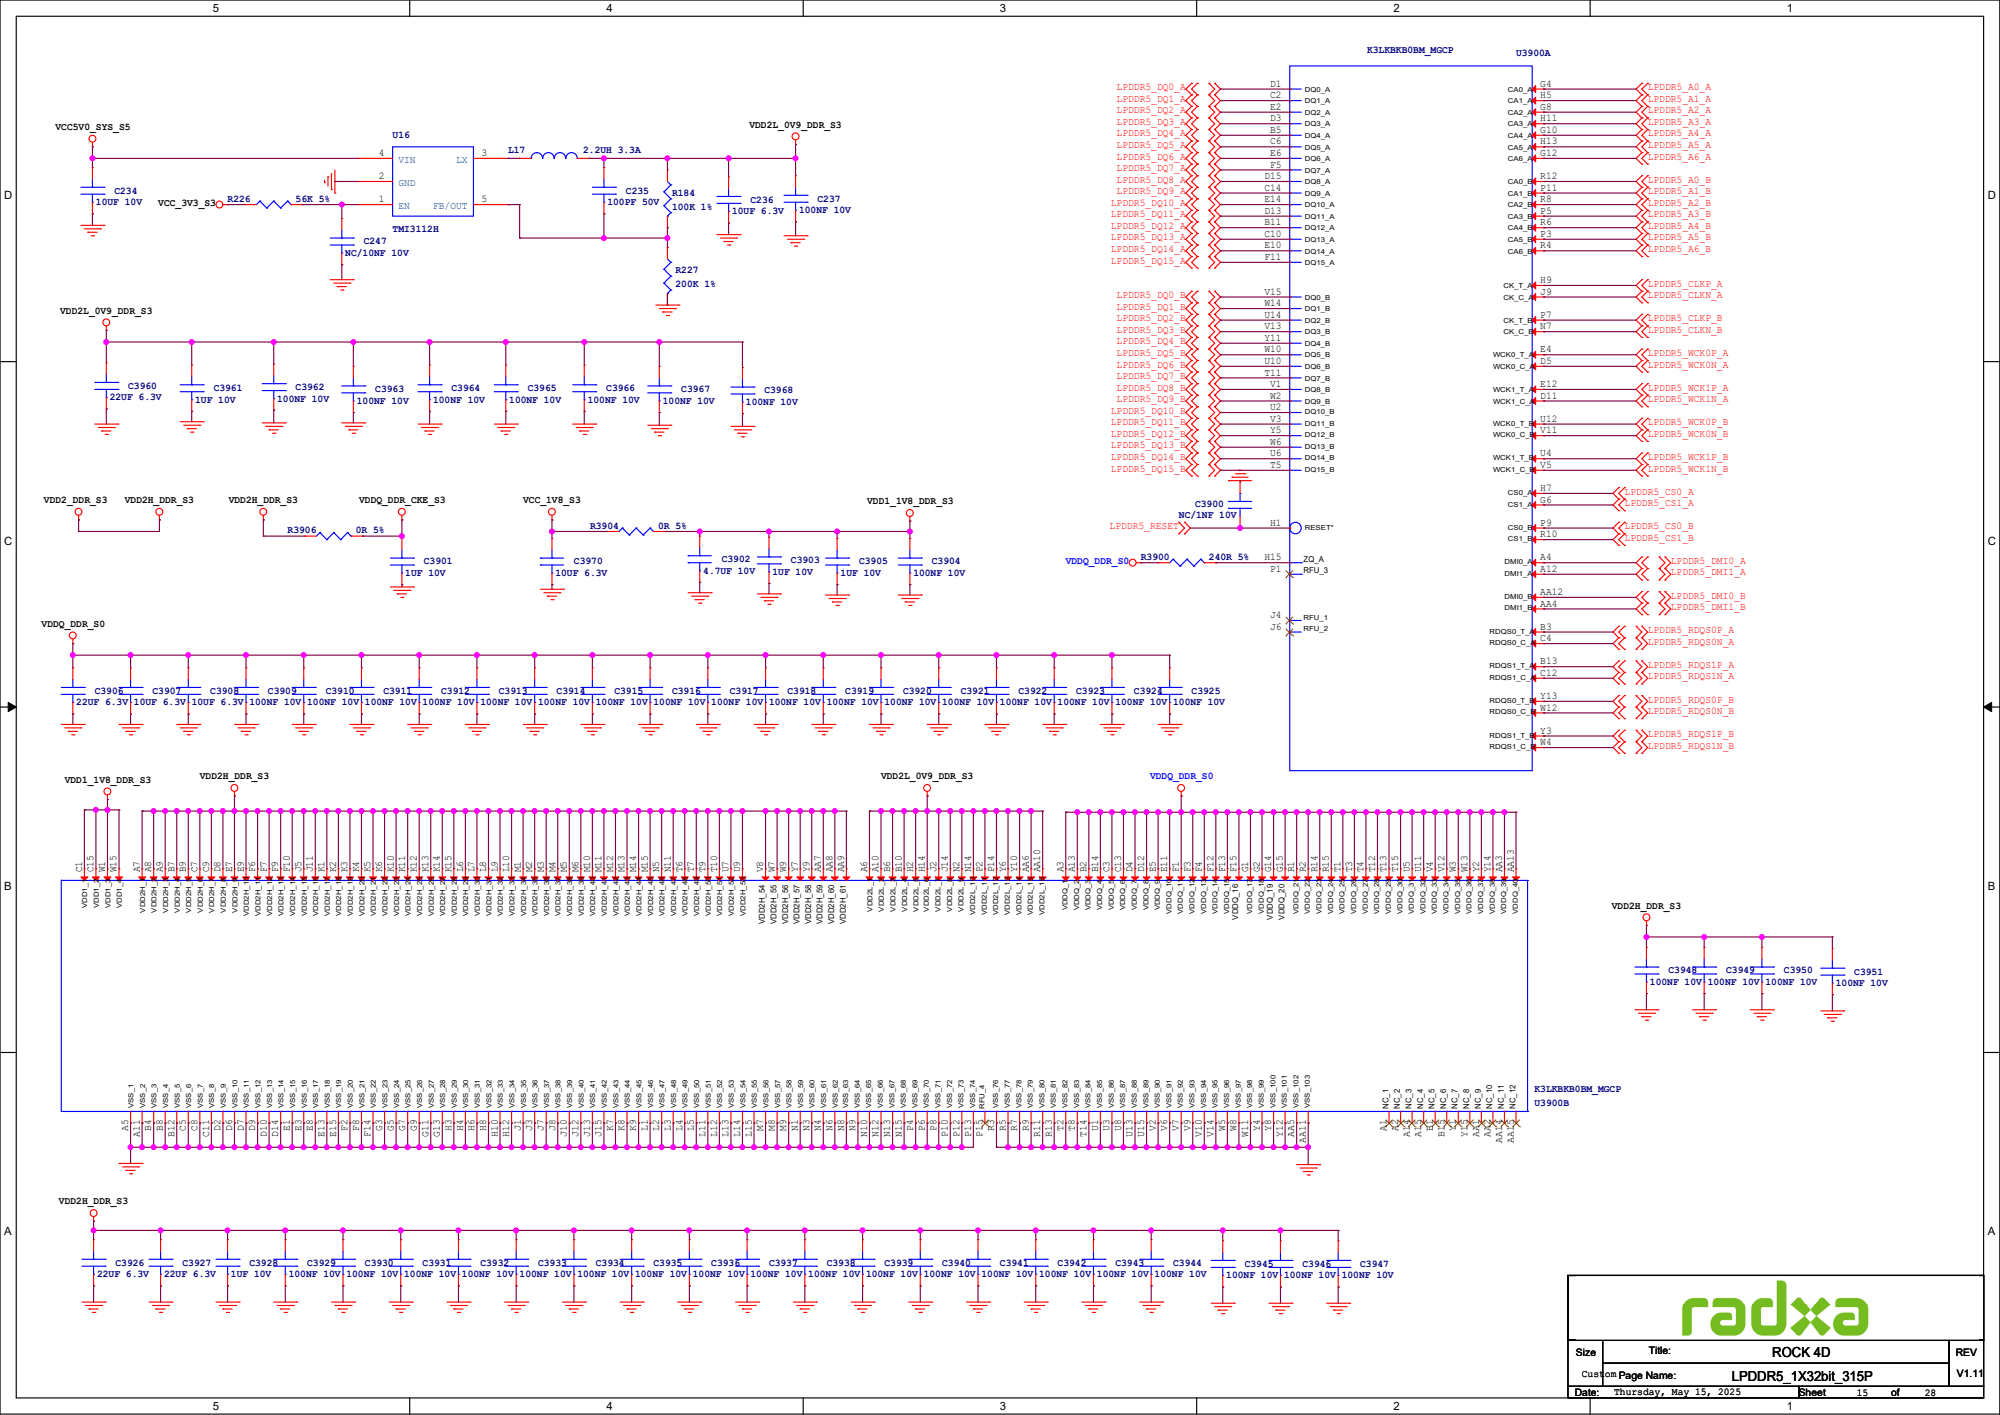
[picture p93: page 15]

VCCIO_AUDIO | VCCIO_CODEC | VCCA3V3_CODEC | VCCA_3V3_S0

## I2C3_SDA_M0_Audio

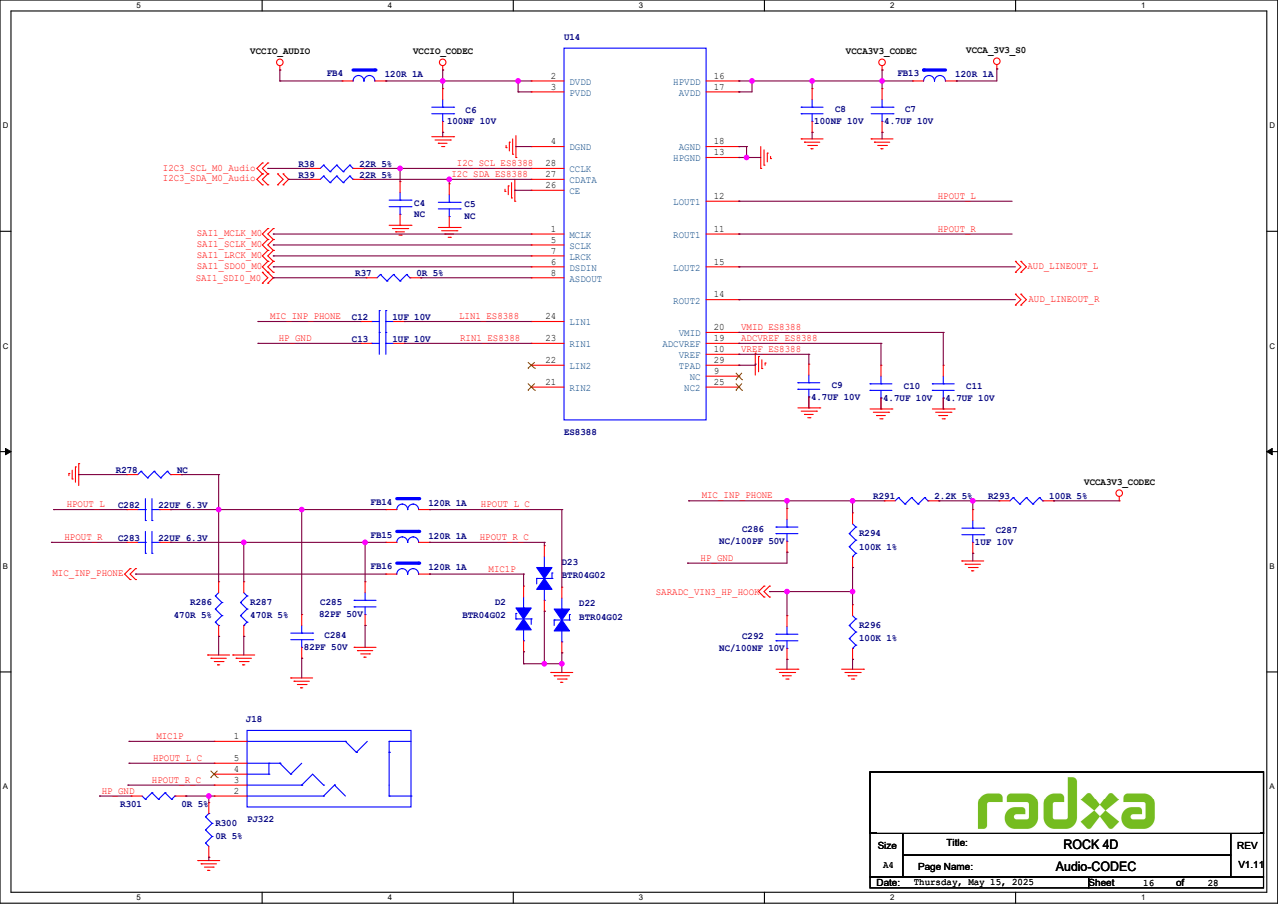
[picture p94: page 16]

1 | 3 ⁵ 6 R302 | 4.7K 5%

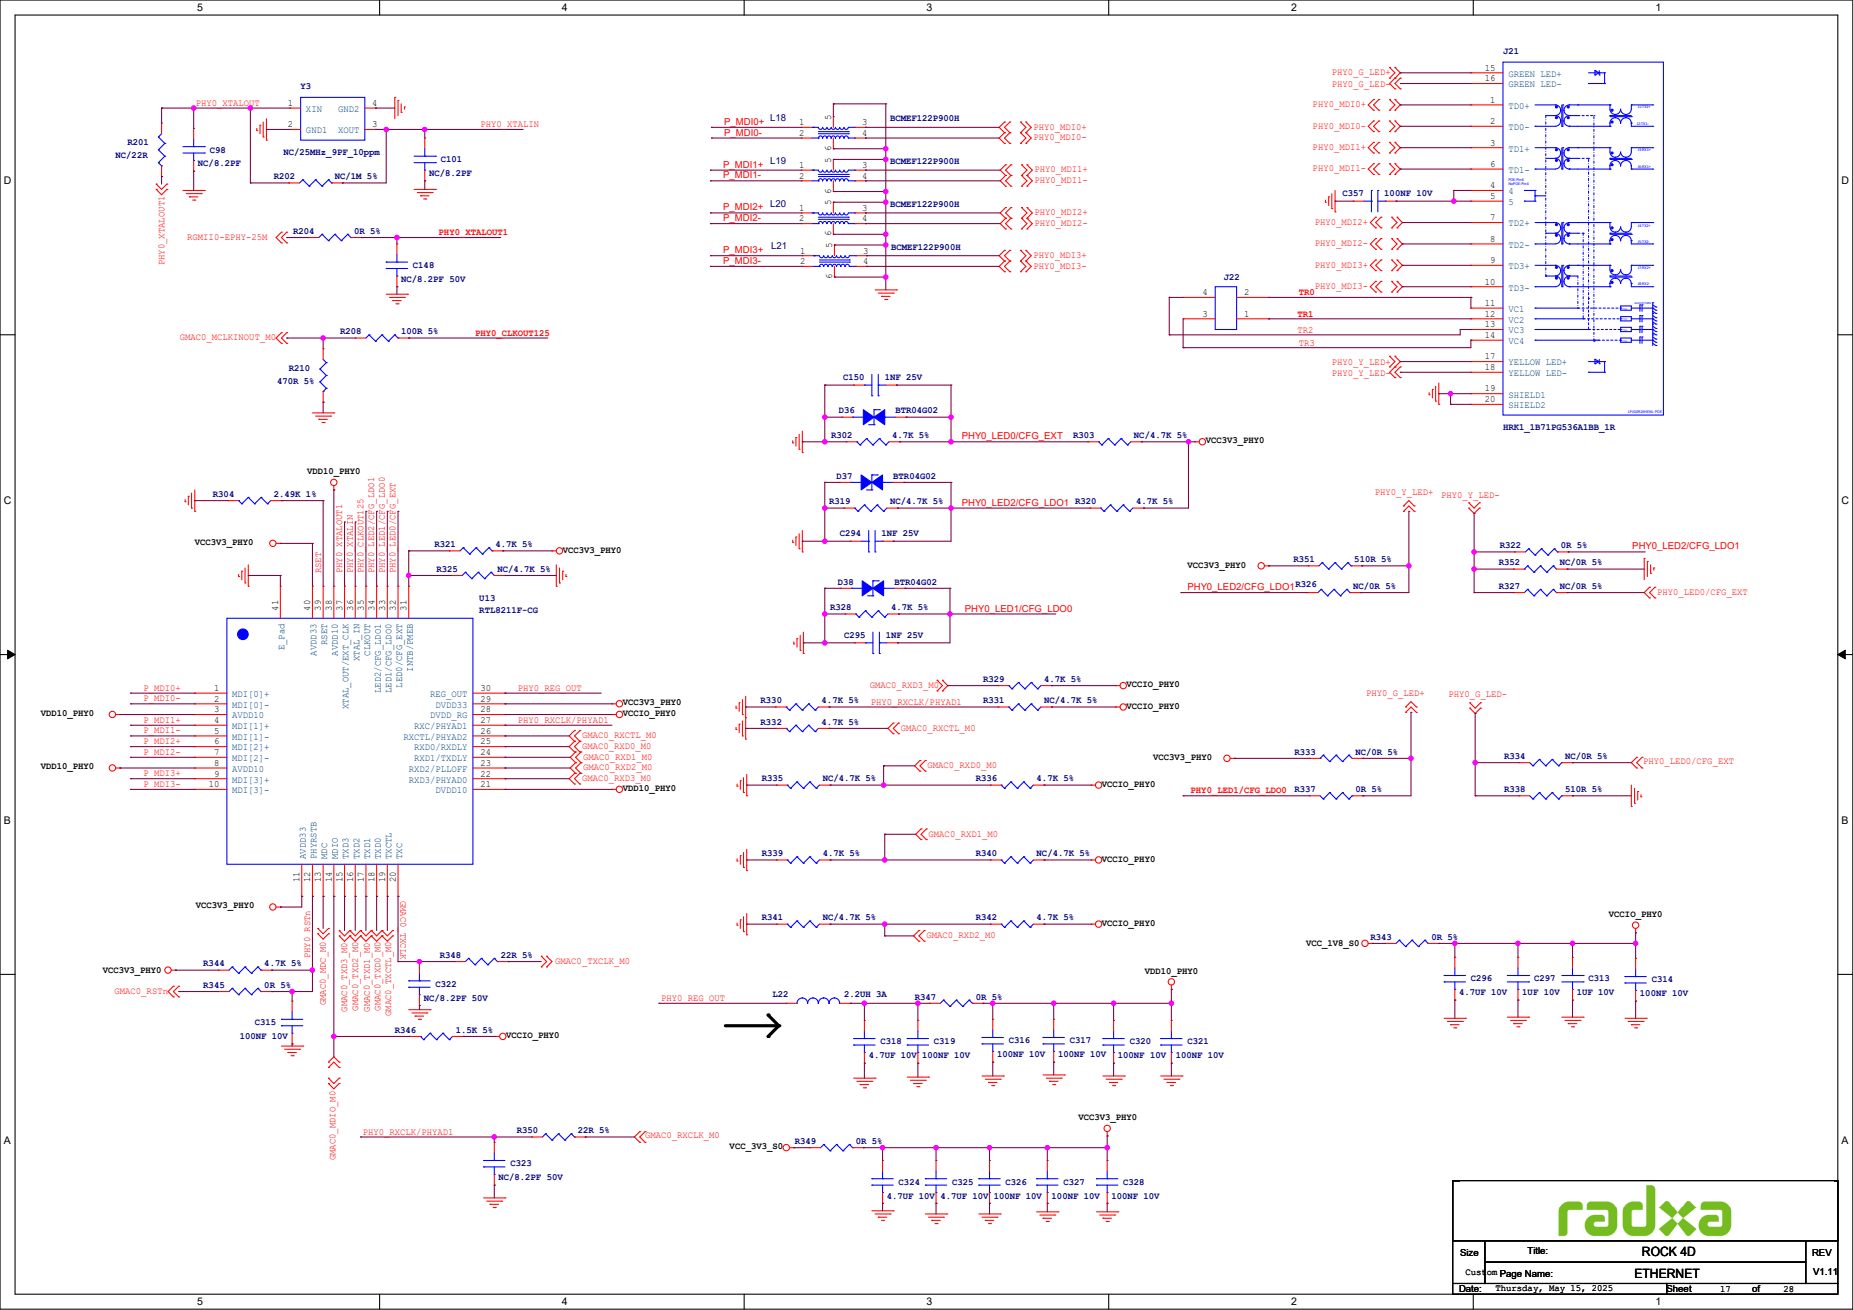
[picture p95: page 17]

DVDD10 21 RXD3/PHYAD0 22 RXD2/PLLOFF 23 RXD1/TXDLY 24 RXD0/RXDLY 25 RXCTL/PHYAD2 26 RXC/PHYAD1 27 DVDD_RG

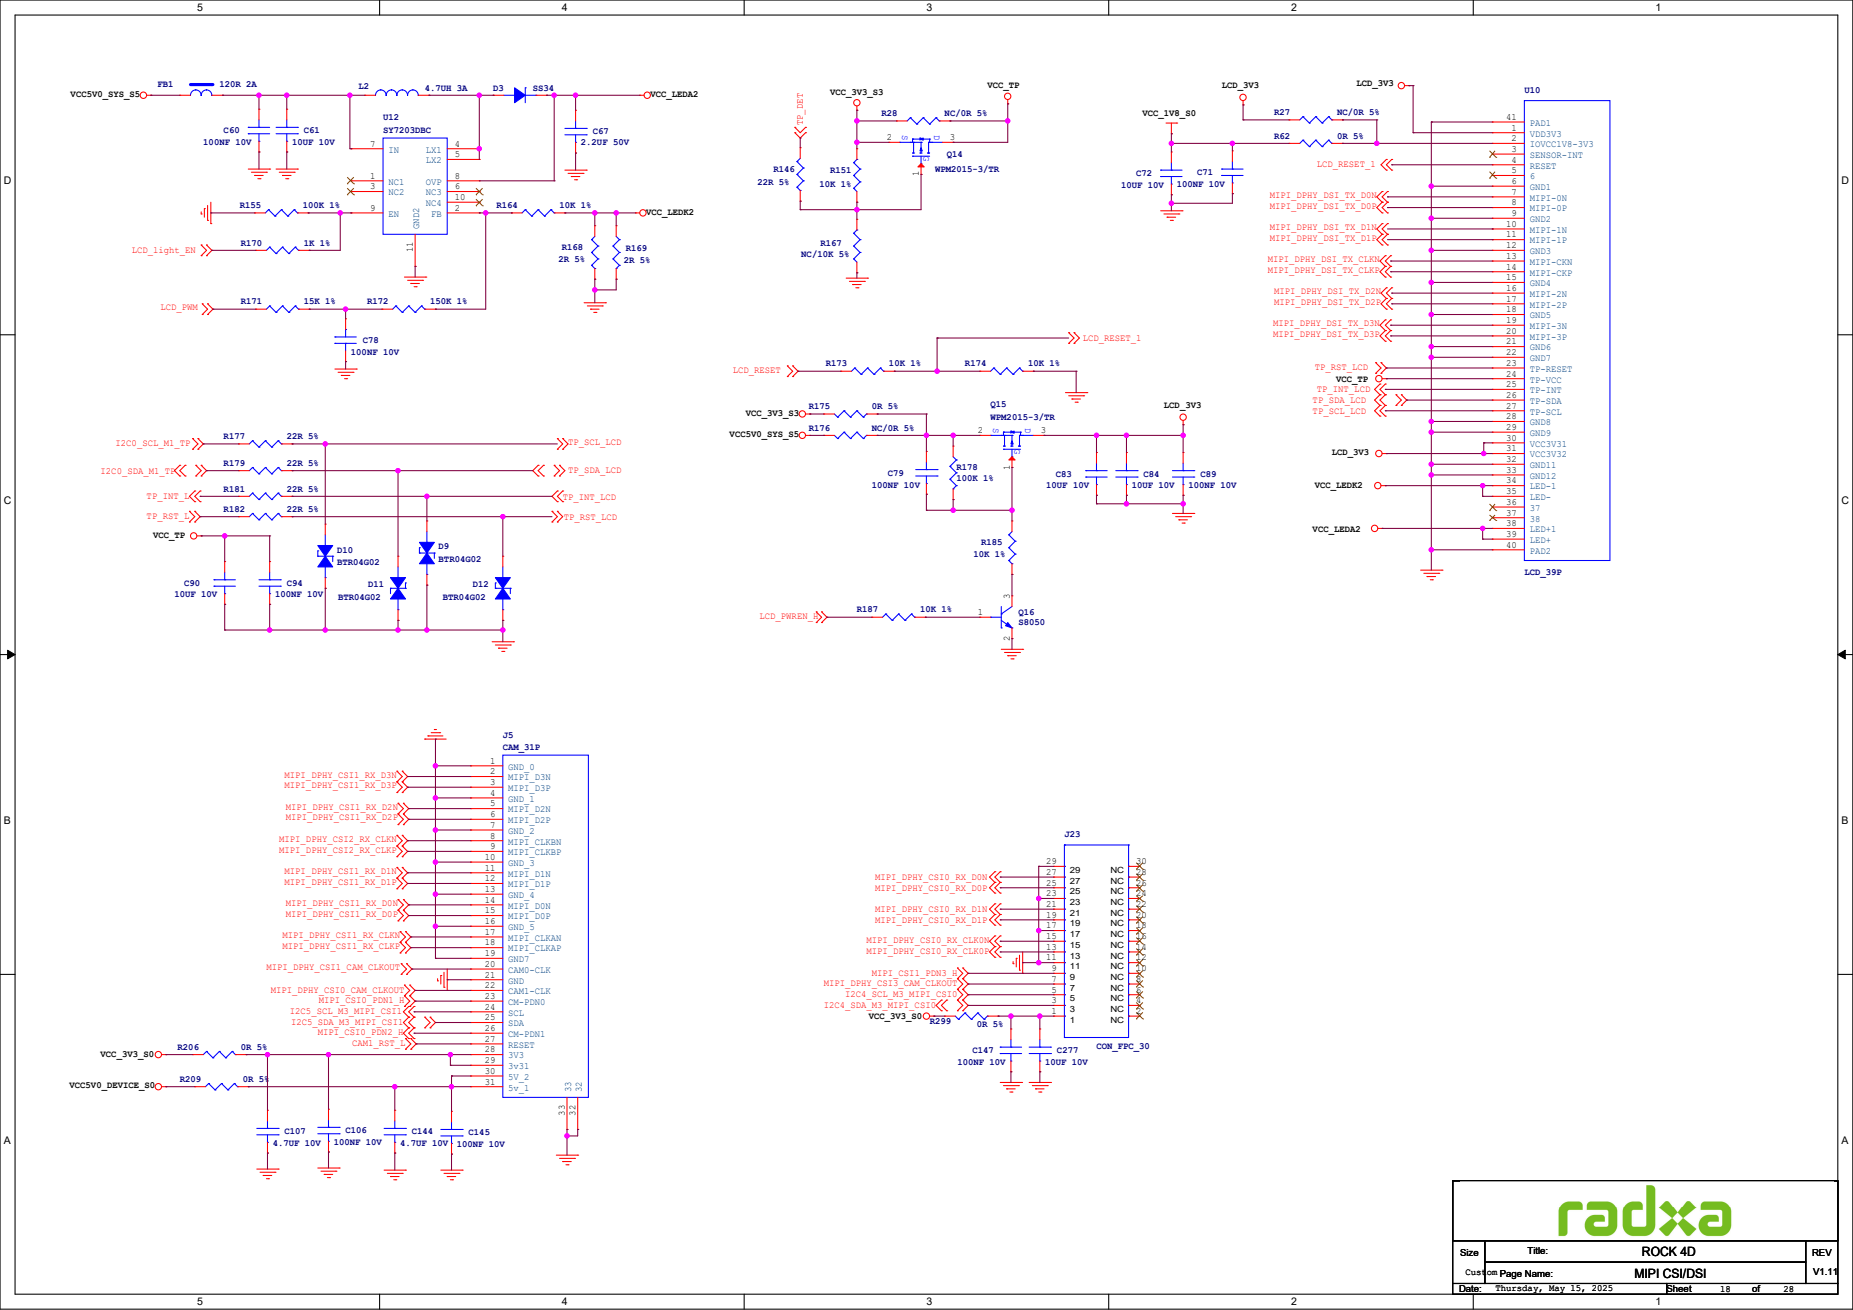
[picture p96: page 18]

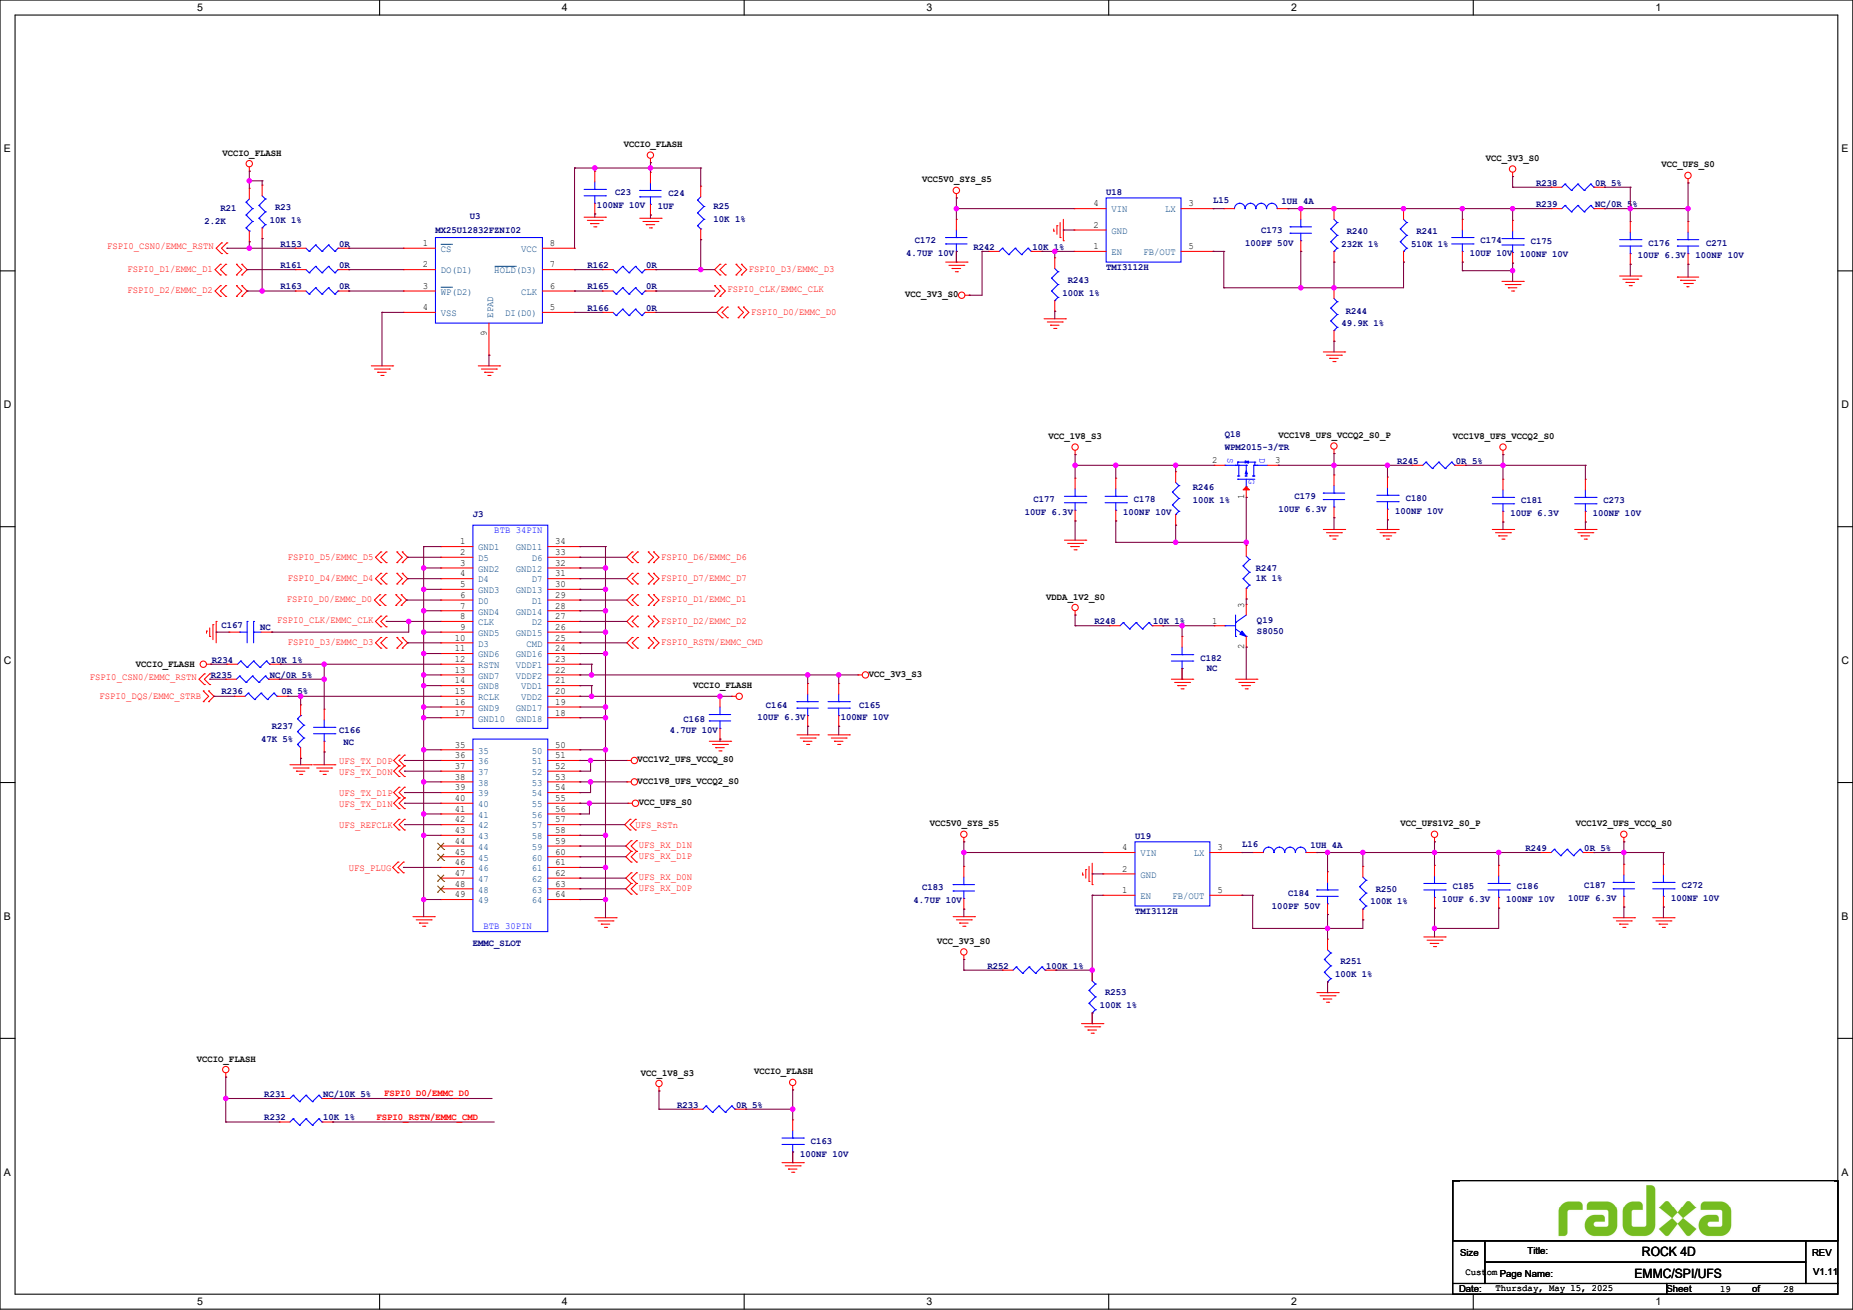
[picture p97: page 19]

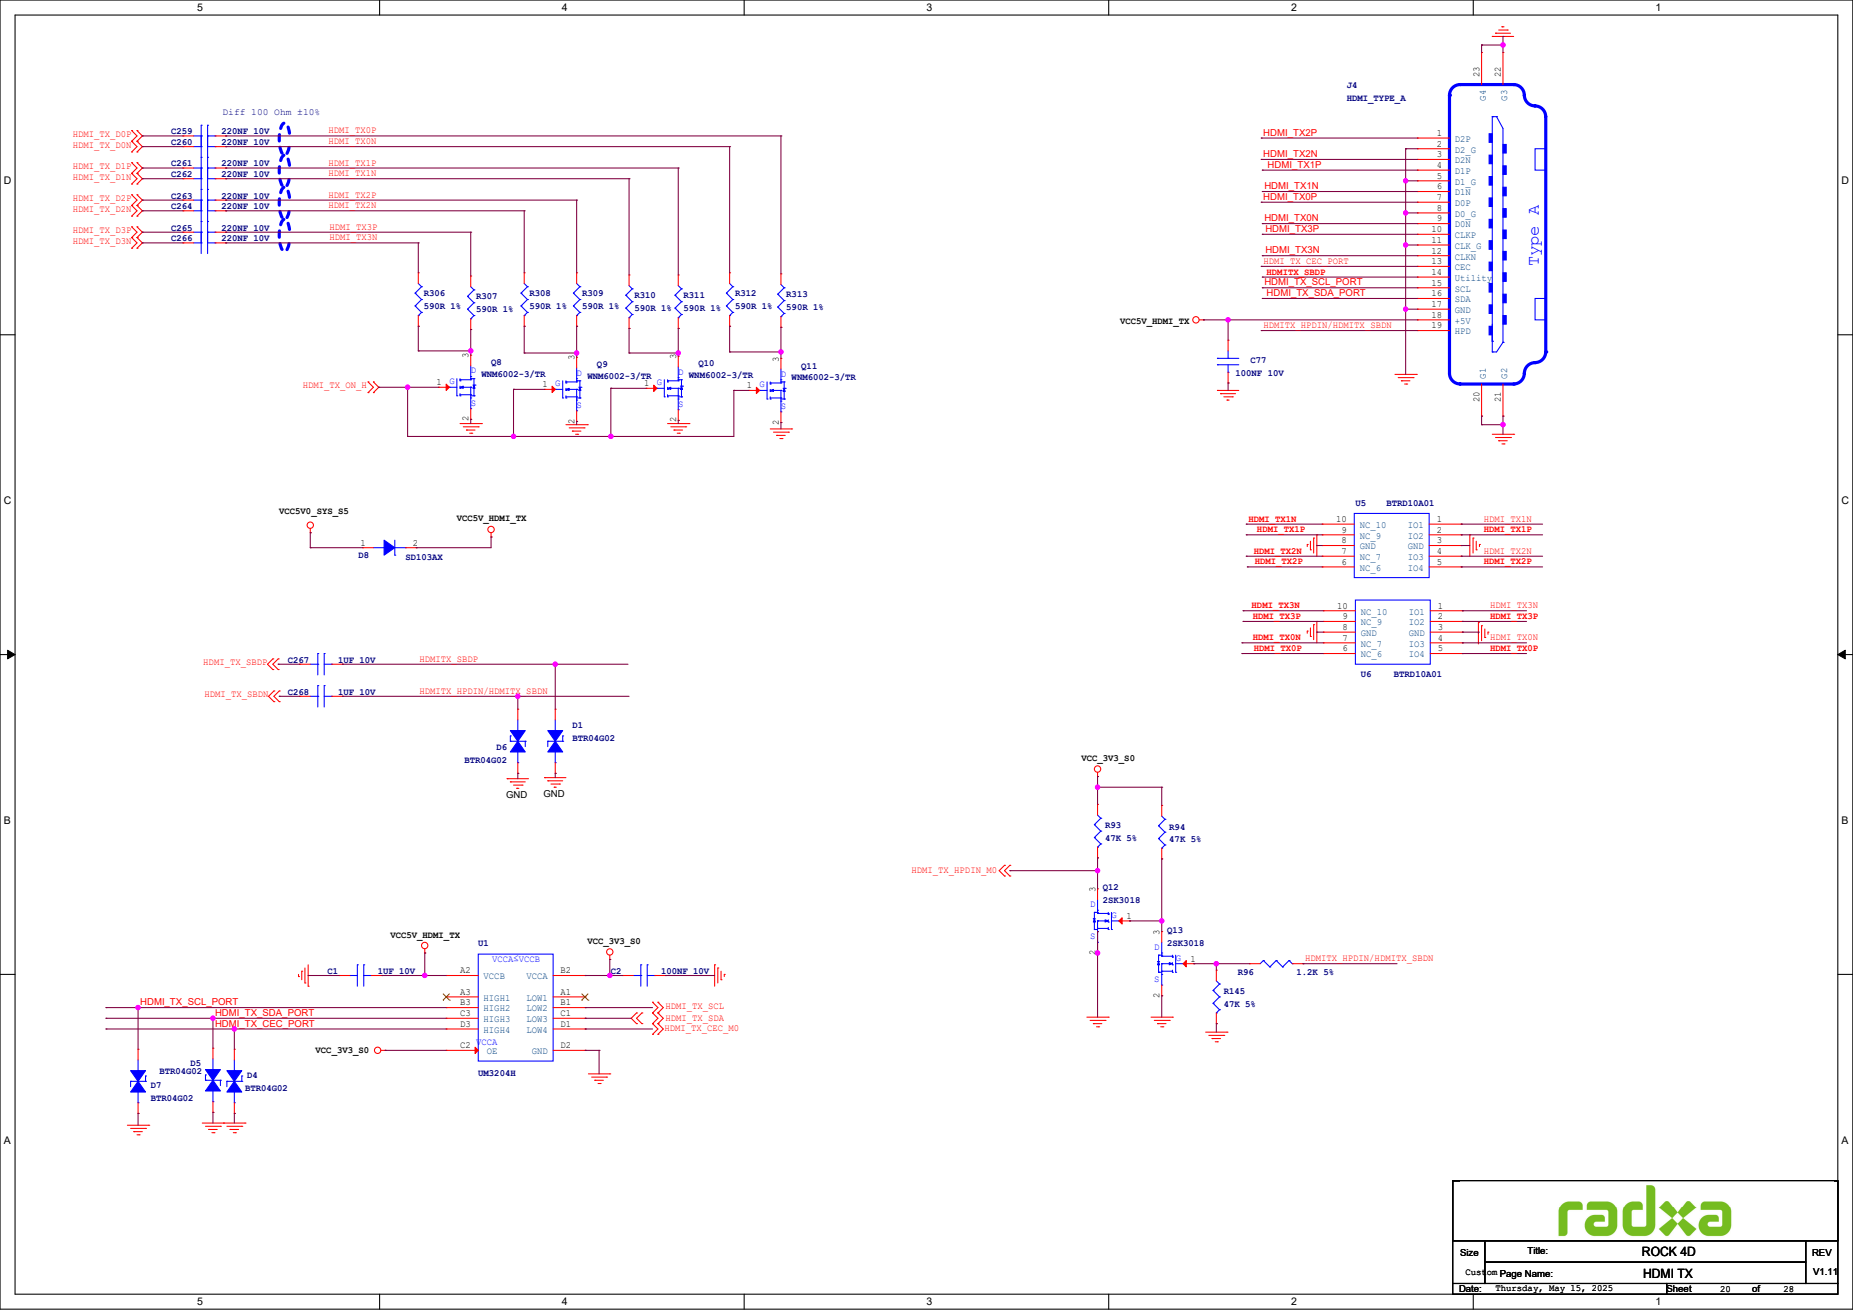
[picture p98: page 20]

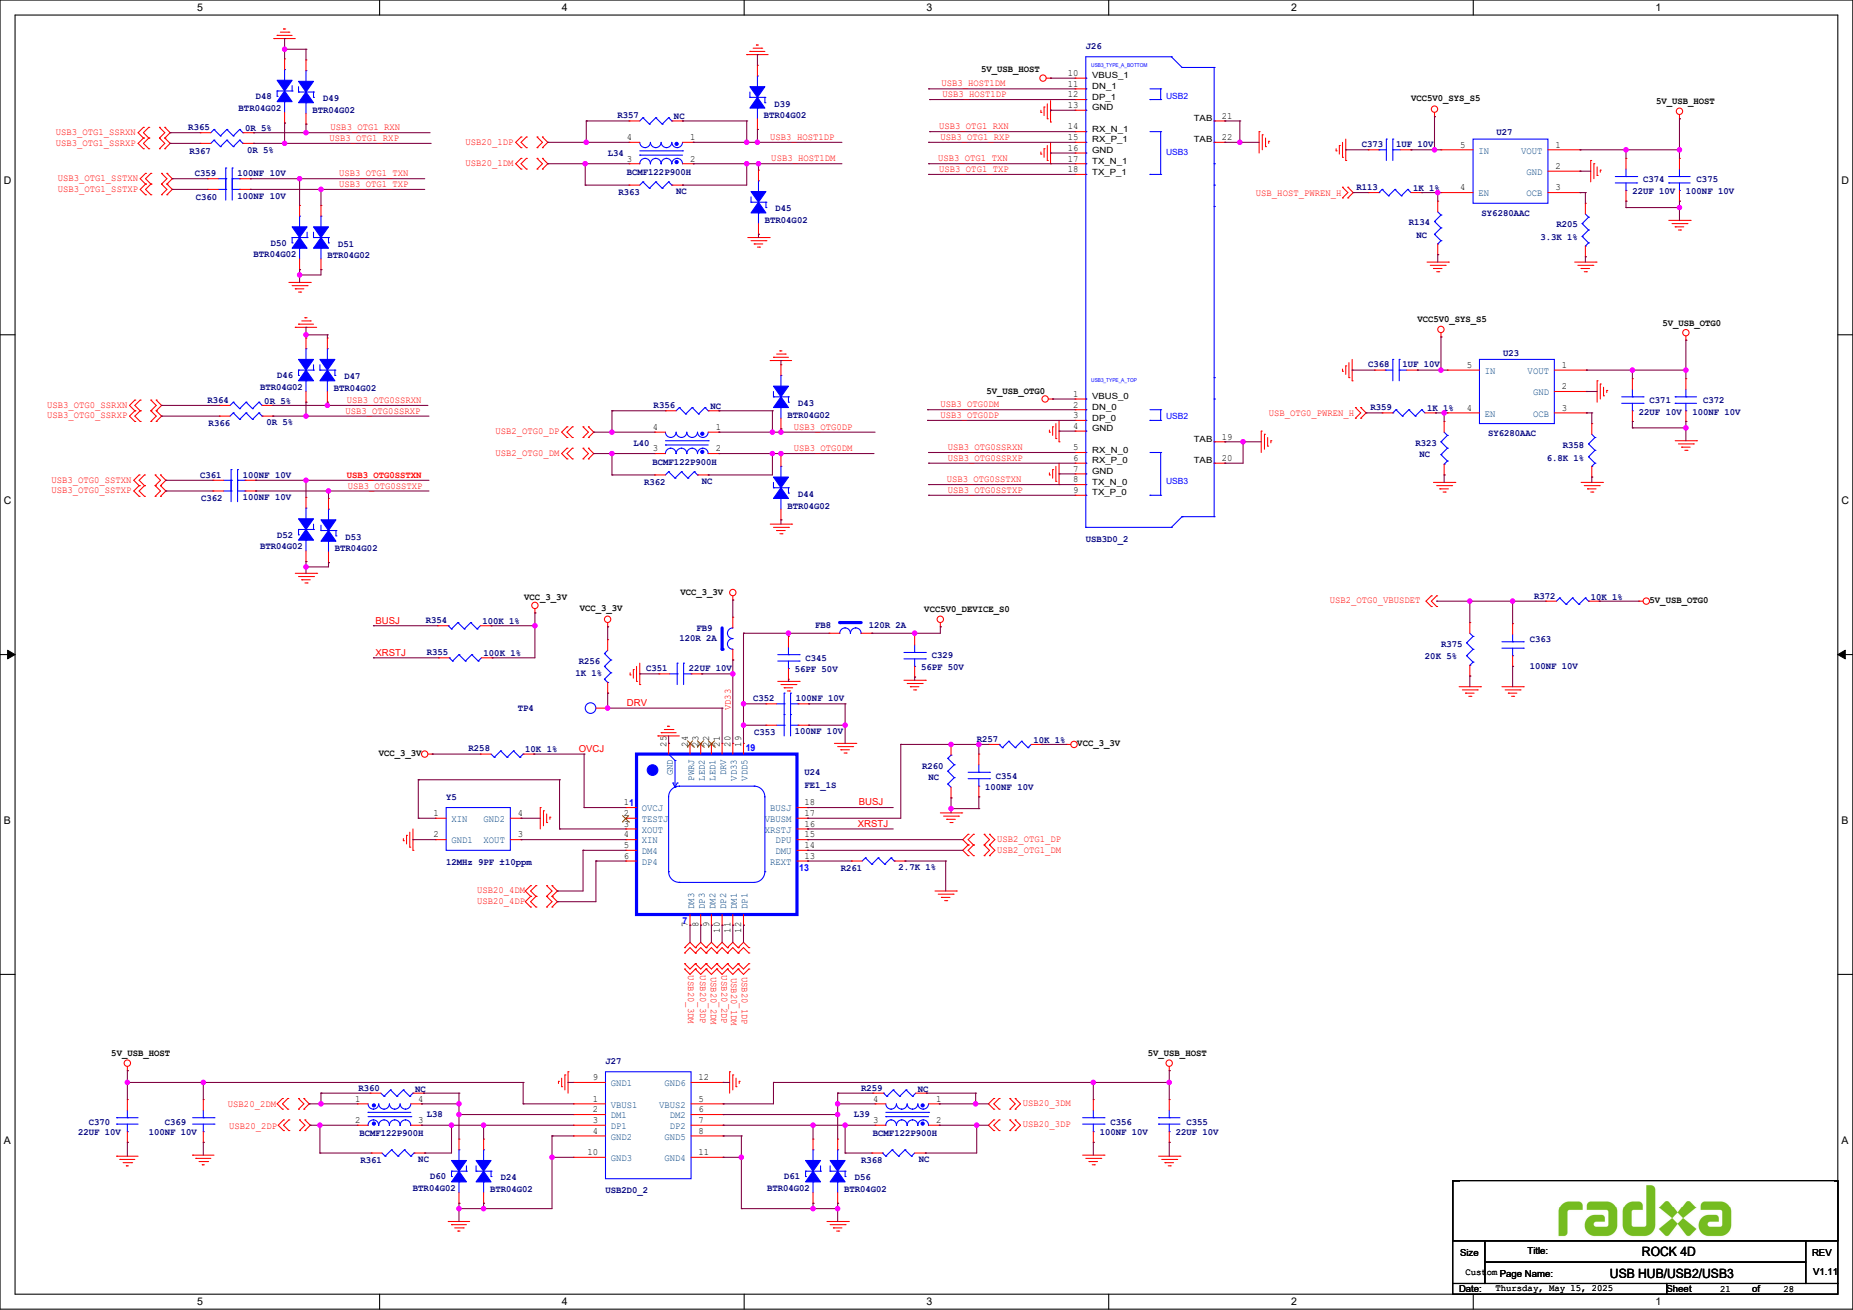
[picture p99: page 21]

## WIFI_CHIP_EN

U25

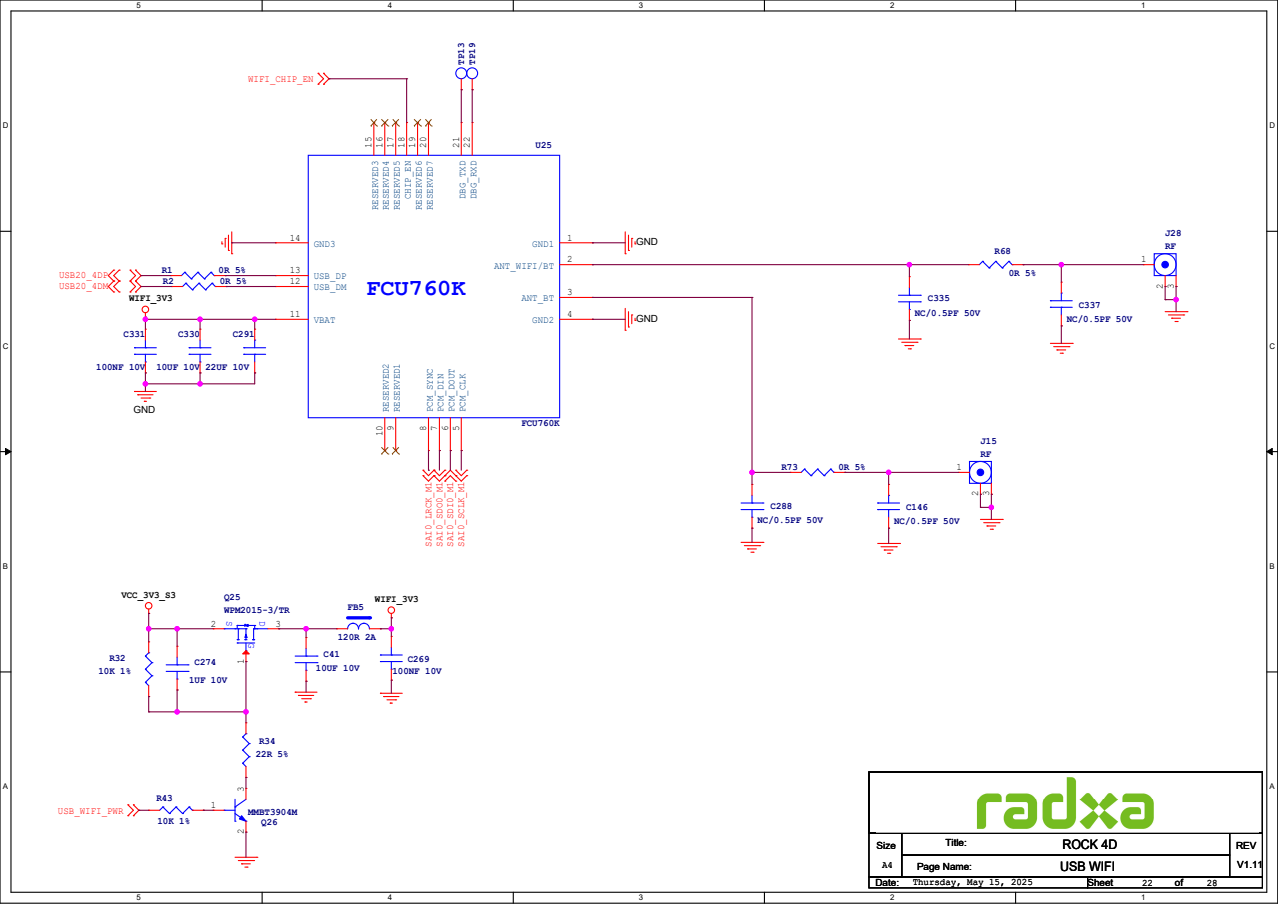
[picture p100: page 22]

## VCC_3V3_S3

## SDMMC0_D0

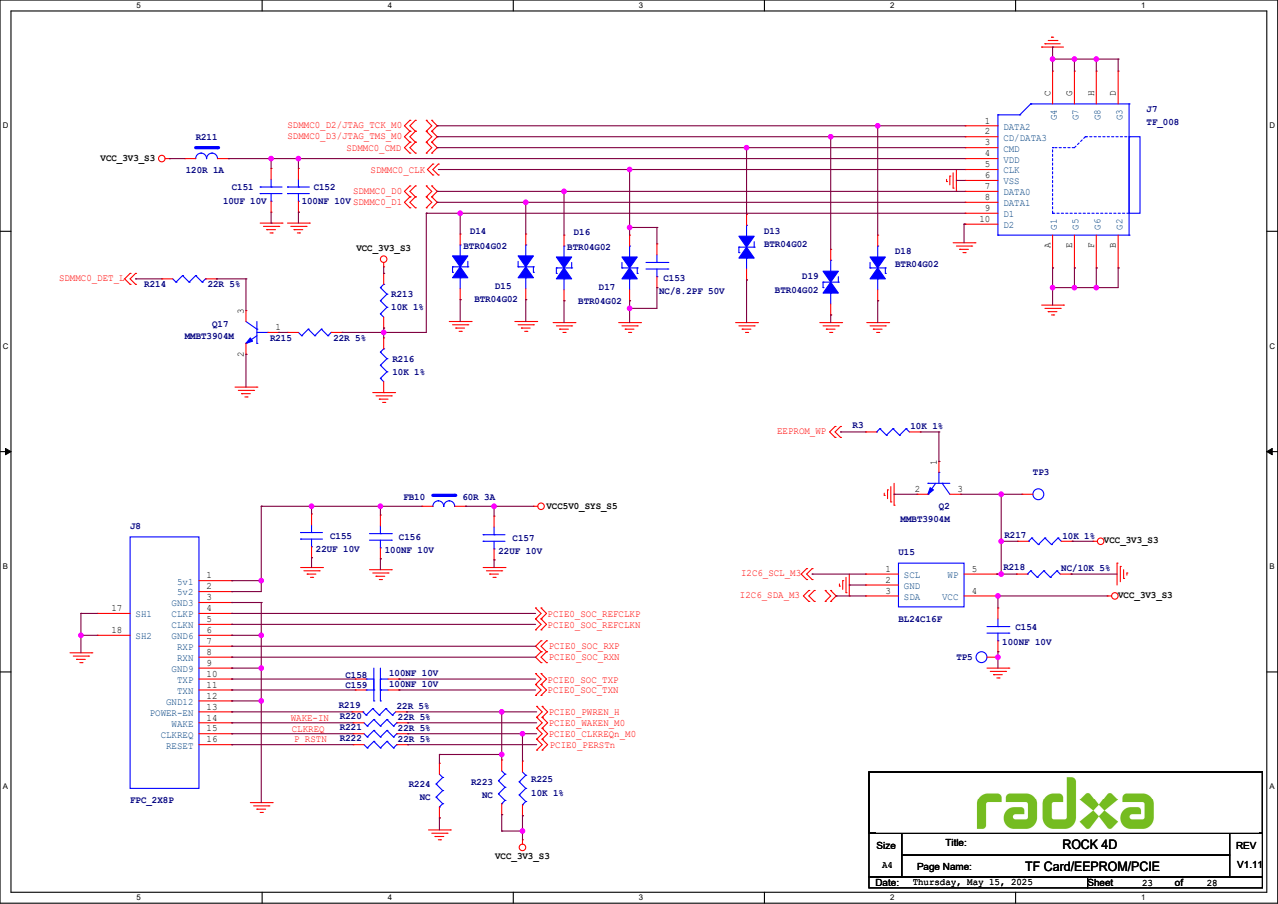
[picture p101: page 23]

4 5

VCC5V0_DEVICE_S0 | VCC_SPK_AMP

## SPK_CTL_H

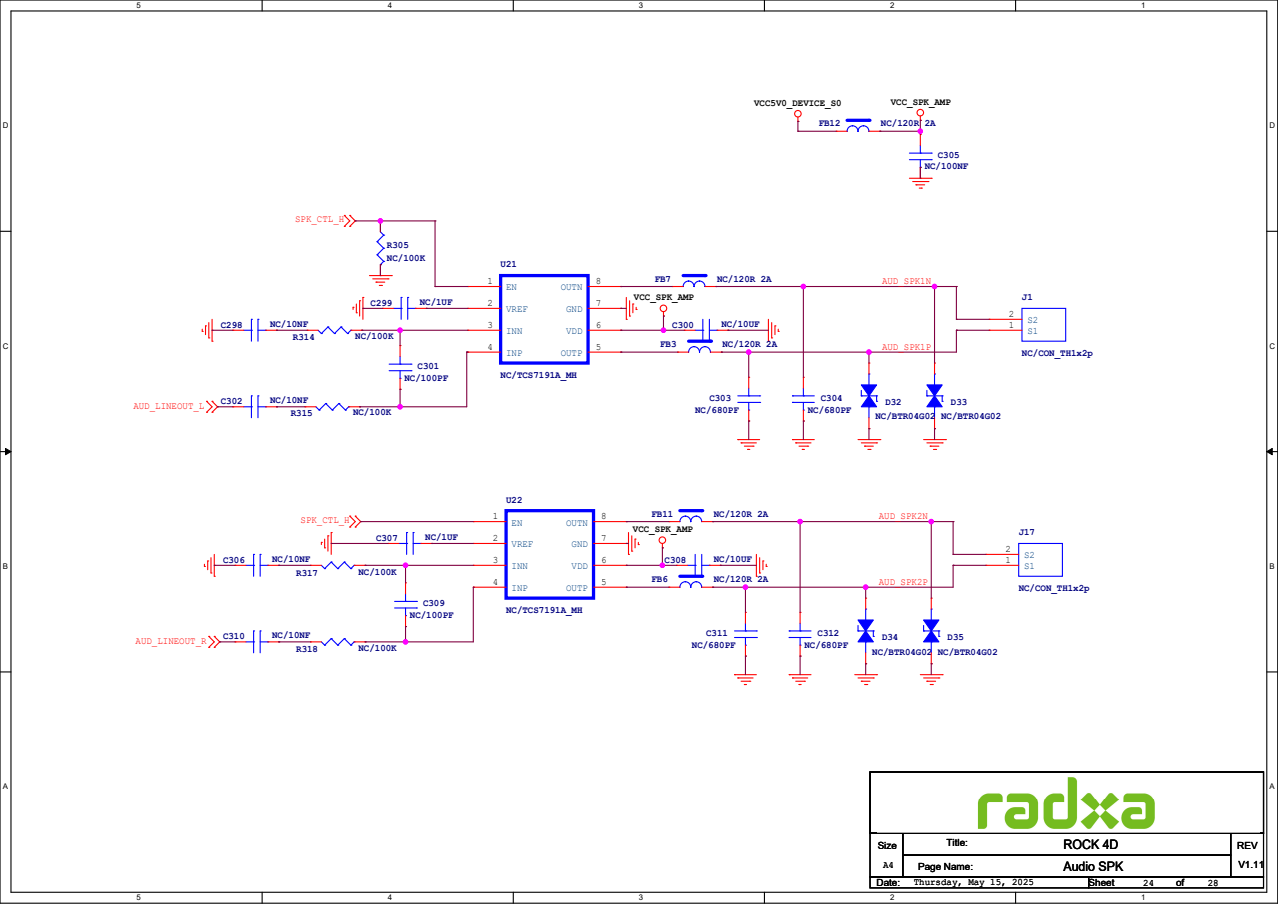
[picture p102: page 24]

AUD_SPK1P

AUD_SPK2N

AUD_SPK2P

## PLDO

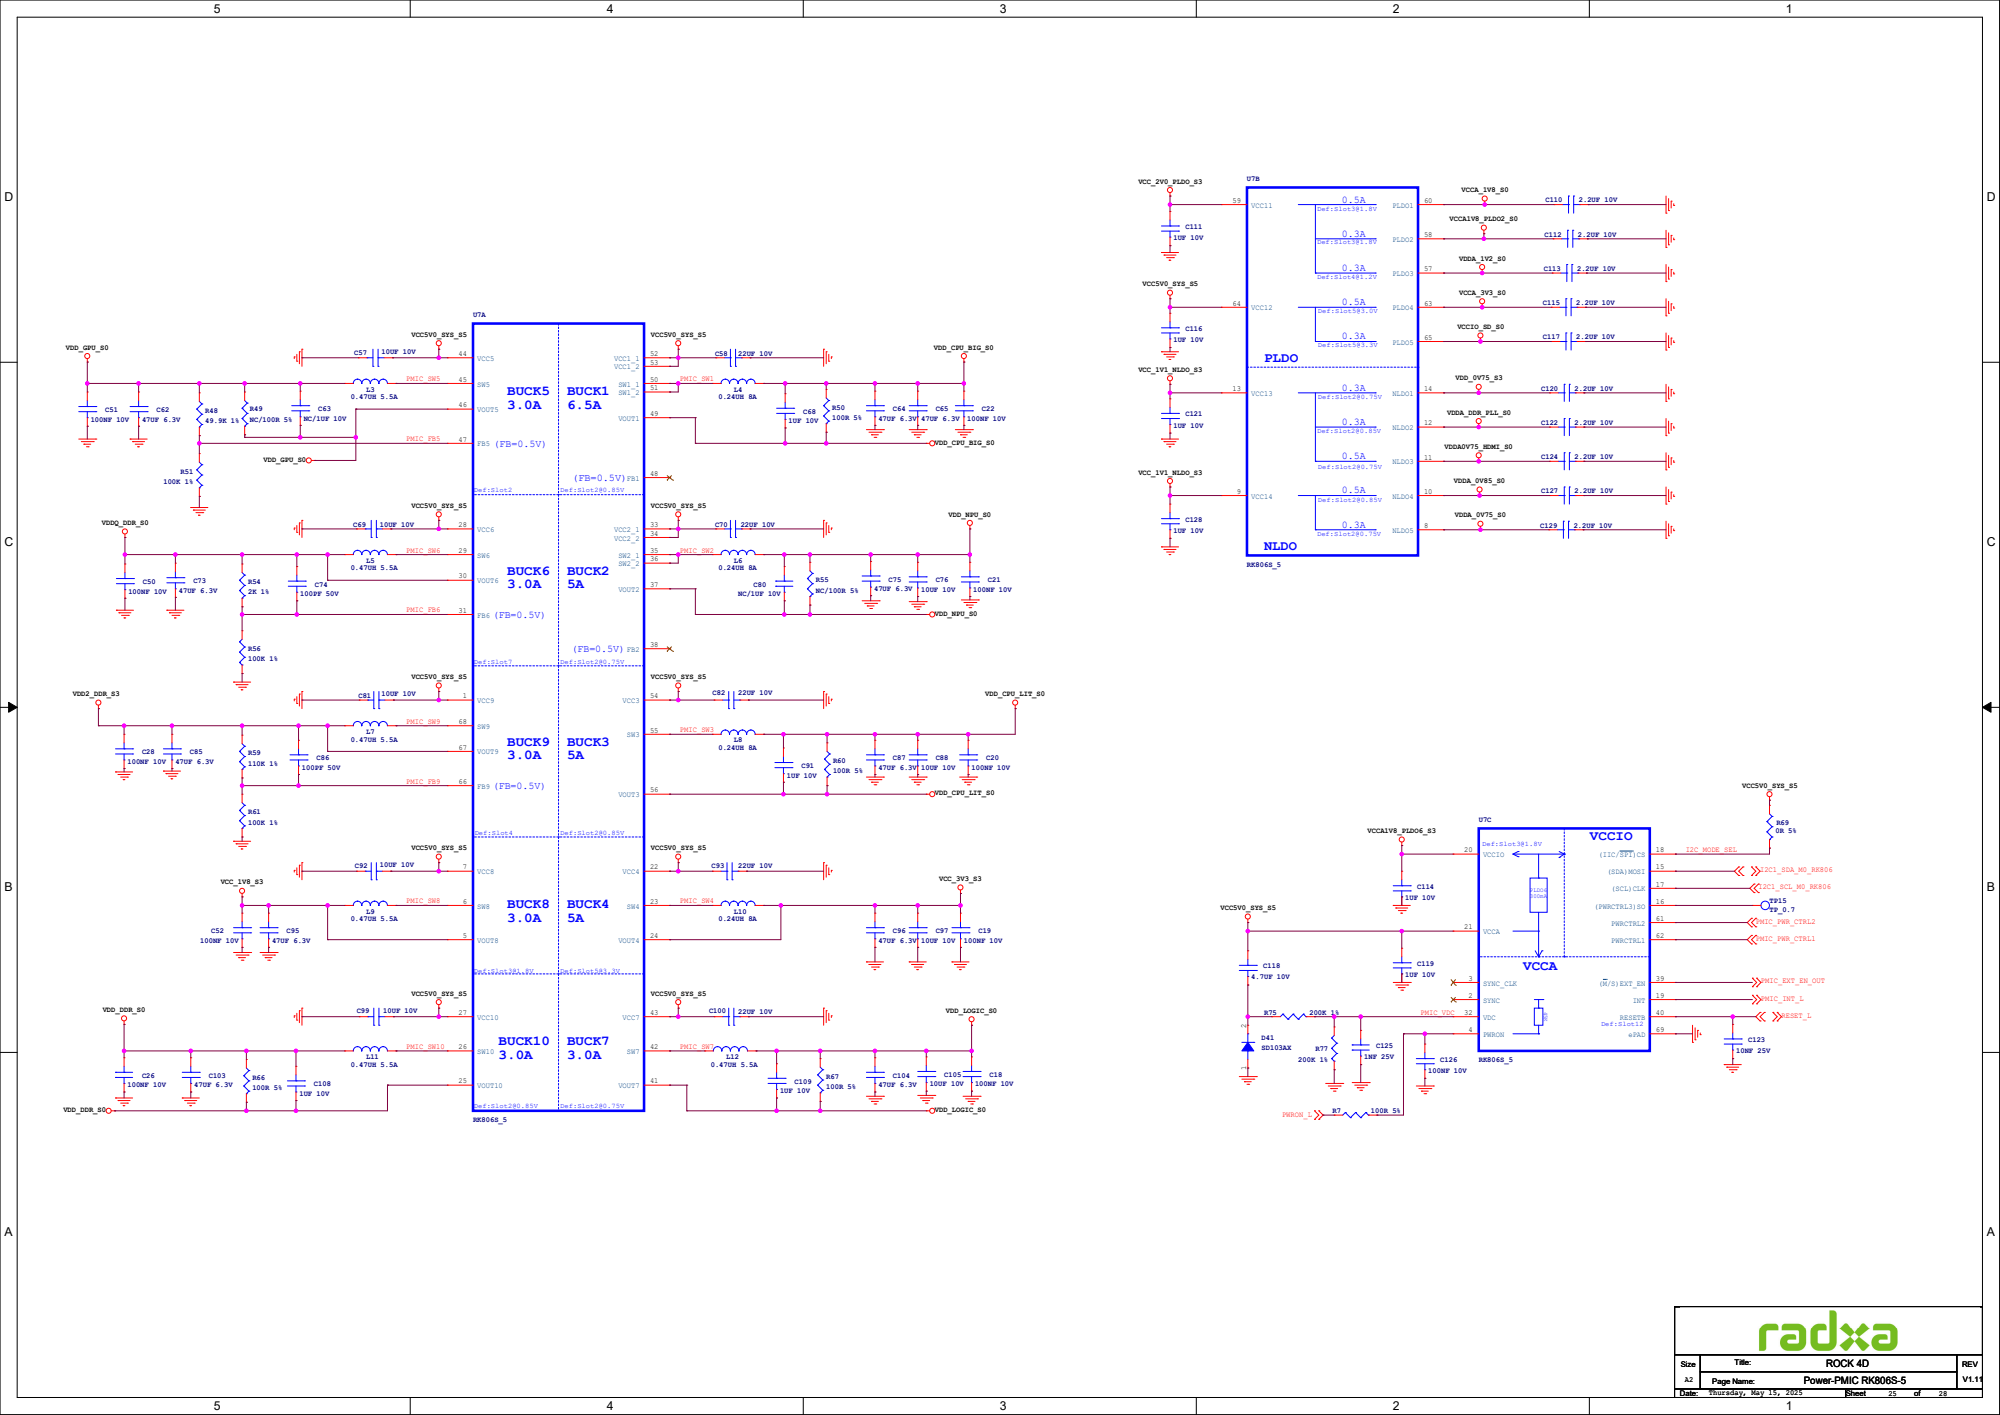
[picture p103: page 25]

VCC_3V3_S3 | VCC_3V3_S0

## VCC5V0_SYS_S5

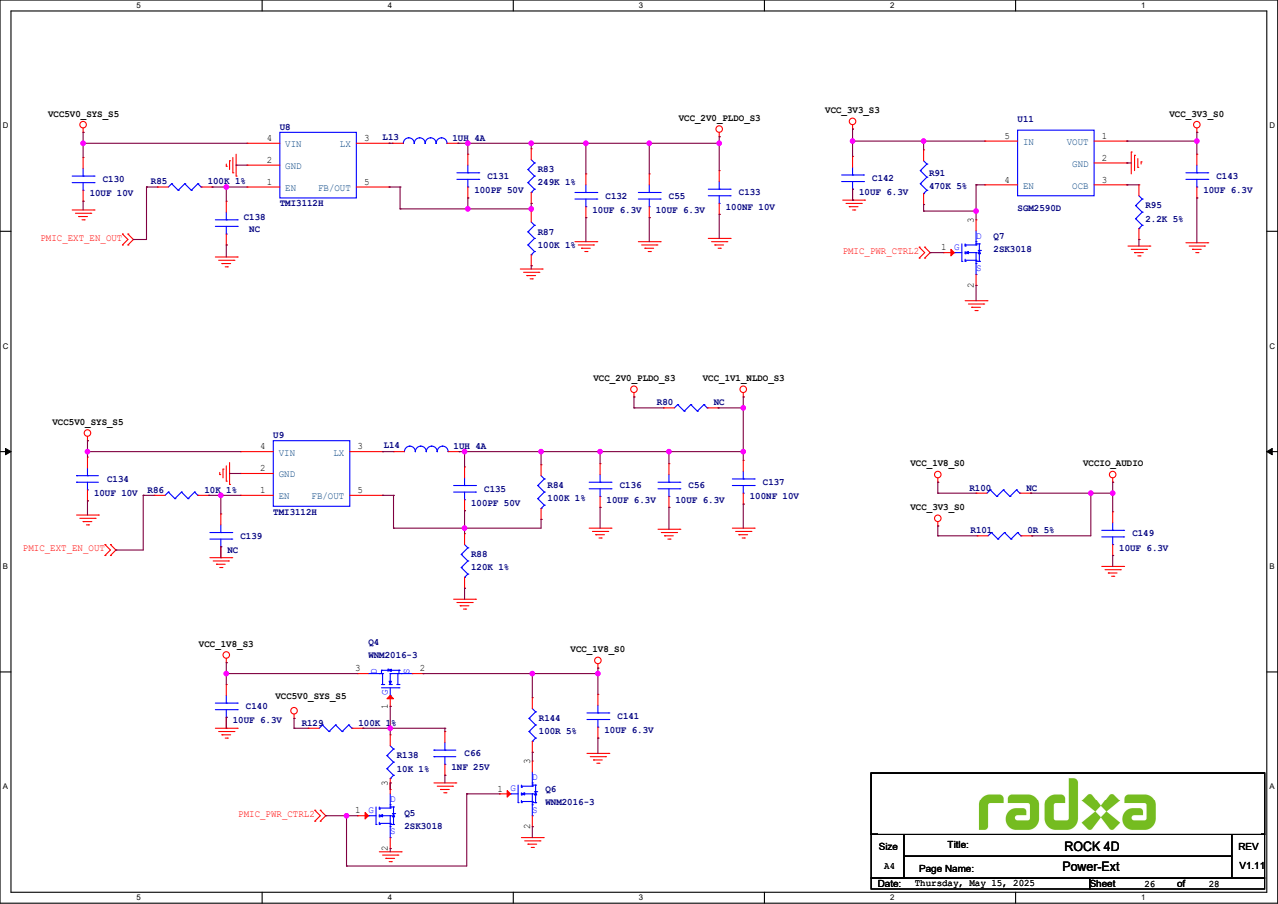
[picture p104: page 26]

GND | GND

## GND

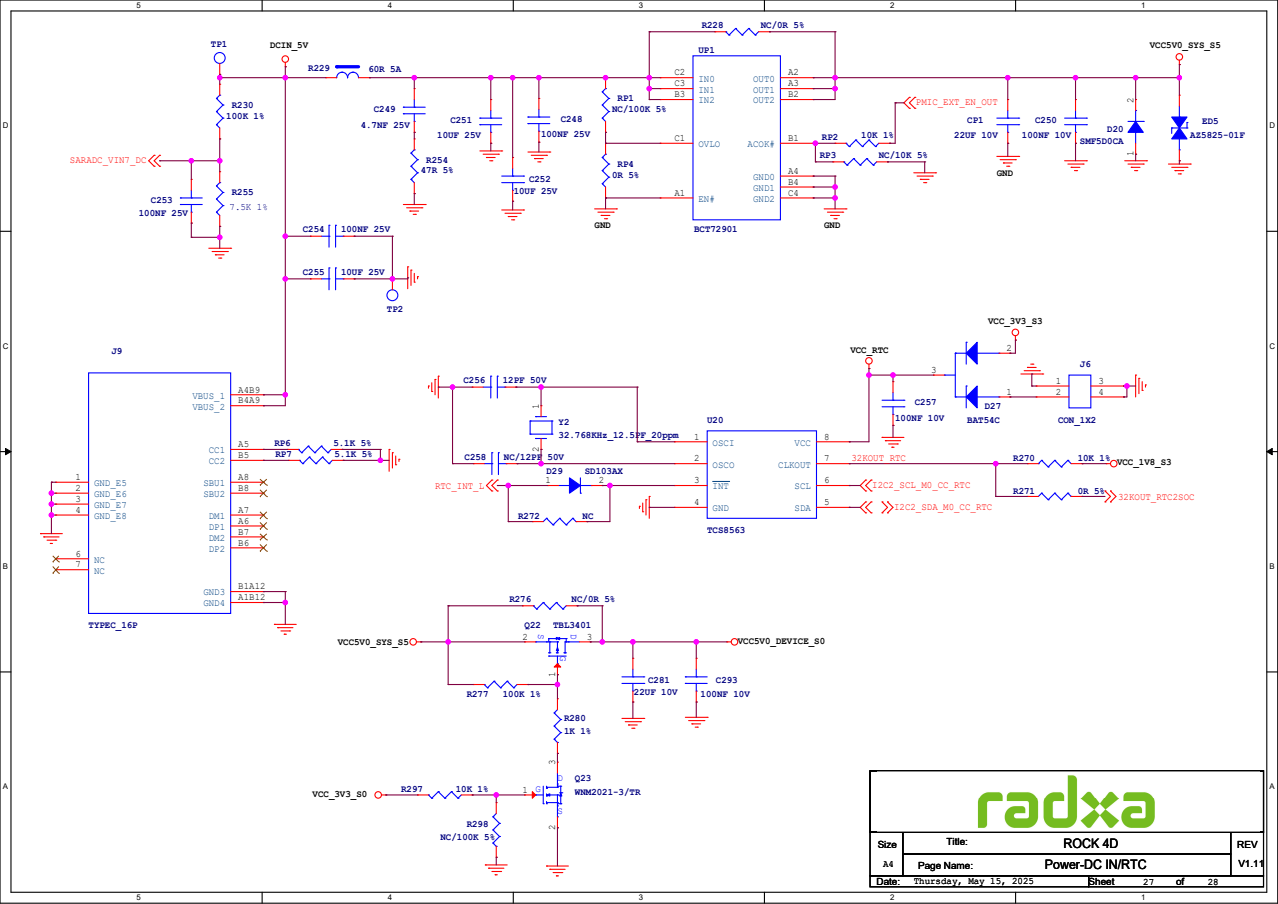
[picture p105: page 27]

VCC_3V3_S3 | VCC5V0_SYS_S5

## VCC_3V3_S3

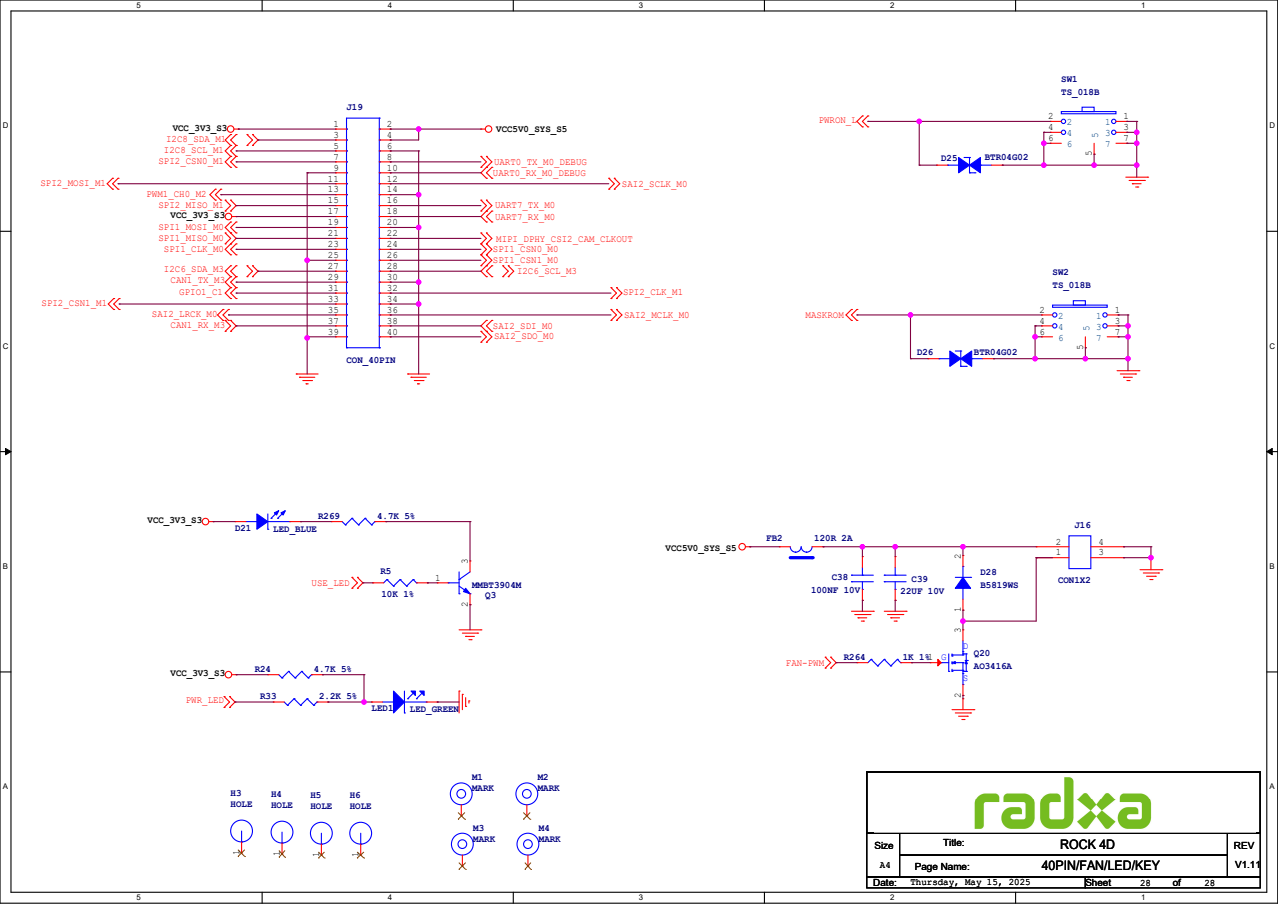
[picture p106: page 28]
