Rustik2044/MU-RK3576J-MB/For_production_MU-3576-MB/MU-RK3576J-MB_FULL/Assembly drawing_MU-RK3576J-MB_Full.pdf

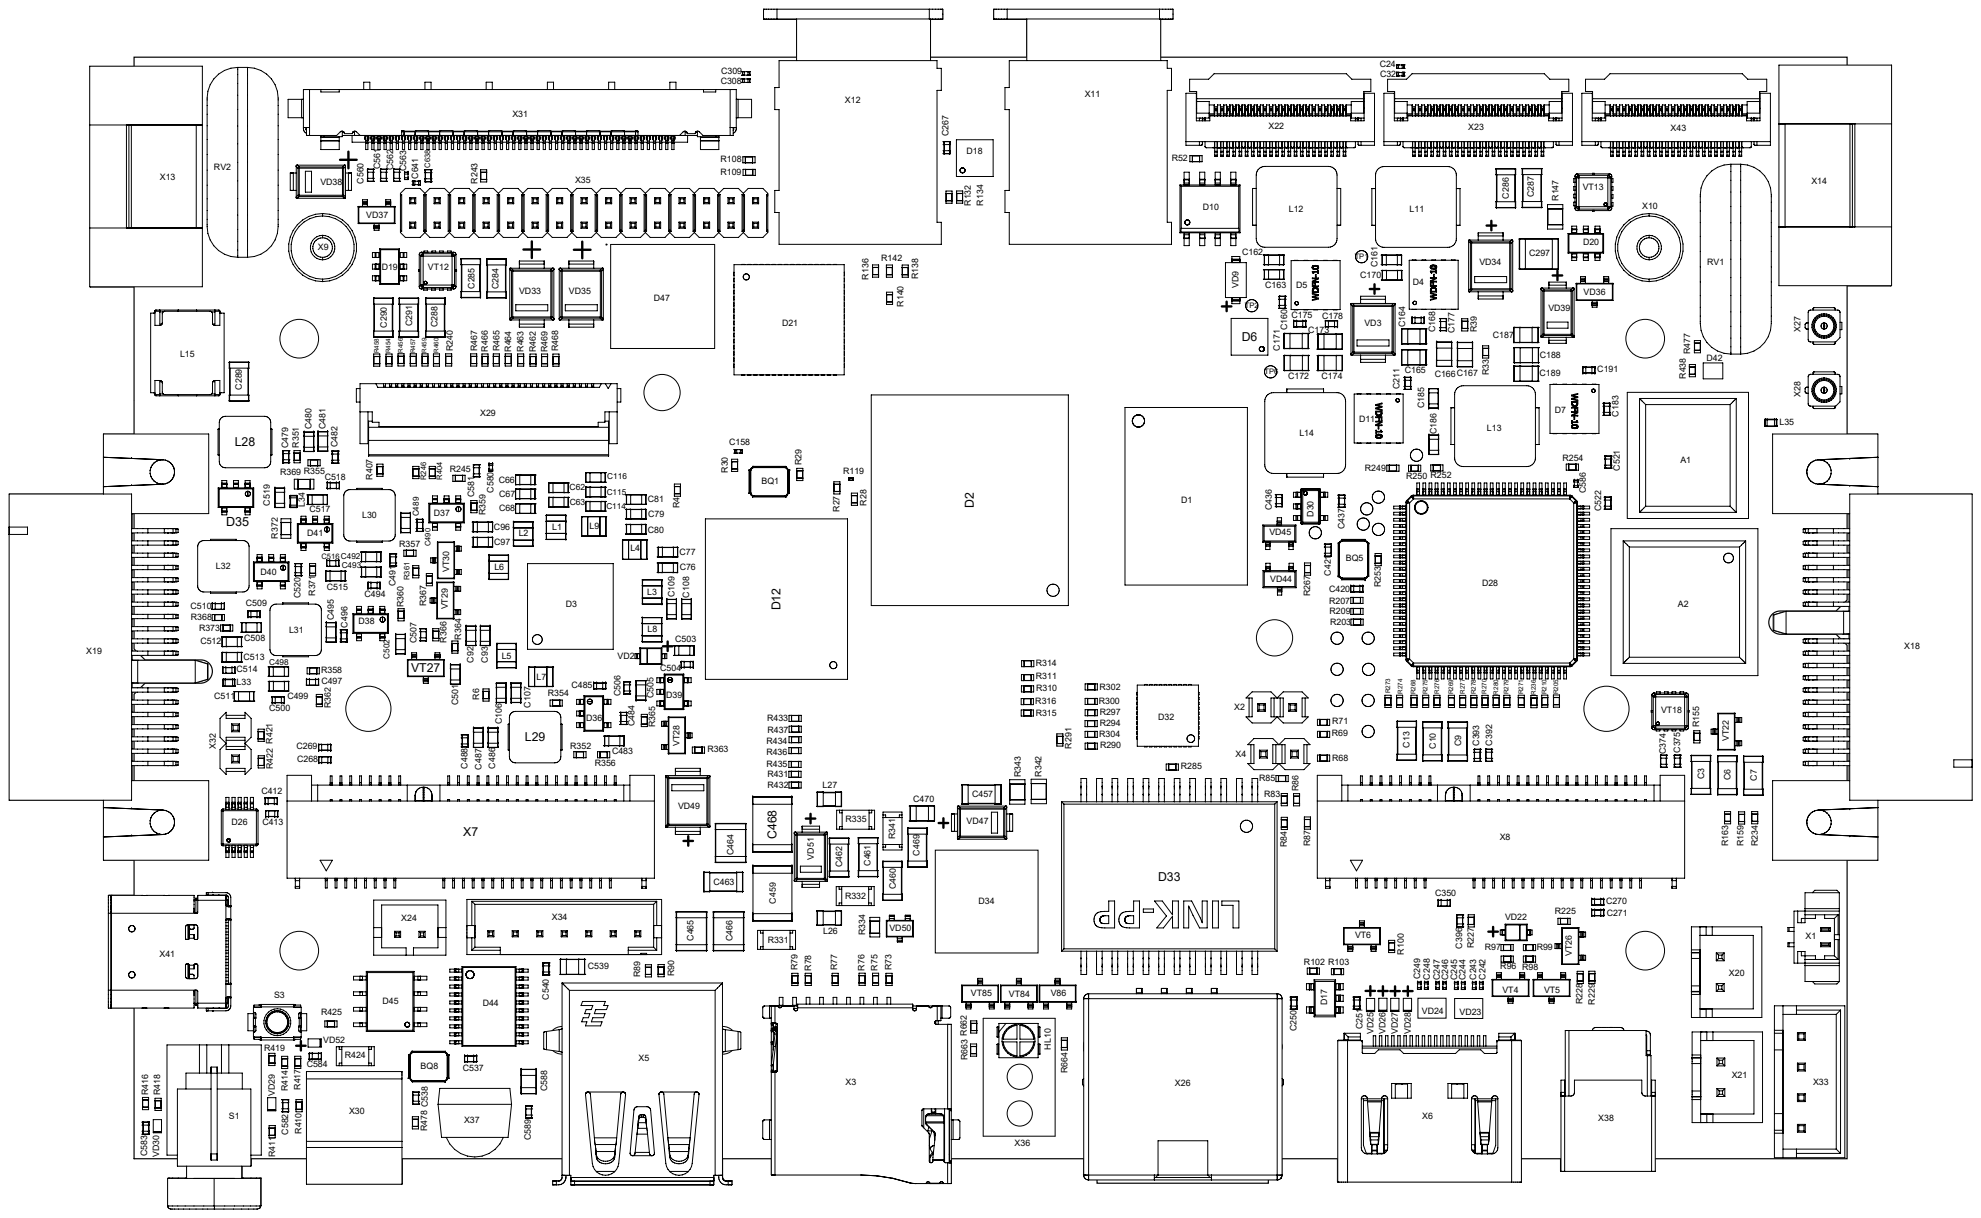
[picture p107: page 1]

VD7

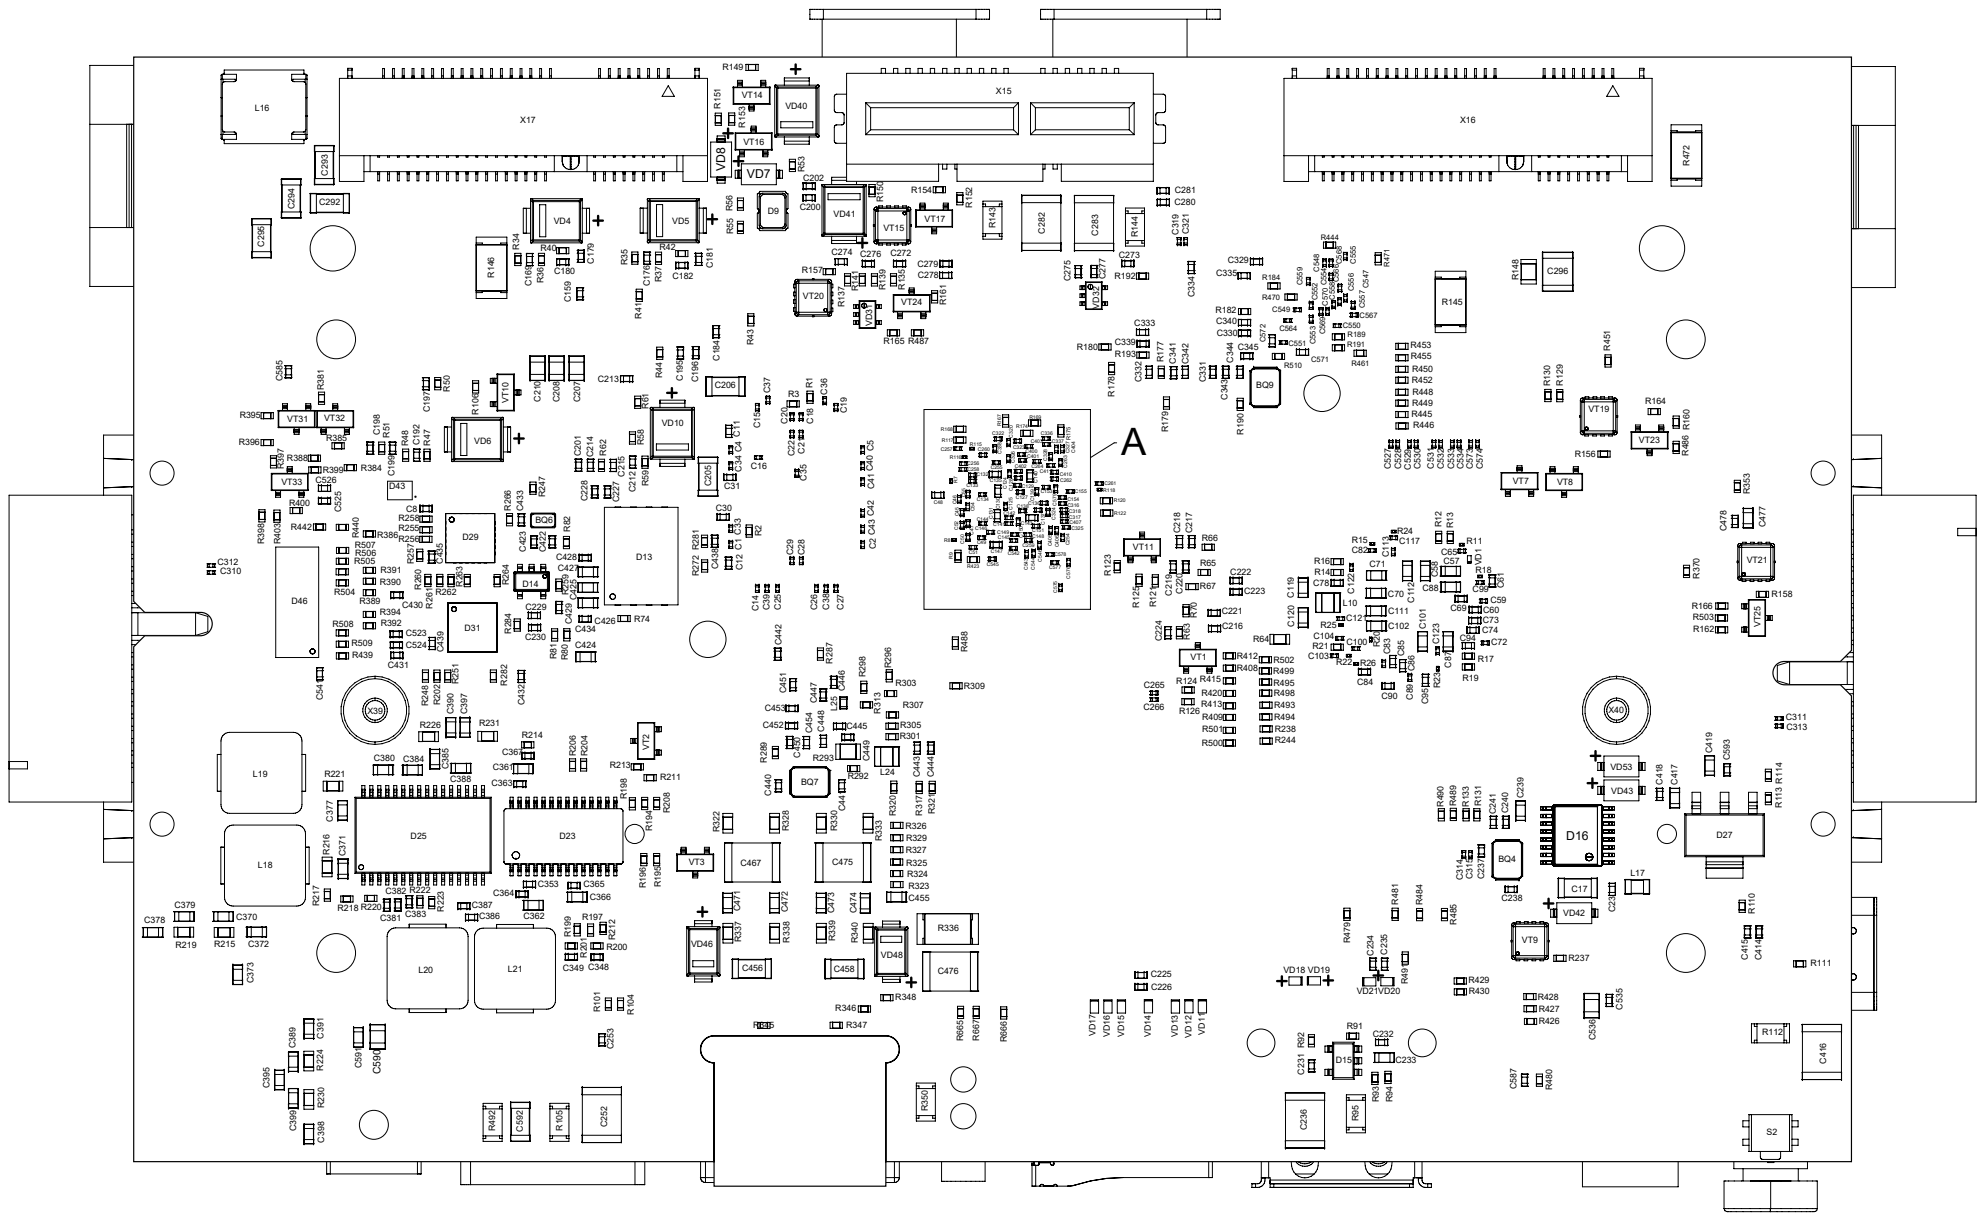
[picture p108: page 2]

R174

R169

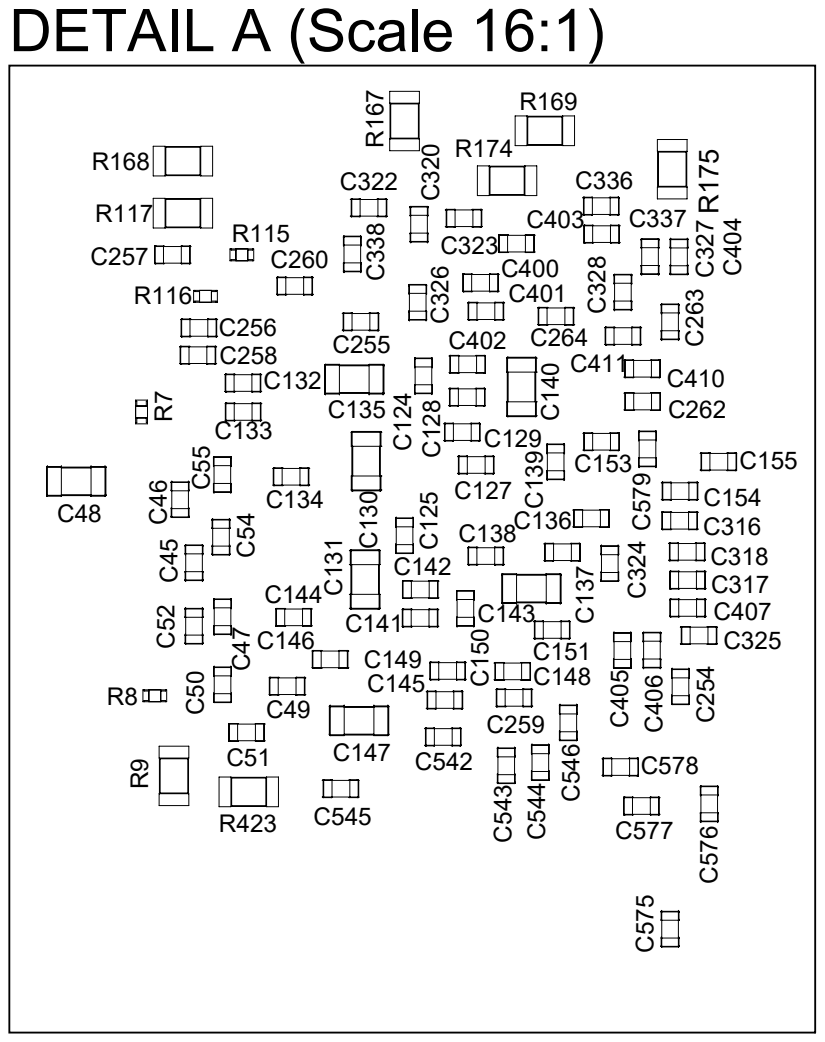
[picture p109: page 3]
