Rustik2044/MU-RK3576J-MB/For_production_MU-3576-MB/MU-RK3576J-MB_MEDIAPLAYER/Assembly drawing_MU-RK3576J-MB_MEDIAPLAYER.pdf

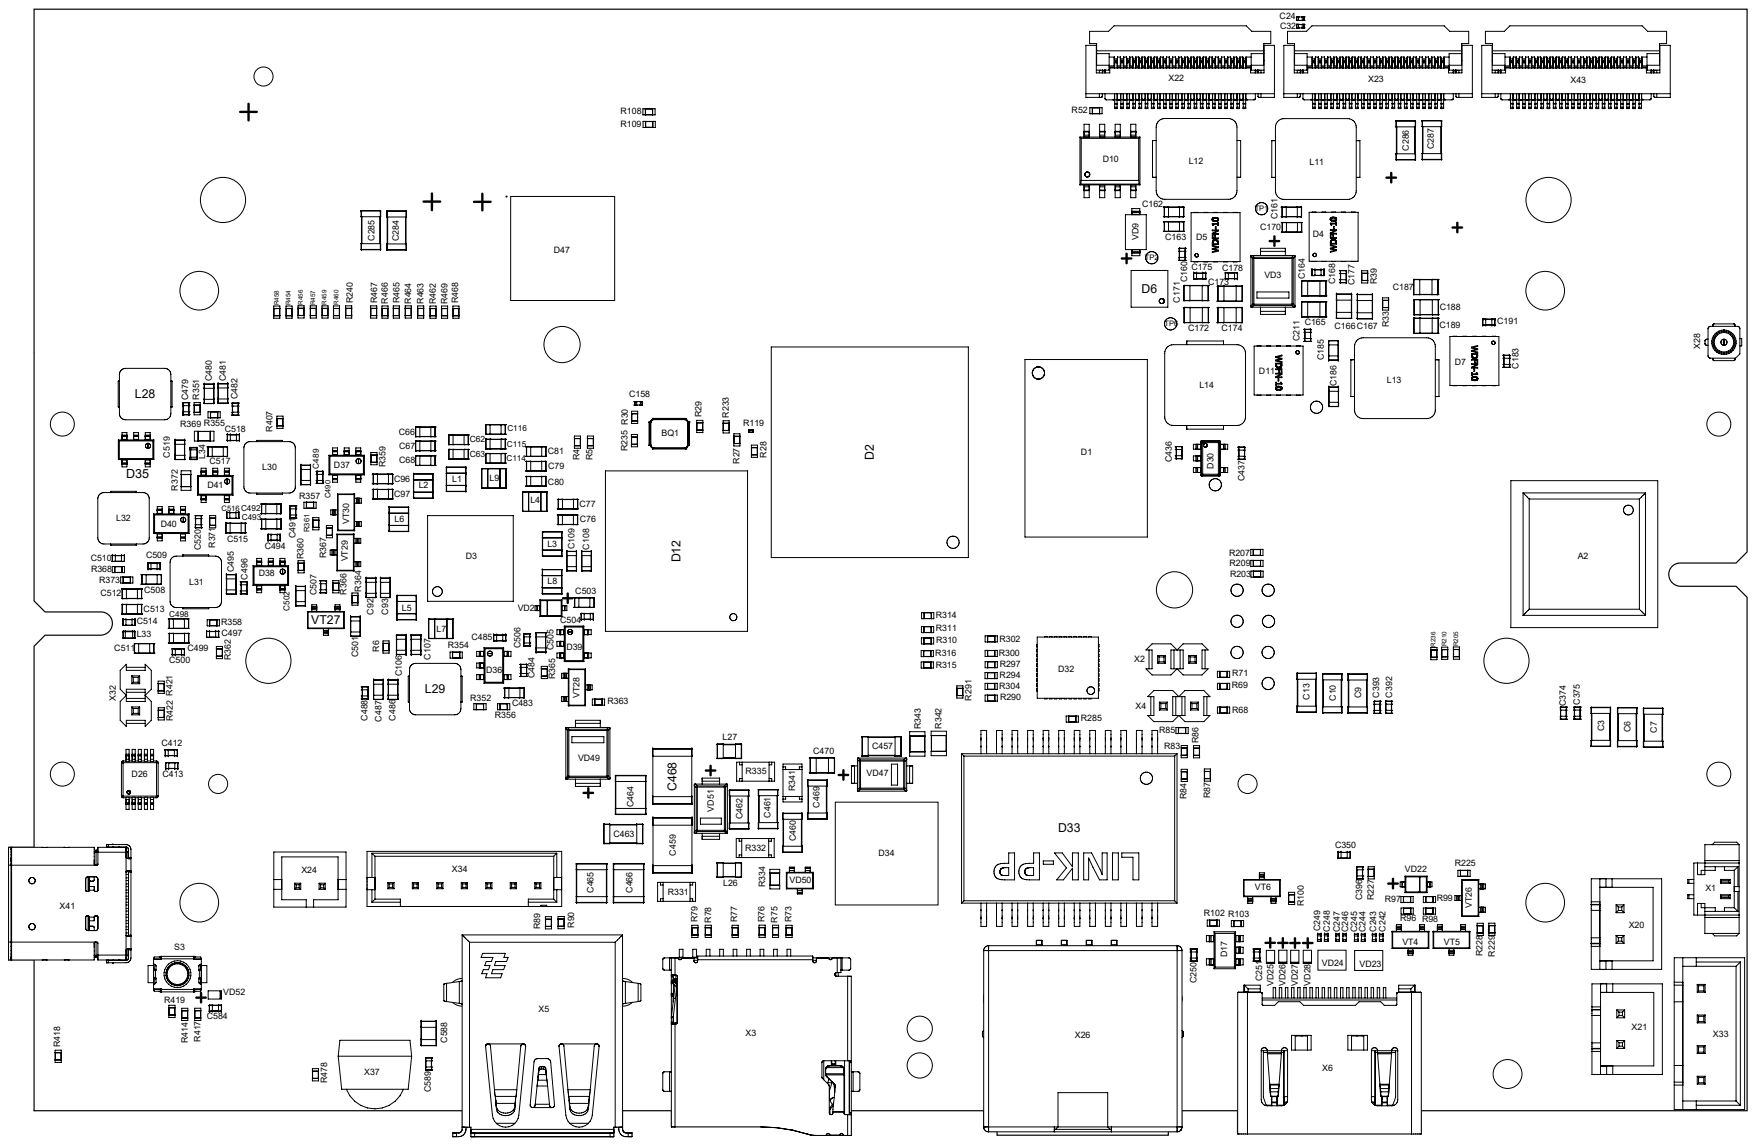
[picture p110: page 1]

VD7

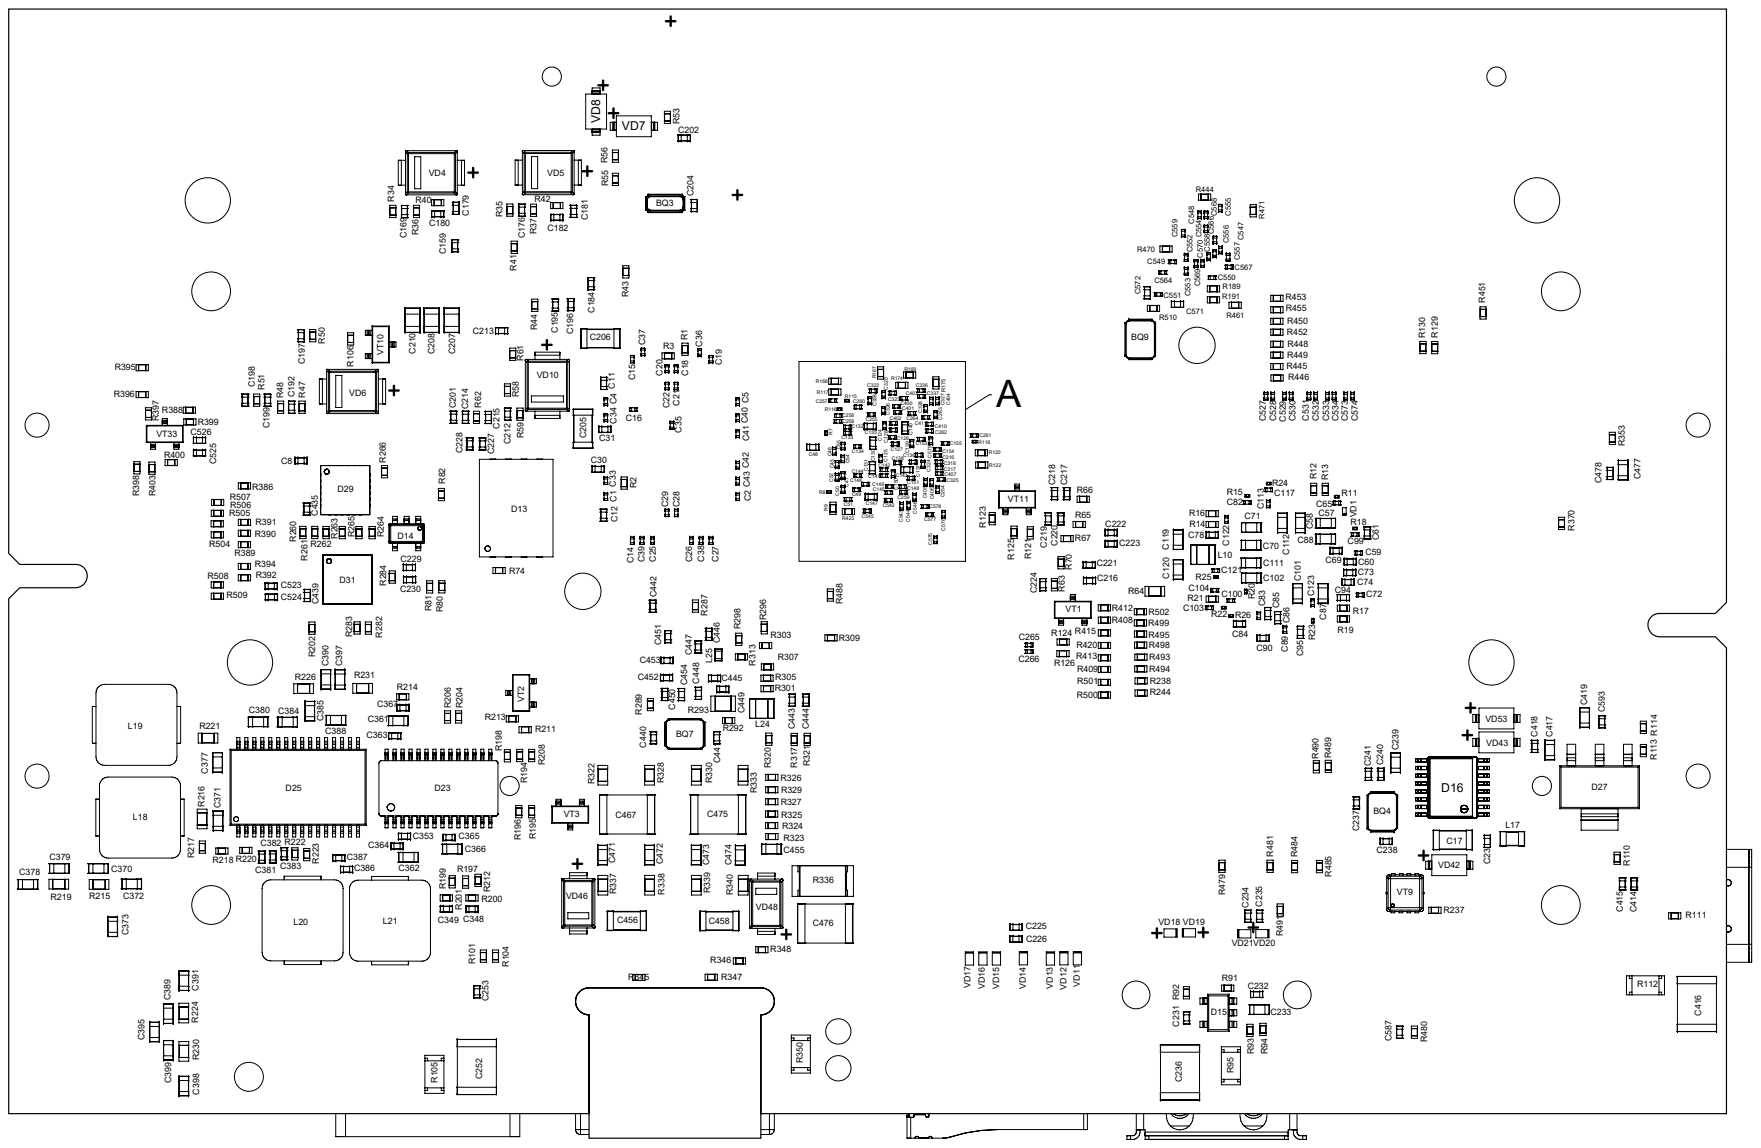
[picture p111: page 2]

R174

R169
