Rustik2044/MU-RK3576J-MB/Project/refdoc/03_Product Line Branch_AIoT/02_Key Device Specifications/HP_JACK_B2339J.pdf

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

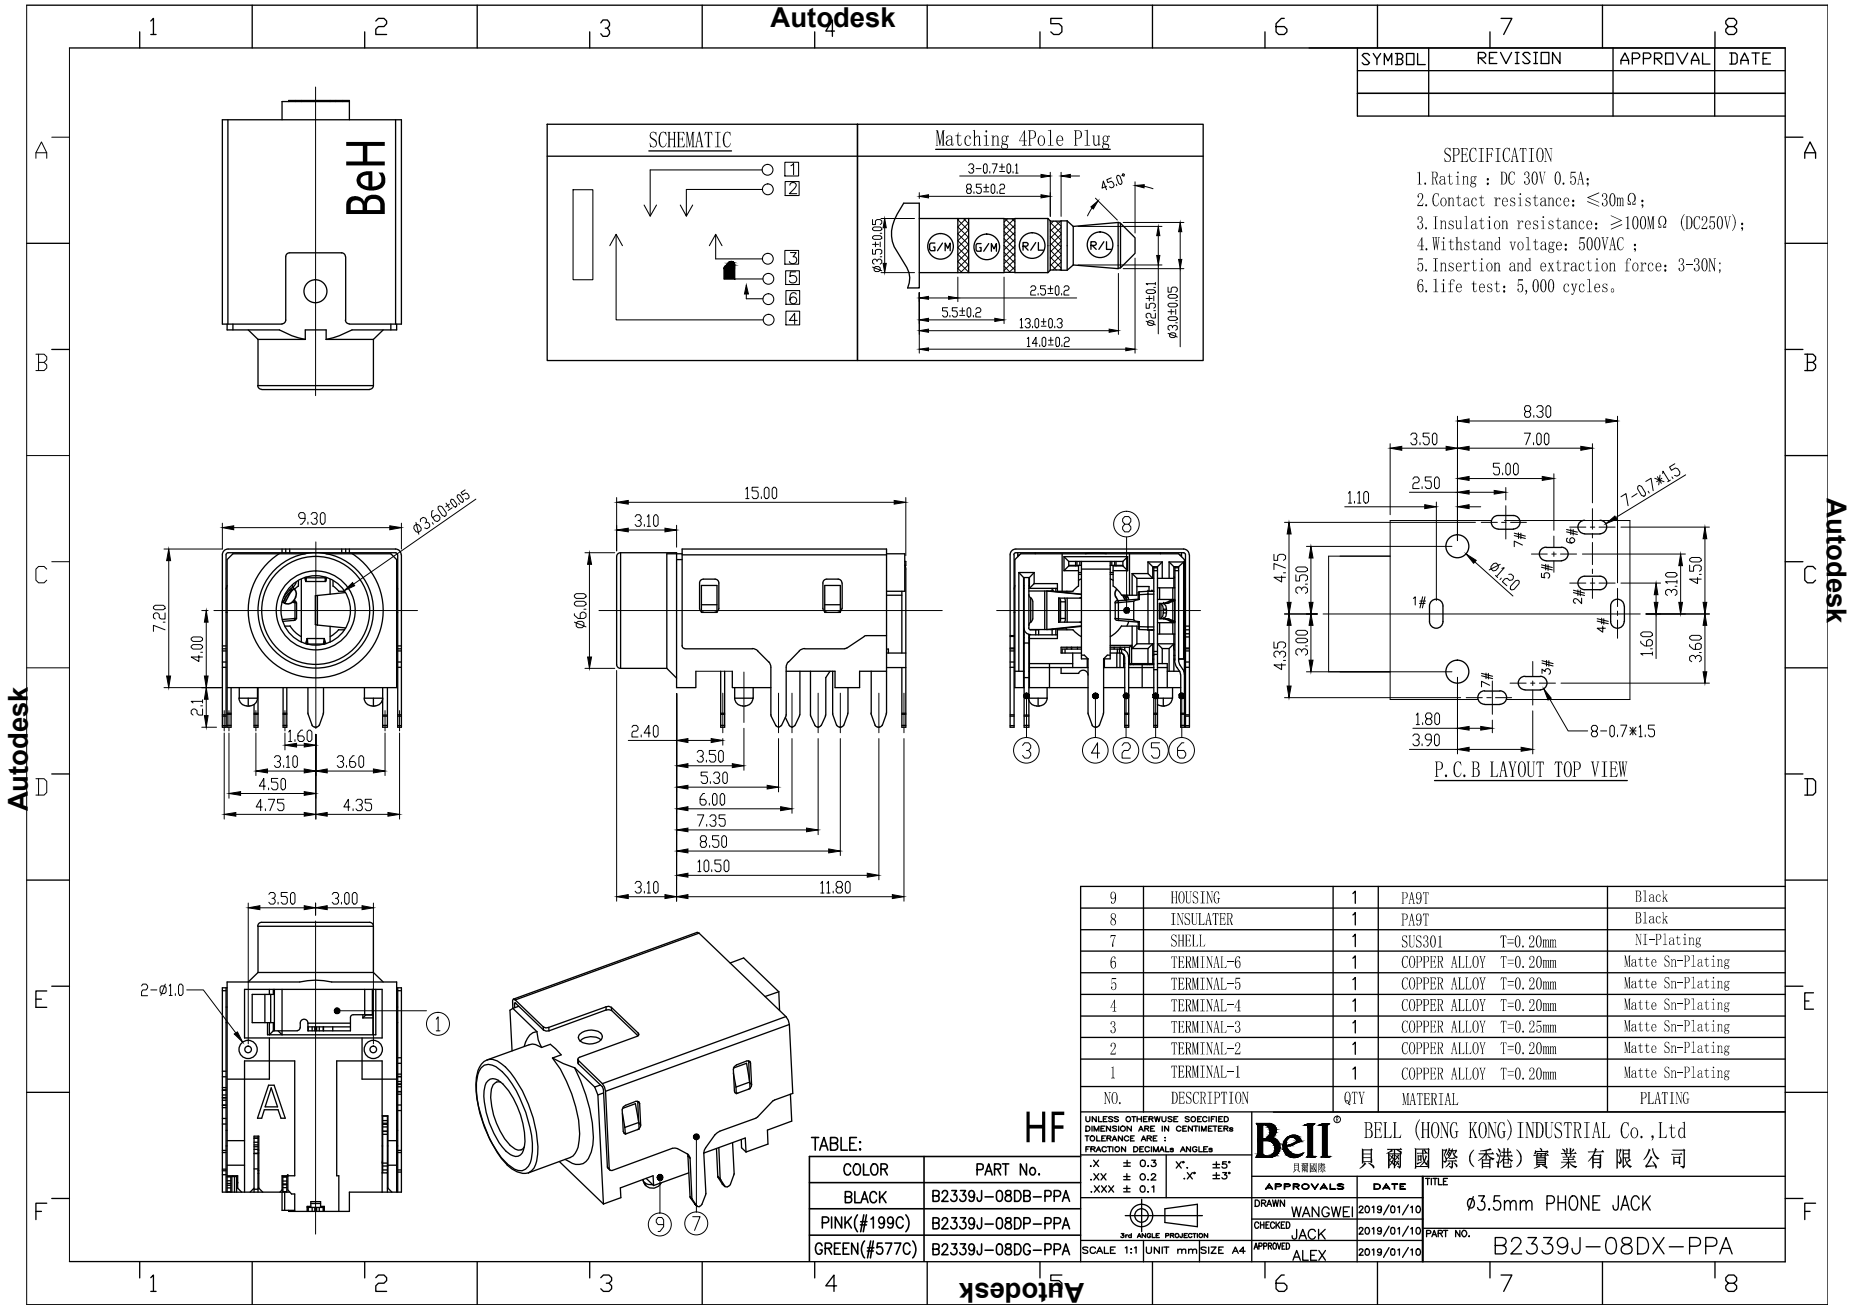
[picture p112: page 1]
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
