Rustik2044/MU-RK3576J-MB/(list of files, drawings)

Other design files:
Project/AUDIO.SchDoc
Project/BMC.SchDoc
Project/CAN-FD.SchDoc
Project/CPU.SchDoc
Project/CPU_ETH_RGMII1_SW.SchDoc
Project/CPU_GPIO.SchDoc
Project/CPU_LPDDR4.SchDoc
Project/CPU_MIPI_DSI_CSI.SchDoc
Project/CPU_PCIE_USB_HDMI_EXT_PCIEX2_mPCIeX2.SchDoc
Project/Ethernet.SchDoc
Project/EXTENSIONS.SchDoc
Project/Flash_eMMC_MicroSD.SchDoc
Project/HDMI.SchDoc
Project/IC_LPDDR4.SchDoc
Project/INT_mPCIeX2_SIM.SchDoc
Project/LVDS_eDP.SchDoc
Project/MEMORY.SchDoc
Project/MIPI_x2CSI.SchDoc
Project/MU-RK3576J-MB.PcbDoc
Project/MU-RK3576J-MB.PrjPCB
Project/Parent_sheet.SchDoc
Project/Peripheral.SchDoc
Project/POWER_SUPPLY.SchDoc
Project/PWR_CORE.SchDoc
Project/PWR_CPU.SchDoc
Project/PWR_DC_IN.SchDoc
Project/PWR_MAIN.SchDoc
Project/PWR_PMIC.SchDoc
Project/PWR_PoE_PD_1000BASE-T.SchDoc
Project/refdoc/03_Product Line Branch_AIoT/03_Reference Design/03_SCH_Library/RK3576_RK806S-5_V11.OLB
Project/refdoc/3399/01 INPUT_PWR.SchDoc
Project/refdoc/3399/02 INPUT_PWR_2.SchDoc
Project/refdoc/3399/03 RK808.SchDoc
Project/refdoc/3399/04 POWER.SchDoc
Project/refdoc/3399/05 CPU_PWR.SchDoc
Project/refdoc/3399/06 CPU_RAM.SchDoc
Project/refdoc/3399/07 RAM_PWR.SchDoc
Project/refdoc/3399/08 RAM.SchDoc
Project/refdoc/3399/09 EMMC.SchDoc
Project/refdoc/3399/10 SDMMC.SchDoc
Project/refdoc/3399/11 USB_2.SchDoc
Project/refdoc/3399/12 USB_3.SchDoc
Project/refdoc/3399/13 CPU_1.SchDoc
Project/refdoc/3399/14 CPU_2.SchDoc
Project/refdoc/3399/15 ETHERNET.SchDoc
Project/refdoc/3399/16 HDMI.SchDoc
Project/refdoc/3399/17 EDP.SchDoc
Project/refdoc/3399/18 I2S.SchDoc
Project/refdoc/3399/19 RADIATOR.SchDoc
Project/refdoc/3399/20 WiFi_BT.SchDoc
Project/refdoc/3399/21 CAN.SchDoc
Project/refdoc/3399/22 PCIE.SchDoc
Project/refdoc/3399/23 Unused.SchDoc
Project/refdoc/3399/MU_MP_39_V1.PrjPcb
Project/refdoc/3399/MU_MP_39_V11/MU_MP_39_V1.SCHLIB
Project/refdoc/V-by-One.pcbdoc
Project/RGMII0_ETH_PHY.SchDoc
Project/USB.SchDoc
Project/V-by-One.SchDoc
Project/VIDEO.SchDoc
Project/WIRELESS.SchDoc
Модули расширения/MU-2xHDMIIN-1xHDMIOUT/MU-VIDEO-HDMI.PcbDoc
Модули расширения/MU-2xHDMIIN-1xHDMIOUT/MU-VIDEO-HDMI.PrjPcb
Модули расширения/PCB.PcbDoc
Модули расширения/PCB_Project.PrjPcb
Модули расширения/Sheet1.SchDoc
