Rustik2044/MU-RK3576J-MB/(commit log)

2026-01-19 added new project
    [8xDIO_ISO.SchDoc, AUDIO.SchDoc, BMC.SchDoc, BomTemplate.xlsx, CAN-FD.SchDoc, CPU.SchDoc, CPU_GPIO.SchDoc, CPU_LPDDR4.SchDoc]
2026-01-19 added PWR_PMIC
    [PWR_CORE.SchDoc, PWR_DC_IN.SchDoc, PWR_MAIN.SchDoc, PWR_PMIC.SchDoc, RK3576J-MB.PrjPCB]
2026-01-22 added PoE
    [01 INPUT_PWR.SchDoc, 02 INPUT_PWR_2.SchDoc, 03 RK808.SchDoc, 04 POWER.SchDoc, 05 CPU_PWR.SchDoc, 06 CPU_RAM.SchDoc, 07 RAM_PWR.SchDoc, 08 RAM.SchDoc]
2026-01-23 update PoE
    [MU-RK3588S-SoM.PrjPCB, PWR_PoE_PD_1000BASE-T.SchDoc]
2026-01-25 Added pwr cpu
    [CPU_LPDDR4.SchDoc, Flash_eMMC_MicroSD.SchDoc, IC_LPDDR4.SchDoc, MU-RK3576J-MB.PrjPCB, PWR_CORE.SchDoc, PWR_CPU.SchDoc, PWR_MAIN.SchDoc, PWR_PMIC.SchDoc]
2026-01-26 update ETH-PHY
    [Flash_eMMC_MicroSD.SchDoc, HDMI.SchDoc, MU-RK3576J-MB.PrjPCB, PWR_DC_IN.SchDoc, RGMII0_ETH_PHY.SchDoc, V-by-One.pcbdoc]
2026-03-31 UPDATE ALL
    [AUDIO.SchDoc, BMC.SchDoc, CPU.SchDoc, CPU_ETH_RGMII1_SW.SchDoc, CPU_GPIO.SchDoc, CPU_PCIE_USB_HDMI_EXT_PCIEX2_mPCIeX2.SchDoc, EXTENSIONS.SchDoc, Ethernet.SchDoc]
2026-04-18 ADDED RULES
    [AUDIO.SchDoc, BMC.SchDoc, CPU.SchDoc, CPU_ETH_RGMII1_SW.SchDoc, CPU_MIPI_DSI_CSI.SchDoc, CPU_PCIE_USB_HDMI_EXT_PCIEX2_mPCIeX2.SchDoc, EXTENSIONS.SchDoc, Ethernet.SchDoc]
2026-04-19 update brd
    [CPU_ETH_RGMII1_SW.SchDoc, CPU_GPIO.SchDoc, CPU_LPDDR4.SchDoc, CPU_MIPI_DSI_CSI.SchDoc, PWR_CPU.SchDoc]
2026-05-02 update pcb
    [CPU_LPDDR4.SchDoc, CPU_MIPI_DSI_CSI.SchDoc, IC_LPDDR4.SchDoc, MU-RK3576J-MB.PrjPCB, PWR_MAIN.SchDoc, PWR_PMIC.SchDoc]
2026-06-15 ADDED SILK
    [CPU.SchDoc, CPU_ETH_RGMII1_SW.SchDoc, CPU_GPIO.SchDoc, CPU_PCIE_USB_HDMI_EXT_PCIEX2_mPCIeX2.SchDoc, Ethernet.SchDoc, PWR_DC_IN.SchDoc, Parent_sheet.SchDoc, USB.SchDoc]
